JuliusJanusonis/MB/Patalpos/Spectrum_Montage1_940x347_adj.jpg

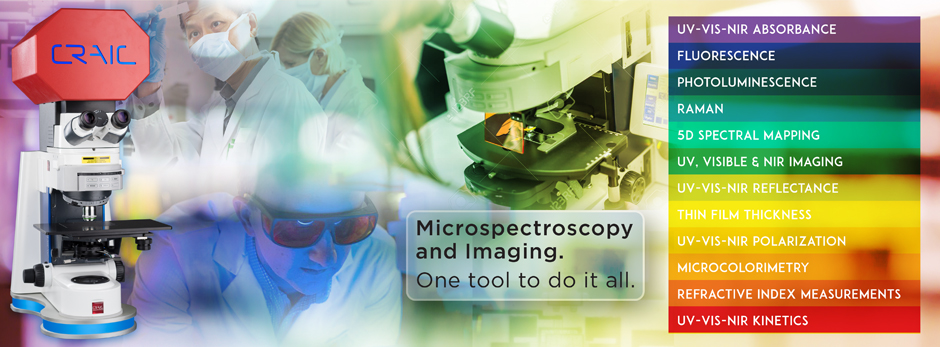
Patalpos/Spectrum_Montage1_940x347_adj.jpg
