JuliusJanusonis/MB/Inostartas/nuotraukos prezentacijai/20230321_184713.jpg

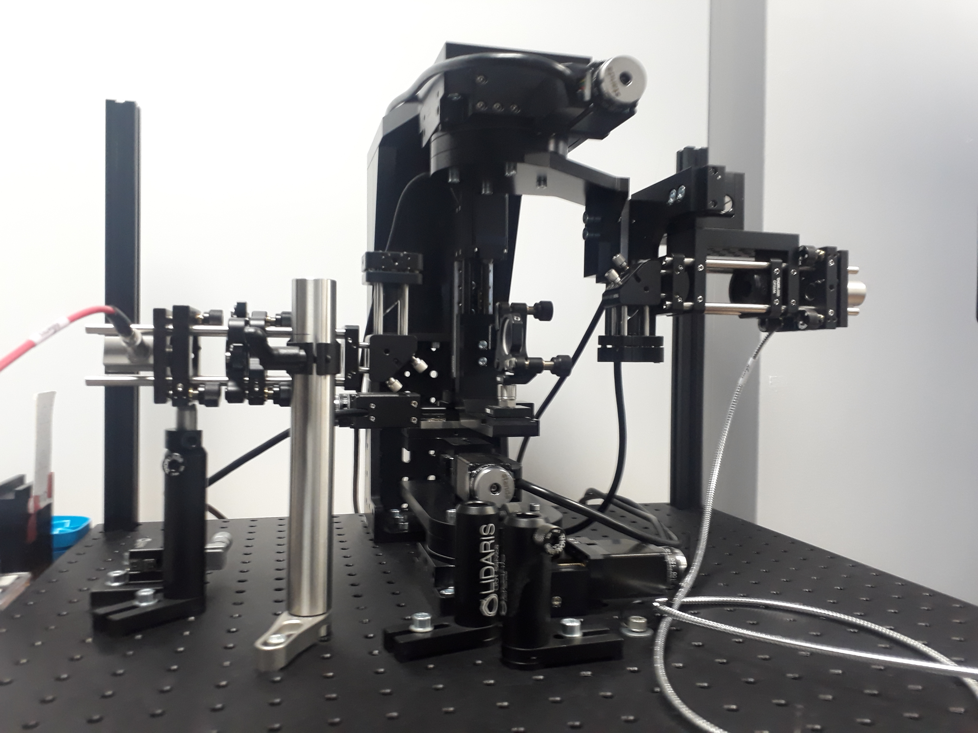
Inostartas/nuotraukos prezentacijai/20230321_184713.jpg
