JuliusJanusonis/MB/Inostartas/Biudzetas/Pagrindžiantys dokumentai/Standa Komercinis Pasiūlymas Nr. PST-20230330-02GM.pdf

UAB "Standa"
Kalvarijų g. 125-2, 08221 Vilnius, Lietuva Įm.kodas 120372824
PVM kodas LT203728219

KOMERCINIS PASIŪLYMAS

1406680
Nr. PST-20230330-02GM | 2023 03 30
Pagal Email inquiry 2023-03-29
Kontaktinis asmuo: GIEDRIUS MIKULIS kom14@standa.lt

psl. 1 / 1
UAB STANDA
Laiškams :
P.d. 2684
9-asis paštas
LT-03001 Vilnius

Kalvarijų g. 125-2
08221 Vilnius
Lithuania

Tel.: +370-5-2651474
Fax: +370-5-2651483

sales@standa.LT
http://www.standa.LT

Įmonės kodas: 120 372 82 4
PVM kodas: LT 203 728 219
Registras: Lietuvos Respublikos juridinių asmenų registras Bankas: AB SEB Bankas, Konstitucijos pr. 24, LT-08105 Vilnius Sąskaitos nr. ( IBAN ): LT46 7044 0600 0137 8028

Printed from DAGOS ERP

GAVĖJAS

EVEROPTICS MB
Vokiečių g. 85
Kaunas, LT-45261
Lietuva
PVM kodas:

PRISTATYMO ADRESAS

EVEROPTICS MB
Vokiečių g. 85
Kaunas, LT-45261
Lietuva
P. Julius Janušonis j.j.janusonis@gmail.com +37063817746
PREKIŲ / PASLAUGŲ PAVADINIMAS , KATALOGINIS KODAS | Kiekis | Vieneto kaina
| | be PVM, EUR

Nuol.
%
| | | Suma, EUR
1 . Motorizuotas transliatorius 8MT30-50 | 3vnt. | 699,00 | 2097,00
2 . Motorizuotas transliatorius 8MT173-30 | 2vnt. | 549,00 | 1098,00
3 . Motorizuotas posūkio staliukas 8MR190-2-28 | 2vnt. | 1.647,00 | 3294,00
4 . KAMPAS 2AB173-20-50 | 1vnt. | 54,00 | 54,00

5 . Aštuonių ašių kontrolerio blokas 8SMC5-M-ETH/RS232-B19x3-8
8 motorizuotų ašių valdymui | 1vnt. | 6.764,00 | 6764,00
6 . Pristatymo kaina DAP (30) Transp. DAP (30) UPS Economy | 1vnt. | 40,00 | 40,00

SUMA BE PVM
PVM, 21,00%
SUMA SU PVM
| | | 13.347,00 EUR
| | | 2.802,87 EUR
| | | 16.149,87 EUR
Mokėjimo sąlygos: | 100% in advance by Bank Transfer. Bank charges outside Lithuania at customer`s account.
Paruošimo laikas: | 5-7 sav.
Pasiūlymo galiojimas: | 30 days
Kilmės šalis: | LIETUVA
Pasiūlymą parengė: Vadybininkas GIEDRIUS MIKULIS , kom14@standa.lt
