JuliusJanusonis/MB/Inostartas/Biudzetas/Biudzetas_everoptics.xlsx

Kategorija | Nuoroda | Abibūdinimas | Kiekis | Vieneto kaina | Kaina | Kaina be PVM | Kaina su PVM |  |  | Mokslas | EP
Standa |  |  |  |  |  |  |  |  | Turinys | 0.8 | 0.2
Motorizuotas transliatorius 8MT30-50 |  |  | 3 | 699 | 2097 | 1733.057851 | 2097 |  | Intensyvumas | 0.8 | 0.6
Motorizuotas transliatorius 8MT173-30 |  |  | 2 | 549 | 1098 | 907.4380165 | 1098
Motorizuotas posūkio staliukas 8MR190-2-28 |  |  | 2 | 1647 | 3294 | 2722.31405 | 3294 |  | Efektinis intensyvumas | 0.76
KAMPAS 2AB173-20-50 |  |  | 1 | 54 | 54 | 44.62809917 | 54
Pristatymo kaina DAP (30) Transp. DAP (30) |  |  | 1 | 40 | 40 | 33.05785124 | 40
 |  |  |  |  | 0 | 0 | 0
DDS050/M | https://www.thorlabs.com/newgrouppage9.cfm?objectgroup_id=8535 | 50 mm Linear Translation Stage, DC Direct-Drive Servo Motor | 1 | 2082.63 | 2082.63 | 2082.63 | 2519.9823 | Viso be PVM | Viso
KBD101 | https://www.thorlabs.com/newgrouppage9.cfm?objectgroup_id=8535 | K-Cube™ Brushless DC Servo Driver | 1 | 804.71 | 804.71 | 804.71 | 973.6991 | 8327.835868 | 10076.6814
Aštuonių ašių kontrolerio blokas 8SMC5-M-ETH/RS232-B19x3-8 |  |  | 1 | 6764 | 6764 | 5590.082645 | 6764 | 5590.082645 | 6764
Avantes |  |  |  |  | 0 | 0 | 0
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
