JuliusJanusonis/MB/Inostartas/Biudzetas/Pirmas biudzetas_everoptics.xlsx

Sheet: Projekto dokumentai
Projekto dokumentai | Failas
2.4.1
2.4.2
2.4.3
2.4.4. PFSA 4 priedą, kuriame pateikiama informacija, reikalinga projekto atitikčiai projektų atrankos kriterijams įvertinti | 2.4.4. PFSA 4 priedas
2.4.5. MTEP verslo planą, parengtą pagal Kvietime teikti PĮP pateiktus rekomenduojamus formos ir turinio reikalavimus.
2.4.6
2.4.7. Dokumentus, pagrindžiančius projekto biudžeto pagrįstumą (komerciniai pasiūlymai, nuorodos į rinkos esančias kainas ir kita (jei projekte numatytos patentavimo ir/ar projekto metu sukurto produkto parengimo rinkai veiklos, išlaidų pagrindimui turi būti pateikiama po tris lygiaverčius komercinius pasiūlymus)).
2.4.8
2.4.9
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
