JuliusJanusonis/MB/Buhalterija/Saskaitos fakturos/mb_everoptics.pvm_saskaita_faktura.pardp000001.docx

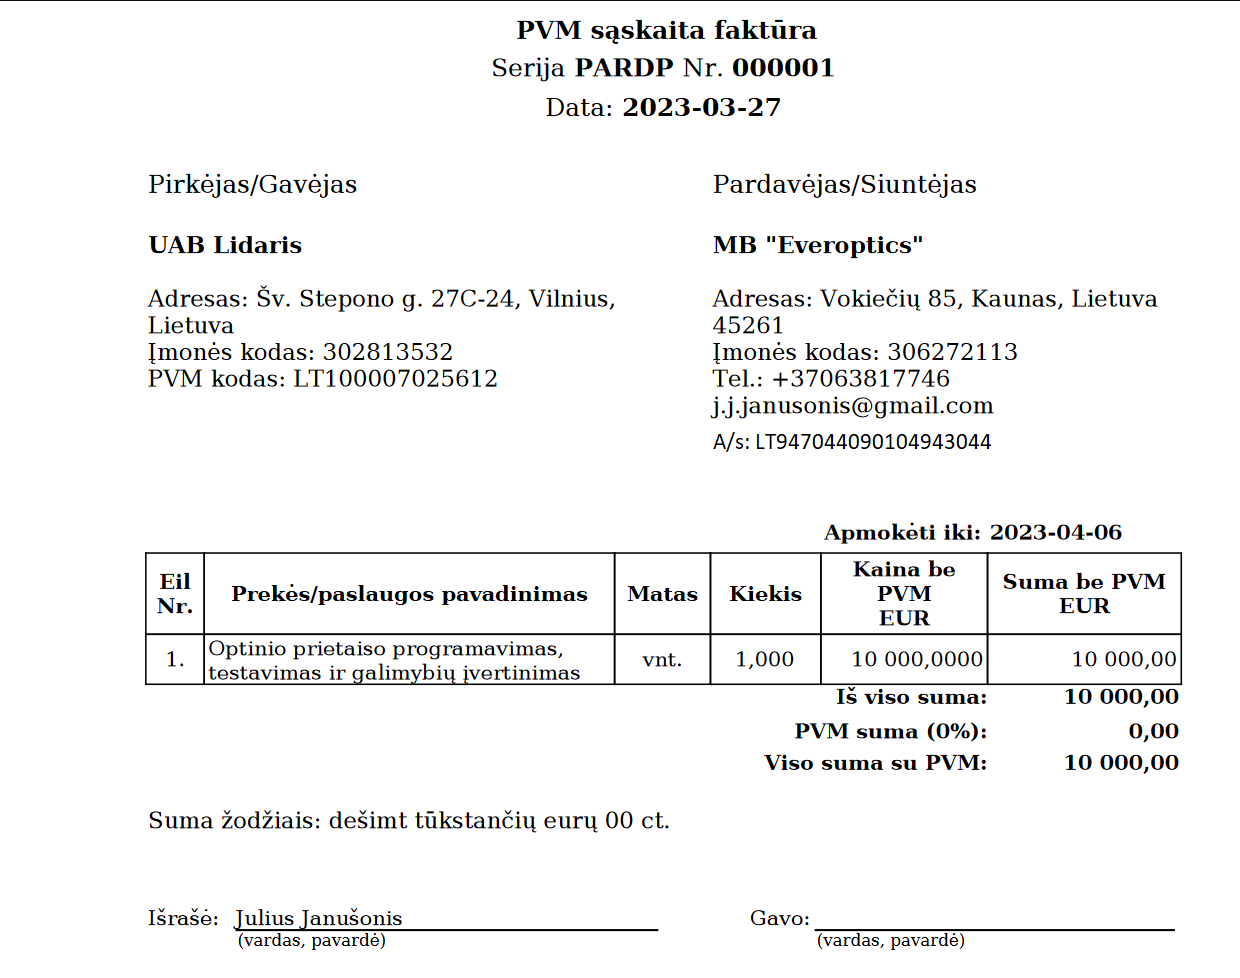
[picture p3: figure]
