JuliusJanusonis/MB/Inostartas/Dokumentai projekto padavimui/Atnaujinti seni failai/projekto igyvendinimo planas_everoptics.docx

Projektų administravimo ir finansavimo taisyklių

1 priedas

(Projekto įgyvendinimo plano forma)

arba

arba

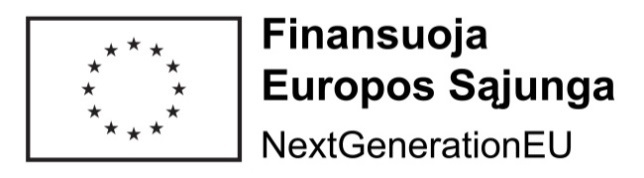
[picture p4: figure]
LT_00_Fichier de reproduction Next Generation EU_BLACK Outline

(Monochrominė Europos Sąjungos emblema ir šalia jos pasirinktas teiginys: „Finansuoja Europos Sąjunga“ (kai pavienis ar jungtinis projektas (toliau – projektas) 100 procentų finansuojamas 2021–2027 metų Europos Sąjungos fondų lėšomis) arba „Bendrai finansuoja Europos Sąjunga“ (kai projektas ne 100 procentų finansuojamas 2021–2027 metų Europos Sąjungos fondų lėšomis), arba „Finansuoja Europos Sąjunga NextGenerationEU“ (kai projektas finansuojamas 2021–2027 metų Europos Sąjungos fondų ir Ekonomikos gaivinimo ir atsparumo didinimo priemonės lėšomis arba Ekonomikos gaivinimo ir atsparumo didinimo priemonės lėšomis)

__________________________________MB “Everoptics”___________________________________

(pareiškėjo pavadinimas)

PROJEKTO ĮGYVENDINIMO PLANAS

Pildymo data | 2023-03-28
Patikslinimo data | Nurodoma patikslinimo data (DMS užpildoma automatiškai)

Forma pildoma ir teikiama kvietime teikti projektų įgyvendinimo planus (toliau – PĮP) nustatyta PĮP rengimo ir teikimo tvarka.

Kai DMS formos pildymo instrukcijoje nurodytas galimas simbolių skaičius arba nurodyta, kad galima įvesti tik skaičių, įvedus daugiau simbolių, nei numatyta, arba įvedus raides, rodomas klaidos pranešimas ir neleidžiama išsaugoti reikšmės.

Elektroninėje PĮP formoje, kurią pildo pareiškėjas, pildomų laukų išdėstymo tvarka nebūtinai atitinka šioje PĮP formoje nurodytą laukų išdėstymo tvarką.

I SKYRIUS

BENDRIEJI DUOMENYS

1.1. | Kvietimo teikti projektų įgyvendinimo planus (toliau – PĮP) numeris | 02-014-K
1.2. | Pavienio ar jungtinio projekto (toliau – projektas) pavadinimas | Nauji metodai matuoti optines dangas vystant prietaisą „Spectral Mapper“
1.3. | Projekto kodas | Sugeneruojamas ir nurodomas automatiškai, pateikus PĮP per DMS. Nepildoma, jei PĮP teikiamas ne per DMS.
1.4. | Pareiškėjas
1.4.1. | Pavadinimas | MB „Everoptics“
1.4.2. | Juridinio asmens kodas | 306272113 Pareiškėjas yra užsienyje registruotas juridinis asmuo Pažymima, jeigu pareiškėjas yra užsienyje registruotas juridinis asmuo. Nurodžius šį požymį, privaloma pateikti pareiškėjo ir partnerio deklaracijas.
1.4.3. | Adresas | Studentų g. 65-507, Kaunas
1.4.4. | Telefono numeris | +37063817746
1.4.5. | El. paštas | j.j.janusonis@gmail.com
1.5. | Kontaktinis asmuo | Julius Janušonis
1.5.1. | Asmens pareigų pavadinimas, vardas, pavardė | MB „Everoptics“ direktorius, Julius Janušonis
1.5.2. | Telefono numeris | +37063817746
1.5.3. | El. paštas | j.j.janusonis@gmail.com
1.6. | Partneris (-iai) | Juridinis (-iai) asmuo (-enys), kuri (-ie) kartu su pareiškėju inicijuoja ir įgyvendins projektą, siekdamas (-i) bendrų rezultatų.
| Pavadinimas | Juridinio asmens kodas | | Adresas | Telefono numeris | El. paštas
1.6.1. | UAB „Baltec CNC Technologies“ | 110856022 | | Raudondvario pl. 148, Kaunas | +37037314630 | info@baltec-cnc.com

II SKYRIUS

PROJEKTO INICIJAVIMAS

(pildoma rengiant visų tipų projektų įgyvendinimo aprašus)

2.1. | Projektu sprendžiamos problemos

Projektas prisidės prie naujo aukštos pridėtinės vertės produkto kūrimo, bus sudaromos sąlygos tyrėjams dalyvauti įmonės mokslinių tyrimų ir eksperimentinės plėtros veiklose, skatinama intelektinė nuosavybė ir ankstyvoji sukurto naujo produkto bandomoji gamyba. Projektu sprendžiamos mokslinės ir technologinės problemos optikos pramonėje ir taikomuosiuose tyrimuose.

Projekto tikslas – vykdant MTEP veiklas sukurti inovatyvų prietaiso prototipą optinių dangų charakterizavimui ir remiantis jo funkcionalumu išvystyti naujus matavimo metodus, palengvinančius defektų ir netolygumų optinėse dangose aptikimą bei padidinančius matavimų vienodumą ir taip padidinančius įgalinančius klietus pagerinti savo optinių komponentų charakterizavimą. Šiuo metu prietaisas yra 5 TPL lygio maketas; laukiama, kad suplanuotų eksperimentinės plėtros ir taikomųjų mokslinių veiklų metu bus paruoštas ir pademonstruotas prietaiso prototipas, t.y., pasiektas 7 TPL lygis

Taip bus sukurta intelektinė nuosavybė, kuri, numanoma, leis esmingai pagerinti optinių dangų charakterizavimą visoje optinių prietaisų vertės grandinėje. Tas turėtų vesti prie pagerėjusios prietaisų kokybės, didesnio ilgaamžiškumo ir tokiu būdu mažesnio poveikio aplinkai. Pagerėjęs technologinis lygis prisidės prie industrijos mokymosi ir padidins jos konkurencingumą.
2.2. | Projekto tikslas

Projekto tikslas – vykdant MTEP veiklas sukurti inovatyvų prietaiso prototipą optinių dangų charakterizavimui ir remiantis jo funkcionalumu išvystyti naujus matavimo metodus, palengvinančius defektų ir netolygumų optinėse dangose aptikimą bei matavimų vienodumą ir taip padidinančius sukurto prietaiso konkurencinį pranašumą.
2.3. | Projekto tikslinė grupė

Pirma projekto tikslinė grupė – optinių prietaisų vertės grandinėje dalyvaujančios įmonės, kurioms reikalinga optinių paviršių ir optinių dangų kontrolė. Galimybė geriau charakterizuoti optines dangas teigiamai veikia visą pramonės šaką per galimybę optimizuoti dangų procesus ir lokalizuoti problemas tiekimo grandinėje.

Detalizuojant ir naudojant Lietuvos lazerių įmones kaip pavyzdžius, tai yra optinius paviršius šlifuojančios ir poliruojančios įmonės, kaip UAB „Eksma Optics“, optines dangas dengiančios įmonės (pvz., UAB „Optomenas“), optinių komponentų pardavėjai (pvz., „Altechna“), ir integruotų sistemų bei lazerių gamintojai.

Ne lazerinės optikos gamintojai, pardavėjai ir integratoriai, puslaidininkinių prietaisų gamybos metrologijos įmonės taip pat turės naudos sekti savo dangų senėjimą agresyviose aplinkose, esant būdingai aukštai apšvitai ultravioletine spinduliuote.

Kita tikslinė grupė – mokslinės laboratorijos, atliekančios optinių dangų ir liuminescencinių defektų tyrimus.
2.4. | Galimi teisiniai apribojimai

Teisiniai ribojimai netaikomi
2.5. | Rezultatai (produkto stebėsenos rodiklis (-iai) ir (arba) rezultato stebėsenos rodiklis (-iai))

Nurodomi kokybinėmis ir kiekybinėmis reikšmėmis išreikšti minimalūs projektu siekiami rezultatai.

Stebėsenos rodiklio pavadinimas | Stebėsenos rodiklio kodas | Matavimo vienetas | Siektina reikšmė | Siektinos reikšmės pagrindimas

2.5.1. Produkto stebėsenos rodikliai
Paramą gavusios įmonės (iš kurių: labai mažos, mažosios, vidutinės ir didelės) | P-05-001-01-05- 07-08 (P.B.2.0001) | Įmonės | 2 | Rodiklio reikšmė pasiekiama pasirašius projekto sutartį
Paramą gavusios įmonės (iš kurių: labai mažos) | P-05-001-01-05- 07-09 (P.B.2.0001.1) | Įmonės | 1 | Rodiklio reikšmė pasiekiama pasirašius projekto sutartį
Paramą dotacijomis gavusios įmonės | P-05-001-01-05- 07-13 (P.B.2.0002) | Įmonės | 2 | Rodiklio reikšmė pasiekiama pasirašius projekto sutartį
| 2.5.2. Rezultato stebėsenos rodikliai
Privačiosios investicijos, papildančios viešąją paramą (iš kurių: dotacijos, finansinės priemonės | R-05-001-01-05- 07-03 (R.B.2.2002) | Eurai | 23833,10 | Privačias investicijas sudaro pareiškėjo ir partnerio nuosavas indėlis į projektą. Pagrindžiantys dokumentai bus teikiami su mokėjimo prašymais
Privačiosios investicijos, papildančios viešąją paramą (iš kurių: dotacijos) | R-05-001-01-05- 07-21 (R.B.2.2002.1) | Eurai | 23833,10 | Privačias investicijas sudaro pareiškėjo ir partnerio nuosavas indėlis į projektą. Pagrindžiantys dokumentai bus teikiami su mokėjimo prašymais.
Paramą gavusiuose subjektuose sukurtos mokslo tiriamojo darbo vietos | R-05-001-01-05- 07-05 (R.B.2.2102) | Vienų metų etato ekvivalentai | 1.5 | Projekto įgyvendinimo metu bus sukurta 1.5 darbo vietos.
Investicijas gavusios įmonės pajamų, gautų iš tiesiogiai projekto metu sukurtų ir rinkai pateiktų produktų, santykis su skirtomis investicijomis | R-05-001-01-05- 07-25 (R.N.2 5640) | Procentai | 6 | X=P/I*100 proc P – 500 000,00 Eur = projekto įgyvendinimo metu ir 3 metus po projekto veiklų įgyvendinimo pabaigos įmonės gautos pajamos iš tiesiogiai projekto metu sukurtų ir rinkai pateiktų produktų (apskaičiavimas pateiktas Verslo plano priede „Finansinis planas“), I – 83859,68 Eur = tinkamos finansuoti projekto išlaidos, X – 6 proc. = santykis tarp pajamų, gautų iš projekto įgyvendinimo metu ir 3 metus po projekto veiklų įgyvendinimo pabaigos tiesiogiai projekto metu sukurtų ir rinkai pateiktų produktų ir išlaidų, skirtų projektui finansuoti.

III SKYRIUS

PROJEKTO ĮGYVENDINIMO DETALIZACIJA

(pildoma rengiant visų tipų projektų įgyvendinimo planus)

3.1. Projekto veiklos (trukmė ir etapai)
Projekto įgyvendinimo laikotarpis | | | | | | | | | | | 12
Nr. | Projekto veikla | | | | | | | Pažangos priemonės veiklos (poveiklės) numeris | | | Tinkamų finansuoti išlaidų suma, eurais | | | | | | | | | | | Pradėta iki projekto sutarties pasirašymo | Projekto sutarties mėnuo, kai pradedama vykdyti veikla | Projekto sutarties mėnuo, kai baigiama vykdyti veikla | Regionas / Teisingos pertvarkos fondas (toliau – TPF)
| | | | | | | | | | | Bendra suma, eurais | | | | | | Iš jos PVM, eurais
1. | Investuoti į naujų APV produktų kūrimo veiklas ir sudaryti sąlygas tyrėjams dalyvauti įmonių MTEP veiklose, skatinti intelektinę nuosavybę, ankstyvąją sukurtų naujų produktų bandomąją gamybą, parengimą rinkai. | | | | | | | 05-001-01-05-07-06-02 | | | 83859,68. | | | | | | - | | | | | Ne | 1 | 12 | Vidurio ir vakarų Lietuva
| Nr. | Poveiklės pavadinimas | | | | | | Mata-vimo viene- tas | Siektina reikšmė | | | Tinkamų finansuoti išlaidų suma, eurais | | | | | | | | | | Finansuojamoji dalis, proc. | Poveiklės aprašymas | Poreikio pagrindimas
| | | | | | | | | | | | Bendra suma, eurais | PVM finan-savimo požymis | | PVM suma, eurais | | | | Lietuvos Respubli-kos PVM įstatymo straipsnis
| 1.1 | Mokslinių tyrimų poveiklės ataskaita: Integruotų kampinių ir skirtingų matavimo režimo duomenų panaudojimo tyrimas (projekto vykdytojas) | | | | | | vnt. | 1 | | | 27263,24 | ☑ Neprašoma finansuoti PVM | | - | | | | - | | | 80 | Atlikti moksliniai tyrimai, numatyti verslo plane, siekiant sukurti inovatyvų produktą. | Detalus išlaidų aprašymas ir apskaičiavimas pateiktas Verslo plano priede 1A. Išlaidas pagrindžiantys dokumentai pateikiami kartu PĮP.
| | Nr. | | | | Veiksmo / išlaidų tipo pavadinimas | | Ma-tavimo viene-tas | Siektina reikšmė | | | Vieneto kaina, eurais | | | | Tinkamų finansuoti išlaidų suma, eurais | | | | | | | Poreikio ir išlaidų pagrindimas | Požymiai
| | | | | | | | | | | | | | | | Planuojama išlaidų suma, eurais | | | | | Iš jos PVM, eurais
| Nr. | Poveiklės pavadinimas | | | | | | Mata-vimo vienetas | | Siektina reikšmė | | Tinkamų finansuoti išlaidų suma, eurais | | | | | | | | | Finansuoja-moji dalis, proc. | | Poveiklės aprašymas | Poreikio pagrindimas
| | | | | | | | | | | | Bendra suma, eurais | | PVM finan-savimo požymis | | PVM suma, eurais | | | | PVM įstaty-mo straips-nis
| 1.2 | Eksperimentinės plėtros poveiklės ataskaita (projekto partneris) | | | | | | vnt. | | 0,80 | | 20703,60 | | ☑ Neprašoma finansuoti PVM | | - | | | | - | 50 | | Atliktos eksperimentinės plėtros veiklos, numatytos verslo plane, ir sukurtas inovatyvaus produkto prototipas | Detalus išlaidų aprašymas ir apskaičiavimas pateiktas Verslo plano priede 1A. Išlaidas pagrindžiantys dokumentai pateikiami kartu PĮP.
| | Nr. | | Veiksmo / išlaidų tipo pavadinimas | | | | Matavi-mo vienetas | | Siektina reikšmė | | Vieneto kaina, eurais | | | | Tinkamų finansuoti išlaidų suma, eurais | | | | | | | Poreikio ir išlaidų pagrindimas | Požymiai
| | | | | | | | | | | | | | | | Planuojama išlaidų suma, eurais | | | | | Iš jos PVM, eurais
| Nr. | Poveiklės pavadinimas | | | | | | Mata-vimo vienetas | | Siektina reikšmė | | Tinkamų finansuoti išlaidų suma, eurais | | | | | | | | | Finansuoja-moji dalis, proc. | | Poveiklės aprašymas | Poreikio pagrindimas
| | | | | | | | | | | | Bendra suma, eurais | | PVM finan-savimo požymis | | PVM suma, eurais | | PVM įstaty-mo straips-nis
| 1.3 | Mokslinių tyrimų poveiklės ataskaita: Naujų padidintos skyros ir siauro spektro matavimo metodikų tyrimas (projekto vykdytojas) | | | | | | vnt. | | 1 | | 31642,44 | | ☑ Neprašoma finansuoti PVM | | - | | - | | | 80 | | Atlikti moksliniai tyrimai, numatyti verslo plane, siekiant sukurti inovatyvų produktą. | Detalus išlaidų aprašymas ir apskaičiavimas pateiktas Verslo plano priede 1A. Išlaidas pagrindžiantys dokumentai pateikiami kartu PĮP.
| | Nr. | | Veiksmo / išlaidų tipo pavadinimas | | | | Matavi-mo vienetas | | Siektina reikšmė | | Vieneto kaina, eurais | | | | Tinkamų finansuoti išlaidų suma, eurais | | | | | | | Poreikio ir išlaidų pagrindimas | Poreikio pagrindimas
| | | | | | | | | | | | | | | | Planuojama išlaidų suma, eurais | | | | | Iš jos PVM, eurais
| Nr. | Poveiklės pavadinimas | | | | | | Mata-vimo vienetas | | Siektina reikšmė | | Tinkamų finansuoti išlaidų suma, eurais | | | | | | | | | Finansuoja-moji dalis, proc. | | Poveiklės aprašymas | Poreikio pagrindimas
| | | | | | | | | | | | Bendra suma, eurais | | PVM finan-savimo požymis | | PVM suma, eurais | | PVM įstaty-mo straips-nis
| 1.4 | Eksperimentinės plėtros poveiklės ataskaita (projekto vykdytojas) | | | | | | vnt. | | 0,20 | | 4250,40 | | ☑ Neprašoma finansuoti PVM | | - | | - | | | 60 | | Atliktos eksperimentinės plėtros veiklos, numatytos verslo plane, ir sukurtas inovatyvaus produkto prototipas. | Detalus išlaidų aprašymas ir apskaičiavimas pateiktas Verslo plano priede 1A. Išlaidas pagrindžiantys dokumentai pateikiami kartu PĮP.
| | Nr. | | | Veiksmo / išlaidų tipo pavadinimas | | | Matavi-mo vienetas | | Siektina reikšmė | | Vieneto kaina, eurais | | | | Tinkamų finansuoti išlaidų suma, eurais | | | | | | | Poreikio ir išlaidų pagrindimas | Poreikio pagrindimas
| | | | | | | | | | | | | | | | Planuojama išlaidų suma, eurais | | | | | Iš jos PVM, eurais
Projekto matomumo ir informavimo apie projektą priemonės | | | | | | | | | | | | Tinkamų finansuoti išlaidų suma, eurais | | | | Iš jos PVM, eurais | | | | | Aprašymas | | | Regionas / TPF
Pažangos priemonės veiklos (poveiklės) numeris | | | | | | | - | | | | | - | | | | - | | | | | - | | | -
Fiksuotoji norma, skirta netiesioginėms ir kitoms išlaidoms padengti | | | | | | | Taikoma fiksuotoji norma, proc. | | | | | Tinkamų finansuoti išlaidų suma, eurais
| | | | | | | | | | | | Bendra suma, eurais | | | | Iš jos PVM, eurais
Pažangos priemonės veiklos (poveiklės) numeris | | | - | | | | - | | | | | - | | | | -.
Bendra projekto tinkamų finansuoti išlaidų suma, eurais: | | | | | | | | | | | | 83859,68 | | | | -

3.1.1. Projekto požymiai, priskyrimas regionams (užpildoma automatiškai, kai PĮP teikiamas per DMS)
Požymis | Pažangos priemonės veiklos (poveiklės) numeris | Tinkamų finansuoti išlaidų suma, eurais
Regionai / TPF | Pažangos priemonės veiklos (poveiklės) numeris | Tinkamų finansuoti išlaidų suma, eurais
Vidurio ir vakarų Lietuva | 05-001-01-05-07-06-02 | 83859,68
☐ Investicijos priskiriamos regionui taikant „pro rata“ principą Pažymima, kai projektas finansuojamas ERPF arba ESF+ lėšomis, investicijų sukuriama nauda atitenka daugiau nei vienam 2021–2027 metų Europos Sąjungos fondų investicijų programos (toliau – Investicijų programa) regionui ir projekto įgyvendinimo metu nebus galima nustatyti, kiek kuriam Investicijų programos regionui faktiškai teks naudos iš investicijų. Remiantis „pro rata“ dydžiu skaičiuojamos projekto veikloms vykdyti skiriamos lėšos ir siektini rodikliai. | Nurodomos projekto veiklos, kurioms taikomas „pro rata“ dydis, ir joms tenkanti procentinė dalis.

3.2. | Finansavimo šaltiniai

1. Pažangos priemonės veiklos (poveiklės) numeris | 2. Prašomos skirti lėšos | | 3. Nuosavas įnašas | | | | | | 4. Iš viso lėšų
| | | 3.1. Nacionalinės viešosios lėšos | | | 3.2. Privačios lėšos | | Proc.
| Prašomas finansavimas | Proc. | 3.1.1. Valstybės biudžeto lėšos | 3.1.2. Savivaldybės biudžeto lėšos | 3.1.3 Kiti viešųjų lėšų šaltiniai | 3.2.1. Pareiškėjo, partnerio (-ių) ir (ar) jungtinio projekto projekto pareiškėjo (-ų) lėšos | 3.2.2. Kiti lėšų šaltiniai
Iš viso | 60026,58 | 71,58 | 0 | 0 | 0 | 23833,1 | 0 | 28,42 | 83859,68
05-001-01-05-07-06-02 | 60026,58 | 71,58 | 0 | 0 | 0 | 23833,1 | 0 | 28,42 | 83859,68
3.3. | Teritorija, kuriai tenka didžioji dalis projekto lėšų (didžiausia projekto lėšų dalis skaičiuojama pagal skiriamų lėšų dydį).

Regionas | Apskritis | Savivaldybė
- Vidurio ir vakarų Lietuva | Kauno apskritis | Kauno miesto savivaldybė
3.4. | Kita (-os) apskritis (-ys) ir savivaldybė (-ės), kuriai (-ioms) tenka dalis projekto lėšų (šis papunktis nežymimas, jei projektas įgyvendinamas vienoje savivaldybėje)

Apskritis (-ys) | -
Savivaldybė (-ės): | -
3.5. | Projekto komanda

Pareigos įgyvendinant projektą | Vardas, pavardė | Struktūrinio padalinio pavadinimas, pareigų pavadinimas | Funkcijos ir atsakomybės

Projekto komanda:
Projekto administravimo vadovas pareiškėjo įmonėje | Dr. Julius Janušonis | MB „Everoptics“ | Pareiškėjo įmonėje: - Projekto veiklų įgyvendinimo koordinavimas; - Pirkimų dokumentacijos rengimą ir pirkimų organizavimas; - Mokėjimo prašymų rengimas; - Projekto sutarties keitimo dokumentų rengimas; - Projekto viešinimas; - Svarbios informacijos pateikimas ir suderinimas su projekto pareiškėjo finansininku.
Projekto finansininkas | Numatomas nusamdyti iki projekto pradžios įmonės MB „Everoptics“ | | - Buhalterinės projekto apskaitos vykdymas; - Projekto vykdymo eigoje iškylančių finansinių problemų sprendimas; - Mokėjimo prašymų ir ataskaitų rengimui reikalingos finansinės informacijos teikimas; - Mokėjimų vykdymas.
MTEP projekto vadovė | Gintarė Batavičiūtė | MB „Everoptics“ | - Projekto MTEP veiklų įgyvendinimo planavimas ir priežiūra (pareiškėjo įmonėje); - Mokslinių tyrimų/eksperimentų planavimas; - Susitikimai ir užduočių paskirstymas komandoje; - Techninės konsultacijos ir sudėtingų techninių užduočių sprendimai; - Ataskaitų pateikimas partneriams.
Vyr. tyrėjas | Dr. Julius Janušonis | MB „Everoptics“ | - Matavimų modeliavimas; - Optinių schemų surinkimas ir vystymas; - Matavimo sistemos priežiūra, palaikymas ir iškilusių kliūčių šalinimas; - Eksperimentiniai plonasluoksnių dangų matavimai; - Rekomendacijų teikimas kuriant geriausias praktikas, naudojant projekto metu išvystyta spektrinio vaizdinio prietaisą („Spectral Mapper“).
Projekto administravimo vadovas partnerio įmonėje | Diana Vertelkienė | UAB UAB "Baltec CNC Technologies" | Partnerio įmonėje: - Projekto veiklų įgyvendinimo koordinavimas; - Pirkimų dokumentacijos rengimą ir pirkimų organizavimas; - Mokėjimo prašymų rengimas; - Projekto sutarties keitimo dokumentų rengimas; - Projekto viešinimas; - Svarbios informacijos pateikimas ir suderinimas su projekto pareiškėjo finansininku.
Technologas | Edvinas Dubinskas | UAB UAB "Baltec CNC Technologies" | - Specifinių detalių, skirtų kuriamo prototipo vystymui, gamyba CNC staklėmis, pirmos iteracijos metu; - Gamybos proceso priežiūra ir gamybos proceso atsikartojamumo užtikrinimas - Techninių brėžinių patikra prieš gamybos procesą; - Gamybos proceso metu stebimų neatitikimų (dėl fizinių ir techninių priežasčių) registravimas ir aptarimas.
Inžinierius-tyrėjas | Gytis Litvinskas | UAB UAB "Baltec CNC Technologies" | - Sudėtingų ir specifinių detalių skirtų kuriamo prototipo vystymui, gamyba CNC staklėmis antro ir trečio iteracijos metu; - Gamybinių parametrų testavimas ir optimaliausio prietaiso veikimo režimo parinkimas visų trijų gamybinių iteracijų metu. - Gamybos sistemos priežiūra, palaikymas ir iškilusių kliūčių šalinimas; - Konsultacijų teikimas ruošiant techninių brėžinius; - Rekomendacijų teikimas, parenkant gamybinius procesus, medžiagas ir apdirbimą.
Technologijų skyriaus vadovas | Andrius Berškys | UAB UAB "Baltec CNC Technologies" | - Siūlo techninius sprendimus, vystant itin stabilų mechaninį apšvietimo sistemos dizainą ir laikančiąją sistemą; - Konsultuoja ruošiant techninius brėžinius; - Konsultuoja ir apmoko technologus apie sudėtingų ir specifinių detalių gamybos sprendinių pritaikymą; - Konsultuoja inžinierių-tyrėją nustatant optimaliausią prietaiso veikimo režimą; - Konsultuoja MTI (mokslo, technologijų ir inovacijų) vadovą dėl galimybės išbandyti/pritaikyti inovatyvius technologinius sprendimus, pasitelkiant esamą įrangą.
Mokslo, technologijų ir inovacijų skyriaus vadovė | Diana Vertelkienė | UAB UAB "Baltec CNC Technologies" | - Projekto MTEP veiklų įgyvendinimo planavimas ir priežiūra (partnerio įmonėje) - Projekto metu reikalingų inovatyvių apdirbimo procesų paieška, analizė, vertinimas ir atranka; - Susitikimai ir užduočių paskirstymas komandoje; - Ataskaitų pateikimas partneriams.
3.6. | Partneris (-iai)

Projekte kaip partneriai dalyvauja UAB „Baltec CNC Technologies“, kodas 110856022.
MB “Everoptics” (įmonė pareiškėjas) pagrindinė veiklos sritis yra susijusi su moksliniais taikomaisiais tyrimais ir optinių prietaisų gamyba. Projekto partnerio „Baltec CNC technologies“ pagrindinė veikla yra susijusi su tikslių mechaninių detalių ir jų rinkinių projektavimu, metalo detalių precizinių apdirbimu, paviršiaus paruošimu.
Pareiškėjui bendradarbiavimas su įmone partnere leis iteraciniu būdu išvystyti mechaninę produkto sistemą, pasinaudojant savo žiniomis ir tyrimais ją pritaikyti produkto prototipui sukurti ir parnerio įgytomis žiniomis apie naujus gamybos procesus ir praktikas, geriausiai pritaikomas prototipui gaminti.
Partneriui bendradarbiavimas su pareiškėju leidžia pasinaudoti pareiškėjo žiniomis apie optines sistemas ir atlikus eksperimentinės plėtros veiklas, įgyti naujų žinių apie optomechanines gamybos technologijas ir metodus.

Tarp partneriu yra pasirašyta projekto dokumentų rinkinyje esanti Jungtinės veiklos sutartis, kuri reglamentuoja partnerių tarpusavio santykius, pareigas projekte, naudą ir informacijos išlaikymą. Pagal partnerystės sutartį, projekto rezultatai, sukurti vienos iš šalių tampa tos šalies intelektine nuosavybe. UAB „Baltec CNC technologies“ atveju tai apima teisę į visas mechaninių komponentų gamybos ir paviršiaus apdirbimo technologijos žinias, įgytas eksperimentinės plėtros veiklos metu. MB „Everoptics“ atveju – tai intelektinės teisės į sukurtą prototipą ir į sukurtas naujas matavimo technikas. Trumpalaikis turtas tampa perkančiosios įmonės nuosavybe.

Abu partneriai įsipareigoja tinkamai dokumentuoti ir išsaugoti projekto metu įgytus rezultatus. MB „Everoptics“, siekdama atkartojamumo, planuoja mokslinius rezultatus, apie sukurtas naujas matavimo metodikas padėti į viešą prieigą .
3.7. | Matomumas ir informavimas

(Pareiškėjas privalo pasirinkti įgyvendinti projekto matomumo ir informavimo apie projektą priemones, kaip nustatyta finansų ministro tvirtinamų Projektų administravimo ir finansavimo taisyklių VIII skyriaus pirmajame skirsnyje ir kvietime teikti PĮP).

Projekto matomumo ir informavimo apie projektą priemonė (-ės) | Taikoma | Aprašymas
3.7.1. Projekto aprašymas pagrindinėje interneto svetainėje (jei tokia yra). Terminas ‒ 20 darbo dienų nuo projekto sutarties pasirašymo dienos. | ☑ | Projekto paraiškos teikimo metu, projekto vykdytojas neturi interneto svetainės. Taiču projekto partneris – UAB „"Baltec CNC Technologies" – interneto svetainę turi. Todėl partnerio interneto svetainėje (http://www.baltec-cnc.com/lt) bus skelbiamas projekto aprašymas, apibūdinant projektu sprendžiamą problemą ir projekto tikslą, aprašant suplanuotas projekto veiklas (poveikles), pristatant suplanuotus rezultatus ir informuojant apie Europos Sąjungos finansavimą
3.7.2. Projekto viešinimas socialiniuose tinkluose. Terminas ‒ 20 darbo dienų nuo projekto sutarties pasirašymo dienos | ☑ | Projekto vykdytojo ir projekto partnerio socialiniuose tinkluose (Linkedin) bus paskelbta informacija apie projekto finansavimą Europos Sąjungos lėšomis, nurodant „Bendrai finansuoja Europos Sąjunga“
3.7.3. Projekto plakato (ne mažesnio kaip A3 formato) iškabinimas matomoje vietoje. Terminas ‒ 20 darbo dienų nuo projekto sutarties pasirašymo dienos (arba taikoma PĮP 3.7.4 papunktyje nurodyta projekto matomumo ir informavimo apie projektą priemonė). | ☑ | Prie įėjimo į projekto vykdytojo ir partnerio patalpas (Studentų g. 65-507, Kaunas ir Raudondvario pl. 148, LT-47175 Kaunas,) bus iškabinti neskaitmeniniai plakatai, kuriame bus pateikiamas trumpas projekto aprašymas ir tikslas.
3.7.4. Projekto pristatymas skaitmeniniame ekrane (ne mažesniame kaip A3 formato) matomoje vietoje. Terminas ‒ 20 darbo dienų nuo projekto sutarties pasirašymo dienos (arba taikoma PĮP 3.7.3 papunktyje nurodyta projekto matomumo ir informavimo apie projektą priemonė). | ☐
3.7.5. Nuolatinės informacinės lentelės pakabinimas matomoje vietoje. Terminas ‒ kai tik fizinių (materialių) investicijų projekto veikla pradedama vykdyti ar sumontuojama ir pakabinama nupirkta įranga (ir (arba) taikoma PĮP 3.7.6 papunktyje nurodyta projekto matomumo ir informavimo apie projektą priemonė). | ☐
3.7.6. Nuolatinio informacinio stendo pastatymas matomoje vietoje. Terminas ‒ kai tik fizinių (materialių) investicijų projekto veikla pradedama vykdyti ar sumontuojama nupirkta įranga (ir (arba) taikoma PĮP 3.7.5 papunktyje nurodyta projekto matomumo ir informavimo apie projektą priemonė). | ☐
3.7.7. Strateginės svarbos projekto komunikacinio renginio organizavimas ar kitos komunikacinės veiklos vykdymas (arba taikoma PĮP 3.7.8 papunktyje nurodyta projekto matomumo ir informavimo apie projektą priemonė). | ☐
3.7.8. Projekto, kurio bendra vertė viršija 10 000 000 eurų, komunikacinio renginio organizavimas ar kitos komunikacijos veiklos vykdymas (arba taikoma PĮP 3.7.7 papunktyje nurodyta projekto matomumo ir informavimo apie projektą priemonė). | ☐
3.7.9. Tinkamas, naudojant Europos Sąjungos emblemą ir nurodant atitinkamą teiginį, komunikavimas apie tai, kad finansuojama Europos Sąjungos lėšomis, visose komunikacijos priemonėse ir tikslinei auditorijai skirtuose dokumentuose. | ☐
3.7.10. Kitų komunikacinių, informacinių, Europos Sąjungos finansavimo matomumą ir skaidrumą didinančių veiklų vykdymas (papildoma priemonė). | ☐
3.8. | Horizontalieji principai (toliau – HP) ir Europos Sąjungos pagrindinių teisių chartijos (toliau – Chartija) nuostatos

3.8.1. ☑ Projekto įgyvendinimo metu nepažeidžiami HP

HP – darnaus vystymosi, įskaitant reikšmingos žalos nedarymo principą, lygių galimybių ir nediskriminavimo (dėl lyties, rasės, tautybės, pilietybės, kalbos, kilmės, socialinės padėties, tikėjimo, įsitikinimų ar pažiūrų, amžiaus, lytinės orientacijos, etninės priklausomybės, religijos, negalios ar kt.), įskaitant prieinamumo visiems reikalavimo užtikrinimą, principai.

Galimas simbolių skaičius – 1. Nurodyti privaloma.

3.8.2. ☑ Projekto įgyvendinimo metu nepažeidžiami PFSA arba, kai įgyvendinami RPPl projektai, – Gairėse ir RPPl nustatyti reikalavimai dėl atitinkamų Chartijos nuostatų laikymosi

Galimas simbolių skaičius – 1. Nurodyti privaloma.

3.8.3. Projektu tiesiogiai (projekto tikslas, tikslinė grupė, projekto veiklos, projekto vykdytojai, rodikliai, siekiami rezultatai) prisidedama prie HP įgyvendinimo:

☑ Darnus vystymasis, įskaitant reikšmingos žalos nedarymo principą

Veikla, vadovaujantis Europos Komisijos 2021 m. vasario 12 d. patvirtintomis Reikšmingos žalos nedarymo principo taikymo pagal Ekonomikos atsparumo ir didinimo priemonės reglamentą techninėmis gairėmis, atitinka reikšmingos žalos nedarymo principą, nes neturi neigiamo numatomo poveikio 6 aplinkos tikslams, nurodytiems 2020 m. birželio 18 d. Europos Parlamento ir Tarybos reglamento (ES) Nr. 2020/852 dėl sistemos tvariam investavimui palengvinti sukūrimo, kuriuo iš dalies keičiamas Reglamentas (ES) 2019/2088, 17 straipsnyje, arba numatomas jų poveikis yra nereikšmingas, t. y. nedaro tiesioginio ir pirminio netiesioginio poveikio per visą gyvavimo ciklą.
Lygios galimybės ir nediskriminavimas | Nurodoma, kaip įgyvendinant projektą bus tiesiogiai vykdomi PFSA, o kai įgyvendinami RPPl projektai, – Gairėse ir RPPl nurodyti reikalavimai dėl lygių galimybių ir nediskriminavimo (dėl lyties, rasės, tautybės, pilietybės, kalbos, kilmės, socialinės padėties, tikėjimo, įsitikinimų ar pažiūrų, amžiaus, lytinės orientacijos, etninės priklausomybės, religijos, negalios ar kt.), įskaitant prieinamumo visiems reikalavimo užtikrinimą, ir pagrindžiama, kaip tai bus įgyvendinama. Galimas simbolių skaičius – 3 000.
Inovatyvumas (kūrybingumas) | Jei pasirenkama, nurodoma, kaip įgyvendinant projektą bus vykdomi PFSA, o kai įgyvendinami RPPl projektai, – Gairėse ir RPPl nurodyti reikalavimai dėl įsipareigojimų inovatyvumui (kūrybingumui) skatinti. Galimas simbolių skaičius – 3 000.

IV SKYRIUS

PROJEKTO REZULTATŲ TĘSTINUMO PLANAS

(taikoma tik investicijų projektams, kai įgyvendinus projektą gaunamas ilgalaikis rezultatas)

Projekto rezultatų palaikymo finansinis pagrindimas

Kai rengiamas projekto investicijų projektas, šioje dalyje pareiškėjas turi nurodyti, kokiomis lėšomis ir kokia suma bus užtikrintas projekto rezultatų palaikymas.

Kai nėra rengiamas projekto investicijų projektas, šioje dalyje detalizuojama, kokio palaikymo biudžeto reikės po projekto įgyvendinimo – kokioms sąnaudoms ir kiek lėšų reikės kasmet (visą projekto investicijų tęstinumo laikotarpį).

Pateikiamas projekto tęstinumo aprašymas, atsižvelgiant į du požymius – fizinį ir veiklos rezultatų tęstinumą.

Fizinis tęstinumas: glaustai aprašoma, kaip bus užtikrintas projekto produktų tęstinumas (pvz., kas ir kaip apmokės pastatyto naujo pastato eksploatavimo išlaidas, kas bus atsakingas už sukurtos infrastruktūros tinkamą naudojimą), kaip bus užtikrinamas projekto rezultatų panaudojimas ir (arba) sklaida.

Veiklos rezultatų tęstinumas: glaustai aprašoma, koks projekto valdymo personalas užtikrins (nurodomos konkrečios priemonės) projekto veiklų tęstinumą po projekto finansavimo pabaigos pagal priemonės apraše nustatytus reikalavimus, jei tokie nustatyti (pvz., kokioms paslaugoms (pvz., onkologinėms, traumatologinėms) teikti bus naudojama įgyvendinant projektą įgyta medicininė įranga ir kt.).

Galimas simbolių skaičius – 4 000.

Nurodyti privaloma.

Laikotarpis, kurio projekto rezultatų palaikymas skaičiuojamas, metai | Vidutinė metinė lėšų suma, kurios reikia projekto rezultatams palaikyti, eurais | Bendra lėšų suma, kurios reikia projekto rezultatams palaikyti, eurais
| | Valstybės biudžeto lėšos | Kiti finansavimo šaltiniai | Pareiškėjo lėšos | Iš viso
Nurodomas laikotarpis, kurio projekto rezultatų palaikymas skaičiuojamas. | Nurodoma vidutinė metinė lėšų suma, kurios reikia projekto rezultatams palaikyti. | Nurodoma valstybės biudžeto lėšų suma. | Nurodomi finansavimo šaltinis ir suma. | Nurodoma pareiškėjo lėšų suma.

V SKYRIUS

PROJEKTO ĮGYVENDINIMO PLANO PRIEDAI

(taikoma visiems projektams)

(Pareiškėjas prideda kvietime teikti PĮP nurodytus ir papildomus (pagal poreikį) PĮP priedus. Lentelės pabaigoje įrašomi kiti priedai, jei kvietime teikti PĮP nurodyta juos pateikti. Visos PĮP ir jo priedų formos skelbiamos Europos Sąjungos investicijų interneto svetainėje esinvesticijos.lt (toliau – svetainė esinvesticijos.lt). DMS elektroninėje formoje rodomi tie PĮP priedai, kurie pažymėti kaip teikiami kvietimo teikti PĮP formoje. PĮP priedus turi pateikti tiek pareiškėjas, tiek projekto partneris (-iai), jeigu jie numatyti projekte. Prie PĮP pridedami tie priedai, ties kuriais lentelėje pažymėta „X“.)

Projekto įgyvendinimo plano priedo pavadinimas | | Žymima, jeigu teikiama
1. | Partnerio deklaracija pagal PĮP 1 priede pateiktą formą (teikiama, jei projektas įgyvendinamas su partneriu (-iais)). | X
2. | Informacija apie projekto biudžeto paskirstymą pagal pareiškėjus ir partnerius pagal PĮP 2 priede pateiktą formą (teikiama, jeigu projektas įgyvendinamas su partneriu (-iais). | X

3.

Projekto investicijų projektas su investicijų skaičiuokle (teikiamas, jeigu įgyvendinant projektą planuojama investicijų į ilgalaikio materialiojo ir nematerialiojo turto, reikalingo viešosioms paslaugoms, kaip jos apibrėžtos Lietuvos Respublikos viešojo administravimo įstatyme, teikti ir (arba) viešojo administravimo funkcijoms vykdyti, sukūrimą, įsigijimą arba jo vertės padidinimą suma, išskyrus (atėmus) jai tenkantį pirkimo ir (arba) importo pridėtinės vertės mokestį, viršija vieną milijoną eurų). Projekto investicijų projektas rengiamas vadovaujantis Investicijų projektų rengimo metodika, patvirtinta viešosios įstaigos Centrinės projektų valdymo agentūros direktoriaus (dokumentas skelbiamas svetainėse cpva.lt ir esinvesticijos.lt).

4.

Informacija apie projektui taikomus aplinkosaugos reikalavimus pagal PĮP 3 priede pateiktą formą (teikiama, jei įgyvendinant projektą planuojama ūkinė veikla, kaip ji apibrėžta Lietuvos Respublikos planuojamos ūkinės veiklos poveikio aplinkai vertinimo įstatymo 2 straipsnio 4 dalyje, gali turėti poveikį aplinkai ir ji patenka į Planuojamos ūkinės veiklos poveikio aplinkai vertinimo įstatymo taikymo sritį, ir (arba) įgyvendinant projektą planuojama ūkinė veikla susijusi su „Natura 2000“ teritorijomis, ir (arba) tai nustatyta ministerijos ar pažangos priemonės koordinatoriaus (jeigu koordinatorius yra paskirtas) (toliau – kartu ministerija), kurie pagal kompetenciją atsakingi už bendrai finansuojamus iš Europos Sąjungos fondų lėšų ūkio sektorius, patvirtintame projektų finansavimo sąlygų apraše).
5. | Informacija apie pareiškėjui (partneriui) suteiktą valstybės pagalbą (išskyrus de minimis) pagal PĮP 4 priede pateiktą formą (teikiama, jeigu kvietime teikti PĮP nurodoma, kad kartu su PĮP privaloma pateikti šį priedą). | X
6. | Ministerijos, o kai įgyvendinami regionų plėtros planų projektai (toliau – RPPl projektai), – regiono plėtros tarybos (toliau – RPT) parengtas dokumentas su suderinimo žyma (teikiamas, kai kvietime teikti PĮP nurodomas reikalavimas dėl projekto išvystymo ir PĮP suderinimo su ministerija, o kai įgyvendinami RPPl projektai, – RPT). | -
7. | Informacijos, reikalingos projekto atitikčiai projektų atrankos kriterijams įvertinti, pateikimo lentelė, PFSA 4 priedas | X
8. | MTEP verslo planas | X
9. | MTEP verslo plano priedai: Finansinis planas, 1A išteklių lentelė | X
10. | Dokumentai, pagrindžiantys projekto biudžeto pagrįstumą (komerciniai pasiūlymai, darbo užmokesčio pažymos) | X
11. | Projekto MTEP veiklų darbuotojų gyvenimo aprašymai (CV) | X
12. | Pareiškėjo Smulkiojo ar vidutinio verslo subjekto statuso deklaracija | X
13. | Projekto partnerio Smulkiojo ar vidutinio verslo subjekto statuso deklaracija | X
14. | Pareiškėjo finansinės atskaitomybės dokumentai | X

VI SKYRIUS

PAREIŠKĖJO DEKLARACIJA

☑Patvirtinu, kad:

1. Šiame PĮP ir prie jo pridedamuose dokumentuose pateikta informacija, mano žiniomis ir įsitikinimu, yra teisinga.

2. Esu susipažinęs (-usi) su projekto finansavimo sąlygomis, tvarka ir reikalavimais, nustatytais kvietime teikti PĮP.

3. Mano atstovaujamam pareiškėjui yra žinoma, kad projektas įgyvendinamas pagal projekto sutartyje, kvietime teikti PĮP ir jame nurodytuose Europos Sąjungos ir Lietuvos Respublikos teisės aktuose nustatytas sąlygas ir tvarką.

4. Mano atstovaujamam pareiškėjui yra žinoma, kad projekto įgyvendinimo metu turės būti laikomasi HP (darnaus vystymosi, įskaitant reikšmingos žalos nedarymo principą; lygių galimybių ir nediskriminavimo, įskaitant prieinamumo visiems reikalavimo užtikrinimą; inovatyvumo (kai taikoma)) ir PFSA, o kai įgyvendinami RPPl projektai, – Gairėse ir RPPl nustatytų reikalavimų dėl atitinkamų Chartijos nuostatų laikymosi.

5. Mano atstovaujamam pareiškėjui yra žinoma, kad projekto įgyvendinimo metu jis turės prisidėti nuosavu įnašu, apmokėdamas projekto tinkamas finansuoti išlaidas, kurios nepadengiamos projekto finansavimo lėšomis, ir visas kitas projektui įgyvendinti reikalingas išlaidas (įskaitant netinkamas finansuoti išlaidas).

6. Mano atstovaujamas pareiškėjas PĮP pateikimo dieną galutiniu teismo sprendimu ar galutiniu administraciniu sprendimu nėra pripažintas nevykdančiu pareigų, susijusių su mokesčių ar socialinio draudimo įmokų mokėjimu pagal Lietuvos Respublikos teisės aktus arba pagal kitos valstybės teisės aktus, jei pareiškėjas yra užsienyje registruotas juridinis asmuo (netaikoma įstaigoms, kurių veikla finansuojama iš valstybės ir (arba) savivaldybių biudžetų, ir (arba) valstybės pinigų fondų lėšų, ir pareiškėjams, kuriems Lietuvos Respublikos teisės aktų nustatyta tvarka yra atidėti mokesčių arba socialinio draudimo įmokų mokėjimo terminai).

7. Mano atstovaujamo pareiškėjo vadovas, pagrindinis akcininkas (turintis daugiau nei 50 procentų akcijų) ar savininkas, ūkinės bendrijos tikrasis (-ieji) narys (-iai) ar mažosios bendrijos atstovas (-ai), turintis (-ys) teisę juridinio asmens vardu sudaryti sandorį, ar apskaitą tvarkantis asmuo (asmenys), ar kitas (kiti) asmuo (asmenys), turintis (-ys) teisę surašyti ir pasirašyti pareiškėjo apskaitos dokumentus, PĮP vertinimo metu neturi neišnykusio arba nepanaikinto teistumo arba dėl pareiškėjo per pastaruosius 5 metus nebuvo priimtas ir įsiteisėjęs apkaltinamasis teismo nuosprendis dėl neteisėtos veiklos, kenkiančios Lietuvos Respublikos ir (arba) Europos Sąjungos finansiniams interesams, t. y. už dalyvavimą bendrininkų grupėje, organizuotoje grupėje, nusikalstamame susivienijime, jų organizavimą ar vadovavimą jiems, teroristinius ir su teroristine veikla susijusius nusikaltimus ar teroristų finansavimą, vaikų darbą ar kitas su prekyba žmonėmis susijusias nusikalstamas veikas, kyšininkavimą, prekybą poveikiu, papirkimą, piktnaudžiavimą, tarnybos pareigų neatlikimą, sukčiavimą, turto pasisavinimą, turto iššvaistymą, turtinės žalos padarymą apgaule, turto sunaikinimą ar sugadinimą, neteisėtą praturtėjimą, kontrabandą, muitinės apgaulę, neteisėtą disponavimą akcizais apmokestinamomis prekėmis, neteisėtą prekių ar produkcijos neišvežimą iš Lietuvos Respublikos, neteisėtą vertimąsi ūkine, komercine, finansine ar profesine veikla, neteisėtą juridinio asmens veiklą, svetimo prekių ar paslaugų ženklo naudojimą, apgaulingą pareiškimą apie juridinio asmens veiklą, mokesčių nesumokėjimą, kredito, paskolos ar tikslinės paramos panaudojimą ne pagal paskirtį ar nustatytą tvarką, kreditinį sukčiavimą, skolininko nesąžiningumą, nusikalstamą bankrotą, netikros elektroninės mokėjimo priemonės gaminimą, tikros elektroninės mokėjimo priemonės klastojimą ar neteisėtą disponavimą elektronine mokėjimo priemone arba jos duomenimis, neteisėtą elektroninės mokėjimo priemonės ar jos duomenų panaudojimą, neteisingų duomenų apie pajamas, pelną ar turtą pateikimą, deklaracijos, ataskaitos ar kito dokumento nepateikimą, apgaulingą ar aplaidų apskaitos tvarkymą, nusikalstamu būdu gauto turto įgijimą ar realizavimą, nusikalstamu būdu įgytų pinigų ar turto legalizavimą, netikrų pinigų ar vertybinių popierių pagaminimą, laikymą ar realizavimą, dokumento suklastojimą ar disponavimą suklastotu dokumentu, antspaudo, spaudo ar blanko suklastojimą, dalyvavimą kokioje nors kitoje neteisėtoje veikloje, kenkiančioje Lietuvos Respublikos ir (arba) Europos Sąjungos finansiniams interesams arba apie juos nėra pateiktų duomenų Finansinių nusikaltimų tyrimo tarnybos prie Lietuvos Respublikos vidaus reikalų ministerijos interneto svetainėje fntt.lt skelbiamoje informacijoje apie fizinių ir (ar) juridinių asmenų sąsajas su subjektais, kuriems taikomos tarptautinės sankcijos (netaikoma, jei pareiškėjo veikla yra finansuojama iš valstybės ir (arba) savivaldybių biudžetų ir (arba) valstybės pinigų fondų lėšų, taip pat iš Europos investicijų fondo ir Europos investicijų banko lėšų). Esu informuotas (-a), kad šiame punkte nurodytų asmenų teistumo duomenys tvarkomi vykdant 2018 m. liepos 18 d. Europos Parlamento ir Tarybos reglamento (ES, Euratomas) 2018/1046 dėl Sąjungos bendrajam biudžetui taikomų finansinių taisyklių, kuriuo iš dalies keičiami reglamentai (ES) Nr. 1296/2013, (ES) 1301/2013, (ES) Nr. 1303/2013, (ES) Nr. 1304/2013, (ES) Nr. 1309/2013, (ES) Nr. 1316/2013, (ES) Nr. 223/2014, (ES) Nr. 283/2014 ir sprendimas Nr. 541/2014/ES, bei panaikinamas Reglamentas (ES, Euratomas) Nr. 966/2013 (toliau – Finansinis reglamentas), 136 straipsnio 1 dalyje nustatytą pareigą.

8. Mano atstovaujamam pareiškėjui PĮP vertinimo metu, jei jis perkėlė gamybinę veiklą Europos Sąjungos valstybėje narėje arba į kitą valstybę narę, nėra taikoma arba nebuvo taikoma išieškojimo procedūra.

9. Mano atstovaujamam pareiškėjui PĮP vertinimo metu nėra taikomas apribojimas (iki 5 metų) neskirti Europos Sąjungos finansinės paramos dėl trečiųjų šalių piliečių nelegalaus įdarbinimo (netaikoma viešiesiems juridiniams asmenims).

10. Mano atstovaujamam pareiškėjui, kuris yra juridinis asmuo, nėra iškelta byla dėl bankroto arba jis nėra likviduojamas, nėra priimtas kreditorių susirinkimo nutarimas bankroto procedūras vykdyti ne teismo tvarka (netaikoma biudžetinėms įstaigoms). Mano atstovaujamam pareiškėjui, kuris yra juridinis asmuo, t. y. vadovui, pagrindiniam akcininkui (turinčiam daugiau nei 50 procentų akcijų) ar savininkui, ūkinės bendrijos tikrajam nariui (-iams) ar mažosios bendrijos atstovui (-ams), turinčiam (-tiems) teisę juridinio asmens vardu sudaryti sandorį, ar apskaitą tvarkančiam asmeniui (asmenims), ar kitam (kitiems) asmeniui (asmenims), turinčiam (-tiems) teisę surašyti ir pasirašyti pareiškėjo apskaitos dokumentus, nėra pradėtas ikiteisminis tyrimas dėl ūkinės ir (arba) ekonominės veiklos.

11. Mano atstovaujamas pareiškėjas PĮP vertinimo metu Juridinių asmenų registrui yra pateikęs metinių finansinių ataskaitų rinkinius, taip pat metinių konsoliduotųjų finansinių ataskaitų rinkinius, kaip nustatyta Juridinių asmenų registro nuostatuose, patvirtintuose Lietuvos Respublikos Vyriausybės 2003 m. lapkričio 12 d. nutarimu Nr. 1407 „Dėl Juridinių asmenų registro įsteigimo ir Juridinių asmenų registro nuostatų patvirtinimo“ (taikoma tik tais atvejais, kai finansines ataskaitas būtina rengti pagal įstatymus, taikomus juridiniam asmeniui, užsienio juridiniam asmeniui ar kitai organizacijai arba jų filialui).

12. Jeigu projektas įgyvendinamas kartu su partneriu (-ais) ir jeigu įgyvendinant projektą bus patiriamos PVM išlaidos, kurios yra tinkamos finansuoti iš Europos Sąjungos fondų ir (arba) valstybės biudžeto lėšų, jungtinės veiklos sutartimis ar kitais būdais užtikrinsiu, kad įgyvendinant projektą numatomos įsigyti prekės, paslaugos ar darbai bus skirti partnerio ne ekonominei veiklai ir (arba) Lietuvos Respublikos pridėtinės vertės mokesčio įstatyme nustatytoms PVM neapmokestinamoms veiklos rūšims (netaikoma užsienyje registruotiems juridiniams asmenims).

13. Mano atstovaujamam pareiškėjui yra žinoma, kad užsienyje sumokėto Lietuvos Respublikos apmokestinamojo asmens PVM negalima susigrąžinti pasinaudojus Valstybinės mokesčių inspekcijos prie Lietuvos Respublikos finansų ministerijos Elektroninių prašymų priėmimo sistema (EPRIS), o susigrąžinus, reikia nedelsiant apie tai informuoti administruojančiąją instituciją.

14. Mano atstovaujamam pareiškėjui yra žinoma, kad, jeigu projekto lėšomis apmokėta PVM suma bus įtraukta į PVM ataskaitą arba projekto įgyvendinimo metu, kai projektas finansuojamas iš Ekonomikos gaivinimo ir atsparumo didinimo priemonės arba 2021–2027 metų Europos Sąjungos fondų lėšų ir projekto bendra vertė kartu su PVM viršija 5 mln. eurų, ir pagal Lietuvos Respublikos teisės aktus bus įgyta teisė į PVM atskaitą, apie tai nedelsdamas turės informuoti administruojančiąją instituciją ir tą sumą privalės sugrąžinti.

15. Mano, kaip pareiškėjo vadovo ar įgalioto asmens, privatūs interesai yra suderinti su visuomenės viešaisiais interesais.

16. Mano atstovaujamas pareiškėjas įsipareigoja per administruojančiosios institucijos nustatytą terminą pateikti jai reikalingą informaciją ir (arba) atlikti Lietuvos Respublikos ir Europos Sąjungos atsakingų institucijų nurodytus veiksmus, vykdomus dėl kvietime teikti PĮP nurodytų ir kitų Lietuvos Respublikos ir Europos Sąjungos teisės aktų nuostatų taikymo.

17. Mano atstovaujamas pareiškėjas yra informuotas, kad, nepateikus kvietime teikti PĮP privalomų pateikti priedų ir PĮP vertinimo metu nepateikus prašomų dokumentų ir (ar) informacijos per administruojančiosios institucijos nustatytą terminą, PĮP bus atmestas.

18. Mano atstovaujamas pareiškėjas yra informuotas, kad vadovaujantis 2021 m. birželio 24 d. Europos Parlamento ir Tarybos reglamento (ES) 2021/1060, kuriuo nustatomos bendros Europos regioninės plėtros fondo, „Europos socialinio fondo +“, Sanglaudos fondo, Teisingos pertvarkos fondo ir Europos jūrų reikalų, žvejybos ir akvakultūros fondo nuostatos ir šių fondų bei Prieglobsčio, migracijos ir integracijos fondo, Vidaus saugumo fondo ir Sienų valdymo ir vizų politikos finansinės paramos priemonės taisyklės (toliau – BNR reglamentas), 49 straipsnio 3 ir 5 dalimis ir prisidedant prie investicijų skaidrumo didinimo, sudarius projekto sutartį ar po paraiškos finansuoti JP projektą patvirtinimo dienos, svetainėje esinvesticijos.lt ir kitose su Europos Sąjungos investicijomis susijusiose interneto svetainėse bei komunikacijos, matomumo priemonėse visuomenės informavimo tikslais bus paskelbti šie duomenys: projekto vykdytojo pavadinimas, partnerio pavadinimas, JP projekto vykdytojo pavadinimas (fizinio asmens vardo ir pavardės viešinimo trukmė yra 2 metai), rangovo ir subrangovo, prekių tiekėjo ir subtiekėjo, paslaugų teikėjo ar subteikėjo pavadinimas (kai vykdomi viešieji pirkimai ar ne perkančiosios organizacijos pirkimai, projekto pavadinimas, projekto tikslas ir rezultatai, projekto pradžios ir pabaigos laikas, bendra projekto vertė, Europos Sąjungos lėšų šaltinio (fondo) pavadinimas ir jo finansavimo dydis, su projektu susijusi intervencinės priemonės sritis pagal BNR reglamento 73 straipsnio 2 dalies g punktą, projekto įgyvendinimo vietos šalies nuoroda arba geografinė padėtis, kita informacija, kurios viešinimas neprieštarauja teisės aktų nuostatoms dėl su Europos Sąjungos investicijomis susijusių duomenų viešinimo. Taip pat mano atstovaujamas pareiškėjas yra informuotas, kad pagrindinėje interneto svetainėje (jeigu tokia yra) ir socialiniuose tinkluose per 20 darbo dienų nuo projekto sutarties pasirašymo dienos turės būti paskelbiamas trumpas projekto aprašymas, kuriame pristatomos visos įgyvendinant projektą suplanuotos veiklos, poveiklės, nurodomi projekto tikslai bei rezultatai ir informuojama apie gautą Europos Sąjungos finansavimą. Taip pat esu informuotas (-a), kad vadovaujantis BNR reglamento 49 straipsnio 6 dalimi Europos Sąjungos institucijų, organų, tarnybų ar agentūrų prašymu joms būtų suteikta galimybė susipažinti su projekto komunikacijos ir matomumo medžiaga, įskaitant informaciją Europos Sąjungos lėšų gavėjų lygmeniu, ir kad Europos Sąjungai būtų suteikta nemokama, neišimtinė ir neatšaukiama licencija naudoti tokią medžiagą ir visas su ja susijusias ankstesnes teises pagal BNR reglamento IX priedą ir Ekonomikos gaivinimo ir atsparumo didinimo priemonės (toliau – EGADP) finansinio susitarimo tarp Europos Komisijos ir Lietuvos Respublikos 10 straipsnio 6 punktą.

19. Mano atstovaujamam pareiškėjui yra žinoma, kad vadovaujantis BNR reglamento 70 straipsnio 3 dalimi, 71 straipsnio 3 dalimi, 74 straipsniu, Finansinio reglamento 129 straipsniu, 2021 m. vasario 12 d. Europos Parlamento ir Tarybos reglamento (ES) 2021/241, kuriuo nustatoma ekonomikos gaivinimo ir atsparumo didinimo priemonė (toliau – EGADP reglamentas), 22 straipsnio 2 dalies e punktu, Vadovaujančiosios, administruojančiosios ir audito institucijos funkcijų, įgyvendinant Ekonomikos gaivinimo ir atsparumo didinimo planą „Naujos kartos Lietuva“ paskirstymo taisyklių, patvirtintų Lietuvos Respublikos Vyriausybės 2020 m. lapkričio 25 d. nutarimu Nr. 1332 „Dėl pasirengimo administruoti Europos Sąjungos lėšas ir jų administravimo“ (toliau – EGADP atsakomybės taisyklės), 4.9, 5.6, 6.6, 6.9, 6.17, 7.2, 9.2 papunkčiais, 2021–2027 metų Europos Sąjungos fondų investicijų programos administruojančiosios institucijos ir tarpinės institucijos funkcijų sąrašo, patvirtinto Lietuvos Respublikos finansų ministro 2021 m. liepos 2 d. įsakymu Nr. 1K-237 „Dėl funkcijų paskirstymo įgyvendinant 2021–2027 metų Europos Sąjungos fondų investicijų programą“ (toliau – Atsakomybės taisyklės), 4.3, 4.4, 5.3, 5.4papunkčiais, 2021–2027 metų Europos Sąjungos fondų investicijų programos vadovaujančiosios institucijos funkcijų paskirstymo Lietuvos Respublikos finansų ministerijos administraciniams padaliniams aprašo, patvirtinto Lietuvos Respublikos finansų ministro 2021 m. liepos 2 d. įsakymu Nr. 1K-237 „Dėl funkcijų paskirstymo įgyvendinant 2021–2027 metų Europos Sąjungos fondų investicijų programą“ (toliau – Aprašas), 6.5 papunkčiu Europos Audito Rūmų, Europos Komisijos, Europos kovos su sukčiavimu tarnybos, Europos prokuratūros, vadovaujančiosios institucijos, ministerijų, tarpinės institucijos, administruojančiųjų institucijų, audito institucijos, kuriai pavesta atlikti 2021–2027 metų Europos Sąjungos fondų investicijų programos ir Ekonomikos gaivinimo ir atsparumo didinimo priemonės audito institucijos funkcijas, Viešųjų pirkimų tarnybos, Finansinių nusikaltimų tyrimo tarnybos prie Lietuvos Respublikos vidaus reikalų ministerijos, Lietuvos Respublikos specialiųjų tyrimų tarnybos ir Lietuvos Respublikos konkurencijos tarybos atstovai ir (ar) jų įgalioti asmenys turi teisę audituoti ir kontroliuoti mano atstovaujamo pareiškėjo ūkinę ir finansinę veiklą, kiek ji susijusi su projekto įgyvendinimu. Esu informuotas (-a), kad turiu visapusiškai bendradarbiauti su šiomis institucijomis Europos Sąjungos finansinių interesų apsaugos klausimu, užtikrinti su projekto įgyvendinimu susijusių dokumentų (įskaitant elektroninius dokumentus, pateiktus informacinių technologijų priemonėmis ir elektroninėse laikmenose) saugumą ir prieinamumą šių institucijų atstovams ir (ar) jų įgaliotiems asmenims projekto įgyvendinimo metu ir po projekto finansavimo pabaigos teisės aktuose nurodytu dokumentų saugojimo laikotarpiu.

20. Mano atstovaujamam pareiškėjui yra žinoma, kad vadovaudamasi BNR reglamento 69 straipsnio 2 dalimi, 71 straipsnio 3 dalimi, 72 straipsnio 1 dalies a ir e punktais, EGADP reglamento 22 straipsnio 2 dalies d punktu ir 3 dalimi, EGADP atsakomybės taisyklių 6.2, 6.15 ir 6.16 papunkčiais, Atsakomybės taisyklių 4.20, 5.14 papunkčiais administruojančioji institucija užtikrina duomenų, reikalingų stebėsenai, vertinimui, finansų valdymui, patikrinimams ir auditams, Europos Sąjungos fondų investicijų panaudojimo vertinimui atlikti, taip pat audito sekai užtikrinti, ir būtinų duomenų apie projektų įgyvendinimą rinkimą (įskaitant iš valstybės registrų ir duomenų bazių), įrašymą ir saugojimą skaitmeniniu formatu, šių duomenų saugumą, vientisumą, konfidencialumą ir naudotojų autentiškumo patvirtinimą.

21. Esu informuotas (-a), kad vadovaujantis BNR reglamento 69 straipsnio 6, 8 dalimis, 72 straipsnio 1 dalies e punktu, 82 straipsniu, EGADP atsakomybės taisyklių 4.8, 6.2 ir 6.16 papunkčiais, Aprašo 3.16, 3.20 ir 4.6 papunkčiais, Atsakomybės taisyklių 4.19, 4.20, 5.14 papunkčiais mano atstovaujamo pareiškėjo PĮP, projekto sutartyje, mokėjimo prašyme, išlaidų pagrindimo dokumentuose ir kituose dokumentuose esantys duomenys bus apdorojami ir saugomi 2021–2027 metų Europos Sąjungos fondų investicijų programos finansuojamų projektų administravimo informacinėje sistemoje šios sistemos nuostatuose nustatytais terminais ir Valstybės biudžeto, apskaitos ir mokėjimų sistemoje šios sistemos nuostatuose nustatytais terminais.

22. Esu informuotas (-a), kad mano asmens duomenis, nurodytus mano atstovaujamo pareiškėjo PĮP ir kituose administruojančiajai institucijai pateiktuose dokumentuose, Europos Komisija, vadovaujančioji, administruojančioji, audito institucijos tvarkys stebėsenos, ataskaitų teikimo, komunikacijos, skelbimo, vertinimo, finansų valdymo, patikrinimų ir audito, taip pat, kai taikytina, dalyvių atitikties nustatymo vykdymo tikslais (teisinis pagrindas – BNR reglamento 4 straipsnis, 71 straipsnio 1 ir 3 dalys, 72 straipsnio 1 dalies e punktas, Atsakomybės taisyklių 4.20, 5.14 papunkčiai ir 6 punktas) ir (arba) lėšų naudojimo, susijusio su Ekonomikos gaivinimo ir atsparumo didinimo plane „Naujos kartos Lietuva“ numatytomis reformų ir investicinių projektų įgyvendinimo priemonėmis, įvykdymo, audito ir kontrolės tikslais (teisinis pagrindas – EGADP reglamento 22 straipsnio 2 dalies d punktas ir 3 dalis, EGADP atsakomybės taisyklių 6.2 papunktis). Asmens duomenys bus tvarkomi vadovaujantis 2016 m. balandžio 27 d. Europos Parlamento ir Tarybos reglamentu (ES) 2016/679 dėl fizinių asmenų apsaugos tvarkant asmens duomenis ir dėl laisvo tokių duomenų judėjimo ir kuriuo panaikinama Direktyva 95/46/EB (Bendrasis duomenų apsaugos reglamentas) arba 2018 m. spalio 23 d. Europos Parlamento ir Tarybos reglamentu (ES) 2018/1725 dėl fizinių asmenų apsaugos Sąjungos institucijoms, organams, tarnyboms ir agentūroms tvarkant asmens duomenis ir dėl laisvo tokių duomenų judėjimo, kuriuo panaikinamas Reglamentas (EB) Nr. 45/2001 ir Sprendimas Nr. 1247/2002/EB, atsižvelgiant į tai, kuris iš jų taikytinas, bei kitais teisės aktais, reglamentuojančiais asmens duomenų tvarkymą.

23. Esu informuotas (-a), kad vadovaujantis BNR reglamento 44 straipsniu informacija apie projekto veiklas, su projekto išlaidų apmokėjimu susijusi informacija, mano kontaktiniai duomenys gali būti perduoti vertinimo ekspertams ir naudojami atliekant priemonės ir (ar) šio projekto įgyvendinimo vertinimą (renkant vertinimui būtinus duomenis apklausos, interviu ir kt. metodais).

24. Esu informuotas (-a), kad administruojančiųjų institucijų tvarkomi mano asmens duomenys, nurodyti mano atstovaujamo juridinio asmens PĮP ir kituose administruojančiosioms institucijoms pateiktuose dokumentuose, ir detalesnė informacija apie asmens duomenų tvarkymą ir teisių įgyvendinimą skelbiami administruojančiųjų institucijų interneto svetainėse.

25. Esu informuotas (-a), kad turiu šias Reglamente (ES) 2016/679 nustatytas teises: 1) žinoti (būti informuotas (-a)) apie savo asmens duomenų tvarkymą; 2) susipažinti su tvarkomais savo asmens duomenimis; 3) reikalauti ištaisyti asmens duomenis; 4) reikalauti ištrinti asmens duomenis, jei yra bent vienas pagrindas, nurodytas Reglamente (ES) 2016/679; 5) apriboti asmens duomenų tvarkymą; 6) pateikti skundą priežiūros institucijai.

26. Esu informuotas (-a), kad rinkdamas (-a), tvarkydamas (-a) projekto partnerio (-ių), projekto dalyvių, jungtinio projekto projekto pareiškėjo (-ų) asmens duomenis turiu užtikrinti Reglamente (ES) 2016/679 nustatytų reikalavimų vykdymą.

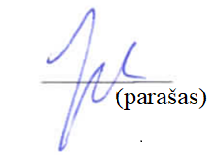
[picture p5: figure]

______Direktorius________ Julius Janušonis_____________

(pareiškėjo vadovo ar jo įgalioto (vardas ir pavardė)

asmens pareigų pavadinimas)

__________________________
