JuliusJanusonis/MB/Inostartas/Dokumentai projekto padavimui/Projekto dokumentai (Everoptics)/2.4.1. partnerio_deklaracija (dabartinė versija).docx

Projekto įgyvendinimo plano

1 priedas

(Partnerio deklaracijos forma)

arba

arba

LT_00_Fichier de reproduction Next Generation EU_BLACK Outline

(Monochrominė Europos Sąjungos emblema ir šalia jos pasirinktas teiginys: „Finansuoja Europos Sąjunga“ (kai pavienis projektas (toliau – projektas) 100 procentų finansuojamas 2021–2027 metų Europos Sąjungos fondų lėšomis) arba „Bendrai finansuoja Europos Sąjunga“ (kai projektas ne 100 procentų finansuojamas 2021–2027 metų Europos Sąjungos fondų lėšomis), arba „Finansuoja Europos Sąjunga NextGenerationEU“ (kai projektas finansuojamas 2021–2027 metų Europos Sąjungos fondų ir Ekonomikos gaivinimo ir atsparumo didinimo priemonės lėšomis arba Ekonomikos gaivinimo ir atsparumo didinimo priemonės lėšomis)

___MB „Everoptics“, Studentų g. 65-507, Kaunas_____

(partnerio pavadinimas, adresas)

PARTNERIO DEKLARACIJA

____2023 m. kovo 31 d.______

(data)

________Kaunas_________

(sudarymo vieta)

(Atskiras partnerio deklaracijas pasirašo visų projekto įgyvendinimo plane nurodytų partnerių vadovai ar jų įgalioti asmenys.)

Aš, ___________________, patvirtinu, kad:

(vardas ir pavardė)

1. Esu susipažinęs (-usi) su teikiamu projektu, savo teisėmis ir pareigomis įgyvendinant projektą.

2. Šiame projekto įgyvendinimo plane (toliau – PĮP) ir prie jo pridedamuose dokumentuose pateikta informacija, mano žiniomis ir įsitikinimu, yra teisinga.

3. Mano atstovaujamam partneriui yra žinoma, kad projektas įgyvendinamas pagal projekto sutartyje, kvietime teikti projektų įgyvendinimo planus (toliau – kvietimas teikti PĮP) ir jame nurodytuose Europos Sąjungos ir Lietuvos Respublikos teisės aktuose nustatytas sąlygas ir tvarką.

4. Mano atstovaujamas partneris projekto įgyvendinimo metu įsipareigoja laikytis horizontaliųjų principų (darnaus vystymosi, įskaitant reikšmingos žalos nedarymo principą; lygių galimybių ir nediskriminavimo, įskaitant prieinamumo visiems reikalavimo užtikrinimą; inovatyvumo (kai taikoma)) (toliau – HP), atsižvelgti į Jungtinių Tautų neįgaliųjų teisių konvencijos nuostatas ir laikytis projektų finansavimo sąlygų apraše, o kai planuojama įgyvendinti regionų plėtros planų (toliau – RPPl) įgyvendinimo projektą, – regioninės pažangos priemonės finansavimo gairėse ir RPPl nustatytų reikalavimų dėl HP ir atitinkamų Europos Sąjungos pagrindinių teisių chartijos nuostatų laikymosi.

5. Mano atstovaujamas partneris įsipareigoja projekto įgyvendinimo metu prisidėti nuosavu įnašu, apmokėdamas projekto tinkamas finansuoti išlaidas, kurios nepadengiamos projekto finansavimo lėšomis, ir visas kitas projektui įgyvendinti reikalingas išlaidas (įskaitant netinkamas finansuoti išlaidas).

6. Mano atstovaujamas partneris PĮP pateikimo dieną galutiniu teismo sprendimu ar galutiniu administraciniu sprendimu nėra pripažintas nevykdančiu pareigų, susijusių su mokesčių ar socialinio draudimo įmokų mokėjimu pagal Lietuvos Respublikos teisės aktus arba pagal kitos valstybės teisės aktus, jei partneris yra užsienyje registruotas juridinis asmuo (netaikoma įstaigoms, kurių veikla finansuojama iš Lietuvos Respublikos valstybės ir (arba) savivaldybių biudžetų, ir (arba) valstybės pinigų fondų lėšų, ir pareiškėjams, kuriems Lietuvos Respublikos teisės aktų nustatyta tvarka yra atidėti mokesčių arba socialinio draudimo įmokų mokėjimo terminai).

7. Mano atstovaujamo partnerio vadovas, naudos gavėjas, kaip jis apibrėžtas Lietuvos Respublikos pinigų plovimo ir teroristų finansavimo prevencijos įstatymo 2 straipsnio 14 dalyje (toliau – naudos gavėjas), ar savininkas, ūkinės bendrijos tikrasis (-ieji) narys (-iai) ar mažosios bendrijos atstovas (-ai), turintis (-ys) teisę juridinio asmens vardu sudaryti sandorį, ar finansinę apskaitą (toliau – apskaita) tvarkantis asmuo (asmenys), ar kitas (kiti) asmuo (asmenys), turintis (-ys) teisę surašyti ir pasirašyti pareiškėjo apskaitos dokumentus, PĮP vertinimo metu neturi neišnykusio arba nepanaikinto teistumo arba dėl partnerio (-ių) per pastaruosius 5 metus nebuvo priimtas ir įsiteisėjęs apkaltinamasis teismo nuosprendis dėl neteisėtos veiklos, kenkiančios Lietuvos Respublikos ir (arba) Europos Sąjungos finansiniams interesams, t. y. už dalyvavimą bendrininkų grupėje, organizuotoje grupėje, nusikalstamame susivienijime, jų organizavimą ar vadovavimą jiems, teroristinius ir su teroristine veikla susijusius nusikaltimus ar teroristų finansavimą, vaikų darbą ar kitas su prekyba žmonėmis susijusias nusikalstamas veikas, kyšininkavimą, prekybą poveikiu, papirkimą, piktnaudžiavimą, tarnybos pareigų neatlikimą, sukčiavimą, turto pasisavinimą, turto iššvaistymą, turtinės žalos padarymą apgaule, turto sunaikinimą ar sugadinimą, neteisėtą praturtėjimą, kontrabandą, muitinės apgaulę, neteisėtą disponavimą akcizais apmokestinamomis prekėmis, neteisėtą prekių ar produkcijos neišvežimą iš Lietuvos Respublikos, neteisėtą vertimąsi ūkine, komercine, finansine ar profesine veikla, neteisėtą juridinio asmens veiklą, svetimo prekių ar paslaugų ženklo naudojimą, apgaulingą pareiškimą apie juridinio asmens veiklą, mokesčių nesumokėjimą, kredito, paskolos ar tikslinės paramos panaudojimą ne pagal paskirtį ar nustatytą tvarką, kreditinį sukčiavimą, skolininko nesąžiningumą, nusikalstamą bankrotą, netikros elektroninės mokėjimo priemonės gaminimą, tikros elektroninės mokėjimo priemonės klastojimą ar neteisėtą disponavimą elektronine mokėjimo priemone arba jos duomenimis, neteisėtą elektroninės mokėjimo priemonės ar jos duomenų panaudojimą, neteisingų duomenų apie pajamas, pelną ar turtą pateikimą, deklaracijos, ataskaitos ar kito dokumento nepateikimą, apgaulingą ar aplaidų apskaitos tvarkymą, nusikalstamu būdu gauto turto įgijimą ar realizavimą, nusikalstamu būdu įgytų pinigų ar turto legalizavimą, netikrų pinigų ar vertybinių popierių pagaminimą, laikymą ar realizavimą, dokumento suklastojimą ar disponavimą suklastotu dokumentu, antspaudo, spaudo ar blanko suklastojimą, dalyvavimą kokioje nors kitoje neteisėtoje veikloje, kenkiančioje Lietuvos Respublikos ir (arba) Europos Sąjungos finansiniams interesams, arba nėra subjektas, kuriam taikomos sankcijos, kaip jis apibrėžtas Lietuvos Respublikos tarptautinių sankcijų įstatymo 2 straipsnio 1 dalyje (netaikoma, jei partnerio veikla finansuojama iš valstybės ir (arba) savivaldybių biudžetų ir (arba) valstybės pinigų fondų lėšų, taip pat iš Europos investicijų fondo ir Europos investicijų banko lėšų). Esu informuotas (-a), kad šiame punkte nurodytų asmenų teistumo duomenys tvarkomi vykdant 2018 m. liepos 18 d. Europos Parlamento ir Tarybos reglamento (ES, Euratomas) 2018/1046 dėl Sąjungos bendrajam biudžetui taikomų finansinių taisyklių, kuriuo iš dalies keičiami reglamentai (ES) Nr. 1296/2013, (ES) 1301/2013, (ES) Nr. 1303/2013, (ES) Nr. 1304/2013, (ES) Nr. 1309/2013, (ES) Nr. 1316/2013, (ES) Nr. 223/2014, (ES) Nr. 283/2014 ir sprendimas Nr. 541/2014/ES, bei panaikinamas Reglamentas (ES, Euratomas) Nr. 966/2013 (toliau – Finansinis reglamentas), 136 straipsnio 1 dalyje nustatytą pareigą.

8. Mano atstovaujamam partneriui PĮP vertinimo metu, jei jis nutraukė gamybinę veiklą arba perkėlė gamybinę veiklą, kuriai buvo skirtas finansavimas iš 2014–2020 metų arba 2021–2027 metų Europos Sąjungos fondų lėšų, už Lietuvos ribų arba, kai projektai finansuojami 2021–2027 metų Europos Sąjungos fondų lėšomis, ir už konkretaus 2021–2027 metų Europos Sąjungos fondų investicijų programos regiono ribų, netaikyta arba yra pasibaigusi lėšų grąžinimo procedūra dėl pažeidimo neįvykdžius investicijų tęstinumo reikalavimo.

8¹. Mano atstovaujamas partneris nėra perkėlęs PĮP nurodytai veiklai tapačios veiklos arba jos dalies ar panašios veiklos iš kitoje Europos ekonominės erdvės valstybėje esančios įmonės į Lietuvos Respublikoje esančią įmonę, kuriai prašoma suteikti finansavimą, ir įsipareigoja to nedaryti projekto įgyvendinimo metu bei 2 metus po projekto įgyvendinimo pabaigos (reikalavimas taikomas, kai projektui teikiama valstybės pagalba (įskaitant „de minimis“ pagalbą) arba kai Ekonomikos gaivinimo ir atsparumo didinimo plano „Naujos kartos Lietuva“ lėšomis finansuojamam projektui pagal valstybės pagalbos taisykles taikoma prievolė neperkelti su projektu susijusiai veiklai tapačios veiklos, jos dalies ar panašios veiklos).

9. Dėl mano atstovaujamo partnerio PĮP vertinimo metu nėra taikomas apribojimas (iki 5 metų) neskirti Europos Sąjungos finansinės paramos dėl trečiųjų šalių piliečių nelegalaus įdarbinimo (netaikoma viešiesiems juridiniams asmenims).

10. Mano atstovaujamam partneriui, kuris yra juridinis asmuo, nėra iškelta byla dėl bankroto arba jis nėra likviduojamas, nėra priimtas kreditorių susirinkimo nutarimas bankroto procedūras vykdyti ne teismo tvarka (netaikoma biudžetinėms įstaigoms). Mano atstovaujamam partneriui, kuris yra juridinis asmuo, t. y. vadovui, naudos gavėjui ar savininkui, ūkinės bendrijos tikrajam nariui (-iams) ar mažosios bendrijos atstovui (-ams), turinčiam (-tiems) teisę juridinio asmens vardu sudaryti sandorį, ar apskaitą tvarkančiam asmeniui (asmenims), ar kitam (kitiems) asmeniui (asmenims), turinčiam (-tiems) teisę surašyti ir pasirašyti pareiškėjo apskaitos dokumentus, nėra pradėtas ikiteisminis tyrimas dėl ūkinės ir (arba) ekonominės veiklos.

11. Mano atstovaujamas partneris PĮP vertinimo metu Juridinių asmenų registrui yra pateikęs metinių finansinių ataskaitų rinkinius, taip pat metinių konsoliduotųjų finansinių ataskaitų rinkinius, kaip nustatyta Juridinių asmenų registro nuostatuose, patvirtintuose Lietuvos Respublikos Vyriausybės 2003 m. lapkričio 12 d. nutarimu Nr. 1407 „Dėl Juridinių asmenų registro įsteigimo ir Juridinių asmenų registro nuostatų patvirtinimo“ (taikoma tik tais atvejais, kai finansines ataskaitas būtina rengti pagal įstatymus, taikomus juridiniam asmeniui, užsienio juridiniam asmeniui ar kitai organizacijai arba jų filialui).

12. Esu susipažinęs (-usi) su PĮP pateiktais duomenimis apie mano atstovaujamą partnerį ir patvirtinu, kad šie duomenys teisingi (netaikoma užsienyje registruotiems juridiniams asmenims).

13. Mano atstovaujamam partneriui asmeniui yra žinoma, kad užsienyje sumokėto Lietuvos Respublikos apmokestinamojo asmens pridėtinės vertės mokesčio (toliau – PVM) negalima susigrąžinti pasinaudojus Valstybinės mokesčių inspekcijos prie Lietuvos Respublikos finansų ministerijos Elektroninių prašymų priėmimo sistema (EPRIS) arba susigrąžinus nedelsiant apie tai informuoti administruojančiąją instituciją.

14. Mano atstovaujamam partneriui yra žinoma, kad, jeigu projekto lėšomis apmokėta PVM suma bus įtraukta į PVM atskaitą arba projekto įgyvendinimo metu, kai projektas finansuojamas iš Ekonomikos gaivinimo ir atsparumo didinimo priemonės arba 2021–2027 metų Europos Sąjungos fondų lėšų ir projekto bendra vertė kartu su PVM viršija 5 mln. eurų, ir pagal Lietuvos Respublikos teisės aktus bus įgyta teisė į PVM atskaitą, apie tai nedelsdamas turės informuoti administruojančiąją instituciją ir tą sumą privalės sugrąžinti.

15. Mano, kaip partnerio vadovo ar įgalioto asmens, privatūs interesai yra suderinti su visuomenės viešaisiais interesais.

16. Mano atstovaujamas partneris įsipareigoja per administruojančiosios institucijos nustatytą terminą pateikti jai reikalingą informaciją ir (arba) atlikti Lietuvos Respublikos ir Europos Sąjungos atsakingų institucijų nurodytus veiksmus, vykdomus dėl kvietime teikti PĮP nurodytų ir kitų Lietuvos Respublikos ir Europos Sąjungos teisės aktų nuostatų taikymo.

17. Mano atstovaujamam partneriui žinoma, kad nepateikus kvietime teikti PĮP privalomų pateikti priedų ir PĮP vertinimo metu nepateikus prašomų dokumentų ir (ar) informacijos per administruojančiosios institucijos nustatytą terminą PĮP bus atmestas.

18. Mano atstovaujamam partneriui žinoma, kad vadovaujantis 2021 m. birželio 24 d. Europos Parlamento ir Tarybos reglamento (ES) 2021/1060, kuriuo nustatomos bendros Europos regioninės plėtros fondo, „Europos socialinio fondo +“, Sanglaudos fondo, Teisingos pertvarkos fondo ir Europos jūrų reikalų, žvejybos ir akvakultūros fondo nuostatos ir šių fondų bei Prieglobsčio, migracijos ir integracijos fondo, Vidaus saugumo fondo ir Sienų valdymo ir vizų politikos finansinės paramos priemonės taisyklės (toliau – BNR reglamentas), 49 straipsnio 3 ir 5 dalimis ir prisidedant prie investicijų skaidrumo didinimo, sudarius projekto sutartį, interneto svetainėje esinvesticijos.lt visuomenės informavimo tikslais bus paskelbti šie duomenys: partnerio pavadinimas (fizinio asmens vardo ir pavardės viešinimo trukmė yra 2 metai), vykdant viešuosius pirkimus – rangovo ir subrangovo, prekių tiekėjo ir subtiekėjo, paslaugų teikėjo ar subtiekėjo pavadinimas (kai vykdomi viešieji pirkimai ar ne perkančiosios organizacijos pirkimai, kita informacija, kurios viešinimas neprieštarauja teisės aktams dėl su Europos Sąjungos investicijomis susijusių duomenų viešinimo. Taip pat esu informuotas (-a), kad partnerio pagrindinėje interneto svetainėje (jeigu tokia yra) ir socialiniuose tinkluose per 20 darbo dienų nuo projekto sutarties pasirašymo dienos paskelbiamas trumpas projekto aprašymas, kuriame pristatomos visos įgyvendinant projektą suplanuotos veiklos, poveiklės, nurodomi projekto tikslai bei rezultatai ir informuojama apie gautą Europos Sąjungos finansavimą. Jeigu partneris į projekto įgyvendinimą įtraukiamas atliekant projekto sutarties keitimą, minėta informacija partnerio pagrindinėje interneto svetainėje (jeigu tokia yra) ir socialiniuose tinkluose paskelbiama per 20 darbo dienų nuo projekto sutarties pakeitimo, kuriuo partneris buvo įtrauktas į projektą, dienos. Projekto aprašymas interneto svetainėje turi būti lengvai randamas ir aiškiai matomas bent iki projekto pabaigos (ilgalaikiam matomumui užtikrinti naujienų rubrika nenaudojama). Taip pat esu informuotas (-a), kad vadovaujantis BNR reglamento 49 straipsnio 6 dalimi Europos Sąjungos institucijų, organų, tarnybų ar agentūrų prašymu joms būtų suteikta galimybė susipažinti su projekto komunikacijos ir matomumo medžiaga, įskaitant informaciją paramos gavėjų lygmeniu, ir kad Europos Sąjungai būtų suteikta nemokama, neišimtinė ir neatšaukiama licencija naudoti tokią medžiagą ir visas su ja susijusias ankstesnes teises pagal BNR reglamento IX priedą ir pagal Ekonomikos gaivinimo ir atsparumo didinimo priemonės finansinio susitarimo tarp Europos Komisijos ir Lietuvos Respublikos 10 straipsnio 6 punktą.

19. Mano atstovaujamam partneriui žinoma, kad vadovaujantis BNR reglamento 70 straipsnio 3 dalimi, 71 straipsnio 3 dalimi, 74 straipsniu, Finansinio reglamento 129 straipsniu, 2021 m. vasario 12 d. Europos Parlamento ir Tarybos reglamento (ES) 2021/241, kuriuo nustatoma ekonomikos gaivinimo ir atsparumo didinimo priemonė (toliau – EGADP reglamentas), 22 straipsnio 2 dalies e punktu, Vadovaujančiosios, administruojančiosios ir audito institucijos funkcijų, įgyvendinant Ekonomikos gaivinimo ir atsparumo didinimo planą „Naujos kartos Lietuva“ paskirstymo taisyklių, patvirtintų Lietuvos Respublikos Vyriausybės 2020 m. lapkričio 25 d. nutarimu Nr. 1332 „Dėl pasirengimo administruoti Europos Sąjungos lėšas ir jų administravimo“ (toliau – EGADP atsakomybės taisyklės), 4.9, 5.6, 6.6, 6.9, 6.17, 7.2, 9.2 papunkčiais, 2021–2027 metų Europos Sąjungos fondų investicijų programos administruojančiosios institucijos ir tarpinės institucijos funkcijų sąrašo, patvirtinto Lietuvos Respublikos finansų ministro 2021 m. liepos 2 d. įsakymu Nr. 1K-237 „Dėl funkcijų paskirstymo įgyvendinant 2021–2027 metų Europos Sąjungos fondų investicijų programą“ (toliau – Atsakomybės taisyklės), 4.3, 4.4, 5.3, 5.4 papunkčiais, 2021–2027 metų Europos Sąjungos fondų investicijų programos vadovaujančiosios institucijos funkcijų paskirstymo Lietuvos Respublikos finansų ministerijos administraciniams padaliniams aprašo, patvirtinto Lietuvos Respublikos finansų ministro 2021 m. liepos 2 d. įsakymu Nr. 1K-237 „Dėl funkcijų paskirstymo įgyvendinant 2021–2027 metų Europos Sąjungos fondų investicijų programą“ (toliau – Aprašas), 6.5 papunkčiu Europos Audito Rūmų, Europos Komisijos, Europos kovos su sukčiavimu tarnybos, Europos prokuratūros, vadovaujančiosios institucijos, ministerijų ir tarpinės institucijos, administruojančiųjų institucijų, audito institucijos, kuriai pavesta atlikti 2021–2027 metų Europos Sąjungos fondų investicijų programos ir Ekonomikos gaivinimo ir atsparumo didinimo priemonės audito institucijos funkcijas, Viešųjų pirkimų tarnybos, Finansinių nusikaltimų tyrimo tarnybos prie Lietuvos Respublikos vidaus reikalų ministerijos, Lietuvos Respublikos specialiųjų tyrimų tarnybos ir Lietuvos Respublikos konkurencijos tarybos atstovai ir (ar) jų įgalioti asmenys turi teisę audituoti ir kontroliuoti mano atstovaujamo juridinio asmens ūkinę ir finansinę veiklą, kiek ji yra susijusi su projekto įgyvendinimu. Esu informuotas (-a), kad turiu visapusiškai bendradarbiauti su šiomis institucijomis Europos Sąjungos finansinių interesų apsaugos klausimu, užtikrinti su projekto įgyvendinimu susijusių dokumentų (įskaitant elektroninius dokumentus, pateiktus informacinių technologijų priemonėmis ir elektroninėse laikmenose) saugumą ir prieinamumą šių institucijų atstovams ir (ar) jų įgaliotiems asmenims projekto įgyvendinimo metu ir po projekto finansavimo pabaigos teisės aktuose nurodytu dokumentų saugojimo laikotarpiu.

20. Mano atstovaujamam partneriui žinoma, kad vadovaudamasi BNR reglamento 69 straipsnio 2 dalimi, 71 straipsnio 3 dalimi, 72 straipsnio 1 dalies a ir e punktais, EGADP reglamento 22 straipsnio 2 dalies d punktu ir 3 dalimi, EGADP atsakomybės taisyklių 6.2, 6.15 ir 6.16 papunkčiais, Atsakomybės taisyklių 4.20, 5.14 papunkčiais administruojančioji institucija užtikrina duomenų, kurių reikia stebėsenai, vertinimui, finansų valdymui, patikrinimams ir auditams, Europos Sąjungos fondų investicijų panaudojimo vertinimui atlikti, taip pat audito sekai užtikrinti, ir būtinų duomenų apie projektų įgyvendinimą rinkimą (įskaitant duomenis iš valstybės registrų ir duomenų bazių), įrašymą ir saugojimą skaitmeniniu formatu, šių duomenų saugumą, vientisumą, konfidencialumą ir naudotojų autentiškumo patvirtinimą.

21. Esu informuotas (-a), kad vadovaujantis BNR reglamento 69 straipsnio 6, 8 dalimis, 72 straipsnio 1 dalies e punktu, 82 straipsniu, EGADP atsakomybės taisyklių 4.8, 6.2 ir 6.16 papunkčiais, Aprašo 3.16, 3.20 ir 4.6 papunkčiais, Atsakomybės taisyklių 4.19, 4.20, 5.14 papunkčiais pareiškėjo PĮP, projekto sutartyje, mokėjimo prašyme, išlaidų pagrindimo dokumentuose, išlaidų apmokėjimo įrodymo dokumentuose ir kituose dokumentuose esantys duomenys bus apdorojami ir saugomi Europos Sąjungos investicijų administravimo informacinėje sistemoje šios sistemos nuostatuose nustatytais terminais ir Valstybės biudžeto, apskaitos ir mokėjimų sistemoje šios sistemos nuostatuose nustatytais terminais.

22. Esu informuotas (-a), kad mano asmens duomenis, nurodytus pareiškėjo PĮP ir projekto sutartyje, mokėjimo prašyme, išlaidų pagrindimo dokumentuose ir kituose administruojančiajai institucijai pateiktuose dokumentuose, Europos Komisija, vadovaujančioji, administruojančioji, audito institucijos tvarkys stebėsenos, ataskaitų teikimo, komunikacijos, skelbimo, vertinimo, finansų valdymo, patikrinimų ir audito, taip pat, kai taikytina, dalyvių atitikties nustatymo vykdymo tikslais (teisinis pagrindas – BNR reglamento 4 straipsnis, 71 straipsnio 1 ir 3 dalys, 72 straipsnio 1 dalies e punktas, Atsakomybės taisyklių 4.20, 5.14 papunkčiai ir 6 punktas) ir (arba) lėšų naudojimo, susijusio su Ekonomikos gaivinimo ir atsparumo didinimo plane „Naujos kartos Lietuva“ numatytomis reformų ir investicijų projektų įgyvendinimo priemonėmis, įvykdymo, audito ir kontrolės tikslais (teisinis pagrindas – EGADP reglamento 22 straipsnio 2 dalies d punktas ir 3 dalis, EGADP atsakomybės taisyklių 6.2 papunktis). Asmens duomenys bus tvarkomi vadovaujantis 2016 m. balandžio 27 d. Europos Parlamento ir Tarybos reglamentu (ES) 2016/679 dėl fizinių asmenų apsaugos tvarkant asmens duomenis ir dėl laisvo tokių duomenų judėjimo ir kuriuo panaikinama Direktyva 95/46/EB (Bendrasis duomenų apsaugos reglamentas) arba 2018 m. spalio 23 d. Europos Parlamento ir Tarybos reglamentu (ES) 2018/1725 dėl fizinių asmenų apsaugos Sąjungos institucijoms, organams, tarnyboms ir agentūroms tvarkant asmens duomenis ir dėl laisvo tokių duomenų judėjimo, kuriuo panaikinamas Reglamentas (EB) Nr. 45/2001 ir Sprendimas Nr. 1247/2002/EB, atsižvelgiant į tai, kuris iš jų taikytinas, bei kitais teisės aktais, reglamentuojančiais asmens duomenų tvarkymą.

23. Esu informuotas (-a), kad vadovaujantis BNR reglamento 44 straipsniu informacija apie projekto veiklas, su projekto išlaidų apmokėjimu susijusi informacija, mano kontaktiniai duomenys gali būti perduoti vertinimo ekspertams ir naudojami atliekant priemonės ir (ar) šio projekto įgyvendinimo vertinimą (renkant vertinimui būtinus duomenis apklausos, interviu ir kt. metodais).

24. Esu informuotas (-a), kad administruojančiųjų institucijų tvarkomi mano asmens duomenys, nurodyti pareiškėjo PĮP ir kituose administruojančiosioms institucijoms pateiktuose dokumentuose, ir detalesnė informacija apie asmens duomenų tvarkymą ir teisių įgyvendinimą skelbiami administruojančiųjų institucijų interneto svetainėse.

25. Esu informuotas (-a), kad turiu šias Reglamente (ES) 2016/679 nustatytas teises: 1) žinoti (būti informuotas (-a)) apie savo asmens duomenų tvarkymą; 2) susipažinti su tvarkomais savo asmens duomenimis; 3) reikalauti ištaisyti asmens duomenis; 4) reikalauti ištrinti asmens duomenis, jei yra bent vienas pagrindas, nustatytas Reglamente (ES) 2016/679; 5) apriboti asmens duomenų tvarkymą; 6) pateikti skundą priežiūros institucijai.

26. Mano atstovaujamo partnerio planuojamų įgyvendinti projekto veiklų išlaidos nefinansuojamos pagal kitus partnerio įgyvendintus ir (arba) įgyvendinamus projektus.

_____Direktorius___________ _________ ___Julius Janušonis___

(partnerio vadovo ar jo įgalioto (parašas) (vardas ir pavardė)

asmens pareigų pavadinimas)

Pastaba. Ši forma pildoma, jeigu projektas įgyvendinamas su partneriu (-iais).

_________________________________
