JuliusJanusonis/MB/Inostartas/Dokumentai projekto padavimui/Projekto dokumentai (Everoptics)/2.4.10. vienos įmonės deklaracija_baigta.docx

2022–2030 metų plėtros programos valdytojos Lietuvos

Respublikos ekonomikos ir inovacijų ministerijos

ekonomikos transformacijos ir konkurencingumo

plėtros programos pažangos priemonės Nr. 05-001-01-05-07 „Sukurti nuoseklią inovacinės veiklos skatinimo

sistemą“ veiklos „Skatinti inovacijų pasiūlą“ poveiklės

„Investuoti į naujų APV produktų kūrimo veiklas ir

sudaryti sąlygas tyrėjams dalyvauti įmonių MTEP

veiklose, skatinti intelektinę nuosavybę, ankstyvąją

sukurtų naujų produktų bandomąją gamybą, parengimą

rinkai“ (Vidurio ir vakarų Lietuvos regionas)“ projektų

finansavimo sąlygų aprašo

5 priedas

(„Vienos įmonės“ deklaracijos forma)

„VIENOS ĮMONĖS“ DEKLARACIJA

________2023-03-31__________

pildymo data

1. | Deklaruojančios įmonės pavadinimas

MB „Everoptics“
2. | Deklaruojančios įmonės kodas

306272113

3.

„Vienos įmonės“ apibrėžtis

Vadovaujantis 2013 m. gruodžio 18 d. Europos Komisijos reglamento (ES) Nr. 1407/2013 dėl Sutarties dėl Europos Sąjungos veikimo 107 ir 108 straipsnių taikymo de minimis pagalbai su paskutiniais pakeitimais, padarytais 2021 m. liepos 23 d. Komisijos reglamentu (ES) Nr. 2021/1237, 2 straipsnio 2 punktu, „viena įmonė“ apima visas įmones, kurių tarpusavio santykiai yra bent vienos rūšies iš toliau išvardytų:
a) viena įmonė turi kitos įmonės akcininkų arba narių balsų daugumą;
b) viena įmonė turi teisę paskirti arba atleisti daugumą kitos įmonės administracijos, valdymo arba priežiūros organo narių;
c) pagal sutartį arba vadovaujantis steigimo sutarties ar įstatų nuostata vienai įmonei suteikiama teisė daryti kitai įmonei lemiamą įtaką;
d) viena įmonė, būdama kitos įmonės akcininkė arba narė, vadovaudamasi su tos įmonės kitais akcininkais ar nariais sudaryta sutartimi, viena kontroliuoja tos kitos įmonės akcininkų arba narių balsavimo teisių daugumą.

Įmonės, kurios pirmos pastraipos a–d punktuose nurodytais santykiais yra susijusios per vieną ar daugiau kitų įmonių, taip pat laikomos „viena įmone“.

Įmonė yra bet kuris ekonominę veiklą vykdantis subjektas, kad ir koks būtų jo teisinis statusas. Visų pirma įmone laikomi savisamdžiai asmenys ir šeimos įmonės, vykdančios amatų ar kitokią veiklą, ir reguliarią ekonominę veiklą vykdančios ūkinės bendrijos arba asociacijos.
4. | Deklaruoju, kad pareiškėją – „vieną įmonę“ – ryšiai sieja su šiomis įmonėmis:
| Eil. Nr. | Įmonės kodas | Įmonės pavadinimas
| 1.
| 2.
| 3.
| 4.
| 5.
| 6.
| 7.
| 8.
| 9.
| 10.
| 11.
5. | Aš, toliau pasirašęs, patvirtinu, kad deklaracijoje pateikti duomenys yra teisingi ir į deklaraciją yra įtrauktos visos įmonės, kurias sieja su paraiškėju Reglamento (ES) Nr. 1407/2013 2 straipsnio 2 punkte nustatyti ryšiai.

_____Direktorius____ ________________ ______ Julius Janušonis ______

(pareigos) (parašas) (vardas ir pavardė)

_______________________________
