JuliusJanusonis/MB/Inostartas/Dokumentai projekto padavimui/Projekto dokumentai (Everoptics)/projekto igyvendinimo planas.docx

Projektų administravimo ir finansavimo taisyklių

1 priedas

(Projekto įgyvendinimo plano forma)

arba

arba

LT_00_Fichier de reproduction Next Generation EU_BLACK Outline

(Monochrominė Europos Sąjungos emblema ir šalia jos pasirinktas teiginys: „Finansuoja Europos Sąjunga“ (kai pavienis ar jungtinis projektas (toliau – projektas) 100 procentų finansuojamas 2021–2027 metų Europos Sąjungos fondų lėšomis) arba „Bendrai finansuoja Europos Sąjunga“ (kai projektas ne 100 procentų finansuojamas 2021–2027 metų Europos Sąjungos fondų lėšomis), arba „Finansuoja Europos Sąjunga NextGenerationEU“ (kai projektas finansuojamas 2021–2027 metų Europos Sąjungos fondų ir Ekonomikos gaivinimo ir atsparumo didinimo priemonės lėšomis arba Ekonomikos gaivinimo ir atsparumo didinimo priemonės lėšomis)

__________________________________MB “Everoptics”___________________________________

(pareiškėjo pavadinimas)

PROJEKTO ĮGYVENDINIMO PLANAS

Pildymo data | 2023-03-28
Patikslinimo data | Nurodoma patikslinimo data (DMS užpildoma automatiškai)

Forma pildoma ir teikiama kvietime teikti projektų įgyvendinimo planus (toliau – PĮP) nustatyta PĮP rengimo ir teikimo tvarka.

Kai DMS formos pildymo instrukcijoje nurodytas galimas simbolių skaičius arba nurodyta, kad galima įvesti tik skaičių, įvedus daugiau simbolių, nei numatyta, arba įvedus raides, rodomas klaidos pranešimas ir neleidžiama išsaugoti reikšmės.

Elektroninėje PĮP formoje, kurią pildo pareiškėjas, pildomų laukų išdėstymo tvarka nebūtinai atitinka šioje PĮP formoje nurodytą laukų išdėstymo tvarką.

I SKYRIUS

BENDRIEJI DUOMENYS

1.1. | Kvietimo teikti projektų įgyvendinimo planus (toliau – PĮP) numeris
1.2. | Pavienio ar jungtinio projekto (toliau – projektas) pavadinimas | Nauji metodai matuoti optines dangas vystant prietaisą „Spectral Mapper“
1.3. | Projekto kodas | Sugeneruojamas ir nurodomas automatiškai, pateikus PĮP per DMS. Nepildoma, jei PĮP teikiamas ne per DMS.
1.4. | Pareiškėjas
1.4.1. | Pavadinimas | MB „Everoptics“
1.4.2. | Juridinio asmens kodas | 306272113 Pareiškėjas yra užsienyje registruotas juridinis asmuo Pažymima, jeigu pareiškėjas yra užsienyje registruotas juridinis asmuo. Nurodžius šį požymį, privaloma pateikti pareiškėjo ir partnerio deklaracijas.
1.4.3. | Adresas | Studentų g. 65-507, Kaunas
1.4.4. | Telefono numeris | +37063817746
1.4.5. | El. paštas | j.j.janusonis@gmail.com
1.5. | Kontaktinis asmuo | Julius Janušonis
1.5.1. | Asmens pareigų pavadinimas, vardas, pavardė | MB „Everoptics“ direktorius, Julius Janušonis
1.5.2. | Telefono numeris | +37063817746
1.5.3. | El. paštas | j.j.janusonis@gmail.com
1.6. | Partneris (-iai) | Juridinis (-iai) asmuo (-enys), kuri (-ie) kartu su pareiškėju inicijuoja ir įgyvendins projektą, siekdamas (-i) bendrų rezultatų.
| Pavadinimas | Juridinio asmens kodas | | Adresas | Telefono numeris | El. paštas
1.6.1. | UAB „Baltec CNC Technologies“ | 110856022 | | Raudondvario pl. 148, Kaunas | +37037314630 | info@baltec-cnc.com

II SKYRIUS

PROJEKTO INICIJAVIMAS

(pildoma rengiant visų tipų projektų įgyvendinimo aprašus)

2.1. | Projektu sprendžiamos problemos

Aprašomos projektu planuojamos spręsti problemos, jų priežastys.

Įvardijama projektu sprendžiama (-os) problema (-os), nustatyta (-os) plėtros programoje ar, kai planuojama įgyvendinti regionų plėtros planų (toliau – RPPl) įgyvendinimo projektą (toliau – RPPl projektą), – RPPl, kurią (-ias) siekiama spręsti įgyvendinant projektą, ir statistiniais duomenimis pagrindžiamas problemos aktualumas, pvz., trūksta gebėjimų kokybiškai suteikti paslaugą, ilgas paslaugos suteikimo laikas, nepakankamas paslaugos prieinamumas, neteikiama vartotojų poreikius atitinkanti paslauga, nėra konkrečių duomenų, kaip būtų galima pagerinti paslaugos teikimą, paslauga teikiama neefektyviai, per didelė paslaugos teikimo savikaina.

Aprašomas projekto poreikis – galimos pasekmės, jei problema nebus išspręsta, kodėl verta investuoti lėšas į šį projektą (pvz., nauja įranga sumažins užterštumo lygį), kokius rinkos netolygumus projektu siekiama spręsti (pvz., projektas skirtas specialistams, kurių trūksta darbo rinkoje, parengti), problemos sprendimo būdas, projekto siekiami rezultatai ir kt.

Aprašant projektu planuojamas spręsti problemas, projekto poreikį, įvertinama jo įtaka ir atitiktis horizontaliesiems principams: darnaus vystymosi, įskaitant reikšmingos žalos nedarymo principą; lygių galimybių (ypač moterų ekonominio įgalinimo), nediskriminavimo (dėl lyties, rasės, tautybės, pilietybės, kalbos, kilmės, socialinės padėties, tikėjimo, įsitikinimų ar pažiūrų, amžiaus, lytinės orientacijos, etninės priklausomybės, religijos, negalios (judėjimo, regos, klausos ir kt.) ar kt.), įskaitant prieinamumo visiems (paslaugų, infrastruktūros, fizinės ar e. aplinkos sprendimai, informacijos prieinamumo ir pan.) užtikrinimą; inovatyvumo (kūrybingumo) (vykdomi inovatyvūs viešieji pirkimai, taikomos naujos technologijos, kuriami ar diegiami inovatyvūs sprendimai ir pan.), bei projektų finansavimo sąlygų apraše (toliau – PFSA), o kai įgyvendinami RPPl projektai, – regioninės pažangos priemonės finansavimo gairėse (toliau – Gairės) ir RPPl nustatytų reikalavimų dėl atitinkamų Europos Sąjungos pagrindinių teisių chartijos nuostatų laikymosi. Jei sprendžiama problema turės tiesioginę įtaką horizontaliųjų principų įgyvendinimui, tai turi būti nurodyta ar įtraukta į projekto tikslą, tikslinę grupę, projekto veiklas ar siekiamus rezultatus.

Nurodoma, kurios iš visų įvardytų problemų bus sprendžiamos šalinant ar sumažinant jų atsiradimo priežastis.

Galimas simbolių skaičius – 10 000.

Nurodyti privaloma.

Projektu sprendžiamos mokslinės ir technologinės problemos optikos pramonėje. Konkretizuojant, pagaminant skanuojančios spektrometro prototipą ir ištiriant naujas optinių dangų matavimo galimybes, sukuriama intelektinė nuosavybė, kuri, numanoma, leis esmingai pagerinti optinių dangų charakterizavimą visoje optinių prietaisų vertės grandinėje. Tas turėtų vesti prie pagerėjusios prietaisų kokybės, didesnio ilgaamžiškumo ir tokiu būdu mažesnio poveikio aplinkai. Pagerėjęs technologinis lygis prisidės prie industrijos mokymosi ir padidins jos konkurencingumą. Tiesiogiai projekto metu bus sukurtas prototipas Vidurio Lietuvos regione (Kaune), kurio tolesnė gamyba prisidės prie gerai apmokamų ir kvalifikuotų darbo vietų kūrimo Lietuvos regionuose ir padidins jų ekonominį potencialą.
2.2. | Projekto tikslas

Nurodomas projekto tikslas.

Glaustai suformuluojamas projekto tikslas, aiškiai apibrėžiant pagrindinę projekto idėją, t. y. ko siekiama įgyvendinant projektą. Projekto tikslas – užtikrinti aktualios problemos sprendimą. Projektas gali turėti tik vieną tikslą.

Galimas simbolių skaičius – 1 000.

Projekto tikslas – sukurti naujas žinias, leisiančias praplėsti optinių dangų charakterizacimo galimybes sukuriant prietaiso prototipą ir naujus matavimo metodus, leisiančius pagerinti erdvinė dangų charakterizavimą, suvienodinti matavimo rezultatus matuojant skirtingais režimais ir palengvinti defektų aptikimą.
2.3. | Projekto tikslinė grupė

## Nustatoma (-os) projekto tikslinė (-ės) grupė (-s), kurią (-ias) tiesiogiai paveiks įgyvendinamas projektas. Detalizuojami tikslinės (-ių) grupės (-ių) poreikiai.

Galimas simbolių skaičius – 1 000.

Nurodyti privaloma.

Pirma projekto tikslinė grupė – optinių prietaisų vertės grandinėje dalyvaujančios įmonės. Detalizuojant, tai yra optinių dangų dengėjai, tokie, kaip UAB „Eksma Optics“, ar UAB „Optomenas“, optinių komponentų pardavėjai, tokie, kaip toliau naudojant lietuviškų įmonių pavyzdžius, „Altechna“, ir sistemų integratoriai. Galimybė geriau charakterizuoti optines dangas teigiamai veikia visą pramonės šaką per galimybę optimizuotis dangų procesus ir lokalizuoti problemas tiekimo grandinėje. Ne lazerinės optikos gamintojai, pardavėjai ir integratoriai, puslaidininkų metrologijos įmones taip pat išlošia iš galimybių sekti savo dangų senėjimą agresyviose aplinkose, pvz., esant aukštai apšvitai ultravioletine spinduliuote.
2.4. | Galimi teisiniai apribojimai

Nurodomas planuojamos vykdyti veiklos teisinis reglamentavimas, reikalavimai ir galimi apribojimai.

Šioje dalyje nurodomi tik tie specifiniai teisiniai apribojimai, kurie aktualūs konkrečiam projekto vykdytojui bei planuojamai vykdyti veiklai, pvz., reikalingi gauti leidimai, poveikio aplinkai vertinimai, atlikti įregistravimai ir pan.

Galimas simbolių skaičius – 2 000. Nurodyti privaloma.

Nėra
2.5. | Rezultatai (produkto stebėsenos rodiklis (-iai) ir (arba) rezultato stebėsenos rodiklis (-iai))

Nurodomi kokybinėmis ir kiekybinėmis reikšmėmis išreikšti minimalūs projektu siekiami rezultatai.

Stebėsenos rodiklio pavadinimas | Stebėsenos rodiklio kodas | Matavimo vienetas | Siektina reikšmė | Siektinos reikšmės pagrindimas

2.5.1. Produkto stebėsenos rodikliai

Nurodomas (DMS – pasirenkamas iš sąrašo, suformuojamo iš kvietimo teikti PĮP informacijos pagal veiklą (poveiklę)) bent vieno produkto stebėsenos rodiklio pavadinimas, atsižvelgiant į pažangos priemonės apraše nurodytus reikalavimus.

Galimas simbolių skaičius – 500.

Nurodomas (DMS – pasirenkamas iš sąrašo, suformuojamo iš kvietimo teikti PĮP informacijos pagal veiklą (poveiklę)) bent vieno produkto stebėsenos rodiklio numeris, atsižvelgiant į pažangos priemonės apraše nurodytus reikalavimus.

Galimas simbolių skaičius – 500.

Pasirinkus stebėsenos rodiklį, nurodomas jo matavimo vienetas, pvz., kilometrai (km), valandos (h) ir pan. Jei pildoma DMS, automatiškai nurodomas matavimo vienetas pagal stebėsenos rodikliui priskirtus duomenis.

Galimas simbolių skaičius – 20. Nurodyti privaloma, jeigu nurodytas produkto stebėsenos rodiklis.

Nurodoma siektina produkto stebėsenos rodiklio reikšmė, kurią planuojama pasiekti iki Lietuvos Respublikos finansų ministro tvirtinamame Stebėsenos rodiklių skaičiavimo apraše nurodyto pasiekimo momento (projekto veiklų vykdymo metu, projekto veiklų vykdymo pabaigoje, praėjus konkrečiam laikui po projekto įgyvendinimo pabaigos arba kitas momentas).

Galima įvesti tik skaičių.

Galimas simbolių skaičius – 12 simbolių iki kablelio ir 2 simboliai po kablelio. Nurodyti privaloma, jeigu pasirinktas produkto stebėsenos rodiklis.

Pateikiami siektinos reikšmės apskaičiavimo principai, kuriais remiantis būtų galima įsitikinti, kad siektina reikšmė reali ir bus pasiekta iki finansų ministro tvirtinamame Stebėsenos rodiklių skaičiavimo apraše nurodyto pasiekimo momento.

Nurodant šiuos principus, nepakanka pateikti nuorodos į kitame teisės akte ar strateginiame dokumente nustatytus įpareigojimus pasiekti vieną ar kitą stebėsenos rodiklio siektiną reikšmę; būtina nurodyti sąsajas su projekto loginiu pagrindimu (veiklomis, poveiklėmis, įkainiais), projekto tęstinumo laikotarpiu ar kita PĮP nurodyta informacija, kuri patvirtintų siektinos reikšmės pagrįstumą įgyvendinant projektą ar projekto tęstinumo laikotarpiu (kaip projekto įgyvendinimo pasekmė).

Jei nurodyta priemonės apraše, gali būti pateikiami stebėsenos rodiklio pasiekimo pagrindimo dokumentai.

Galimas simbolių skaičius – 2 000. Nurodyti privaloma, jeigu pasirinktas produkto stebėsenos rodiklis.
| 2.5.2. Rezultato stebėsenos rodikliai

Nurodomas (DMS – pasirenkamas iš sąrašo, suformuojamo iš kvietimo teikti PĮP informacijos pagal veiklą (poveiklę)) bent vieno rezultato stebėsenos rodiklio pavadinimas, atsižvelgiant į pažangos priemonės apraše nurodytus reikalavimus.

Galimas simbolių skaičius – 500

Nurodomas (DMS – pasirenkamas iš sąrašo, suformuojamo iš kvietimo teikti PĮP informacijos pagal veiklą (poveiklę)) bent vieno rezultato stebėsenos rodiklio numeris, atsižvelgiant į pažangos priemonės apraše nurodytus reikalavimus.

Pasirinkus procentais matuojamą stebėsenos rodiklį, taip pat automatiškai nurodomi bazinis ir pokyčio stebėsenos rodikliai.

Pasirinkus stebėsenos rodiklį, nurodomas jo matavimo vienetas, pvz., kilometrai (km), valandos (h) ir pan. Jei pildoma DMS, automatiškai nurodomas matavimo vienetas pagal stebėsenos rodikliui priskirtus duomenis. Galimas simbolių skaičius – 20. Nurodyti privaloma, jeigu pasirinktas rezultato stebėsenos rodiklis.

Nurodoma siektina rezultato stebėsenos rodiklio reikšmė, kurią planuojama pasiekti iki finansų ministro tvirtinamame Stebėsenos rodiklių skaičiavimo apraše nurodyto pasiekimo momento (projekto veiklų vykdymo metu, projekto veiklų vykdymo pabaigoje, praėjus konkrečiam laikui po projekto įgyvendinimo pabaigos arba kitas momentas).

Galima įvesti tik skaičių.

Galimas simbolių skaičius – 12 simbolių iki kablelio ir 2 simboliai po kablelio. Nurodyti privaloma, jeigu pasirinktas rezultato stebėsenos rodiklis.

Pateikiami siektinos reikšmės apskaičiavimo principai, kuriais remiantis galima būtų įsitikinti, kad siektina reikšmė reali ir bus pasiekta iki finansų ministro tvirtinamame Stebėsenos rodiklių skaičiavimo apraše nurodyto pasiekimo momento.

Nurodant šiuos principus, nepakanka pateikti nuorodos į kitame teisės akte ar strateginiame dokumente nustatytus įpareigojimus pasiekti vieną ar kitą stebėsenos rodiklio siektiną reikšmę; būtina nurodyti sąsajas su projekto loginiu pagrindimu (veiklomis, fiziniais rodikliais, biudžetu, įkainiais), projekto tęstinumo laikotarpiu ar kita PĮP nurodyta informacija, kuri patvirtintų siektinos reikšmės pagrįstumą įgyvendinant projektą ar projekto tęstinumo laikotarpiu (kaip projekto įgyvendinimo pasekmė).

Jei nurodyta priemonės apraše, gali būti pateikiami stebėsenos rodiklio pasiekimo pagrindimo dokumentai.

Galimas simbolių skaičius – 2 000. Nurodyti privaloma, jeigu pasirinktas rezultato stebėsenos rodiklis.

III SKYRIUS

PROJEKTO ĮGYVENDINIMO DETALIZACIJA

(pildoma rengiant visų tipų projektų įgyvendinimo planus)

3.1. Projekto veiklos (trukmė ir etapai)
Projekto įgyvendinimo laikotarpis | | | | | | | | | | Įrašomas planuojamas projekto įgyvendinimo laikotarpis mėnesių tikslumu nuo projekto sutarties pasirašymo dienos iki projekto veiklų vykdymo pabaigos, t. y. per kiek mėnesių pasirašius projekto sutartį bus pabaigtos vykdyti visos projekto veiklos. Galima įvesti tik skaičių. Galimas didžiausias skaičius – 120. Galimas simbolių skaičius – 3.
Nr. | Projekto veikla | | | | | | Pažangos priemonės veiklos (poveiklės) numeris | | | Tinkamų finansuoti išlaidų suma, eurais | | | | | | | | | | Pradėta iki projekto sutarties pasirašymo | Projekto sutarties mėnuo, kai pradedama vykdyti veikla | Projekto sutarties mėnuo, kai baigiama vykdyti veikla | | Regionas / Teisingos pertvarkos fondas (toliau – TPF)
| | | | | | | | | | Bendra suma, eurais | | | | | | Iš jos PVM, eurais

Nume-ris

nuro-domas iš eilės pvz., 1, 2, 3 ir kt.

Gali-mas sim-bolių skai-čius – 10.

Nuro-dyti priva-loma.

Nurodoma (DMS – pasirenkama) veikla iš kvietime teikti PĮP nurodytų finansuojamų projekto veiklų (pažangos priemonės veikla (poveiklė)). Kiekviena veikla nurodoma atskiroje eilutėje.

Projekto veiklos, finansuojamos iš skirtingų pažangos priemonių ir (ar) tos pačios pažangos priemonės skirtingų veiklų (poveiklių) lėšų, nurodomos atskirose eilutėse.

Galimas simbolių skaičius – 500. Nurodyti privaloma.

Nurodomas pažangos priemonės veiklos (poveiklės), pagal kurią numatoma vykdyti projekto veiklą, numeris.

DMS užpildoma automatiškai, pasirinkus projekto veiklą iš kvietime teikti PĮP nurodytų finansuojamų projekto veiklų, pagal jų sąsajas su priemonės veikla (poveikle). Galimas simbolių skaičius – 100. Nurodyti privaloma.

Nurodoma bendra projekto veiklos tinkamų finansuoti išlaidų suma, apskaičiuojama sudedant numatytas poveiklių tinkamų finansuoti išlaidų sumas.

Galimas simbolių skaičius – 9 simboliai iki kablelio ir 2 simboliai po kablelio.

Nurodyti privaloma.

Nurodoma bendra PVM suma, jei bent prie vienos poveiklės pažymėtas požymis „Prašoma finansuoti PVM“ arba „Mišrusis PVM“, susumuojant prie poveiklių nurodytas PVM sumas. Galimas simbolių skaičius – 9 simboliai iki kablelio ir 2 simboliai po kablelio.

Nurodoma, ar konkreti veikla (įskaitant reikiamus pirkimus) vykdoma arba planuojama pradėti vykdyti iki projekto sutarties pasirašymo. (Kai taikoma valstybės pagalba, turi būti atsižvelgiama į projektų finansavimo sąlygų apraše ar, kai planuojamas įgyvendinti RPPl projektas, Gairėse nustatytus reikalavimus dėl projekto veiklų vykdymo iki projekto sutarties pasirašymo.) Pasirenkama reikšmė iš pasirinkimo sąrašo – „Taip“ arba „Ne“.

Nurodyti privaloma.

Nurodomas projekto veiklos (įskaitant reikiamus pirkimus) vykdymo pradžios mėnesio eilės numeris, skaičiuojant nuo planuojamo projekto sutarties pasirašymo dienos. Nurodomas ne kalendorinis mėnuo, o projekto veiklos mėnuo, pvz., trečias veiklos mėnuo; penktas veiklos mėnuo (konkretus kalendorinis mėnuo bus nurodytas projekto sutartyje). Nurodomas skaičius nuo 1 iki 110.

Nurodyti privaloma.

Nurodomas projekto veiklos (įskaitant reikiamus pirkimus) vykdymo pabaigos mėnesio eilės numeris, skaičiuojant nuo planuojamo projekto sutarties pasirašymo dienos. Nurodomas ne kalendorinis mėnuo, o projekto veiklos mėnuo, pvz., trečias veiklos mėnuo; penktas veiklos mėnuo (konkretus kalendorinis mėnuo bus nurodytas projekto sutartyje). Nurodomas skaičius nuo 1 iki 110.

Nurodyti privaloma.

Nurodoma, kai projektas finansuoja-mas iš Europos regioninės plėtros fondo (toliau – ERPF), „Europos socialinio fondo +“ (toliau – ESF+) arba

TPF lėšų. Nurodo-mas konkretus regionas, (Sostinė ar Vidurio ir vakarų Lietuva). Jei projektas finansuo-jamas iš TPF lėšų, nurodoma apskritis.

Pildant DMS: jei kvietime projektams nustatytas konkretus regionas ir projektas nėra finansuoja-mas iš TPF lėšų, regionas nustatomas pagal kvietimo informaciją, laukas neaktyvus.

Jei kvietime nustatytas daugiau nei vienas galimas regionas, leidžiamas pasirinki-mas iš sąrašo (Sostinė, Vidurio ir vakarų Lietuva).

Jei kvietime teikti PĮP nustatoma, kad projektas finansuo-jamas iš TPF lėšų, pasirenka-ma viena iš apskričių.

Galimas simbolių skaičius – 100.

Nurodyti privaloma.
| Nr. | Poveiklės pavadinimas | | | | | Mata-vimo viene- tas | Siektina reikšmė | | | Tinkamų finansuoti išlaidų suma, eurais | | | | | | | | | Finansuojamoji dalis, proc. | Poveiklės aprašymas | Poreikio pagrindimas
| | | | | | | | | | | Bendra suma, eurais | PVM finan-savimo požymis | | PVM suma, eurais | | | Lietuvos Respubli-kos PVM įstatymo straipsnis

Nu-meris

nuro-domas iš eilės,

prade-dant veiklos Nr., pvz., 1.1, 1.2 ir kt.

Gali-mas sim-bolių skai-čius – 10.

Nu-ro-dyti pri-va-loma.

Nurodomas poveiklės pavadinimas. Poveiklė – kiekybiškai išmatuojamas tiesioginis įvykdytos projekto veiklos rezultatas. Poveikle nurodoma, kas bus pasiekta įvykdžius konkrečią projekto veiklą. Konkrečių projekto veiklų poveiklės gali nesutapti su projekto stebėsenos rodikliais. Vienai veiklai gali būti nurodoma keletas poveiklių, sukuriant naujas eilutes.

Galimas simbolių skaičius – 300.

Nurodyti privaloma.

Nurodo-mas po-veiklės mata-vimo- vienetas (nau-dojant visuo-tinai priimtus matavi-mo viene-tus, galima trum-pinti, pvz., vnt., kompl., asm., km. kv. m).

Galimas sim-bolių skaičius – 20.

Nuro-dyti priva-loma.

Nurodoma siekiama poveiklės rezultato reikšmė skaičiais.

Galimas simbolių skaičius – 9 simboliai iki kablelio ir 2 simboliai po kablelio.

Nurodyti privaloma.

Nurodoma bendra poveiklės tinkamų finansuoti išlaidų suma, apskai-čiuojama susumuo-jant numatytas veiksmų ar išlaidų tipų tinkamų finansuoti išlaidų sumas (jei projekto poveiklė skaidoma į veiksmų ar išlaidų tipus).

Galimas simbolių skaičius – 9 simboliai iki kablelio ir 2 simboliai po kablelio.

Nurodyti privaloma.

Pažy-mima, ar prašoma finansuoti PVM iš projekto lėšų.

☐ Prašoma finansuoti PVM

☐ Neprašoma finansuoti PVM

☐Miš-rusis PVM

Priva-lomas pažymėti laukas.

Jei pažymėtas požymis „Prašoma finansuoti PVM“ arba „Mišrusis PVM“, privaloma nurodyti bendrą poveiklės PVM sumą, apskai-čiuojamą susu-muojant numatytas veiksmų ar išlaidų tipų PVM sumas (jei projekto poveiklė skaidoma į veiksmų ar išlaidų tipus).

Galimas simbolių skaičius – 9 simbo-liai iki kablelio ir 2 simbo-liai po kablelio.

Jei pažymėtas požymis „Prašoma finansuoti PVM“ arba „Mišrusis PVM“, iš sąrašo pasirenka-mas vienas ar keli PVM įstatymo straipsniai, pagal kuriuos įgyvendi-nant projektą numatyti įsigyti darbai, prekės ar paslaugos priskiriami pareiškėjo arba partnerio PVM neapmo-

kestinamai veiklai.

Nurodomas procentinis santykis tarp prašomų skirti lėšų ir nuosavų lėšų.

Galimas simbolių skaičius – 3 simboliai iki kablelio ir 2 simboliai po kablelio.

Nurodyti privaloma.

Pateikiamas poveiklės aprašymas.

Galimas simbolių skaičius – 2 000.

Nurodyti privaloma.

Poveiklė detalizuojama, nurodomas jos būtinumo pagrindimas, prisidėjimas prie numatytų problemų sprendimo, planuojamų išlaidų poreikio apskaičiavimas ir pagrindimas.

Nurodyti privaloma, jeigu pagrindimas ir detalizavimas nurodomi prie veiksmų ar išlaidų tipų, šios dalies galima nepildyti.

Jei kartu su PĮP teikiamas projekto investicijų projektas, nurodoma investicijų projekto dalis, kurioje nurodyta informacija apie poveiklės poreikio pagrindimą.

Nurodoma, kokiai pareiškėjo arba partnerio vykdomai arba planuojamai vykdyti veiklai ar veiksmui bus skirti įgyvendinant projektą numatomi įsigyti darbai, prekės ar paslaugos. Būtina nurodyti veiklas, už kurias bus gaunamos pajamos (pvz., patalpų nuoma, teikiamos apmokamos paslaugos, rinkliavos ir pan.).

Galimas simbolių skaičius – 10 000.
| | Nr. | | | Veiksmo / išlaidų tipo pavadinimas | | Ma-tavimo viene-tas | Siektina reikšmė | | | Vieneto kaina, eurais | | | | Tinkamų finansuoti išlaidų suma, eurais | | | | | | Poreikio ir išlaidų pagrindimas | Požymiai
| | | | | | | | | | | | | | | Planuojama išlaidų suma, eurais | | | | Iš jos PVM, eurais

Nume-ris

nuro-domas iš ei-lės, prade-dant po-veik-lės Nr., pvz., 1.1.1, 1.1.2 ir kt.

Gali-mas sim-bolių skai-čius – 10.

Nuro-dyti priva-loma.

Nurodomas veiksmo ar išlaidų tipo pavadinimas. Nurodant veiksmus ar išlaidų tipus detalizuojama, kokių veiksmų bus imtasi arba kokiomis patiriamomis išlaidomis bus prisidedama siekiant projekto poveiklės siektinų reikšmių.

Vienai poveiklei gali būti nurodomi keli veiksmai ar išlaidų tipai, pridedant naujas eilutes.

Galimas simbolių skaičius – 300.

Nurodyti neprivaloma, jei kartu su PĮP teikiamas projekto investicijų projektas.

Nurodo-mas veiksmo ar išlaidų tipo mata-vimo- vienetas (nau-dojant visuo-tinai priimtus mata-vimo vie-netus, galima trum-pinti, pvz., vnt., kompl., asm., km, kv. m).

Galimas sim-bolių skaičius – 20.

Nuro-dyti priva-loma.

Nurodoma siekiama veiksmo ar išlaidų tipo rezultato reikšmė skaičiais.

Galimas simbolių skaičius – 9 simboliai iki kablelio ir 2 simboliai po kablelio.

Nurodyti privaloma.

Nurodoma vieneto kaina, kurią padauginus iš siektinos reikšmės būtų apskaičiuojama planuojama išlaidų suma.

Pildoma, kai planuojamai išlaidų sumai apskaičiuoti naudojama vieneto kaina.

Jei taikomi fiksuotieji projekto išlaidų vieneto įkainiai, fiksuotosios projekto išlaidų normos (toliau – fiksuotoji norma) arba fiksuotosios projekto išlaidų sumos (toliau – fiksuotoji suma), nurodomas konkretus veiksmui ar išlaidų tipui taikomas fiksuotasis dydis.

Galimas simbolių skaičius – 9 simboliai iki kablelio ir 2 simboliai po kablelio.

Nurodyti neprivaloma.

Nurodoma planuojama išlaidų suma, siektiną reikšmę padauginus iš vieneto kainos arba įrašant konkrečią planuojamų išlaidų sumą.

Galimas simbolių skaičius – 9 simboliai iki kablelio ir 2 simboliai po kablelio.

Nurodyti privaloma.

Nurodoma planuojama PVM suma, jeigu ją prašoma finansuoti iš projekto lėšų. Galimas simbolių skaičius – 9 simboliai iki kablelio ir 2 simboliai po kablelio.

Nurodyti neprivaloma.

Pateikiamas veiksmo ar išlaidų tipo detalizavi-mas, būtinumo pagrindimas, prisidėjimas prie numatytų problemų sprendimo, planuojamų išlaidų poreikio apskaičiavimas ir pagrindimas.

Galimas simbolių skaičius – 5 000.

Nurodyti privaloma.

Pažymima, jei numatomos išlaidos, atitinkančios bent vieną iš požymių:

žemės pirkimo išlaidos;

nepiniginis įnašas;

kryžminis finansavimas;

projektą vykdančio personalo išlaidos

(pažymima, tik jei nustatoma 15 ar 40 procentų fiksuotoji projekto išlaidų norma);

projektą vykdančio personalo išlaidos (apmokamos iš nuosavo įnašo);

dalyvių darbo užmokesčio (toliau – DU) išlaidos (finansuojamos);

dalyvių DU išlaidos (apmokamos iš nuosavo įnašo);

nusidėvėjimo sąnaudos (apmokamos iš nuosavo įnašo);

valstybės pagalba;

„de minimis“ pagalba.

Nuosavas įnašas negali būti mažesnis nei pažymėtų nusidėvėjimo sąnaudų (apmokamų iš nuosavo įnašo), dalyvių DU išlaidų (apmokamų iš nuosavo įnašo), projektą vykdančio personalo išlaidų (apmokamų iš nuosavo įnašo)

ir nepiniginio įnašo suma.

Galimas simbolių skaičius – 100.

Nurodyti neprivaloma.
Nr. | Projekto veikla | | | | | | Pažangos priemonės veiklos (poveiklės) numeris | | | | Tinkamų finansuoti išlaidų suma, eurais | | | | | | | | Pradėta iki projekto sutarties pasirašymo | | Projekto sutarties mėnuo, kai pradedama vykdyti veikla | Projekto sutarties mėnuo, kai baigiama vykdyti veikla | Regionas / TPF
| | | | | | | | | | | Bendra suma, eurais | | | | Iš jos PVM, eurais
| ... | | | | | | … | | | | ... | | | | ... | | | | … | | ... | ... | ...
| Nr. | Poveiklės pavadinimas | | | | | Mata-vimo vienetas | | Siektina reikšmė | | Tinkamų finansuoti išlaidų suma, eurais | | | | | | | | Finansuoja-moji dalis, proc. | | Poveiklės aprašymas | Poreikio pagrindimas
| | | | | | | | | | | Bendra suma, eurais | | PVM finan-savimo požymis | | PVM suma, eurais | | | PVM įstaty-mo straips-nis
| | ... | | | | | ... | | ... | | ... | | ... | | ... | | | ... | … | | … | …
| | Nr. | | Veiksmo / išlaidų tipo pavadinimas | | | Matavi-mo vienetas | | Siektina reikšmė | | Vieneto kaina, eurais | | | | Tinkamų finansuoti išlaidų suma, eurais | | | | | | Poreikio ir išlaidų pagrindimas | Požymiai
| | | | | | | | | | | | | | | Planuojama išlaidų suma, eurais | | | | Iš jos PVM, eurais
| | … | | ... | | | ... | | ... | | ... | | | | … | | | | ... | | … | ...
Projekto matomumo ir informavimo apie projektą priemonės | | | | | | | | | | | Tinkamų finansuoti išlaidų suma, eurais | | | | Iš jos PVM, eurais | | | | Aprašymas | | | Regionas / TPF

Nurodoma bendra tinkamų finansuoti išlaidų suma, skirta projekto matomumo ir informavimo apie projektą priemonėms finansuoti.

Galimas simbolių skaičius – 9 simboliai iki kablelio ir 2 simboliai po kablelio.

Nurodyti privaloma.

Nurodoma PVM suma, skirta projekto matomumo ir informavimo apie projektą priemonėms finansuoti, jeigu ją prašoma finansuoti iš projekto lėšų.

Galimas simbolių skaičius – 9 simboliai iki kablelio ir 2 simboliai po kablelio.

Nurodyti neprivalo-ma.

Pateikiamas matomumo ir informavimo priemonių aprašymas ir jų detalizavimas bei joms planuojamų tinkamų finansuoti išlaidų būtinumo pagrindimas. Pagrindinių matomumo ir informavimo priemonių (aprašymas interneto svetainėje (jei tokia yra); informacijos pateikimas socialiniuose tinkluose; informacijos skelbimas ne mažesniame kaip A3 formato plakate ir, kai projektas viršija 500 000 eurų, – nuolatinės informacinės lentelės ar stendo įrengimas) išlaidos pagrindžiamos nurodant pasirinktą fiksuotosios sumos dydį. Kitų matomumo ir informavimo priemonių bei strateginės svarbos projekto arba projekto, kurio visos išlaidos viršija 10 mln. eurų, viešinimo (komunikacinio renginio ar kitos komunikacijos veiklos) išlaidos pagrindžiamos remiantis planuojamomis patirti realiomis išlaidomis.

Galimas simbolių skaičius – 1 000.

Nurodyti privaloma.

Jei kvietime nurodytas daugiau nei vienas galimas regionas, leidžiamas pasirinkimas iš sąrašo (Sostinė, Vidurio ir vakarų Lietuva).

Jei kvietime teikti PĮP nustatoma, kad projektas finansuojamas iš TPF lėšų, pasirenkama viena iš apskričių.

Galimas simbolių skaičius – 100.

Nurodyti privaloma

Pažangos priemonės veiklos (poveiklės) numeris

Jei projektas įgyvendinamas pagal vieną pažangos priemonės veiklą (poveiklę), eilutė nepildoma (DMS paslėpta).

Nurodomas ar pasirenkamas iš pažangos priemonės veiklų (poveiklių), pagal kurias įgyvendinamas projektas, sąrašo, pažangos priemonės veiklos (poveiklės), pagal kurią įgyvendinama projekto matomumo ir informavimo apie projektą priemonė, numeris.

Galimas simbolių skaičius – 100. Nurodyti privaloma.

Nurodoma tinkamų finansuoti išlaidų suma, skirta projekto matomumo ir informavimo apie projektą priemonėms finansuoti, pagal skirtingas pažangos priemonės veiklas (poveikles). Kai skirtingos pažangos priemonės veiklos (poveiklės) finansuojamos iš 2021–2027 metų Europos Sąjungos fondų ir Ekonomikos gaivinimo ir atsparumo didinimo priemonės lėšų, išlaidų suma išskaidoma „pro rata“ principu.

Kai skirtingos pažangos priemonės veiklos (poveiklės) finansuojamos iš 2021–2027 metų Europos Sąjungos fondų arba Ekonomikos gaivinimo ir atsparumo didinimo priemonės lėšų ir Lietuvos Respublikos valstybės biudžeto lėšų, išlaidų suma priskiriama veiklai (poveiklei), finansuojamai iš 2021–2027 metų Europos Sąjungos fondų arba Ekonomikos gaivinimo ir atsparumo didinimo priemonės lėšų.

Galimas simbolių skaičius – 9 simboliai iki kablelio ir 2 simboliai po kablelio.

Nurodyti privaloma.

Nurodoma PVM suma, skirta projekto matomumo ir informavimo apie projektą priemonėms finansuoti, jeigu ją prašoma finansuoti iš projekto lėšų, pagal skirtingas pažangos priemonės veiklas (poveikles). Galimas simbolių skaičius – 9 simboliai iki kablelio ir 2 simboliai po kablelio.

Nurodyti neprivalo-ma.

Pateikiamas kiekvienos pažangos priemonės veiklos (poveiklės) matomumo ir informavimo priemonių aprašymas ir jų detalizavimas bei joms planuojamų tinkamų finansuoti išlaidų būtinumo pagrindimas. Privalomų matomumo ir informavimo priemonių išlaidos (išskyrus strateginės svarbos projektų ir projektų, kurių visos išlaidos viršija 10 mln. eurų, komunikacinio renginio ar kitos komunikacijos veiklos išlaidas) pagrindžiamos nurodant pasirinktą fiksuotosios sumos dydį ir nurodant pritaikytą „pro rata“ dydį. Kitų matomumo ir informavimo priemonių bei strateginės svarbos projektų ir projektų, kurių visos išlaidos viršija 10 mln. eurų, komunikacinio renginio ar kitos komunikacijos veiklos išlaidos pagrindžiamos remiantis planuojamomis patirti realiomis išlaidomis ir pritaikytu „pro rata“ dydžiu.

Galimas simbolių skaičius – 1 000.

Nurodyti privaloma.

Jei kvietime nurodytas daugiau nei vienas galimas regionas, leidžiamas pasirinkimas iš sąrašo (Sostinė, Vidurio ir vakarų Lietuva). Jei kvietime teikti PĮP nustatoma, kad projektas finansuojamas iš TPF lėšų, pasirenkama viena iš apskričių.

Galimas simbolių skaičius – 100.

Nurodyti privaloma.
Fiksuotoji norma, skirta netiesioginėms ir kitoms išlaidoms padengti | | | | | | Taikoma fiksuotoji norma, proc. | | | | | Tinkamų finansuoti išlaidų suma, eurais
| | | | | | | | | | | Bendra suma, eurais | | | | Iš jos PVM, eurais
Nurodomas (DMS pasirenkamas iš sąrašo) fiksuotosios normos, skirtos netiesioginėms ir kitoms išlaidoms padengti, pavadinimas ir kodas. Galimas simbolių skaičius – 300. | | | | | | Nurodomas pasirinktos fiksuotosios normos, skirtos netiesioginėms ir kitoms išlaidoms padengti, procentinis dydis. Galimas simbolių skaičius – 5. | | | | | Nurodoma pagal taikomą fiksuotąją normą, skirtą netiesioginėms ir kitoms išlaidoms padengti, apskaičiuota suma. Kai projekto veiklos (poveiklės) finansuojamos iš skirtingų pažangos priemonių ir (ar) tos pačios pažangos priemonės skirtingų veiklų (poveiklių) lėšų, apskaičiuojama bendra tiesioginių arba projektą vykdančio personalo išlaidų suma, kuri padauginama iš fiksuotosios normos, skirtos netiesioginėms ir kitoms išlaidoms padengti, dydžio. Galimas simbolių skaičius – 9 simboliai iki kablelio ir 2 simboliai po kablelio. | | | | Nurodoma PVM dalies suma, jeigu ją prašoma finansuoti iš projekto lėšų. Galimas simbolių skaičius – 9 simboliai iki kablelio ir 2 simboliai po kablelio.
Pažangos priemonės veiklos (poveiklės) numeris Jei fiksuotoji norma, skirta netiesioginėms ir kitoms išlaidoms padengti, finansuojama pagal kelias pažangos priemones ar pažangos priemonės veiklas (poveikles), nurodomas kiekvienos pažangos priemonės ar pažangos priemonės veiklos (poveiklės) numeris. Laukai nėra aktyvūs ir nėra spausdinami, o naudojami tik lėšoms pagal skirtingas pažangos priemones ar pažangos priemonės veiklas (poveikles) apskaičiuoti Europos Sąjungos investicijų administravimo informacinėje sistemoje (toliau – INVESTIS). Galimas simbolių skaičius – 100. | | | Nurodomas (DMS pasirenkamas iš sąrašo) fiksuotosios normos, skirtos netiesioginėms ir kitoms išlaidoms padengti, pavadinimas ir kodas. Galimas simbolių skaičius – 300. | | | Nurodomas pasirinktos fiksuotosios normos, skirtos netiesioginėms ir kitoms išlaidoms padengti, procentinis dydis. Galimas simbolių skaičius – 5. | | | | | Kai projekto veiklos finansuojamos iš skirtingų pažangos priemonių ir (ar) tos pačios pažangos priemonės skirtingų veiklų (poveiklių) lėšų, apskaičiuojama konkrečios pažangos priemonės ir (ar) tos pačios pažangos priemonės skirtingos veiklos (poveiklės) tiesioginių arba projektą vykdančio personalo išlaidų suma, kuri padauginama iš fiksuotosios normos, skirtos netiesioginėms ir kitoms išlaidoms padengti, dydžio. Galimas simbolių skaičius – 9 simboliai iki kablelio ir 2 simboliai po kablelio. | | | | Nurodoma PVM dalies suma, jeigu ją prašoma finansuoti iš projekto lėšų. Galimas simbolių skaičius – 9 simboliai iki kablelio ir 2 simboliai po kablelio.
Bendra projekto tinkamų finansuoti išlaidų suma, eurais: | | | | | | | | | | | Apskaičiuojama bendra projekto tinkamų finansuoti išlaidų suma (projekto veiklų tinkamų finansuoti išlaidų suma, projekto matomumo ir informavimo apie projektą priemonių tinkamų finansuoti išlaidų suma ir fiksuotosios normos, skirtos netiesioginėms ir kitoms išlaidoms padengti, tinkamų finansuoti išlaidų suma). Galimas simbolių skaičius – 9 simboliai iki kablelio ir 2 simboliai po kablelio. Nurodyti privaloma. | | | | Apskaičiuojama bendra projekto PVM suma, kurią prašoma finansuoti iš projekto lėšų. Galimas simbolių skaičius – 9 simboliai iki kablelio ir 2 simboliai po kablelio. Nurodyti neprivalo-ma.

3.1.1. Projekto požymiai, priskyrimas regionams (užpildoma automatiškai, kai PĮP teikiamas per DMS)
Požymis | Pažangos priemonės veiklos (poveiklės) numeris | Tinkamų finansuoti išlaidų suma, eurais

Nurodomi prie veiksmų ar išlaidų tipų pažymėti požymiai:

žemės pirkimo išlaidos;

nepiniginis įnašas;

kryžminis finansavimas;

projektą vykdančio personalo išlaidos;

projektą vykdančio personalo išlaidos (apmokamos iš nuosavo įnašo);

dalyvių DU išlaidos (finansuojamos);

dalyvių DU išlaidos (apmokamos iš nuosavo įnašo);

nusidėvėjimo sąnaudos (apmokamos iš nuosavo įnašo)

valstybės pagalba;

„de minimis“ pagalba.

Skaičiuojama ir tikrinama, ar nurodytų nusidėvėjimo sąnaudų (apmokamų iš nuosavo įnašo), dalyvių DU išlaidų (apmokamų iš nuosavo įnašo) ir nepiniginio įnašo požymių bendra suma neviršija nuosavo projekto vykdytojo ir partnerių įnašo sumos. Jei viršija, nusidėvėjimo sąnaudų (apmokamų iš nuosavo įnašo), dalyvių DU išlaidų (apmokamų iš nuosavo įnašo) ir nepiniginio įnašo požymių eilutės pažymimos raudonai ir rodomas klaidos pranešimas.

Jei pažymėtų požymių nėra, šios eilutės nepildomos.

Nurodyti privaloma, jei yra nustatyti požymiai.

Nurodomas pažangos priemonės veiklos (poveiklės), kuriai taikomas požymis, numeris.

Galimas simbolių skaičius – 100.

Nurodyti privaloma, jei prie veiksmų ar išlaidų tipų pažymėtas požymis.

Pagal veiksmų ar išlaidų tipų požymius apskaičiuojama požymio pagal vieną pažangos priemonės veiklą (poveiklę) tinkamų finansuoti išlaidų suma.

Galimas simbolių skaičius – 9 simboliai iki kablelio ir 2 simboliai po kablelio.

Nurodyti privaloma, jei prie veiksmų ar išlaidų tipų pažymėtas požymis.
Regionai / TPF | Pažangos priemonės veiklos (poveiklės) numeris | Tinkamų finansuoti išlaidų suma, eurais
Nurodomi prie projekto veiklų nurodyti regionai ar apskritys (Sostinė, Vidurio ir vakarų Lietuva, apskritis). Nurodyti privaloma. | Nurodomas pažangos priemonės veiklos (poveiklės), pagal kurią nustatytas regionas ir apskritys, numeris. Galimas simbolių skaičius – 100. | Pagal projekto veiklų regionus ir apskritis apskaičiuojama regiono ar TPF lėšomis pagal apskritis pagal vieną pažangos priemonės veiklą (poveiklę) tinkamų finansuoti išlaidų suma. Galimas simbolių skaičius – 9 simboliai iki kablelio ir 2 simboliai po kablelio. Nurodyti privaloma.
☐ Investicijos priskiriamos regionui taikant „pro rata“ principą Pažymima, kai projektas finansuojamas ERPF arba ESF+ lėšomis, investicijų sukuriama nauda atitenka daugiau nei vienam 2021–2027 metų Europos Sąjungos fondų investicijų programos (toliau – Investicijų programa) regionui ir projekto įgyvendinimo metu nebus galima nustatyti, kiek kuriam Investicijų programos regionui faktiškai teks naudos iš investicijų. Remiantis „pro rata“ dydžiu skaičiuojamos projekto veikloms vykdyti skiriamos lėšos ir siektini rodikliai. | Nurodomos projekto veiklos, kurioms taikomas „pro rata“ dydis, ir joms tenkanti procentinė dalis.

3.2. | Finansavimo šaltiniai

1. Pažangos priemonės veiklos (poveiklės) numeris | 2. Prašomos skirti lėšos | | 3. Nuosavas įnašas | | | | | | 4. Iš viso lėšų
| | | 3.1. Nacionalinės viešosios lėšos | | | 3.2. Privačios lėšos | | Proc.
| Prašomas finansavimas | Proc. | 3.1.1. Valstybės biudžeto lėšos | 3.1.2. Savivaldybės biudžeto lėšos | 3.1.3 Kiti viešųjų lėšų šaltiniai | 3.2.1. Pareiškėjo, partnerio (-ių) ir (ar) jungtinio projekto projekto pareiškėjo (-ų) lėšos | 3.2.2. Kiti lėšų šaltiniai
Iš viso | Apskaičiuojama stulpelio suma. | Apskaičiuo-jama procentinė dalis nuo bendros sumos (2 stulpelyje nurodytos sumos santykis su 4 stulpelyje nurodyta bendra suma). | Apskaičiuojama stulpelio suma. | Apskaičiuo-jama stulpelio suma. | Apskaičiuojama stulpelio suma. | Apskaičiuojama stulpelio suma. | Apskaičiuojama stulpelio suma. | Apskaičiuo-jama procentinė dalis nuo bendros sumos (3.1, 3.2 stulpeliuose nurodytų lėšų sumos santykis su 4 stulpelyje nurodyta suma). | Apskaičiuo-jama stulpelio suma.
Nurodomas pažangos priemonės veiklos (poveiklės) numeris. Jei projekto veiklos finansuoja-mos iš skirtingų pažangos priemonių ir (ar) tos pačios pažangos priemonės skirtingų veiklų (poveiklių) lėšų, jos nurodomos atskirose eilutėse. Galimas simbolių skaičius – 100. Nurodyti privaloma. | Nurodoma prašoma skirti projekto finansavimo lėšų suma. Galima įvesti tik skaičių. Įvedus raides, rodomas klaidos pranešimas. Nurodyti privaloma. Galimas simbolių skaičius – 9 simboliai iki kablelio ir 2 simboliai po kablelio. | Apskaičiuo-jama procentinė dalis nuo bendros sumos (2 stulpelyje nurodytos sumos santykis su 4 stulpelyje nurodyta bendra suma). | Nurodoma lėšų suma, kurią užtikrins pareiškėjas, partneris (-iai) ir (ar) jungtinio projekto projekto pareiškėjas ir kurios šaltinis yra valstybės biudžeto lėšos. Galima įvesti tik skaičių. Galimas simbolių skaičius – 9 simboliai iki kablelio ir 2 simboliai po kablelio. | Nurodoma lėšų suma, kurią užtikrins pareiškėjas, partneris (-iai) ir (ar) jungtinio projekto projekto pareiškėjas ir kurios šaltinis yra savivaldybių biudžetų lėšos. Galima įvesti tik skaičių. Galimas simbolių skaičius – 9 simboliai iki kablelio ir 2 simboliai po kablelio. | Nurodoma lėšų suma, kurią užtikrins pareiškėjas, partneris (-iai) ir (ar) jungtinio projekto projekto pareiškėjas ir kurios šaltinis yra kiti viešųjų lėšų šaltiniai. Galima įvesti tik skaičių. Galimas simbolių skaičius – 9 simboliai iki kablelio ir 2 simboliai po kablelio. | Nurodoma pareiškėjo, partnerio (-ių) ir (ar) jungtinio projekto projekto pareiškėjo lėšų, kurios nėra viešosios lėšos, suma, kurią užtikrins pareiškėjas. Galima įvesti tik skaičių. Galimas simbolių skaičius – 9 simboliai iki kablelio ir 2 simboliai po kablelio. | Nurodoma lėšų suma, kurią užtikrins pareiškė-jas, partneris (-iai) ir (ar) jungtinio projekto projekto pareiš-kėjas ir kurios šaltinis yra kiti lėšų šaltiniai, pvz., banko paskola. Galima įvesti tik skaičių. Galimas simbolių skaičius – 9 simboliai iki kablelio ir 2 simboliai po kablelio. | Apskaičiuo-jama procentinė dalis nuo bendros sumos (3.1, 3.2 stulpeliuose nurodytų lėšų sumos santykis su 4 stulpelyje nurodyta bendra suma). | Nurodoma bendra projekto tinkamų finansuoti išlaidų suma (apskaičiuo-jama 2, 3.1, 3.2 stulpeliuose nurodytų lėšų suma). Ši suma turi sutapti su bendra projekto tinkamų finansuoti išlaidų suma, nurodyta PĮP 3.1 papunktyje „Projekto veiklos (trukmė ir etapai)“. Jei sumos nesutampa, finansavimo šaltinių eilutė „Iš viso“ pažymima raudonai ir rodomas klaidos pranešimas.
3.3. | Teritorija, kuriai tenka didžioji dalis projekto lėšų (didžiausia projekto lėšų dalis skaičiuojama pagal skiriamų lėšų dydį).

Regionas | Apskritis | Savivaldybė
- Vidurio ir vakarų Lietuva. | Kauno apskritis | Kauno miesto savivaldybė
3.4. | Kita (-os) apskritis (-ys) ir savivaldybė (-ės), kuriai (-ioms) tenka dalis projekto lėšų (šis papunktis nežymimas, jei projektas įgyvendinamas vienoje savivaldybėje)

Apskritis (-ys) | Nurodoma kita (-os) apskritis (-ys), kuriai (-ioms) tenka dalis projekto lėšų. Jei pildoma DMS, paspaudus ant apskrities įvedimo lauko, dešiniajame šone atsiras rodyklė. Paspaudus ją, išsiskleis pasirinkimo sąrašas. Iš sąrašo pasirenkamas apskrities pavadinimas. Jei reikia pridėti daugiau nei vieną apskritį, spaudžiama „pridėti dar vieną apskritį“.

Savivaldybė (-ės):

Nurodoma kita (-os) savivaldybė (-ės), kuriai (-ioms) tenka dalis projekto lėšų.

Jei pildoma DMS, pasirenkama iš variantų:

- Visos savivaldybės apskrityje. Šis pasirinkimas žymimas, jei dalis projekto lėšų tenka visoms apskrityje esančioms savivaldybėms. Pažymėjus „Visos savivaldybės apskrityje“, skiltyje „Nurodytos savivaldybės“ nurodomos pasirinktos apskrities visos savivaldybės.

- Konkreti savivaldybė. Šiame lauke pažymimos pasirinktos savivaldybės (pasirenkama iš sąrašo) pagal pasirinktas apskritis. Galima pasirinkti daugiau nei vieną savivaldybę:

Akmenės rajono Alytaus miesto Alytaus rajono Anykščių rajono Birštono Biržų rajono Druskininkų Elektrėnų Ignalinos rajono Jonavos rajono Joniškio rajono Jurbarko rajono Kaišiadorių rajono Kalvarijos Kauno miesto | Kauno rajono Kazlų Rūdos Kėdainių rajono Kelmės rajono Klaipėdos miesto Klaipėdos rajono Kretingos rajono Kupiškio rajono Lazdijų rajono Marijampolės Mažeikių rajono Molėtų rajono Neringos Pagėgių Pakruojo rajono | Palangos miesto Panevėžio miesto Panevėžio rajono Pasvalio rajono Plungės rajono Prienų rajono Radviliškio rajono Raseinių rajono Rietavo Rokiškio rajono Skuodo rajono Šakių rajono Šalčininkų rajono Šiaulių miesto Šiaulių rajono | Šilalės rajono Šilutės rajono Širvintų rajono Švenčionių rajono Tauragės rajono Telšių rajono Trakų rajono Ukmergės rajono Utenos rajono Varėnos rajono Vilkaviškio rajono Vilniaus miesto Vilniaus rajono Visagino miesto Zarasų rajono
3.5. | Projekto komanda

Pareigos įgyvendinant projektą | Vardas, pavardė | Struktūrinio padalinio pavadinimas, pareigų pavadinimas | Funkcijos ir atsakomybės

Projekto komanda:
Projekto vadovas
Komandos narys
Komandos narys
3.6. | Partneris (-iai)

Šioje dalyje nurodomi partneriai, jei tokie yra: turi būti pagrįstas partnerių pasirinkimas, partnerystės priežastis ir forma, aprašyta, kaip bus dalijamasi atsakomybe įgyvendinant projektą, kokia bus kiekvieno partnerio veikla, kam teks projekto rezultatai ir kas bus atsakingas už tinkamą projekto rezultatų naudojimą ir išsaugojimą.
3.7. | Matomumas ir informavimas

(Pareiškėjas privalo pasirinkti įgyvendinti projekto matomumo ir informavimo apie projektą priemones, kaip nustatyta finansų ministro tvirtinamų Projektų administravimo ir finansavimo taisyklių VIII skyriaus pirmajame skirsnyje ir kvietime teikti PĮP).

Projekto matomumo ir informavimo apie projektą priemonė (-ės) | Taikoma | Aprašymas

3.7.1. Projekto aprašymas pagrindinėje interneto svetainėje (jei tokia yra). Terminas ‒ 20 darbo dienų nuo projekto sutarties pasirašymo dienos.

☐

Žymima „Taikoma“, jei projekto vykdytojas, partneris, jungtinio projekto (toliau – JP) projekto vykdytojas turi interneto svetainę. Nurodomas interneto svetainės ar konkretaus tinklalapio adresas (nuoroda) ir trumpas šios projekto matomumo ir informavimo apie projektą priemonės aprašymas. Per 20 darbo dienų nuo projekto sutarties pasirašymo ar nuo informacijos dėl paraiškos finansuoti JP projektą patvirtinimo gavimo dienos pagrindinėje projekto vykdytojo, partnerio, JP projekto vykdytojo interneto svetainėje (jeigu yra) skelbiamas projekto aprašymas, apibūdinant projektu sprendžiamą problemą ir projekto tikslą, aprašant suplanuotas projekto veiklas (poveikles), pristatant suplanuotus rezultatus ir informuojant apie Europos Sąjungos finansavimą.

Šalia projekto aprašymo pateikiama spalvota (jei tokios techninės galimybės yra) Europos Sąjungos emblema su šalia emblemos rašomu teiginiu „Finansuoja Europos Sąjunga“ (kai projektas100 procentų finansuojamas 2021–2027 metų Europos Sąjungos fondų lėšomis) arba „Bendrai finansuoja Europos Sąjunga“ (kai projektas ne 100 procentų finansuojamas 2021–2027 metų Europos Sąjungos fondų lėšomis), arba „Finansuoja Europos Sąjunga NextGenerationEU“ (kai projektas finansuojamas 2021–2027 metų Europos Sąjungos fondų lėšomis ir Ekonomikos gaivinimo ir atsparumo didinimo priemonės lėšomis arba Ekonomikos gaivinimo ir atsparumo didinimo priemonės lėšomis).

Projekto aprašymas interneto svetainėje ar tinklalapyje turi būti aiškiai matomas bent iki projekto pabaigos dienos (ilgalaikiam matomumui užtikrinti naujienų rubrika projekto aprašymui skelbti nėra tinkama). Projekto aprašymas turi būti pateiktas svetainės ar tinklalapio lange (pvz., PDF formato dokumento nuoroda nėra tinkama, nebent dėl techninių tinklalapio apribojimų toks aprašymo skelbimas būtų vienintelė išeitis).

Galimas simbolių skaičius – 300. Nurodyti privaloma, jei pažymėta „Taikoma“.

3.7.2. Projekto viešinimas socialiniuose tinkluose. Terminas ‒ 20 darbo dienų nuo projekto sutarties pasirašymo dienos

☐

Pasirinkus „Taikoma“ nurodomas socialinio tinklo (ar tinklų) pavadinimas, konkrečios paskyros pavadinimas (jei jau žinomas), pateikiama konkreti nuoroda (jei jau žinoma) ir trumpas šios matomumo ir informavimo priemonės aprašymas.

Priemonė turi būti įgyvendinta per 20 darbo dienų nuo projekto sutarties pasirašymo ar nuo informacijos dėl paraiškos finansuoti JP projektą patvirtinimo gavimo dienos.

Tikslinė auditorija turi būti informuota apie Europos Sąjungos finansavimą nurodant visą pavadinimą „Europos Sąjunga“, kai naudojamas finansavimo šaltinį nurodantis atitinkamas teiginys „Finansuoja Europos Sąjunga“ (kai projektas 100 procentų finansuojamas 2021–2027 metų Europos Sąjungos fondų lėšomis) arba „Bendrai finansuoja Europos Sąjunga“ (kai projektas ne 100 procentų finansuojamas 2021–2027 metų Europos Sąjungos fondų lėšomis), arba „Finansuoja Europos Sąjunga NextGenerationEU“ (kai projektas finansuojamas 2021–2027 metų Europos Sąjungos fondų lėšomis ir Ekonomikos gaivinimo ir atsparumo didinimo priemonės lėšomis arba Ekonomikos gaivinimo ir atsparumo didinimo priemonės lėšomis). Jei techninės galimybės leidžia, šalia atitinkamo teiginio turi būti panaudota spalvota ES emblema.

Galimas simbolių skaičius – 300. Nurodyti privaloma, jei pažymėta „Taikoma“.

3.7.3. Projekto plakato (ne mažesnio kaip A3 formato) iškabinimas matomoje vietoje. Terminas ‒ 20 darbo dienų nuo projekto sutarties pasirašymo dienos (arba taikoma PĮP 3.7.4 papunktyje nurodyta projekto matomumo ir informavimo apie projektą priemonė).

☐

Pasirinkus „Taikoma“, nurodomas vietos, kurioje bus iškabintas neskaitmeninis plakatas, adresas ir pateikiamas trumpas šios projekto matomumo ir informavimo apie projektą priemonės aprašymas. Per 20 darbo dienų nuo projekto sutarties pasirašymovisuomenei gerai matomoje vietoje (pvz., prie įėjimo į pastatą ar organizacijos vestibiulyje) reikia pakabinti bent vieną spausdintą ne mažesnį nei A3 formato pranešimą (plakatą), kuriame pateikiama informacija apie projektą (įtraukiant projekto pavadinimo santrumpą, projekto tikslą ir planuojamas veiklas (poveikles) bei rezultatus) ir paskelbiama apie Europos Sąjungos finansavimą.

Šis reikalavimas netaikomas ESF+ lėšomis finansuojamiems projektams, kai projektu siekiama konkretaus ESF+ tikslo – mažinti materialinį nepriteklių, pačiomis nepalankiausiomis sąlygomis gyvenantiems asmenims teikiant pagalbą maistu ir (arba) pagrindinę materialinę pagalbą, įskaitant papildomas priemones.

Plakato turinyje turi būti pateikiama spalvota (jei tokia techninė galimybė yra) Europos Sąjungos emblema su teiginiu „Finansuoja Europos Sąjunga“ (kai projektas 100 procentų finansuojamas 2021–2027 metų Europos Sąjungos fondų lėšomis) arba „Bendrai finansuoja Europos Sąjunga“ (kai projektas ne 100 procentų finansuojamas 2021–2027 metų Europos Sąjungos fondų lėšomis), arba „Finansuoja Europos Sąjunga NextGenerationEU“ (kai projektas finansuojamas 2021‒2027 metų Europos Sąjungos fondų lėšomis ir Ekonomikos gaivinimo ir atsparumo didinimo priemonės lėšomis arba Ekonomikos gaivinimo ir atsparumo didinimo priemonės lėšomis).

Projekto plakatas turi būti aiškiai matomas bent iki projekto užbaigimo dienos.

Galimas simbolių skaičius – 300. Nurodyti privaloma, jei pažymėta „Taikoma“.

3.7.4. Projekto pristatymas skaitmeniniame ekrane (ne mažesniame kaip A3 formato) matomoje vietoje. Terminas ‒ 20 darbo dienų nuo projekto sutarties pasirašymo dienos (arba taikoma PĮP 3.7.3 papunktyje nurodyta projekto matomumo ir informavimo apie projektą priemonė).

☐

Pasirinkus „Taikoma“, nurodomas vietos, kurioje bus pakabintas skaitmeninis ekranas, adresas ir pateikiamas trumpas šios projekto matomumo ir informavimo apie projektą priemonės aprašymas. Per 20 darbo dienų nuo projekto sutarties pasirašymovisuomenei gerai matomoje vietoje (pvz., prie įėjimo į pastatą ar organizacijos vestibiulyje) reikia pakabinti ar skelbti bent vieną rodomą elektroninį ne mažesnį nei A3 formato pranešimą, kuriame pateikiama informacija apie projektą (įtraukiant projekto pavadinimo santrumpą, projekto tikslą ir planuojamas veiklas (poveikles) bei rezultatus) ir paskelbiama apie Europos Sąjungos finansavimą.

Šis reikalavimas netaikomas ESF+ lėšomis finansuojamiems projektams, kai projektu siekiama konkretaus ESF+ tikslo – mažinti materialinį nepriteklių, pačiomis nepalankiausiomis sąlygomis gyvenantiems asmenims teikiant pagalbą maistu ir (arba) pagrindinę materialinę pagalbą, įskaitant papildomas priemones.

Pranešimo turinyje turi būti pateikiama spalvota (jei tokia techninė galimybė yra) Europos Sąjungos emblema su teiginiu „Finansuoja Europos Sąjunga“ (kai projektas 100 procentų finansuojamas 2021–2027 metų Europos Sąjungos fondų lėšomis) arba „Bendrai finansuoja Europos Sąjunga“ (kai projektas ne 100 procentų finansuojamas 2021–2027 metų Europos Sąjungos fondų lėšomis), arba „Finansuoja Europos Sąjunga NextGenerationEU“ (kai projektas finansuojamas 2021‒2027 metų Europos Sąjungos fondų lėšomis ir Ekonomikos gaivinimo ir atsparumo didinimo priemonės lėšomis arba Ekonomikos gaivinimo ir atsparumo didinimo priemonės lėšomis).

Pranešimas apie projektą skaitmeniniame ekrane turi būti aiškiai matomas ir rodomas bent iki projekto užbaigimo dienos.

Galimas simbolių skaičius – 300. Nurodyti privaloma, jei pažymėta „Taikoma“.

3.7.5. Nuolatinės informacinės lentelės pakabinimas matomoje vietoje. Terminas ‒ kai tik fizinių (materialių) investicijų projekto veikla pradedama vykdyti ar sumontuojama ir pakabinama nupirkta įranga (ir (arba) taikoma PĮP 3.7.6 papunktyje nurodyta projekto matomumo ir informavimo apie projektą priemonė).

☐

Privaloma pažymėti „Taikoma“, jei projektas finansuojamas:

a) ERPF, Sanglaudos fondo ar Ekonomikos gaivinimo ir atsparumo didinimo priemonės lėšomis ir jo visos išlaidos viršija 500 000 eurų (netaikomi PĮP 3.7.3 ir 3.7.4 papunkčiuose nurodyti reikalavimai);

b) ESF+ lėšomis ir jo visos išlaidos viršija 100 000 eurų (netaikomi PĮP 3.7.3 ir 3.7.4 papunkčiuose nurodyti reikalavimai).

Kai tik projektas, susijęs su fizinėmis (materialiomis) investicijomis, pradedamas įgyvendinti arba sumontuojama nupirkta įranga, visuomenei gerai matomoje vietoje pakabinama patvari, nuolatinė informacinė lentelė, kurioje pateikiama informacija apie projektą, įtraukiant projekto pavadinimo santrumpą, projekto tikslą ir pateikiant spalvotą (jei techninės galimybės leidžia) Europos Sąjungos emblemą su teiginiu „Finansuoja Europos Sąjunga“ (kai projektas100 procentų finansuojamas 2021–2027 metų Europos Sąjungos fondų lėšomis) arba „Bendrai finansuoja Europos Sąjunga“ (kai projektas ne 100 procentų finansuojamas 2021–2027 metų Europos Sąjungos fondų lėšomis), arba „Finansuoja Europos Sąjunga NextGenerationEU“ (kai projektas finansuojamas 2021–2027 metų Europos Sąjungos fondų lėšomis ir Ekonomikos gaivinimo ir atsparumo didinimo priemonės lėšomis arba Ekonomikos gaivinimo ir atsparumo didinimo priemonės lėšomis).

Pateikiamas trumpas šios projekto matomumo ir informavimo apie projektą priemonės aprašymas.

Galimas simbolių skaičius – 300. Nurodyti privaloma, jei pažymėta „Taikoma“.

3.7.6. Nuolatinio informacinio stendo pastatymas matomoje vietoje. Terminas ‒ kai tik fizinių (materialių) investicijų projekto veikla pradedama vykdyti ar sumontuojama nupirkta įranga (ir (arba) taikoma PĮP 3.7.5 papunktyje nurodyta projekto matomumo ir informavimo apie projektą priemonė).

☐

Privaloma pažymėti „Taikoma“ jeigu projektas finansuojamas:

a) ERPF, Sanglaudos fondo ar Ekonomikos gaivinimo ir atsparumo didinimo priemonės lėšomis ir jo visos išlaidos viršija 500 000 eurų (netaikomi PĮP 3.7.3 ir 3.7.4 papunkčiuose nurodyti reikalavimai);

b) ESF+ lėšomis ir jo visos išlaidos viršija 100 000 eurų (netaikomi PĮP 3.7.3 ir 3.7.4 papunkčiuose nurodyti reikalavimai).

Kai tik projektas, susijęs su fizinėmis (materialiomis) investicijomis, pradedamas įgyvendinti arba sumontuojama nupirkta įranga, visuomenei gerai matomoje vietoje pastatomas patvarus nuolatinis informacinis stendas, kuriame pateikiama informacija apie projektą, įtraukiant projekto pavadinimo santrumpą, projekto tikslą ir pateikiant spalvotą (jei techninės galimybės leidžia) Europos Sąjungos emblemą su teiginiu „Finansuoja Europos Sąjunga“ (kai projektas 100 procentų finansuojamas 2021–2027 metų Europos Sąjungos fondų lėšomis) arba „Bendrai finansuoja Europos Sąjunga“ (kai projektas ne 100 procentų finansuojamas 2021–2027 metų Europos Sąjungos fondų lėšomis), arba „Finansuoja Europos Sąjunga NextGenerationEU“ (kai projektas finansuojamas 2021‒2027 metų Europos Sąjungos fondų lėšomis ir Ekonomikos gaivinimo ir atsparumo didinimo priemonės lėšomis arba Ekonomikos gaivinimo ir atsparumo didinimo priemonės lėšomis).

Pateikiamas trumpas šios projekto matomumo ir informavimo apie projektą priemonės aprašymas.

Galimas simbolių skaičius – 300. Nurodyti privaloma, jei pažymėta „Taikoma“.
3.7.7. Strateginės svarbos projekto komunikacinio renginio organizavimas ar kitos komunikacinės veiklos vykdymas (arba taikoma PĮP 3.7.8 papunktyje nurodyta projekto matomumo ir informavimo apie projektą priemonė). | ☐ | Žymima „Taikoma“, kai projektas yra strateginės svarbos. Įgyvendinant strateginės svarbos projektą, nepriklausomai nuo jo vertės, privaloma surengti komunikacinį renginį ar įvykdyti kitą komunikacijos veiklą, laiku (rekomenduojama prieš 2–3 mėnesius) įtraukiant Europos Komisijos ir vadovaujančiosios institucijos atstovus. Pateikiamas trumpas šios projekto matomumo ir informavimo apie projektą priemonės aprašymas. Galimas simbolių skaičius – 300. Nurodyti privaloma, jei pažymėta „Taikoma“.
3.7.8. Projekto, kurio bendra vertė viršija 10 000 000 eurų, komunikacinio renginio organizavimas ar kitos komunikacijos veiklos vykdymas (arba taikoma PĮP 3.7.7 papunktyje nurodyta projekto matomumo ir informavimo apie projektą priemonė). | ☐ | Žymima „Taikoma“ įgyvendinant projektą, kurio bendra vertė viršija 10 000 000 eurų. Įgyvendinant projektą, kurio visos išlaidos viršija 10 000 000 eurų, privaloma surengti komunikacinį renginį ar įvykdyti kitą komunikacijos veiklą, laiku (rekomenduojama prieš 2–3 mėnesius) įtraukiant Europos Komisijos ir vadovaujančiosios institucijos atstovus. Pateikiamas trumpas šios projekto matomumo ir informavimo apie projektą priemonės aprašymas. Galimas simbolių skaičius – 300. Nurodyti privaloma, jei pažymėta „Taikoma“.

3.7.9. Tinkamas, naudojant Europos Sąjungos emblemą ir nurodant atitinkamą teiginį, komunikavimas apie tai, kad finansuojama Europos Sąjungos lėšomis, visose komunikacijos priemonėse ir tikslinei auditorijai skirtuose dokumentuose.

☐

Žymima „Taikoma“, kai vykdomos kitos projekto matomumo ir informavimo apie projektą (veiklą ar poveiklę) komunikacijos veiklos (pvz., straipsnyje internete apie projekto problemą ir jos sprendimo būdus paminimas projektas ir minimas to projekto finansavimo šaltinis panaudojant Europos Sąjungos emblemą su atitinkamu teiginiu arba organizuojamas seminaras ir seminaro dalyviams skirtoje renginio programoje panaudojama Europos Sąjungos emblema ir šalia jos nurodomas atitinkamas teiginys).

Visose komunikavimo priemonėse, susijusiose su projektu, ir tikslinei auditorijai (visuomenė; projekto dalyviai ir kt.) skirtuose dokumentuose (seminaro programoje arba dalyvių registracijos sąraše; seminaro dalyvio pažymėjime; galutinėje vertinimo ataskaitoje ir kt.) turi būti komunikuojamas Europos Sąjungos finansavimas (t. y. naudojama Europos Sąjungos emblema ir nurodomas atitinkamas teiginys).

Dokumentuose ar kitoje medžiagoje, naudojamoje išorinės komunikacijos veiklose, renginiuose, susijusiuose su projekto įgyvendinimu, įtraukiant visuomenę, kitą tikslinę auditoriją ar konkrečius dalyvius, kuriems projekto veiklos turės poveikį, ir nepažeidžiant lygių galimybių visiems ir nediskriminavimo principo, aiškiai pateikiama informacija apie Europos Sąjungos finansavimą, naudojant Europos Sąjungos emblemą ir šalia jos nurodant teiginį „Finansuoja Europos Sąjunga“ (kai projektas 100 procentų finansuojamas 2021–2027 metų Europos Sąjungos fondų lėšomis) arba „Bendrai finansuoja Europos Sąjunga“ (kai projektas ne 100 procentų finansuojamas 2021–2027 metų Europos Sąjungos fondų lėšomis), arba „Finansuoja Europos Sąjunga NextGenerationEU“ (kai projektas finansuojamas 2021‒2027 metų Europos Sąjungos fondų lėšomis ir Ekonomikos gaivinimo ir atsparumo didinimo priemonės lėšomis arba Ekonomikos gaivinimo ir atsparumo didinimo priemonės lėšomis).

Pateikiamas trumpas šios projekto matomumo ir informavimo apie projektą priemonės aprašymas.

Galimas simbolių skaičius – 300. Nurodyti privaloma, jei pažymėta „Taikoma“.
3.7.10. Kitų komunikacinių, informacinių, Europos Sąjungos finansavimo matomumą ir skaidrumą didinančių veiklų vykdymas (papildoma priemonė). | ☐ | Prireikus nurodomos kitos projekto vykdytojo pasirinktos vykdyti papildomos projekto matomumo ir informavimo apie projektą veiklos, nurodytos priemonės apraše. Gali būti sukurtos papildomos eilutės, jeigu numatoma daugiau nei viena projekto matomumo ir informavimo apie projektą veikla. Galimas simbolių skaičius – 300. Pateikiamas trumpas šios papildomos projekto matomumo ir informavimo apie projektą priemonės aprašymas. Galimas simbolių skaičius – 300.
3.8. | Horizontalieji principai (toliau – HP) ir Europos Sąjungos pagrindinių teisių chartijos (toliau – Chartija) nuostatos

3.8.1. Projekto įgyvendinimo metu nepažeidžiami HP

HP – darnaus vystymosi, įskaitant reikšmingos žalos nedarymo principą, lygių galimybių ir nediskriminavimo (dėl lyties, rasės, tautybės, pilietybės, kalbos, kilmės, socialinės padėties, tikėjimo, įsitikinimų ar pažiūrų, amžiaus, lytinės orientacijos, etninės priklausomybės, religijos, negalios ar kt.), įskaitant prieinamumo visiems reikalavimo užtikrinimą, principai.

Galimas simbolių skaičius – 1. Nurodyti privaloma.

3.8.2. Projekto įgyvendinimo metu nepažeidžiami PFSA arba, kai įgyvendinami RPPl projektai, – Gairėse ir RPPl nustatyti reikalavimai dėl atitinkamų Chartijos nuostatų laikymosi

Galimas simbolių skaičius – 1. Nurodyti privaloma.

3.8.3. Projektu tiesiogiai (projekto tikslas, tikslinė grupė, projekto veiklos, projekto vykdytojai, rodikliai, siekiami rezultatai) prisidedama prie HP įgyvendinimo:

Darnus vystymasis, įskaitant reikšmingos žalos nedarymo principą

Nurodoma, kaip įgyvendinant projektą bus tiesiogiai vykdomi PFSA, o kai įgyvendinami RPPl projektai, – Gairėse ir RPPl nurodyti reikalavimai dėl darnaus vystymosi. Remiamos aplinkos atžvilgiu tvarios veiklos, kurias vykdant laikomasi klimato ir aplinkos apsaugos standartų, atsižvelgiant į Sutarties dėl Europos Sąjungos veikimo 11 straipsnį, Jungtinių Tautų darnaus vystymosi tikslus, Jungtinių Tautų bendrosios klimato kaitos konvencijos Paryžiaus susitarimą, įskaitant reikšmingos žalos nedarymo principą, kaip tai suprantama 2020 m. birželio 18 d. Europos Parlamento ir Tarybos reglamente (ES) Nr. 2020/852 dėl sistemos tvariam investavimui palengvinti sukūrimo, kuriuo iš dalies keičiamas Reglamentas (ES) 2019/2088, šiose srityse:

- aplinkosaugos srityje;

- socialinėje srityje (užimtumas, skurdas ir socialinė atskirtis, visuomenės sveikata, švietimas ir mokslas, kultūros savitumo išsaugojimas, tausojantis vartojimas);

- ekonomikos srityje (darnus pagrindinių ūkio šakų ir regionų vystymas);

- teritorijų vystymo srityje (aplinkosaugos, socialinių ir ekonominių skirtumų mažinimas).

Turi būti pagrįsta, kaip prisidedama prie šio principo įgyvendinimo.

Galimas simbolių skaičius – 3 000.
Lygios galimybės ir nediskriminavimas | Nurodoma, kaip įgyvendinant projektą bus tiesiogiai vykdomi PFSA, o kai įgyvendinami RPPl projektai, – Gairėse ir RPPl nurodyti reikalavimai dėl lygių galimybių ir nediskriminavimo (dėl lyties, rasės, tautybės, pilietybės, kalbos, kilmės, socialinės padėties, tikėjimo, įsitikinimų ar pažiūrų, amžiaus, lytinės orientacijos, etninės priklausomybės, religijos, negalios ar kt.), įskaitant prieinamumo visiems reikalavimo užtikrinimą, ir pagrindžiama, kaip tai bus įgyvendinama. Galimas simbolių skaičius – 3 000.
Inovatyvumas (kūrybingumas) | Jei pasirenkama, nurodoma, kaip įgyvendinant projektą bus vykdomi PFSA, o kai įgyvendinami RPPl projektai, – Gairėse ir RPPl nurodyti reikalavimai dėl įsipareigojimų inovatyvumui (kūrybingumui) skatinti. Galimas simbolių skaičius – 3 000.

IV SKYRIUS

PROJEKTO REZULTATŲ TĘSTINUMO PLANAS

(taikoma tik investicijų projektams, kai įgyvendinus projektą gaunamas ilgalaikis rezultatas)

Projekto rezultatų palaikymo finansinis pagrindimas

Kai rengiamas projekto investicijų projektas, šioje dalyje pareiškėjas turi nurodyti, kokiomis lėšomis ir kokia suma bus užtikrintas projekto rezultatų palaikymas.

Kai nėra rengiamas projekto investicijų projektas, šioje dalyje detalizuojama, kokio palaikymo biudžeto reikės po projekto įgyvendinimo – kokioms sąnaudoms ir kiek lėšų reikės kasmet (visą projekto investicijų tęstinumo laikotarpį).

Pateikiamas projekto tęstinumo aprašymas, atsižvelgiant į du požymius – fizinį ir veiklos rezultatų tęstinumą.

Fizinis tęstinumas: glaustai aprašoma, kaip bus užtikrintas projekto produktų tęstinumas (pvz., kas ir kaip apmokės pastatyto naujo pastato eksploatavimo išlaidas, kas bus atsakingas už sukurtos infrastruktūros tinkamą naudojimą), kaip bus užtikrinamas projekto rezultatų panaudojimas ir (arba) sklaida.

Veiklos rezultatų tęstinumas: glaustai aprašoma, koks projekto valdymo personalas užtikrins (nurodomos konkrečios priemonės) projekto veiklų tęstinumą po projekto finansavimo pabaigos pagal priemonės apraše nustatytus reikalavimus, jei tokie nustatyti (pvz., kokioms paslaugoms (pvz., onkologinėms, traumatologinėms) teikti bus naudojama įgyvendinant projektą įgyta medicininė įranga ir kt.).

Galimas simbolių skaičius – 4 000.

Nurodyti privaloma.

Laikotarpis, kurio projekto rezultatų palaikymas skaičiuojamas, metai | Vidutinė metinė lėšų suma, kurios reikia projekto rezultatams palaikyti, eurais | Bendra lėšų suma, kurios reikia projekto rezultatams palaikyti, eurais
| | Valstybės biudžeto lėšos | Kiti finansavimo šaltiniai | Pareiškėjo lėšos | Iš viso
Nurodomas laikotarpis, kurio projekto rezultatų palaikymas skaičiuojamas. | Nurodoma vidutinė metinė lėšų suma, kurios reikia projekto rezultatams palaikyti. | Nurodoma valstybės biudžeto lėšų suma. | Nurodomi finansavimo šaltinis ir suma. | Nurodoma pareiškėjo lėšų suma.

V SKYRIUS

PROJEKTO ĮGYVENDINIMO PLANO PRIEDAI

(taikoma visiems projektams)

(Pareiškėjas prideda kvietime teikti PĮP nurodytus ir papildomus (pagal poreikį) PĮP priedus. Lentelės pabaigoje įrašomi kiti priedai, jei kvietime teikti PĮP nurodyta juos pateikti. Visos PĮP ir jo priedų formos skelbiamos Europos Sąjungos investicijų interneto svetainėje esinvesticijos.lt (toliau – svetainė esinvesticijos.lt). DMS elektroninėje formoje rodomi tie PĮP priedai, kurie pažymėti kaip teikiami kvietimo teikti PĮP formoje. PĮP priedus turi pateikti tiek pareiškėjas, tiek projekto partneris (-iai), jeigu jie numatyti projekte. Prie PĮP pridedami tie priedai, ties kuriais lentelėje pažymėta „X“.)

Projekto įgyvendinimo plano priedo pavadinimas | | Žymima, jeigu teikiama
1. | Partnerio deklaracija pagal PĮP 1 priede pateiktą formą (teikiama, jei projektas įgyvendinamas su partneriu (-iais)).
2. | Informacija apie projekto biudžeto paskirstymą pagal pareiškėjus ir partnerius pagal PĮP 2 priede pateiktą formą (teikiama, jeigu projektas įgyvendinamas su partneriu (-iais).

3.

Projekto investicijų projektas su investicijų skaičiuokle (teikiamas, jeigu įgyvendinant projektą planuojama investicijų į ilgalaikio materialiojo ir nematerialiojo turto, reikalingo viešosioms paslaugoms, kaip jos apibrėžtos Lietuvos Respublikos viešojo administravimo įstatyme, teikti ir (arba) viešojo administravimo funkcijoms vykdyti, sukūrimą, įsigijimą arba jo vertės padidinimą suma, išskyrus (atėmus) jai tenkantį pirkimo ir (arba) importo pridėtinės vertės mokestį, viršija vieną milijoną eurų). Projekto investicijų projektas rengiamas vadovaujantis Investicijų projektų rengimo metodika, patvirtinta viešosios įstaigos Centrinės projektų valdymo agentūros direktoriaus (dokumentas skelbiamas svetainėse cpva.lt ir esinvesticijos.lt).

4.

Informacija apie projektui taikomus aplinkosaugos reikalavimus pagal PĮP 3 priede pateiktą formą (teikiama, jei įgyvendinant projektą planuojama ūkinė veikla, kaip ji apibrėžta Lietuvos Respublikos planuojamos ūkinės veiklos poveikio aplinkai vertinimo įstatymo 2 straipsnio 4 dalyje, gali turėti poveikį aplinkai ir ji patenka į Planuojamos ūkinės veiklos poveikio aplinkai vertinimo įstatymo taikymo sritį, ir (arba) įgyvendinant projektą planuojama ūkinė veikla susijusi su „Natura 2000“ teritorijomis, ir (arba) tai nustatyta ministerijos ar pažangos priemonės koordinatoriaus (jeigu koordinatorius yra paskirtas) (toliau – kartu ministerija), kurie pagal kompetenciją atsakingi už bendrai finansuojamus iš Europos Sąjungos fondų lėšų ūkio sektorius, patvirtintame projektų finansavimo sąlygų apraše).
5. | Informacija apie pareiškėjui (partneriui) suteiktą valstybės pagalbą (išskyrus de minimis) pagal PĮP 4 priede pateiktą formą (teikiama, jeigu kvietime teikti PĮP nurodoma, kad kartu su PĮP privaloma pateikti šį priedą).
6. | Ministerijos, o kai įgyvendinami regionų plėtros planų projektai (toliau – RPPl projektai), – regiono plėtros tarybos (toliau – RPT) parengtas dokumentas su suderinimo žyma (teikiamas, kai kvietime teikti PĮP nurodomas reikalavimas dėl projekto išvystymo ir PĮP suderinimo su ministerija, o kai įgyvendinami RPPl projektai, – RPT).
7. | (Įrašomi visi kiti priedai, kurie teikiami kartu su PĮP. Leidžiama sukurti daugiau eilučių. Galimas simbolių skaičius – 300.)

VI SKYRIUS

PAREIŠKĖJO DEKLARACIJA

☐Patvirtinu, kad:

1. Šiame PĮP ir prie jo pridedamuose dokumentuose pateikta informacija, mano žiniomis ir įsitikinimu, yra teisinga.

2. Esu susipažinęs (-usi) su projekto finansavimo sąlygomis, tvarka ir reikalavimais, nustatytais kvietime teikti PĮP.

3. Mano atstovaujamam pareiškėjui yra žinoma, kad projektas įgyvendinamas pagal projekto sutartyje, kvietime teikti PĮP ir jame nurodytuose Europos Sąjungos ir Lietuvos Respublikos teisės aktuose nustatytas sąlygas ir tvarką.

4. Mano atstovaujamam pareiškėjui yra žinoma, kad projekto įgyvendinimo metu turės būti laikomasi HP (darnaus vystymosi, įskaitant reikšmingos žalos nedarymo principą; lygių galimybių ir nediskriminavimo, įskaitant prieinamumo visiems reikalavimo užtikrinimą; inovatyvumo (kai taikoma)) ir PFSA, o kai įgyvendinami RPPl projektai, – Gairėse ir RPPl nustatytų reikalavimų dėl atitinkamų Chartijos nuostatų laikymosi.

5. Mano atstovaujamam pareiškėjui yra žinoma, kad projekto įgyvendinimo metu jis turės prisidėti nuosavu įnašu, apmokėdamas projekto tinkamas finansuoti išlaidas, kurios nepadengiamos projekto finansavimo lėšomis, ir visas kitas projektui įgyvendinti reikalingas išlaidas (įskaitant netinkamas finansuoti išlaidas).

6. Mano atstovaujamas pareiškėjas PĮP pateikimo dieną galutiniu teismo sprendimu ar galutiniu administraciniu sprendimu nėra pripažintas nevykdančiu pareigų, susijusių su mokesčių ar socialinio draudimo įmokų mokėjimu pagal Lietuvos Respublikos teisės aktus arba pagal kitos valstybės teisės aktus, jei pareiškėjas yra užsienyje registruotas juridinis asmuo (netaikoma įstaigoms, kurių veikla finansuojama iš valstybės ir (arba) savivaldybių biudžetų, ir (arba) valstybės pinigų fondų lėšų, ir pareiškėjams, kuriems Lietuvos Respublikos teisės aktų nustatyta tvarka yra atidėti mokesčių arba socialinio draudimo įmokų mokėjimo terminai).

7. Mano atstovaujamo pareiškėjo vadovas, pagrindinis akcininkas (turintis daugiau nei 50 procentų akcijų) ar savininkas, ūkinės bendrijos tikrasis (-ieji) narys (-iai) ar mažosios bendrijos atstovas (-ai), turintis (-ys) teisę juridinio asmens vardu sudaryti sandorį, ar apskaitą tvarkantis asmuo (asmenys), ar kitas (kiti) asmuo (asmenys), turintis (-ys) teisę surašyti ir pasirašyti pareiškėjo apskaitos dokumentus, PĮP vertinimo metu neturi neišnykusio arba nepanaikinto teistumo arba dėl pareiškėjo per pastaruosius 5 metus nebuvo priimtas ir įsiteisėjęs apkaltinamasis teismo nuosprendis dėl neteisėtos veiklos, kenkiančios Lietuvos Respublikos ir (arba) Europos Sąjungos finansiniams interesams, t. y. už dalyvavimą bendrininkų grupėje, organizuotoje grupėje, nusikalstamame susivienijime, jų organizavimą ar vadovavimą jiems, teroristinius ir su teroristine veikla susijusius nusikaltimus ar teroristų finansavimą, vaikų darbą ar kitas su prekyba žmonėmis susijusias nusikalstamas veikas, kyšininkavimą, prekybą poveikiu, papirkimą, piktnaudžiavimą, tarnybos pareigų neatlikimą, sukčiavimą, turto pasisavinimą, turto iššvaistymą, turtinės žalos padarymą apgaule, turto sunaikinimą ar sugadinimą, neteisėtą praturtėjimą, kontrabandą, muitinės apgaulę, neteisėtą disponavimą akcizais apmokestinamomis prekėmis, neteisėtą prekių ar produkcijos neišvežimą iš Lietuvos Respublikos, neteisėtą vertimąsi ūkine, komercine, finansine ar profesine veikla, neteisėtą juridinio asmens veiklą, svetimo prekių ar paslaugų ženklo naudojimą, apgaulingą pareiškimą apie juridinio asmens veiklą, mokesčių nesumokėjimą, kredito, paskolos ar tikslinės paramos panaudojimą ne pagal paskirtį ar nustatytą tvarką, kreditinį sukčiavimą, skolininko nesąžiningumą, nusikalstamą bankrotą, netikros elektroninės mokėjimo priemonės gaminimą, tikros elektroninės mokėjimo priemonės klastojimą ar neteisėtą disponavimą elektronine mokėjimo priemone arba jos duomenimis, neteisėtą elektroninės mokėjimo priemonės ar jos duomenų panaudojimą, neteisingų duomenų apie pajamas, pelną ar turtą pateikimą, deklaracijos, ataskaitos ar kito dokumento nepateikimą, apgaulingą ar aplaidų apskaitos tvarkymą, nusikalstamu būdu gauto turto įgijimą ar realizavimą, nusikalstamu būdu įgytų pinigų ar turto legalizavimą, netikrų pinigų ar vertybinių popierių pagaminimą, laikymą ar realizavimą, dokumento suklastojimą ar disponavimą suklastotu dokumentu, antspaudo, spaudo ar blanko suklastojimą, dalyvavimą kokioje nors kitoje neteisėtoje veikloje, kenkiančioje Lietuvos Respublikos ir (arba) Europos Sąjungos finansiniams interesams arba apie juos nėra pateiktų duomenų Finansinių nusikaltimų tyrimo tarnybos prie Lietuvos Respublikos vidaus reikalų ministerijos interneto svetainėje fntt.lt skelbiamoje informacijoje apie fizinių ir (ar) juridinių asmenų sąsajas su subjektais, kuriems taikomos tarptautinės sankcijos (netaikoma, jei pareiškėjo veikla yra finansuojama iš valstybės ir (arba) savivaldybių biudžetų ir (arba) valstybės pinigų fondų lėšų, taip pat iš Europos investicijų fondo ir Europos investicijų banko lėšų). Esu informuotas (-a), kad šiame punkte nurodytų asmenų teistumo duomenys tvarkomi vykdant 2018 m. liepos 18 d. Europos Parlamento ir Tarybos reglamento (ES, Euratomas) 2018/1046 dėl Sąjungos bendrajam biudžetui taikomų finansinių taisyklių, kuriuo iš dalies keičiami reglamentai (ES) Nr. 1296/2013, (ES) 1301/2013, (ES) Nr. 1303/2013, (ES) Nr. 1304/2013, (ES) Nr. 1309/2013, (ES) Nr. 1316/2013, (ES) Nr. 223/2014, (ES) Nr. 283/2014 ir sprendimas Nr. 541/2014/ES, bei panaikinamas Reglamentas (ES, Euratomas) Nr. 966/2013 (toliau – Finansinis reglamentas), 136 straipsnio 1 dalyje nustatytą pareigą.

8. Mano atstovaujamam pareiškėjui PĮP vertinimo metu, jei jis perkėlė gamybinę veiklą Europos Sąjungos valstybėje narėje arba į kitą valstybę narę, nėra taikoma arba nebuvo taikoma išieškojimo procedūra.

9. Mano atstovaujamam pareiškėjui PĮP vertinimo metu nėra taikomas apribojimas (iki 5 metų) neskirti Europos Sąjungos finansinės paramos dėl trečiųjų šalių piliečių nelegalaus įdarbinimo (netaikoma viešiesiems juridiniams asmenims).

10. Mano atstovaujamam pareiškėjui, kuris yra juridinis asmuo, nėra iškelta byla dėl bankroto arba jis nėra likviduojamas, nėra priimtas kreditorių susirinkimo nutarimas bankroto procedūras vykdyti ne teismo tvarka (netaikoma biudžetinėms įstaigoms). Mano atstovaujamam pareiškėjui, kuris yra juridinis asmuo, t. y. vadovui, pagrindiniam akcininkui (turinčiam daugiau nei 50 procentų akcijų) ar savininkui, ūkinės bendrijos tikrajam nariui (-iams) ar mažosios bendrijos atstovui (-ams), turinčiam (-tiems) teisę juridinio asmens vardu sudaryti sandorį, ar apskaitą tvarkančiam asmeniui (asmenims), ar kitam (kitiems) asmeniui (asmenims), turinčiam (-tiems) teisę surašyti ir pasirašyti pareiškėjo apskaitos dokumentus, nėra pradėtas ikiteisminis tyrimas dėl ūkinės ir (arba) ekonominės veiklos.

11. Mano atstovaujamas pareiškėjas PĮP vertinimo metu Juridinių asmenų registrui yra pateikęs metinių finansinių ataskaitų rinkinius, taip pat metinių konsoliduotųjų finansinių ataskaitų rinkinius, kaip nustatyta Juridinių asmenų registro nuostatuose, patvirtintuose Lietuvos Respublikos Vyriausybės 2003 m. lapkričio 12 d. nutarimu Nr. 1407 „Dėl Juridinių asmenų registro įsteigimo ir Juridinių asmenų registro nuostatų patvirtinimo“ (taikoma tik tais atvejais, kai finansines ataskaitas būtina rengti pagal įstatymus, taikomus juridiniam asmeniui, užsienio juridiniam asmeniui ar kitai organizacijai arba jų filialui).

12. Jeigu projektas įgyvendinamas kartu su partneriu (-ais) ir jeigu įgyvendinant projektą bus patiriamos PVM išlaidos, kurios yra tinkamos finansuoti iš Europos Sąjungos fondų ir (arba) valstybės biudžeto lėšų, jungtinės veiklos sutartimis ar kitais būdais užtikrinsiu, kad įgyvendinant projektą numatomos įsigyti prekės, paslaugos ar darbai bus skirti partnerio ne ekonominei veiklai ir (arba) Lietuvos Respublikos pridėtinės vertės mokesčio įstatyme nustatytoms PVM neapmokestinamoms veiklos rūšims (netaikoma užsienyje registruotiems juridiniams asmenims).

13. Mano atstovaujamam pareiškėjui yra žinoma, kad užsienyje sumokėto Lietuvos Respublikos apmokestinamojo asmens PVM negalima susigrąžinti pasinaudojus Valstybinės mokesčių inspekcijos prie Lietuvos Respublikos finansų ministerijos Elektroninių prašymų priėmimo sistema (EPRIS), o susigrąžinus, reikia nedelsiant apie tai informuoti administruojančiąją instituciją.

14. Mano atstovaujamam pareiškėjui yra žinoma, kad, jeigu projekto lėšomis apmokėta PVM suma bus įtraukta į PVM ataskaitą arba projekto įgyvendinimo metu, kai projektas finansuojamas iš Ekonomikos gaivinimo ir atsparumo didinimo priemonės arba 2021–2027 metų Europos Sąjungos fondų lėšų ir projekto bendra vertė kartu su PVM viršija 5 mln. eurų, ir pagal Lietuvos Respublikos teisės aktus bus įgyta teisė į PVM atskaitą, apie tai nedelsdamas turės informuoti administruojančiąją instituciją ir tą sumą privalės sugrąžinti.

15. Mano, kaip pareiškėjo vadovo ar įgalioto asmens, privatūs interesai yra suderinti su visuomenės viešaisiais interesais.

16. Mano atstovaujamas pareiškėjas įsipareigoja per administruojančiosios institucijos nustatytą terminą pateikti jai reikalingą informaciją ir (arba) atlikti Lietuvos Respublikos ir Europos Sąjungos atsakingų institucijų nurodytus veiksmus, vykdomus dėl kvietime teikti PĮP nurodytų ir kitų Lietuvos Respublikos ir Europos Sąjungos teisės aktų nuostatų taikymo.

17. Mano atstovaujamas pareiškėjas yra informuotas, kad, nepateikus kvietime teikti PĮP privalomų pateikti priedų ir PĮP vertinimo metu nepateikus prašomų dokumentų ir (ar) informacijos per administruojančiosios institucijos nustatytą terminą, PĮP bus atmestas.

18. Mano atstovaujamas pareiškėjas yra informuotas, kad vadovaujantis 2021 m. birželio 24 d. Europos Parlamento ir Tarybos reglamento (ES) 2021/1060, kuriuo nustatomos bendros Europos regioninės plėtros fondo, „Europos socialinio fondo +“, Sanglaudos fondo, Teisingos pertvarkos fondo ir Europos jūrų reikalų, žvejybos ir akvakultūros fondo nuostatos ir šių fondų bei Prieglobsčio, migracijos ir integracijos fondo, Vidaus saugumo fondo ir Sienų valdymo ir vizų politikos finansinės paramos priemonės taisyklės (toliau – BNR reglamentas), 49 straipsnio 3 ir 5 dalimis ir prisidedant prie investicijų skaidrumo didinimo, sudarius projekto sutartį ar po paraiškos finansuoti JP projektą patvirtinimo dienos, svetainėje esinvesticijos.lt ir kitose su Europos Sąjungos investicijomis susijusiose interneto svetainėse bei komunikacijos, matomumo priemonėse visuomenės informavimo tikslais bus paskelbti šie duomenys: projekto vykdytojo pavadinimas, partnerio pavadinimas, JP projekto vykdytojo pavadinimas (fizinio asmens vardo ir pavardės viešinimo trukmė yra 2 metai), rangovo ir subrangovo, prekių tiekėjo ir subtiekėjo, paslaugų teikėjo ar subteikėjo pavadinimas (kai vykdomi viešieji pirkimai ar ne perkančiosios organizacijos pirkimai, projekto pavadinimas, projekto tikslas ir rezultatai, projekto pradžios ir pabaigos laikas, bendra projekto vertė, Europos Sąjungos lėšų šaltinio (fondo) pavadinimas ir jo finansavimo dydis, su projektu susijusi intervencinės priemonės sritis pagal BNR reglamento 73 straipsnio 2 dalies g punktą, projekto įgyvendinimo vietos šalies nuoroda arba geografinė padėtis, kita informacija, kurios viešinimas neprieštarauja teisės aktų nuostatoms dėl su Europos Sąjungos investicijomis susijusių duomenų viešinimo. Taip pat mano atstovaujamas pareiškėjas yra informuotas, kad pagrindinėje interneto svetainėje (jeigu tokia yra) ir socialiniuose tinkluose per 20 darbo dienų nuo projekto sutarties pasirašymo dienos turės būti paskelbiamas trumpas projekto aprašymas, kuriame pristatomos visos įgyvendinant projektą suplanuotos veiklos, poveiklės, nurodomi projekto tikslai bei rezultatai ir informuojama apie gautą Europos Sąjungos finansavimą. Taip pat esu informuotas (-a), kad vadovaujantis BNR reglamento 49 straipsnio 6 dalimi Europos Sąjungos institucijų, organų, tarnybų ar agentūrų prašymu joms būtų suteikta galimybė susipažinti su projekto komunikacijos ir matomumo medžiaga, įskaitant informaciją Europos Sąjungos lėšų gavėjų lygmeniu, ir kad Europos Sąjungai būtų suteikta nemokama, neišimtinė ir neatšaukiama licencija naudoti tokią medžiagą ir visas su ja susijusias ankstesnes teises pagal BNR reglamento IX priedą ir Ekonomikos gaivinimo ir atsparumo didinimo priemonės (toliau – EGADP) finansinio susitarimo tarp Europos Komisijos ir Lietuvos Respublikos 10 straipsnio 6 punktą.

19. Mano atstovaujamam pareiškėjui yra žinoma, kad vadovaujantis BNR reglamento 70 straipsnio 3 dalimi, 71 straipsnio 3 dalimi, 74 straipsniu, Finansinio reglamento 129 straipsniu, 2021 m. vasario 12 d. Europos Parlamento ir Tarybos reglamento (ES) 2021/241, kuriuo nustatoma ekonomikos gaivinimo ir atsparumo didinimo priemonė (toliau – EGADP reglamentas), 22 straipsnio 2 dalies e punktu, Vadovaujančiosios, administruojančiosios ir audito institucijos funkcijų, įgyvendinant Ekonomikos gaivinimo ir atsparumo didinimo planą „Naujos kartos Lietuva“ paskirstymo taisyklių, patvirtintų Lietuvos Respublikos Vyriausybės 2020 m. lapkričio 25 d. nutarimu Nr. 1332 „Dėl pasirengimo administruoti Europos Sąjungos lėšas ir jų administravimo“ (toliau – EGADP atsakomybės taisyklės), 4.9, 5.6, 6.6, 6.9, 6.17, 7.2, 9.2 papunkčiais, 2021–2027 metų Europos Sąjungos fondų investicijų programos administruojančiosios institucijos ir tarpinės institucijos funkcijų sąrašo, patvirtinto Lietuvos Respublikos finansų ministro 2021 m. liepos 2 d. įsakymu Nr. 1K-237 „Dėl funkcijų paskirstymo įgyvendinant 2021–2027 metų Europos Sąjungos fondų investicijų programą“ (toliau – Atsakomybės taisyklės), 4.3, 4.4, 5.3, 5.4papunkčiais, 2021–2027 metų Europos Sąjungos fondų investicijų programos vadovaujančiosios institucijos funkcijų paskirstymo Lietuvos Respublikos finansų ministerijos administraciniams padaliniams aprašo, patvirtinto Lietuvos Respublikos finansų ministro 2021 m. liepos 2 d. įsakymu Nr. 1K-237 „Dėl funkcijų paskirstymo įgyvendinant 2021–2027 metų Europos Sąjungos fondų investicijų programą“ (toliau – Aprašas), 6.5 papunkčiu Europos Audito Rūmų, Europos Komisijos, Europos kovos su sukčiavimu tarnybos, Europos prokuratūros, vadovaujančiosios institucijos, ministerijų, tarpinės institucijos, administruojančiųjų institucijų, audito institucijos, kuriai pavesta atlikti 2021–2027 metų Europos Sąjungos fondų investicijų programos ir Ekonomikos gaivinimo ir atsparumo didinimo priemonės audito institucijos funkcijas, Viešųjų pirkimų tarnybos, Finansinių nusikaltimų tyrimo tarnybos prie Lietuvos Respublikos vidaus reikalų ministerijos, Lietuvos Respublikos specialiųjų tyrimų tarnybos ir Lietuvos Respublikos konkurencijos tarybos atstovai ir (ar) jų įgalioti asmenys turi teisę audituoti ir kontroliuoti mano atstovaujamo pareiškėjo ūkinę ir finansinę veiklą, kiek ji susijusi su projekto įgyvendinimu. Esu informuotas (-a), kad turiu visapusiškai bendradarbiauti su šiomis institucijomis Europos Sąjungos finansinių interesų apsaugos klausimu, užtikrinti su projekto įgyvendinimu susijusių dokumentų (įskaitant elektroninius dokumentus, pateiktus informacinių technologijų priemonėmis ir elektroninėse laikmenose) saugumą ir prieinamumą šių institucijų atstovams ir (ar) jų įgaliotiems asmenims projekto įgyvendinimo metu ir po projekto finansavimo pabaigos teisės aktuose nurodytu dokumentų saugojimo laikotarpiu.

20. Mano atstovaujamam pareiškėjui yra žinoma, kad vadovaudamasi BNR reglamento 69 straipsnio 2 dalimi, 71 straipsnio 3 dalimi, 72 straipsnio 1 dalies a ir e punktais, EGADP reglamento 22 straipsnio 2 dalies d punktu ir 3 dalimi, EGADP atsakomybės taisyklių 6.2, 6.15 ir 6.16 papunkčiais, Atsakomybės taisyklių 4.20, 5.14 papunkčiais administruojančioji institucija užtikrina duomenų, reikalingų stebėsenai, vertinimui, finansų valdymui, patikrinimams ir auditams, Europos Sąjungos fondų investicijų panaudojimo vertinimui atlikti, taip pat audito sekai užtikrinti, ir būtinų duomenų apie projektų įgyvendinimą rinkimą (įskaitant iš valstybės registrų ir duomenų bazių), įrašymą ir saugojimą skaitmeniniu formatu, šių duomenų saugumą, vientisumą, konfidencialumą ir naudotojų autentiškumo patvirtinimą.

21. Esu informuotas (-a), kad vadovaujantis BNR reglamento 69 straipsnio 6, 8 dalimis, 72 straipsnio 1 dalies e punktu, 82 straipsniu, EGADP atsakomybės taisyklių 4.8, 6.2 ir 6.16 papunkčiais, Aprašo 3.16, 3.20 ir 4.6 papunkčiais, Atsakomybės taisyklių 4.19, 4.20, 5.14 papunkčiais mano atstovaujamo pareiškėjo PĮP, projekto sutartyje, mokėjimo prašyme, išlaidų pagrindimo dokumentuose ir kituose dokumentuose esantys duomenys bus apdorojami ir saugomi 2021–2027 metų Europos Sąjungos fondų investicijų programos finansuojamų projektų administravimo informacinėje sistemoje šios sistemos nuostatuose nustatytais terminais ir Valstybės biudžeto, apskaitos ir mokėjimų sistemoje šios sistemos nuostatuose nustatytais terminais.

22. Esu informuotas (-a), kad mano asmens duomenis, nurodytus mano atstovaujamo pareiškėjo PĮP ir kituose administruojančiajai institucijai pateiktuose dokumentuose, Europos Komisija, vadovaujančioji, administruojančioji, audito institucijos tvarkys stebėsenos, ataskaitų teikimo, komunikacijos, skelbimo, vertinimo, finansų valdymo, patikrinimų ir audito, taip pat, kai taikytina, dalyvių atitikties nustatymo vykdymo tikslais (teisinis pagrindas – BNR reglamento 4 straipsnis, 71 straipsnio 1 ir 3 dalys, 72 straipsnio 1 dalies e punktas, Atsakomybės taisyklių 4.20, 5.14 papunkčiai ir 6 punktas) ir (arba) lėšų naudojimo, susijusio su Ekonomikos gaivinimo ir atsparumo didinimo plane „Naujos kartos Lietuva“ numatytomis reformų ir investicinių projektų įgyvendinimo priemonėmis, įvykdymo, audito ir kontrolės tikslais (teisinis pagrindas – EGADP reglamento 22 straipsnio 2 dalies d punktas ir 3 dalis, EGADP atsakomybės taisyklių 6.2 papunktis). Asmens duomenys bus tvarkomi vadovaujantis 2016 m. balandžio 27 d. Europos Parlamento ir Tarybos reglamentu (ES) 2016/679 dėl fizinių asmenų apsaugos tvarkant asmens duomenis ir dėl laisvo tokių duomenų judėjimo ir kuriuo panaikinama Direktyva 95/46/EB (Bendrasis duomenų apsaugos reglamentas) arba 2018 m. spalio 23 d. Europos Parlamento ir Tarybos reglamentu (ES) 2018/1725 dėl fizinių asmenų apsaugos Sąjungos institucijoms, organams, tarnyboms ir agentūroms tvarkant asmens duomenis ir dėl laisvo tokių duomenų judėjimo, kuriuo panaikinamas Reglamentas (EB) Nr. 45/2001 ir Sprendimas Nr. 1247/2002/EB, atsižvelgiant į tai, kuris iš jų taikytinas, bei kitais teisės aktais, reglamentuojančiais asmens duomenų tvarkymą.

23. Esu informuotas (-a), kad vadovaujantis BNR reglamento 44 straipsniu informacija apie projekto veiklas, su projekto išlaidų apmokėjimu susijusi informacija, mano kontaktiniai duomenys gali būti perduoti vertinimo ekspertams ir naudojami atliekant priemonės ir (ar) šio projekto įgyvendinimo vertinimą (renkant vertinimui būtinus duomenis apklausos, interviu ir kt. metodais).

24. Esu informuotas (-a), kad administruojančiųjų institucijų tvarkomi mano asmens duomenys, nurodyti mano atstovaujamo juridinio asmens PĮP ir kituose administruojančiosioms institucijoms pateiktuose dokumentuose, ir detalesnė informacija apie asmens duomenų tvarkymą ir teisių įgyvendinimą skelbiami administruojančiųjų institucijų interneto svetainėse.

25. Esu informuotas (-a), kad turiu šias Reglamente (ES) 2016/679 nustatytas teises: 1) žinoti (būti informuotas (-a)) apie savo asmens duomenų tvarkymą; 2) susipažinti su tvarkomais savo asmens duomenimis; 3) reikalauti ištaisyti asmens duomenis; 4) reikalauti ištrinti asmens duomenis, jei yra bent vienas pagrindas, nurodytas Reglamente (ES) 2016/679; 5) apriboti asmens duomenų tvarkymą; 6) pateikti skundą priežiūros institucijai.

26. Esu informuotas (-a), kad rinkdamas (-a), tvarkydamas (-a) projekto partnerio (-ių), projekto dalyvių, jungtinio projekto projekto pareiškėjo (-ų) asmens duomenis turiu užtikrinti Reglamente (ES) 2016/679 nustatytų reikalavimų vykdymą.

________________________ __________________ _____________

(pareiškėjo vadovo ar jo įgalioto (parašas) (vardas ir pavardė)

asmens pareigų pavadinimas)

__________________________
