JuliusJanusonis/MB/Inostartas/kvietimo-inostartas-skelbimas.docx

FORMAI PRITARTA

Tarpinstitucinės darbo grupės, sudarytos Lietuvos Respublikos finansų ministro

2021 m. birželio 11 d. įsakymu Nr. 1K-219

„Dėl tarpinstitucinės darbo grupės sudarymo“, 2022 m. rugpjūčio 19 d. posėdžio protokolu Nr. 6

Kvietimų teikti projektų įgyvendinimo planus planavimo ir skelbimo proceso

3 priedas

KVIETIMAS TEIKTI PROJEKTŲ ĮGYVENDINIMO PLANUS

„INOSTARTAS“

Nr. 02-014-K

Kvietimas parengtas vadovaujantis 2022–2030 metų plėtros programos valdytojos Lietuvos Respublikos ekonomikos ir inovacijų ministerijos ekonomikos transformacijos ir konkurencingumo plėtros programos pažangos priemonės Nr. 05-001-01-05-07 „Sukurti nuoseklią inovacinės veiklos skatinimo sistemą“ veiklos „Skatinti inovacijų pasiūlą“ poveiklės „Investuoti į naujų APV produktų kūrimo veiklas ir sudaryti sąlygas tyrėjams dalyvauti įmonių MTEP veiklose, skatinti intelektinę nuosavybę, ankstyvąją sukurtų naujų produktų bandomąją gamybą, parengimą rinkai“ (Vidurio ir vakarų Lietuvos regionas) projektų finansavimo sąlygų aprašu, patvirtintu Lietuvos Respublikos ekonomikos ir inovacijų ministro 2022 m. gruodžio 21 d. įsakymu Nr. 4-1193 (toliau – PFSA) ir Lietuvos Respublikos ekonomikos ir inovacijų ministerijos pateiktu Kvietimų teikti projektų įgyvendinimo planus planu.

1. | Informacija apie pažangos priemonę
| Pažangos priemonės numeris | 05-001-01-05-07
| Pavadinimas | Sukurti nuoseklią inovacinės veiklos skatinimo sistemą
| Finansavimo suma | 728 029 082 Eur
| Veiklos sritis | ☒ valstybės valdymas, regioninė politika ir viešasis administravimas; ☐ aplinka, miškai ir klimato kaita; ☐ energetika; ☐ viešieji finansai ir oficialioji statistika; ☒ ekonomikos konkurencingumas ir valstybės informaciniai ištekliai; ☐ valstybės saugumas ir gynyba; ☐ viešasis saugumas; ☐ kultūra ir visuomenės informavimas; ☐ socialinė apsauga ir užimtumas; ☐ transportas ir ryšiai; ☐ sveikata; ☒ švietimas, mokslas ir sportas; ☐ teisingumas; ☐ užsienio politika; ☐ žemės ir maisto ūkis, kaimo plėtra, žuvininkystė, veterinarija ir žemės tvarkymas
| Projektų atrankos būdas | ☒ Planavimas ☒ Konkursas ☐ Tęstinė atranka ☐ Jungtinis projektas
| Regionas | ☐ Netaikoma ☒ Vidurio ir vakarų Lietuvos regionas ☒ Sostinės regionas
| Programa | ☒ ES fondų investicijų programa ☒ Planas „Naujos kartos Lietuva“
| Asignavimų valdytojas | Lietuvos Respublikos ekonomikos ir inovacijų ministerija
| Pažangos priemonės informacija | Pažangos priemonė skirta 2021–2027 m. Europos Sąjungos fondų investicijų programos (toliau – 2021–2027 m. IP) 1 politikos tikslui „Konkurencingesnė ir pažangesnė Europa“ įgyvendinti. Pažangos priemonė skirta Ekonomikos gaivinimo ir atsparumo didinimo priemonės (toliau – EGADP) 2 reformai „Efektyvus inovacijų politikos įgyvendinimas ir didesnė inovacijų paklausa, startuolių ekosistemos ir žaliųjų inovacijų plėtra“ įgyvendinti. Pažangos priemonės veiklos finansuojamos iš EGADP, 2021–2027 m. IP, valstybės biudžeto, bendrojo finansavimo ir privačių lėšų.

Stebėsenos rodikliai

Rodiklio pavadinimas | Siektina galutinė reikšmė 2030 m. | Matavimo vienetas
Produktų ar procesų inovacijas diegiančios, labai mažos, mažos ir vidutinės įmonės (MVĮ) | 64,5 | Proc.
Inovatyvios MVĮ, bendradarbiaujančios su kitomis įmonėmis | 37,7 | Proc.
Privačiosios investicijos, papildančios viešąją paramą (iš kurių: dotacijos, finansinės priemonės) | 284 157 754 (2029) | Eurai
Paramą gavusiuose subjektuose sukurtos darbo vietos | 1976 (2029) | Vienų metų etato ekvivalentai
Paramą gavusiuose subjektuose sukurtos mokslo tiriamojo darbo vietos | 255 (2029) | Vienų metų etato ekvivalentai
Produktų ar procesų inovacijas diegiančios mažosios ir vidutinės įmonės (MVĮ)** | 554 (2029) | Įmonės
Prekybos ar organizacines inovacijas diegiančios MVĮ | 272 (2029) | Įmonės
Vidines inovacijas vykdančios MVĮ | 389 (2029) | Įmonės
Ikiprekybinio pirkimo dalyvio pateiktas rinkai inovatyvusis produktas | 26 (2029) | Vienetas
MVĮ darbuotojai, baigę mokymą, skirtą pažangiajai specializacijai, pramonės pertvarkai ir verslumui reikalingiems įgūdžiams ugdyti (pagal įgūdžių rūšį: techniniai, valdymo, verslumo, ekologijos, kiti) | 61 011 (2029) | Dalyviai
MVĮ darbuotojai, baigę mokymą, skirtą pažangiajai specializacijai, pramonės pertvarkai ir verslumui reikalingiems įgūdžiams ugdyti (pagal įgūdžių rūšį: techniniai) | n/a | Dalyviai
MVĮ darbuotojai, baigę mokymą, skirtą pažangiajai specializacijai, pramonės pertvarkai ir verslumui reikalingiems įgūdžiams ugdyti (pagal įgūdžių rūšį: valdymo) | n/a | Dalyviai
MVĮ darbuotojai, baigę mokymą, skirtą pažangiajai specializacijai, pramonės pertvarkai ir verslumui reikalingiems įgūdžiams ugdyti (pagal įgūdžių rūšį: verslumo) | n/a | Dalyviai
MVĮ darbuotojai, baigę mokymą, skirtą pažangiajai specializacijai, pramonės pertvarkai ir verslumui reikalingiems įgūdžiams ugdyti (pagal įgūdžių rūšį: ekologijos) | n/a | Dalyviai
MVĮ darbuotojai, baigę mokymą, skirtą pažangiajai specializacijai, pramonės pertvarkai ir verslumui reikalingiems įgūdžiams ugdyti (pagal įgūdžių rūšį: kiti) | n/a | Dalyviai
Paramą gavusios įmonės*** | n/a | Vienetai
Paramą gavusios įmonės, iš jų: mažos ir labai mažos*** | n/a | Vienetai
Paramą gavusios įmonės, iš jų: vidutinės*** | n/a | Vienetai
Paramą gavusios įmonės, iš jų: didelės*** | n/a | Vienetai
Pateiktos paraiškos konkrečiai MTEPI iniciatyvai**** | 323 (2029) | Vienetai
Privačiosios investicijos, papildančios viešąją paramą (iš kurių: dotacijos) | n/a | Eurai
Privačiosios investicijos, papildančios viešąją paramą (iš kurių finansinės priemonės) | n/a | Eurai
Inicijuotų ikiprekybinių pirkimų skaičius | 15 (2029) | Vienetai
Pritraukta užsienio įmonių į MTEPI sritį pagal sumaniosios specializacijos kryptis | 10 (2029) | Vienetai
Įsigaliojęs Vyriausybės nutarimas dėl Inovacijų agentūros įsteigimo ir inovacinės veiklos skatinimo funkcijų Inovacijų agentūrai perdavimo | 1 (2022 I ketv.) | Vienetai
Įsigalioję pakeisti inovacinę veiklą reglamentuojantys teisės aktai | n/a (2021 IV ketv.) | Įsigalioję teisės aktai
Paskelbti kvietimai teikti pasiūlymus***** | 5 (2022 III ketv. 2023 I ketv.) | Vienetai
Investicijas gavusių startuolių skaičius | 112 (2026 I ketv.) | Vienetai
Įsteigtas LT Space Hub | 1 (2022 IV ketv.) | Vienetai
Įgyvendintų inovatyvių projektų skaičius ****** | 100 (2026 I ketv.) | Vienetai
Įsigaliojusi atnaujinta paskatų verslui investuoti į MTEP sistema | n/a (2022 IV ketv.) | Įsigalioję teisės aktai
Paramą gavusios įmonės (iš kurių: labai mažos, mažosios, vidutinės ir didelės) | 1926 (2029) | Įmonės
Paramą gavusios įmonės (iš kurių: labai mažos) | n/a | Įmonės
Paramą gavusios įmonės (iš kurių: mažosios) | n/a | Įmonės
Paramą gavusios įmonės (iš kurių: vidutinės) | n/a | Įmonės
Paramą gavusios įmonės (iš kurių: didelės) | n/a | Įmonės
Paramą dotacijomis gavusios įmonės | 1626 (2029) | Įmonės
Nefinansinę paramą gavusios įmonės | 443 (2029) | Įmonės
Paramą gavusios naujos įmonės | 839 (2029) | Įmonės
Paramą gavusios sparčiai augančios įmonės | 839 (2029) | Įmonės
Paramą finansinėmis priemonėmis gavusios įmonės | 153 (2029) | Įmonės
Suinteresuotosios institucijos, dalyvaujančios verslininkystės galimybių paieškos procese | 278 (2029) | Institucinių suinteresuotų-jų šalių dalyvavimas
MVĮ, investuojančios į pažangiajai specializacijai, pramonės pertvarkai ir verslumui reikalingų įgūdžių ugdymą | 4990 (2029) | Įmonės
Nefinansinę paramą gaunančių įmonių ir viešojo sektoriaus įstaigų skaičius | 200 (2029) | Vienetai
Užmegzti kontaktai MTEPI srityje pagal sumaniosios specializacijos kryptis | 207 (2029) | Vienetai

PASTABOS:

1. * – Rodiklio žymuo „n/a“ reiškia „neaktualu“ pagal Finansų ministerijos ir Europos Komisijos pastabas.

2. ** – Rodiklio R-05-001-01-05-07-06 – Produktų ar procesų inovacijas diegiančios mažosios ir vidutinės įmonės (MVĮ) – 2021–2027 metų Europos Sąjungos fondų investicijų programoje nurodyta siektina rezultato rodiklio reikšmė yra 551. Bus teikiamas siūlymas tikslinti 2022–2030 metų plėtros programos valdytojos Lietuvos Respublikos ekonomikos ir inovacijų ministerijos ekonomikos transformacijos ir konkurencingumo plėtros programą, siekiant suvienodinti rezultato rodiklio reikšmes.

3. *** – Rodikliai R-05-001-01-05-07-16, R-05-001-01-05-07-17, R-05-001-01-05-07-18 ir R-05-001-01-05-07-19 – Paramą gavusios įmonės, iš jų: mažos ir labai mažos, paramą gavusios įmonės, iš jų: vidutinės, ir paramą gavusios įmonės, iš jų: didelės, yra Ekonomikos gaivinimo ir atsparumo didinimo plano „Naujos kartos Lietuva“ bendrieji rodikliai, kurie neturi siektinų reikšmių. Duomenys bus renkami iš susijusių reformų ir investicijų rodiklių. Ataskaitinis laikotarpis iki 2027 m. I ketv.

4. **** – Rodiklio R-05-001-01-05-07-20 – Pateiktos paraiškos konkrečiai MTEPI iniciatyvai – 2021–2027 metų Europos Sąjungos fondų investicijų programoje įtrauktas kaip specialusis rezultato rodiklis. Bus teikiamas siūlymas tikslinti 2022–2030 metų plėtros programos valdytojos Lietuvos Respublikos ekonomikos ir inovacijų ministerijos ekonomikos transformacijos ir konkurencingumo plėtros programą, siekiant įtraukti šį rezultato rodiklį į minėtą plėtros programą.

5. ***** – Rodikliu P-05-001-01-05-07-03 – Paskelbti kvietimai teikti pasiūlymus – bus skelbiami kvietimai veiklų „Įgyvendinti specializuotas startuolių akceleravimo programas“, „Pritraukti tarptautinį akceleratorių“, „Įgyvendintų inovatyvių projektų skaičius“, „Įsteigti Europos kosmoso agentūros verslo inkubavimo centrą“, „Pagerinti verslo prieigą prie finansinių šaltinių (Inovacijų fondas)“ įgyvendinamiems projektams.

6. ****** – Rodiklį P-05-001-01-05-07-06 – Įgyvendintų inovatyvių projektų skaičius – sudaro 3 subrodikliai: 1. Inovatyvių viešųjų pirkimų skatinimas, 2. „Industry Lab 4.0“ ir 3. Atrinktų projektų, skatinančių aplinkai palankių produktų arba technologijų sukūrimą ir (ar) diegimą, siekiant didinti mažų ir vidutinių įmonių konkurencingumą žaliųjų inovacijų srityje, skaičius. Subrodikliai „Industry Lab 4.0“ ir „Atrinktų projektų, skatinančių aplinkai palankių produktų arba technologijų sukūrimą ir (ar) diegimą, siekiant didinti mažų ir vidutinių įmonių konkurencingumą žaliųjų inovacijų srityje, skaičius“ bus įgyvendinami pažangos priemone Nr. 05-001-01-04-02 „Skatinti įmones pereiti link neutralios klimatui ekonomikos“. Šia pažangos priemone siekiama subrodiklio „Inovatyviųjų viešųjų pirkimų skatinimas“, kuris atitinka tarpinį Ekonomikos gaivinimo ir atsparumo didinimo plano „Naujos kartos Lietuva“ rodiklį 130.2.

Finansuojamos veiklos

1. Efektyvinti inovacijų politikos įgyvendinimą įsteigiant vieną inovacijų skatinimo agentūrą ir optimizuojant šiuo metu veikiančių agentūrų tinklą

2. Padidinti inovacijų paklausą Lietuvoje išnaudojant viešųjų pirkimų potencialą

3. Skatinti startuolių ekosistemos plėtrą

3.1. Įgyvendinti specializuotas startuolių akceleravimo programas

3.2. Pritraukti tarptautinį akceleratorių

3.3. Įsteigti Europos kosmoso agentūros verslo inkubavimo centrą

3.4. Pagerinti verslo prieigą prie finansinių šaltinių (Inovacijų fondas)

3.5. Įsteigti LT Space Hub ir įgyvendinti veiklas

4. Atlikti esamos etalonų sistemos įvertinimo studiją, pateikiant rekomendacijas dėl jos tobulinimo ir plėtros

5. Skatinti startuolių vystymą, akceleravimą ir plėtrą

5.1. Skatinti produkto idėjos vystymą per hakatonus ir inkubavimo paslaugas (Vidurio ir vakarų Lietuvos regionas)

5.2. Skatinti produkto idėjos vystymą (akceleravimo veiklos), skatinti investicijas pagal startuolių brandos lygį (Vidurio ir vakarų Lietuvos regionas)

6. Skatinti inovacijų pasiūlą

6.1. Investuoti į naujų aukštos pridėtinės vertės (toliau – APV) produktų kūrimo veiklas, sudaryti sąlygas tyrėjams dalyvauti įmonių mokslinių tyrimų ir eksperimentinės plėtros (toliau – MTEP) veiklose ir skatinti ankstyvąją sukurtų naujų produktų bandomąją gamybą, parengimą rinkai (Sostinės regionas)

6.2. Investuoti į naujų APV produktų kūrimo veiklas ir sudaryti sąlygas tyrėjams dalyvauti įmonių MTEP veiklose, skatinti intelektinę nuosavybę, ankstyvąją sukurtų naujų produktų bandomąją gamybą, parengimą rinkai

(Vidurio ir vakarų Lietuvos regionas)

6.3. Vykdyti specializuotas konsultavimo veiklas (Vidurio ir vakarų Lietuvos regionas)

7. Skatinti netechnologinių inovacijų plėtrą (Vidurio ir vakarų Lietuvos regionas)

8. Skatinti inovacijas viešajame sektoriuje (ikiprekybinius pirkimus)

8.1. Sudaryti paskatas verslui kurti naujus produktus viešojo sektoriaus poreikiams tenkinti (Sostinės regionas)

8.2. Sudaryti paskatas verslui kurti naujus produktus viešojo sektoriaus poreikiams tenkinti (Vidurio ir vakarų Lietuvos regionas)

8.3. Stiprinti perkančiųjų organizacijų gebėjimus inicijuoti ir vykdyti ikiprekybinius pirkimus, sudaryti paskatas verslui dalyvauti ikiprekybiniuose pirkimuose (Sostinės regione)

8.4.Stiprinti perkančiųjų organizacijų gebėjimus inicijuoti ir vykdyti ikiprekybinius pirkimus, sudaryti paskatas verslui dalyvauti ikiprekybiniuose pirkimuose (Vidurio ir vakarų Lietuvos regionas)

9. Skatinti MVĮ dalyvavimą tarptautinėse mokslinių tyrimų, eksperimentinės plėtros ir inovacijų (toliau – MTEPI) iniciatyvose

9.1. Skatinti MVĮ tarptautinę tinklaveiką, įsitraukimą į MTEPI partnerystės tinklus (Sostinės regionas)

9.2. Skatinti MVĮ tarptautinę tinklaveiką, įsitraukimą į MTEPI partnerystės tinklus (Vidurio ir vakarų Lietuvos regionas)

9.3. Stiprinti APV paremtų brandžių klasterių augimą, bendrų strategijų ir produktų kūrimą, dalyvavimą tarptautinėse programose, įsitraukimą į Baltijos jūros regiono, kitų tarptautinių MTEPI projektų rengimą ir dalyvavimą juose (Sostinės regionas)

9.4. Stiprinti APV paremtų brandžių klasterių augimą, bendrų strategijų ir produktų kūrimą, dalyvavimą tarptautinėse programose, įsitraukimą į Baltijos jūros regiono, kitų tarptautinių MTEPI projektų rengimą ir dalyvavimą juose (Vidurio ir vakarų Lietuvos regionas)

10. Skatinti tarptautinių užsienio investicijų (toliau -TUI) pritraukimą į MTEP

10.1 Skatinti APV TUI paieškos ir pritraukimo veiklas Lietuvoje (Vidurio ir vakarų Lietuvos regionas)

10.2. Skatinti APV TUI: MTEP vykdymą ir bendradarbiavimą bei technologijų perdavimą tarp didelių įmonių ir MVĮ technologijų ir inovacijų srityse (Vidurio ir vakarų Lietuvos regionas)

11. Ugdyti MVĮ reikalingus darbuotojų įgūdžius

11.1. Ugdyti MVĮ reikalingus darbuotojų įgūdžius (Sostinės regionas)

11.2. Ugdyti MVĮ reikalingus darbuotojų įgūdžius (Vidurio ir vakarų Lietuvos regionas)

12. Ugdyti MVĮ ir kitų VGPP dalyvaujančių subjektų darbuotojų gebėjimus

12.1. Ugdyti MVĮ ir kitų VGPP dalyvaujančių subjektų darbuotojų gebėjimus (Sostinės regionas)

12.2. Ugdyti MVĮ ir kitų VGPP dalyvaujančių subjektų darbuotojų gebėjimus (Vidurio ir vakarų Lietuvos regionas)

13. Skatinti trumpų vertės kūrimo grandinių formavimąsi ir plėtrą tarp MVĮ (Vidurio ir vakarų Lietuvos regionas)
| Kita informacija | -
| Dokumentai | https://e-seimas.lrs.lt/portal/legalAct/lt/TAD/5dd76c7009f511edbfe9c72e552dd5bd/asr
| Informacija apie kvietimą

Atsakinga institucija

☐ Lietuvos Respublikos aplinkos ministerija

☒ Lietuvos Respublikos ekonomikos ir inovacijų ministerija

☐ Lietuvos Respublikos energetikos ministerija

☐ Lietuvos Respublikos finansų ministerija

☐ Lietuvos Respublikos krašto apsaugos ministerija

☐ Lietuvos Respublikos kultūros ministerija

☐ Lietuvos Respublikos socialinės apsaugos ir darbo ministerija

☐ Lietuvos Respublikos susisiekimo ministerija

☐ Lietuvos Respublikos sveikatos apsaugos ministerija

☐ Lietuvos Respublikos švietimo, mokslo ir sporto ministerija

☐ Lietuvos Respublikos vidaus reikalų ministerija

☐ Lietuvos Respublikos žemės ūkio ministerija

☐ Vilniaus regiono plėtros taryba

☐ Alytaus regiono plėtros taryba

☐ Kauno regiono plėtros taryba

☐ Klaipėdos regiono plėtros taryba

☐ Marijampolės regiono plėtros taryba

☐ Panevėžio regiono plėtros taryba

☐ Šiaulių regiono plėtros taryba

☐ Tauragės regiono plėtros taryba

☐ Telšių regiono plėtros taryba

☐ Utenos regiono plėtros taryba
| Administruojančioji institucija | Viešoji įstaiga Inovacijų agentūra
| Projektų įgyvendinimo planų pateikimo terminas | Nuo 2022-12-23 14 val. 00 min. | | Iki 2023-03-31 17 val. 00 min.
| Programa | ☒ ES fondų investicijų programa ☐ Planas „Naujos kartos Lietuva“
| Regionas | ☐ Netaikoma ☒ Vidurio ir vakarų Lietuvos regionas ☐ Sostinės regionas
| Veiklos sritis | ☐ valstybės valdymas, regioninė politika ir viešasis administravimas; ☐ aplinka, miškai ir klimato kaita; ☐ energetika; ☐ viešieji finansai ir oficialioji statistika; ☒ ekonomikos konkurencingumas ir valstybės informaciniai ištekliai; ☐ valstybės saugumas ir gynyba; ☐ viešasis saugumas; ☐ kultūra ir visuomenės informavimas; ☐ socialinė apsauga ir užimtumas; ☐ transportas ir ryšiai; ☐ sveikata; ☒ švietimas, mokslas ir sportas; ☐ teisingumas; ☐ užsienio politika; ☐ žemės ir maisto ūkis, kaimo plėtra, žuvininkystė, veterinarija ir žemės tvarkymas
| Projektų atrankos būdas | ☐ Planavimas ☒ Konkursas ☐ Tęstinė atranka ☐ Jungtinis projektas
| Finansavimo forma | ☒ 01 Dotacija ☐ 02 Naudojantis finansinėmis priemonėmis teikiama parama: nuosavas arba kvazinuosavas kapitalas ☐ 03 Naudojantis finansinėmis priemonėmis teikiama parama: paskola ☐ 04 Naudojantis finansinėmis priemonėmis teikiama parama: garantija ☐ 05 Naudojantis finansinėmis priemonėmis teikiama parama: dotacijos, suteiktos vykdant finansinės priemonės veiksmą ☐ 06 Apdovanojimas

Konkretus uždavinys arba priemonė (reforma ar investicija)

- Paslaugų kokybės ir prieinamumo gerinimas bei inovacijų skatinimas
- Ilgalaikės priežiūros paslaugų teikimo reforma
- Sveikatos sistemos atsparumo dirbti ekstremalioms situacijoms sisteminis stiprinimas
- Daugiau šalyje tvariai pagamintos elektros energijos
- Judame neteršdami aplinkos
- Spartesnė pastatų renovacija ir tvari urbanistinė aplinka
- Žiedinės ekonomikos link
- ŠESD absorbcinių pajėgumų didinimas
- Valstybės informacinių technologijų valdymo pertvarka
- Duomenų valdymo efektyvumo užtikrinimas ir atviri duomenys
- Į klientą orientuotos paslaugos
- „Žingsnis 5G link“
- Būtinosios sąlygos inovatyviems technologiniams sprendimams versle ir kasdieniame gyvenime
- Šiuolaikiškas bendrasis ugdymas – pagrindas įgyti bazines kompetencijas
- Prieinamos kompetencijų plėtojimo ir kvalifikacijų pripažinimo galimybės suaugusiems
- Profesinio orientavimo sistema darbo rinkos pasiūlai ir paklausai subalansuoti
- Kompetencijos žaliajai ir skaitmeninei transformacijai įgyjamos profesinio mokymo sistemoje
- Kokybiškas aukštasis mokslas ir stiprios mokslo ir studijų institucijos
- Efektyvus inovacijų politikos įgyvendinimas ir didesnė inovacijų paklausa, startuolių ekosistemos ir žaliųjų inovacijų plėtra
- Bendros mokslo ir inovacijų misijos Sumaniosios specializacijos srityse
- Veiksmingas viešasis sektorius
- Teisingesnė ir augti palanki mokesčių sistema
- Nacionalinio biudžeto ilgalaikis tvarumas ir skaidrumas
- Mokestinių prievolių vykdymo gerinimas
- Verslui prieinami įrankiai valdyti nemokumo riziką
- Išmanus mokesčių administravimas sparčiau mažinti PVM atotrūkį
- Elektroninių dokumentų ekosistemos vystymas
- Vienas langelis prievolėms valstybei sumokėti
- Į klientą orientuotas užimtumo rėmimas
- Garantuota minimalių pajamų apsauga

☒ Plėtoti ir stiprinti mokslinių tyrimų ir inovacinius pajėgumus ir diegti pažangiąsias technologijas

- Pasinaudoti skaitmeninimo teikiama nauda piliečiams, įmonėms, mokslinių tyrimų organizacijoms ir valdžios institucijoms
- Stiprinti tvarų MVĮ augimą bei konkurencingumą ir darbo vietų kūrimą MVĮ, be kita ko pasitelkiant gamybines investicijas
- Ugdyti pažangiajai specializacijai, pramonės pertvarkai ir verslumui reikalingus įgūdžius
- Skatinti energijos vartojimo efektyvumą ir mažinti išmetamų šiltnamio efektą sukeliančių dujų kiekį
- Skatinti atsinaujinančiąją energiją pagal Direktyvą (ES) 2018/2001, įskaitant joje nustatytus tvarumo kriterijus
- Plėtoti pažangiąsias elektros energijos sistemas, tinklus ir energijos kaupimo ne transeuropiniame energetikos tinkle (TEN-E) sprendimus
- Skatinti prisitaikymą prie klimato kaitos ir nelaimių rizikos prevenciją, atsparumą, atsižvelgiant į ekosisteminius metodus
- Skatinti prieigą prie vandens ir tvarią vandentvarką
- Skatinti perėjimą prie žiedinės ir efektyvaus išteklių naudojimo ekonomikos
- Stiprinti gamtos, biologinės įvairovės ir žaliosios infrastruktūros apsaugą ir išsaugojimą, be kita ko, miestų teritorijose ir mažinti visų rūšių taršą
- Plėtoti klimato kaitai atsparų, pažangų, saugų, tvarų ir įvairiarūšį TEN-T
- Plėtoti ir stiprinti tvarų, klimato kaitai atsparų, pažangų ir įvairiarūšį nacionalinį, regioninį ir vietos judumą, įskaitant geresnes galimybes naudotis TEN-T ir tarpvalstybinį judumą
- Suteikti daugiau galimybių įsidarbinti ir pasinaudoti aktyvumo priemonėmis visiems darbo ieškantiems asmenims, visų pirma jaunimui, ypač įgyvendinant Jaunimo garantijų iniciatyvą, ilgalaikiams bedarbiams ir darbo rinkoje palankių sąlygų neturinčioms grupėms bei ekonomiškai neaktyviems žmonėms, taip pat propaguoti savarankišką veiklą ir socialinę ekonomiką
- Gerinti švietimo ir mokymo sistemų kokybę, įtraukumą, veiksmingumą ir jų aktualumą darbo rinkos atžvilgiu, be kita ko pripažįstant neformaliojo ir savaiminio mokymosi rezultatus, siekiant padėti įgyti bendrąsias kompetencijas verslumo ir skaitmeninius įgūdžius, ir skatinti taikyti dualines švietimo ir profesinio mokymo sistemas
- Skatinti, kad visi, visų pirma palankių sąlygų neturinčios grupės, turėtų vienodas galimybes gauti kokybiškas ir įtraukias švietimo ir mokymo paslaugas ir užbaigti mokslą, pradedant ikimokykliniu ugdymu ir priežiūra, taip pat bendruoju lavinimu ir profesiniu rengimu bei mokymu, baigiant tretiniu išsilavinimu ir suaugusiųjų švietimu ir mokymusi, be kita ko, visiems sudaryti palankesnes sąlygas judumui mokymosi tikslais ir užtikrinant prieinamumą neįgaliesiems
- Skatinti mokymąsi visą gyvenimą, visų pirma siekti, kad visi turėtų lanksčių kvalifikacijos kėlimo ir persikvalifikavimo galimybių, atsižvelgiant į verslumo ir skaitmeninius įgūdžius, geriau numatyti pokyčius ir naujų įgūdžių reikalavimus, grindžiamus darbo rinkos poreikiais, sudaryti palankesnes sąlygas keisti profesinę veiklą ir skatinti profesinį judumą
- Gerinti vienodas galimybes naudotis įtraukiomis ir kokybiškomis švietimo, mokymo ir mokymosi visą gyvenimą paslaugomis plėtojant prieinamą infrastruktūrą, be kita ko, didint atsparumą naudojantis nuotoliniu ir internetiniu švietimu bei mokymu (ERPF)
- Stiprinti kultūros ir darnaus turizmo vaidmenį ekonominės plėtros, socialinės įtraukties ir socialinių inovacijų srityse (ERPF)
- Skatinti aktyvią įtrauktį, siekiant propaguoti lygias galimybes, nediskriminavimą ir aktyvų dalyvavimą, ir gerinti įsidarbinamumą, ypač palankių sąlygų neturinčių grupių
- Suteikti daugiau vienodų galimybių už prieinamą kainą laiku gauti kokybiškas ir tvarias paslaugas, įskaitant paslaugas, kuriomis skatinamos galimybės gauti būstą ir į asmenį orientuotą priežiūrą, įskaitant sveikatos priežiūrą; modernizuoti socialinės apsaugos sistemas, be kita ko, skatinti, kad būtų suteikta galimybė naudotis socialine apsauga, daugiau dėmesio skiriant vaikams ir palankių sąlygų neturinčioms grupėms; gerinti sveikatos priežiūros sistemų ir ilgalaikės priežiūros paslaugų prieinamumą, taip pat ir neįgaliesiems, rezultatyvumą ir tvarumą
- Skatinti marginalizuotų bendruomenių, mažas pajamas gaunančių namų ūkių ir nepalankioje padėtyje esančių grupių, įskaitant specialiųjų poreikių turinčius asmenis, socialinę ir ekonominę įtrauktį vykdant integruotus veiksmus, be kita ko, teikti aprūpinimą būstu ir socialines paslaugas (ERPF)
- Užtikrinti vienodas galimybes naudotis sveikatos priežiūros paslaugomis, didinti sveikatos priežiūros sistemų, įskaitant pirminę sveikatos priežiūrą, atsparumą, ir skatinti perėjimą nuo institucinės globos prie globos šeimoje ir bendruomeninės globos (ERPF)
- Skatinti integruotą ir įtraukią socialinę, ekonominę ir aplinkosaugos plėtrą, puoselėti kultūrą, gamtos paveldą, darnų turizmą ir saugumą miestų teritorijose
- Skatinti integruotą ir įtraukią socialinę, ekonominę ir aplinkosaugos plėtrą vietos lygmeniu, puoselėti kultūrą, gamtos paveldą, darnų turizmą ir saugumą kitose nei miestų teritorijose
- Suteikti daugiau vienodų galimybių už prieinamą kainą laiku gauti kokybiškas ir tvarias paslaugas, įskaitant paslaugas, kuriomis skatinamos galimybės gauti būstą ir į asmenį orientuotą priežiūrą, įskaitant sveikatos priežiūrą; modernizuoti socialinės apsaugos sistemas, be kita ko, skatinti, kad būtų suteikta galimybė naudotis socialine apsauga, daugiau dėmesio skiriant vaikams ir palankių sąlygų neturinčioms grupėms; gerinti sveikatos priežiūros sistemų ir ilgalaikės priežiūros paslaugų prieinamumą, taip pat ir neįgaliesiems, rezultatyvumą ir tvarumą
- Skaitmeninis ryšys
- Tvarus judumas mieste

| Bendra kvietimui skirta finansavimo lėšų suma | 1 800 000 Eur
| Didžiausia galima skirti finansavimo lėšų suma projektui įgyvendinti | 200 000 Eur
| Finansuojamos veiklos ir joms keliami reikalavimai
2.12.1 | Finansuojamos projektų veiklos
| 05-001-01-05-07-06-02 | Investuoti į naujų APV produktų kūrimo veiklas ir sudaryti sąlygas tyrėjams dalyvauti įmonių MTEP veiklose, skatinti intelektinę nuosavybę, ankstyvąją sukurtų naujų produktų bandomąją gamybą, parengimą rinkai (Vidurio ir vakarų Lietuvos regionas)
2.12.2 | Tikslinės grupės | Pradedantieji inovatoriai
2.12.3 | Galimi pareiškėjai | Labai mažos, mažos ir vidutinės įmonės (toliau – MVĮ), didelės įmonės, kai bendradarbiauja su MVĮ.
2.12.4 | Galimi partneriai | MVĮ, kai pareiškėjas didelė įmonė; mokslo ir studijų institucijos (toliau – MSI), MVĮ/didelė įmonė, jei pareiškėjas MVĮ.

### 2.12.5

Nuosavo įnašo dydis (jei taikoma)

Ne mažiau 50 proc.* nuo tinkamų finansuoti išlaidų sumos moksliniams tyrimams;

Ne mažiau 75 proc.* nuo tinkamų finansuoti išlaidų sumos eksperimentinei plėtrai;

Ne mažiau 15 proc. nuo tinkamų finansuoti išlaidų patentavimo ir veikloms, susijusioms su sukurto produkto parengimu rinkai.

*Pagalbos intensyvumas gali būti padidintas iki 80 proc. tinkamų finansuoti išlaidų:

10 procentinių punktų vidutinėms įmonėms ir 20 procentinių punktų labai mažoms ir mažoms įmonėms;

15 procentinių punktų padidinama už veiksmingą bendradarbiavimą, jei tenkinamos Reglamento (ES) Nr. 651/2014 25 straipsnio 6 dalies b punkto i papunktyje nurodytos sąlygos.
| Išlaidų tinkamumo reikalavimai

PFSA 9 punkte nurodyti išlaidų tinkamumo finansuoti reikalavimai:

„9.1. Projekto išlaidos turi atitikti PFSA 5.4* ir 5.18** papunkčiuose nustatytus tinkamumo ir Projektų administravimo ir finansavimo taisyklių VII skyriuje išdėstytus projekto išlaidoms taikomus reikalavimus.

9.2. Projekto tinkamų finansuoti išlaidų dalis, kurios nepadengia projektui skiriamo finansavimo lėšos, turi būti finansuojama iš projekto vykdytojo (partnerio) lėšų.

9.3. Pareiškėjas savo iniciatyva ir savo ir (arba) kitų šaltinių lėšomis gali prisidėti prie projekto įgyvendinimo didesne, nei reikalaujama, lėšų suma.

9.4. Kryžminis finansavimas netaikomas.“.

*5.4. Tinkamos finansuoti projekto lėšomis išlaidos, taikant Reglamento (ES) Nr. 651/2014 25 straipsnį, yra:

5.4.1. MTEP paslaugų įsigijimo iš išorės šaltinių įprastomis rinkos sąlygomis, išlaidos (t. y. kai perkama iš išorinių šaltinių už rinkos kainas, pagal šalių sudarytą sandorį, kai nėra jokių susijusių slapto susitarimo elementų).

5.4.2. Išlaidos, susijusios su konsultavimo ir lygiaverčių paslaugų, skirtų vien tik projekto MTEP veiklai, įsigijimu, taip pat išlaidos dėl MTEP veiklai reikalingų paslaugų, kurios nėra MTEP ir be jų nebus pasiekti projekto tikslai, įsigijimo; Šios išlaidos yra tinkamos finansuoti, kai paslaugos įsigyjamos iš išorės šaltinių įprastomis rinkos sąlygomis, t. y. kai perkama iš išorinių šaltinių už rinkos kainas, pagal šalių sudarytą sandorį, kai nėra jokių susijusių slapto susitarimo elementų.

5.4.3. Su kitomis veiklos sąnaudomis, įskaitant sąnaudas medžiagoms, mažaverčiam inventoriui, atsargoms ir panašiems produktams, priskirtiniems trumpalaikiam turtui, tiesiogiai susijusiomis su MTEP veikla, susijusios išlaidos.

5.4.4. Projekto MTEP veikloms naudojamo turto (įrangos, prietaisų, įrankių, įrenginių, mašinų ir įrengimų pastatų ir (ar) patalpų) nusidėvėjimo sąnaudos, jeigu šiam turtui įsigyti nebuvo naudojamos viešosios (įskaitant ir kitų valstybių) lėšos (ne daugiau nei 50 procentų tinkamų finansuoti išlaidų). MTEP veikloms naudojamo turto nusidėvėjimo sąnaudos turi būti apskaičiuotos projekto įgyvendinimo laikotarpiui.

5.4.5. Projektą vykdančio personalo darbo užmokestis ir su juo susijusios išlaidos, apskaičiuotos teisės aktų, reguliuojančių darbo užmokestį ir darbo santykius, nustatyta tvarka.

5.4.6. Projektą vykdančio personalo komandiruočių išlaidos, apskaičiuotos komandiruočių išlaidas reguliuojančių teisės aktų nustatyta tvarka.

5.4.7. Tiesiogiai su projekto įgyvendinimu susijusios ir veiklai proporcingai (pro rata principu) paskirstytos pridėtinės išlaidos – įrangos nuomos išlaidos.

5.4.8. Tiesiogiai su projekto įgyvendinimu susijusios ir veiklai proporcingai (pro rata principu) paskirstytos pridėtinės išlaidos – projektui įgyvendinti būtinų pastatų ar patalpų nuomos išlaidos (ne daugiau nei 10 procentų tinkamų finansuoti išlaidų).

5.4.9. PFSA 5.4.1–5.4.2 papunkčiuose nurodytos išlaidos kartu negali sudaryti daugiau nei 50 procentų tinkamų finansuoti PFSA 5.1 papunktyje nurodytai veiklai skirtų išlaidų.

**5.18. Tinkamos finansuoti projekto lėšomis išlaidos, taikant Reglamentą (ES) 1407/2013, yra:

5.18.1. Patentinių patikėtinių teikiamos su išradimų patentavimu susijusios paslaugos.

5.18.2. Mokesčiai už išradimų patentavimą.

5.18.3. Išlaidos, susijusios su projekto metu sukurto produkto parengimu rinkai.
| Projektų veiklų įgyvendinimui taikomi supaprastintai apmokamų išlaidų dydžiai

☐ Indeksuojama

X Neindeksuojama
Supaprastintai apmokamų išlaidų dydžio kodas | Supaprastintai apmokamų išlaidų dydžio versija | Supaprastintai apmokamų išlaidų dydžio pavadinimas | Papildoma informacija
IFS- | - | Patentinės paraiškos pateikimo išlaidos | Fiksuotąją sumą sudaro išlaidos patentiniam patikėtiniui (nustatoma pagal mažiausios kainos komercinį pasiūlymą ar pasirašytą sutartį su patentiniu patikėtiniu) ir su patentinės paraiškos pateikimu susiję mokesčiai (nustatomi pagal konkretaus mokesčio dydį pagrindžiančias nuorodas).
IFS- | - | Išlaidos, susijusios su patento gavimu | Fiksuotąją sumą sudaro išlaidos patentiniam patikėtiniui (nustatoma pagal mažiausios kainos komercinį pasiūlymą ar pasirašytą sutartį su patentiniu patikėtiniu) ir su patentinės paraiškos pateikimu susiję mokesčiai (nustatomi pagal konkretaus mokesčio dydį pagrindžiančias nuorodas).
IFS- | - | Išlaidos, susijusios su projekto metu sukurto produkto parengimu rinkai | Fiksuotoji suma nustatoma pagal mažiausios kainos komercinį pasiūlymą arba pasirašytą pirkimo –pardavimo sutartį.
| Siekiami stebėsenos rodikliai
Rodiklio pavadinimas | | Rodiklio kodas | Matavimo vienetai | | Siektina reikšmė
Paramą gavusios įmonės (iš kurių: labai mažos, mažosios, vidutinės ir didelės) | | P-05-001-01-05-07-08 (P.B.2.0001) | Įmonės | | 384 (2029)
Paramą gavusios įmonės (iš kurių: labai mažos) | | P-05-001-01-05-07-09 (P.B.2.0001.1) | Įmonės | | n/a
Paramą gavusios įmonės (iš kurių: mažosios) | | P-05-001-01-05-07-10 (P.B.2.0001.2) | Įmonės | | n/a
Paramą gavusios įmonės (iš kurių: vidutinės) | | P-05-001-01-05-07-11 (P.B.2.0001.3) | Įmonės | | n/a
Paramą gavusios įmonės (iš kurių: didelės) | | P-05-001-01-05-07-12 (P.B.2.0001.4) | Įmonės | | n/a
Paramą dotacijomis gavusios įmonės | | P-05-001-01-05-07-13 (P.B.2.0002) | Įmonės | | 417 (2029)
Privačiosios investicijos, papildančios viešąją paramą (iš kurių: dotacijos, finansinės priemonės | | R-05-001-01-05-07-03 (R.B.2.2002) | Eurai | | 117 103 871 (2029)
Privačiosios investicijos, papildančios viešąją paramą (iš kurių: dotacijos) | | R-05-001-01-05-07-21 (R.B.2.2002.1) | Eurai | | n/a
Paramą gavusiuose subjektuose sukurtos mokslo tiriamojo darbo vietos | | R-05-001-01-05-07-05 (R.B.2.2102) | Vienų metų etato ekvivalentai | | 145 (2029)
Investicijas gavusios įmonės pajamų, gautų iš tiesiogiai projekto metu sukurtų ir rinkai pateiktų produktų, santykis su skirtomis investicijomis | | R-05-001-01-05-07-25 (R.N.2 5640) | Procentai | | 398 (2029)
| Bendrieji reikalavimai
| Reikalavimai projektams

PFSA 2 punkte nurodyti reikalavimai projektams:

„2.1. Remiama veikla: investuoti į naujų APV produktų kūrimo veiklas ir sudaryti sąlygas tyrėjams dalyvauti įmonių MTEP veiklose, skatinti intelektinę nuosavybę, ankstyvąją sukurtų naujų produktų bandomąją gamybą, parengimą rinkai (Vidurio ir vakarų Lietuvos regionas).

2.2. Pareiškėjams keliami reikalavimai:

2.2.1. Galimi pareiškėjai – labai mažos, mažos ir vidutinės įmonės (toliau – MVĮ), didelės įmonės, kai bendradarbiauja su MVĮ. Pareiškėjas turi atitikti pradedančiojo inovatoriaus apibrėžimą.

2.2.2. Projekto partneriai – MVĮ, kai pareiškėjas didelė įmonė; mokslo ir studijų institucijos (toliau – MSI), MVĮ ar didelė įmonė, jei pareiškėjas MVĮ.

2.2.3. Vienas pareiškėjas gali pateikti tik vieną PĮP pagal Projektų administravimo ir finansavimo taisyklių 1 priedą.

2.2.4. Kai PĮP teikiama kartu su partneriu (-iais), prie PĮP turi būti pridedama galiojančios jungtinės veiklos (partnerystės) sutarties kopija. Jungtinės veiklos (partnerystės) sutartį pasirašo pareiškėjas ir visi projekto partneriai.

2.2.5. Pareiškėjas ir partneris (-iai) vienas kito atžvilgiu turi būti savarankiškos įmonės, jeigu pretenduojama į projekto finansuojamosios dalies padidinimą už veiksmingą bendradarbiavimą, kaip nustatyta PFSA 5.3.2 papunktyje.

2.2.6. Finansavimas gali būti skiriamas pareiškėjams ir partneriams visose srityse, išskyrus Reglamento (ES) Nr. 1407/2013 1 straipsnio 1 dalyje išvardytus sektorius ir veiklas, Reglamento Nr. 651/2014 1 straipsnio 2–5 dalyse ir 25 straipsnyje nustatytus apribojimus bei Reglamento (ES) Nr. 2021/1058 7 straipsnio 1–6 dalyse nustatytus atvejus.

2.2.7. Finansavimas nėra skiriamas pareiškėjui:

2.2.7.1 jeigu pareiškėjas ir (arba) partneris (-iai) nėra sugrąžinęs anksčiau gautos valstybės pagalbos, kuri Europos Komisijos sprendimu pripažinta neteisėta ir nesuderinama su vidaus rinka.

2.2.7.2. Sunkumus patiriančioms įmonėms, kaip apibrėžta Reglamento (ES) Nr. 651/2014 2 straipsnio 18 punkte.

2.2.7.3. Kuriam pritaikytos tarptautinės sankcijos ir (arba) jo ir (arba) su juo susijusių įmonių vykdomoje veikloje, veiksmuose, sandoriuose dalyvauja subjektai, kuriems pritaikytos tarptautinės sankcijos, kai šių įmonių veiklos, veiksmų ir (ar) sandorių vykdymas draudžiamas ar prieštarauja Lietuvos Respublikoje įgyvendinamoms tarptautinėms sankcijoms, vadovaujantis Ekonominių ir kitų tarptautinių sankcijų įgyvendinimo įstatymo 9 straipsniu (Juridinių asmenų ar kitų organizacijų, neturinčių juridinio asmens statuso, kurios nuosavybės teise priklauso arba yra kontroliuojamos subjekto, kuriam taikomos sankcijos sąrašas skelbiamas Finansinių nusikaltimų tyrimų tarnybos svetainėje https://fntt.lt/lt/tarptautines-finansines-sankcijos/4166), arba veikloje, veiksmuose, sandoriuose dalyvauja užsieniečiai, įtraukti į užsieniečių, kuriems draudžiama atvykti į Lietuvos Respubliką, viešąjį sąrašą, skelbiamą Migracijos departamento prie Lietuvos Respublikos vidaus reikalų ministerijos interneto svetainėje https://www.migracija.lt/app/nam.

2.3. Projektams keliami reikalavimai:

2.3.1. Visos projekto veiklos (ir pareiškėjo, ir partnerių) įgyvendinamos Vidurio ir vakarų Lietuvos regione.

2.3.2. Projektų veiklų įgyvendinimo trukmė turi būti ne ilgesnė kaip 18 mėnesių nuo iš Europos Sąjungos (toliau – ES) fondų investicijų programos lėšų bendrai finansuojamo projekto sutarties pasirašymo dienos. Dėl objektyvių priežasčių, kurių projekto vykdytojas negalėjo numatyti PĮP pateikimo ir vertinimo metu, projekto veiklų įgyvendinimo laikotarpis gali būti pratęstas Projektų administravimo ir finansavimo taisyklių IV skyriaus antrame skirsnyje nustatyta tvarka, bet ne ilgiau kaip iki PFSA 2.3.8 papunktyje nurodyto termino.

2.3.3. Projektui taikomi visi pirmiau išvardyti stebėsenos rodikliai, kurių metodiniai skaičiavimo aprašai skelbiami kartu su kvietimu. Projekto vykdytojui nepasiekus įgyvendinimo stebėsenos rodiklių reikšmių, nurodytų projekto sutartyje, taikomos Projektų administravimo ir finansavimo taisyklių IV skyriaus penktojo skirsnio 171–178 punktų nuostatos.

2.3.4. Pagal šį PFSA projektams įgyvendinti skiriama iki 1 800 000,00 (vieno milijono aštuonių šimtų tūkstančių) eurų ES fondų investicijų programos (Europos regioninės plėtros fondo) lėšų. Jeigu paskelbus kvietimą pagal teigiamai įvertintus ir vertinamus PĮP prašoma skirti finansavimo lėšų suma yra didesnė negu kvietimui skirta lėšų suma, administruojančioji institucija gali teikti pasiūlymą Lietuvos Respublikos ekonomikos ir inovacijų ministerijai (toliau – Ministerija) dėl kvietime numatytos finansavimo sumos padidinimo. Ministerijos pritarimu pagal kvietimą teikti PĮP numatyta skirti lėšų suma gali būti padidinta, neviršijant pažangos priemonėje šiai veiklai skirtos lėšų sumos.

2.3.5. Didžiausia galima projektui skirti finansavimo lėšų suma yra 200 000,00 (du šimtai tūkstančių) eurų.

2.3.6. Mažiausia galima projektui skirti finansavimo lėšų suma yra 40 000,00 (keturiasdešimt tūkstančių) eurų.

2.3.7. Projektų atranka atliekama konkurso būdu;

2.3.8. Projekto veiklos turi būti baigtos ne vėliau kaip iki 2029 m. rugsėjo 1 d.

2.3.9. Pareiškėjai ir projektai turi atitikti bendruosius projektų atrankos kriterijus, kurių sąrašas ir vertinimo metodika nustatyti Projektų administravimo ir finansavimo taisyklių 2 priede ir atitikti PFSA 6 punkte nustatytus specialiuosius kriterijus, patvirtintus 2021–2027 metų ES fondų investicijų veiksmų programos stebėsenos komiteto 2022 m. spalio 20 d. posėdžio protokoliniu sprendimu Nr. 46P-3(3). Už atitiktį prioritetiniams projektų atrankos kriterijams projektams skiriami balai, kaip nustatyta PFSA 6 punkte.

2.3.10. Pareiškėjas su PĮP pateiktame PFSA 4 priede nurodo, kuriai iš Koncepcijoje nustatytų mokslinių tyrimų ir eksperimentinės plėtros ir inovacijų (toliau – MTEPI) (sumaniosios specializacijos) prioritetų (toliau – MTEPI prioritetai) priskirtinas projektas, taip pat nurodo, kurią MTEPI prioriteto įgyvendinimo tematiką atitinka projektas. Galutinį atitikimą konkrečiam MTEPI prioritetui ir įgyvendinimo tematikai nustato administruojančioji institucija vertinimo metu.

2.3.11. Projekto veiklos negali būti finansuotos ar finansuojamos iš kitų Lietuvos Respublikos valstybės biudžeto ir (arba) savivaldybių biudžetų, kitų piniginių išteklių, kuriais disponuoja valstybė ir (ar) savivaldybės, ES investicijų fondų, kitų ES finansinės paramos priemonių ar kitos tarptautinės paramos lėšų ir už kurias sumokėti skyrus ES investicijų fondų lėšų jos būtų pripažintos tinkamomis finansuoti ir (arba) už jas turi būti sumokėta daugiau nei vieną kartą, įskaitant de minimis pagalbą.

2.3.12. Finansavimas nėra skiriamas pareiškėjui, jeigu jis yra gavęs finansavimą pagal 2022–2030 metų plėtros programos valdytojos Lietuvos Respublikos ekonomikos ir inovacijų ministerijos ekonomikos transformacijos ir konkurencingumo plėtros programos ir 2022–2030 metų plėtros programos valdytojos Lietuvos Respublikos švietimo, mokslo ir sporto ministerijos mokslo plėtros programos pažangos priemonės Nr. 05-001-01-05-06/12-001-01-03-01 „Įgyvendinti misijomis grįstas mokslo ir inovacijų programas“ veiklą „Bendros misijų programos“.

2.3.13. Projekto veikla turi būti pradėta įgyvendinti ne vėliau kaip per 1 mėnesį nuo projekto sutarties pasirašymo dienos.

2.4. Pareiškėjas turi parengti ir kartu su PĮP administruojančiajai institucijai pateikti šiuos dokumentus Projektų administravimo ir finansavimo taisyklių III skyriaus antrame skirsnyje ir kvietimo skelbime nustatyta tvarka:

2.4.1. Partnerio deklaraciją, jei projektas įgyvendinamas kartu su partneriu (-iais), pagal Projektų administravimo ir finansavimo taisyklių 1 priedo 1 priedą.

2.4.2. Informaciją apie projekto biudžeto paskirstymą, jei projektas įgyvendinamas kartu su partneriu (-iais), pagal Projektų administravimo ir finansavimo taisyklių 1 priedo 2 priedą.

2.4.3. Informaciją apie pareiškėjui suteiktą valstybės pagalbą (išskyrus de minimis), kuriame nurodoma tik su teikiamu projektu susijusi suteikta arba planuojama gauti pagalba, pagal Projektų administravimo ir finansavimo taisyklių 1 priedo 4 priedą.

2.4.4. Užpildytą šio PFSA 4 priedą, kuriame pateikiama informacija, reikalinga projekto atitikčiai projektų atrankos kriterijams įvertinti.

2.4.5. MTEP verslo planą, parengtą pagal Kvietime teikti PĮP pateiktus rekomenduojamus formos ir turinio reikalavimus.

2.4.6. Pareiškėjo (partnerio), jei projektas įgyvendinamas su partneriu (-iais), Smulkiojo ar vidutinio verslo subjekto statuso deklaraciją, kurios forma patvirtinta Lietuvos Respublikos ūkio ministro 2008 m. kovo 26 d. įsakymu Nr. 4-119 „Dėl Smulkiojo ar vidutinio verslo subjekto statuso deklaravimo tvarkos aprašo ir Smulkiojo ar vidutinio verslo subjekto statuso deklaracijos formos patvirtinimo“ (pareiškėjas ir partneris (-iai) gali pateikti laisvos formos deklaraciją, jei jie priskirtini didelėms įmonėms). Jei į Smulkiojo ar vidutinio verslo subjekto statuso deklaraciją įtraukiamos užsienio įmonės, pareiškėjas privalo pateikti jų patvirtintus finansinės atskaitomybės ir akcininkų struktūrą patvirtinančius dokumentus.

2.4.7. Dokumentus, pagrindžiančius projekto biudžeto pagrįstumą (komerciniai pasiūlymai, nuorodos į rinkos esančias kainas ir kita (jei projekte numatytos patentavimo ir/ar projekto metu sukurto produkto parengimo rinkai veiklos, išlaidų pagrindimui turi būti pateikiama po tris lygiaverčius komercinius pasiūlymus)).

2.4.8. Finansavimo šaltinius (pareiškėjo ir (ar) partnerio (-ių) įnašą ir netinkamų finansuoti išlaidų padengimą) pagrindžiančius dokumentus.

2.4.9. Jungtinės veiklos (partnerystės) sutarties kopiją, jeigu projektas įgyvendinamas kartu su partneriu (-iais). Jungtinės veiklos (partnerystės) sutartyje turi būti aiškiai išdėstyti šalių įsipareigojimai ir teisės projekto atžvilgiu (nurodytas kiekvienos šalies finansinis ir dalykinis indėlis į projektą, kokias veiklas vykdys kiekviena šalis, teisės į bendrai sukurtą ar įgytą turtą, laikantis finansinės apskaitos principų, projekto rezultatai ir kita) ir šalių atsakomybė, taip pat įsipareigojimai laikytis pagrindinių geros partnerystės praktikos taisyklių.

2.4.10. Jei projekto veikla (-os) finansuojamos pagal Reglamentą (ES) 1407/2013, užpildytą šio PFSA 5 priedą, kuriame pateikiama „Vienos įmonės“ deklaracija.

2.5. Projekto parengtumui taikomas reikalavimas, kurio neįvykdžius ir kartu su PĮP nepateikus pagrindžiančių dokumentų, PĮP atmetama neprašius papildomų dokumentų: turi būti parengtas MTEP verslo planas.

2.6. Nustatant, ar projekte numatyta veikla yra MTEP veikla, vadovaujamasi „Frascati vadovas 2015: Mokslinių tyrimų ir eksperimentinės plėtros duomenų rinkimo bei teikimo rekomendacijos. Mokslinės, technologinės ir inovacinės veiklos vertinimas“.

2.7. Jei pareiškėjas veiklą vykdo trumpiau nei 1 metus arba neturi patvirtintų finansinės atskaitomybės dokumentų, kartu su teikiamais dokumentais privalo pateikti tarpinius patvirtintus finansinės atskaitomybės dokumentus ar kitus pareiškėjo pajamas patvirtinančius dokumentus.

2.8. Projektas gali būti pradėtas įgyvendinti ne anksčiau nei po PĮP registravimo administruojančioje institucijoje dienos, tačiau projekto išlaidos nuo PĮP registravimo administruojančioje institucijoje dienos iki finansavimo projektui skyrimo yra patiriamos pareiškėjo rizika.

2.9. Jeigu projektas, kuriam prašoma finansavimo, pradedamas įgyvendinti iki PĮP registravimo administruojančioje institucijoje dienos, visas projektas tampa netinkamas ir jam finansavimas neskiriamas.

2.10. Papildomi matomumo reikalavimai, nenurodyti Projektų administravimo ir finansavimo taisyklėse, nėra taikomi.

2.11. Informavimas apie projektą atliekamas Projektų administravimo ir finansavimo taisyklių VIII skyriaus pirmajame skirsnyje nustatyta tvarka.

2.12. Visi su projekto įgyvendinimu susiję dokumentai turi būti saugomi Projektų administravimo ir finansavimo taisyklių VIII skyriaus šeštajame skirsnyje nustatyta tvarka ir terminais, taip pat laikantis Reglamento (ES) Nr. 651/2014 12 straipsnio 1 punkte ir Reglamento (ES) Nr. 1407/2013 6 straipsnio 4 punkte nustatytų terminų. Visi su projekto įgyvendinimu susiję dokumentai saugomi Ministerijoje 10 metų nuo paskutinės pagalbos pagal schemą suteikimo dienos.“.
| Horizontaliųjų principų ir atitinkamų Europos Sąjungos pagrindinių teisių chartijos nuostatų laikymosi reikalavimai

PFSA 3 punkte numatyti horizontaliųjų principų reikalavimai:

„3.1. Neutralus – projektas negali daryti neigiamo poveikio HP.

3.2. Projektų atitikties reikšmingos žalos nedarymo HP vertinimo reikalavimų aprašas pateikiamas PFSA 1 priede.

3.3. Poveiklė, vadovaujantis Europos Komisijos 2021 m. vasario 12 d. patvirtintomis Reikšmingos žalos nedarymo principo taikymo pagal Ekonomikos atsparumo ir didinimo priemonės reglamentą techninėmis gairėmis (https://eur-lex.europa.eu/legal-content/EN/TXT/PDF/?uri=CELEX:52021XC0218(01)&from=EN), atitinka reikšmingos žalos nedarymo principą, nes neturi neigiamo numatomo poveikio 6 aplinkos tikslams, nurodytiems 2020 m. birželio 18 d. Europos Parlamento ir Tarybos reglamento (ES) Nr. 2020/852 dėl sistemos tvariam investavimui palengvinti sukūrimo, kuriuo iš dalies keičiamas Reglamentas (ES) 2019/2088 (https://eur-lex.europa.eu/legal-content/LT/TXT/?uri=CELEX%3A32020R0852), 17 straipsnyje, arba numatomas jų poveikis yra nereikšmingas, t. y. nedaro tiesioginio ir pirminio netiesioginio poveikio per visą gyvavimo ciklą.

3.4. Projekto įgyvendinimo metu neturi būti pažeidžiami HP: darnaus vystymosi, įskaitant reikšmingos žalos nedarymo principą; lygių galimybių ir nediskriminavimo (dėl lyties, rasės, tautybės, pilietybės, kalbos, kilmės, socialinės padėties, tikėjimo, įsitikinimų ar pažiūrų, amžiaus, lytinės orientacijos, etninės priklausomybės, religijos, negalios ar kt.), įskaitant prieinamumo visiems reikalavimo užtikrinimą (paslaugų, infrastruktūros, fizinės ar e. aplinkos sprendimai, informacijos, transporto prieinamumo ir pan.); inovatyvumo (kūrybingumo) (įgyvendinamas projektas prisideda prie Koncepcijos ir atitinka bent vieno šios Koncepcijos prioriteto įgyvendinimo tematiką, remiamos įmonės, investuojančios į MTEP, numatytas bendradarbiavimas su tyrėjais arba tyrėjai bus įdarbinti projekte kaip darbuotojai, taikomos naujos technologijos, kuriami ar diegiami inovatyvūs sprendimai ir pan.). Projekte neturi būti numatyta veiksmų, kurie turėtų neigiamą poveikį įgyvendinant HP.“
| Reikalavimai įgyvendinus projektų veiklas

PFSA 7 punkte numatyti reikalavimai įgyvendinus projekto veiklas:

„7.1. Projekto įgyvendinimo metu sukurta intelektinė nuosavybė 3 metus (kai projekto vykdytojas turi labai mažos įmonės, mažos įmonės arba vidutinės įmonės statusą) ar 5 metus (kai projekto vykdytojas turi didelės įmonės statusą) po projekto finansavimo negali būti perduota neatlygintinai kitiems juridiniams ir (ar) fiziniams asmenims.

7.2. Projekto metu sukurtas prototipas (-ai) ar bandomosios partijos produktai 3 metus (kai projekto vykdytojas turi labai mažos įmonės, mažos įmonės arba vidutinės įmonės statusą) ar 5 metus (kai projekto vykdytojas turi didelės įmonės statusą) gali būti naudojami tik tolesnėms MTEP veikloms ar demonstravimui.“
| Projektų įgyvendinimo trukmė
| Projektų veiklų įgyvendinimo trukmė turi būti ne ilgesnė kaip 18 mėnesių nuo iš Europos Sąjungos fondų investicijų programos lėšų bendrai finansuojamo projekto sutarties pasirašymo dienos. Dėl objektyvių priežasčių, kurių projekto vykdytojas negalėjo numatyti PĮP pateikimo ir vertinimo metu, projekto veiklų įgyvendinimo laikotarpis gali būti pratęstas Projektų administravimo ir finansavimo taisyklių IV skyriaus antrame skirsnyje nustatyta tvarka, bet ne ilgiau kaip iki PFSA 2.3.8 papunktyje nurodyto termino.
| Reikalavimai valstybės pagalbai

PFSA 5 punkte numatyti reikalavimai valstybės pagalbai:

„5.1. Pagal PFSA teikiamas finansavimas naujų APV produktų kūrimo veikloms yra valstybės pagalba, kaip ji apibrėžta Sutarties dėl Europos Sąjungos veikimo 107 straipsnio 3 dalyje, kuri atitinka visas sąlygas, nustatytas Reglamento (ES) Nr. 651/2014 I skyriuje, ir atitinkamas specialiąsias sąlygas, nustatytas Reglamento (ES) Nr. 651/2014 25 straipsnyje. Šios veiklos vykdymo atveju teikiama valstybės pagalba laikoma turinti skatinamąjį poveikį, jeigu atitinka Reglamento (ES) Nr. 651/2014 6 straipsnio 2 dalies nuostatas. Projektų valstybės pagalbos atitikties Reglamento (ES) Nr. 651/2014 25 straipsnio nuostatoms vertinimą atlieka administruojančioji institucija pagal PFSA 2 priede nurodytus vertinimo kriterijus.

5.2. Didžiausia galima projekto finansuojamoji dalis apskaičiuojama pagal Reglamento (ES) Nr. 651/2014 25 straipsnio 5 dalies b ir c punktus ir to paties straipsnio 6 dalį:

5.2.1. Moksliniams tyrimams intensyvumas neviršija 50 proc. visų tinkamų finansuoti projekto išlaidų.

5.2.2. Eksperimentinei plėtrai intensyvumas neviršija 25 proc. visų tinkamų finansuoti projekto išlaidų.

5.3. Pagalbos intensyvumas gali būti padidintas iki 80 proc. tinkamų finansuoti išlaidų:

5.3.1. 10 procentinių punktų vidutinėms įmonėms ir 20 procentinių punktų labai mažoms ir mažoms įmonėms.

5.3.2. 15 procentinių punktų padidinama už veiksmingą bendradarbiavimą, jei tenkinamos Reglamento (ES) Nr. 651/2014 25 straipsnio 6 dalies b punkto i papunktyje nurodytos sąlygos.

5.4. Tinkamos finansuoti projekto lėšomis išlaidos, taikant Reglamento (ES) Nr. 651/2014 25 straipsnį, yra:

5.4.1. MTEP paslaugų įsigijimo iš išorės šaltinių įprastomis rinkos sąlygomis, išlaidos (t. y. kai perkama iš išorinių šaltinių už rinkos kainas, pagal šalių sudarytą sandorį, kai nėra jokių susijusių slapto susitarimo elementų).

5.4.2. Išlaidos, susijusios su konsultavimo ir lygiaverčių paslaugų, skirtų vien tik projekto MTEP veiklai, įsigijimu, taip pat išlaidos dėl MTEP veiklai reikalingų paslaugų, kurios nėra MTEP ir be jų nebus pasiekti projekto tikslai, įsigijimo; Šios išlaidos yra tinkamos finansuoti, kai paslaugos įsigyjamos iš išorės šaltinių įprastomis rinkos sąlygomis, t. y. kai perkama iš išorinių šaltinių už rinkos kainas, pagal šalių sudarytą sandorį, kai nėra jokių susijusių slapto susitarimo elementų.

5.4.3. Su kitomis veiklos sąnaudomis, įskaitant sąnaudas medžiagoms, mažaverčiam inventoriui, atsargoms ir panašiems produktams, priskirtiniems trumpalaikiam turtui, tiesiogiai susijusiomis su MTEP veikla, susijusios išlaidos.

5.4.4. Projekto MTEP veikloms naudojamo turto (įrangos, prietaisų, įrankių, įrenginių, mašinų ir įrengimų pastatų ir (ar) patalpų) nusidėvėjimo sąnaudos, jeigu šiam turtui įsigyti nebuvo naudojamos viešosios (įskaitant ir kitų valstybių) lėšos (ne daugiau nei 50 procentų tinkamų finansuoti išlaidų). MTEP veikloms naudojamo turto nusidėvėjimo sąnaudos turi būti apskaičiuotos projekto įgyvendinimo laikotarpiui.

5.4.5. Projektą vykdančio personalo darbo užmokestis ir su juo susijusios išlaidos, apskaičiuotos teisės aktų, reguliuojančių darbo užmokestį ir darbo santykius, nustatyta tvarka.

5.4.6. Projektą vykdančio personalo komandiruočių išlaidos, apskaičiuotos komandiruočių išlaidas reguliuojančių teisės aktų nustatyta tvarka.

5.4.7. Tiesiogiai su projekto įgyvendinimu susijusios ir veiklai proporcingai (pro rata principu) paskirstytos pridėtinės išlaidos – įrangos nuomos išlaidos.

5.4.8. Tiesiogiai su projekto įgyvendinimu susijusios ir veiklai proporcingai (pro rata principu) paskirstytos pridėtinės išlaidos – projektui įgyvendinti būtinų pastatų ar patalpų nuomos išlaidos (ne daugiau nei 10 procentų tinkamų finansuoti išlaidų).

5.4.9. PFSA 5.4.1–5.4.2 papunkčiuose nurodytos išlaidos kartu negali sudaryti daugiau nei 50 procentų tinkamų finansuoti PFSA 5.1 papunktyje nurodytai veiklai skirtų išlaidų.

5.5. Projekto finansuojamoji dalis kiekvienam valstybės pagalbos gavėjui (įskaitant partnerį) nustatoma atskirai.

5.6. Jei projektas įgyvendinamas su partneriais, pareiškėjas turi patirti ne mažiau kaip 50 procentų, bet ne daugiau 90 procentų tinkamų finansuoti išlaidų. Jei yra pretenduojama į projekto finansuojamosios dalies padidinimą, projektas turi atitikti Reglamento (ES) Nr. 651/2014 25 straipsnio 6 dalies b punkto i papunktyje nustatytas sąlygas. Ši PFSA nuostata netaikoma patentavimo veiklai ir projekto metu sukurto produkto parengimui rinkai.

5.7. Projektą įgyvendinant kartu su MSI, laikoma, kad netiesioginė valstybės pagalba per MSI kitiems projekte dalyvaujantiems juridiniams asmenims neperduodama, jeigu laikomasi vienos iš šių sąlygų:

5.7.1. Rezultatai, kuriems netaikomos intelektinės nuosavybės teisės, gali būti plačiai skleidžiami ir visos intelektinės nuosavybės teisės į MTEP ir naujovių diegimo rezultatus, susijusius su MSI veikla projekte, yra visiškai suteikiamos MSI, t. y. MSI gauna visą šių teisių teikiamą ekonominę naudą ir pasilieka teisę jomis visomis naudotis, ypač nuosavybės teise ir licencijos teise; šios sąlygos taip pat gali būti įvykdytos, jeigu MSI nusprendžia toliau sudaryti sutartis dėl šių teisių, įskaitant jų licencijavimą bendradarbiavimo partneriu.

5.7.2. Kai MSI gauna projekte dalyvaujančio juridinio asmens kompensaciją, lygią intelektinės nuosavybės teisių, kurios yra susijusios su MSI veikla įgyvendinant projektą ir kurios perduodamos projekte dalyvaujantiems juridiniams asmenims, rinkos kainai, t. y. kompensaciją už visą tų teisių teikiamą ekonominę naudą; vadovaujantis bendraisiais valstybės pagalbos principais ir atsižvelgiant į tai, kad intelektinės nuosavybės teisių rinkos kainą objektyviai nustatyti sunku, ši sąlyga laikoma įvykdyta, jeigu MSI, kaip pardavėja, derėsis, kad gautų didžiausią naudą intelektinės nuosavybės perdavimo sutarties sudarymo metu. Bet kuris projekte dalyvaujančio juridinio asmens įnašas dengiant MSI sąnaudas yra atimamas iš tokios kompensacijos.

5.8. Netiesioginės valstybės pagalbos taip pat gali nebūti, jeigu įvertinusi tarp partnerių pasirašytą jungtinės veiklos (partnerystės) sutartį administruojančioji institucija padaro išvadą, kad visos intelektinės nuosavybės teisės į MTEP ir naujovių diegimo rezultatus ir galimybės pasinaudoti teisėmis į tokius rezultatus yra priskiriamos skirtingiems partneriams ir tinkamai atspindimas jų atitinkamas suinteresuotumas projektu, darbo krūvis, finansinis ir kitoks įnašas į projekto įgyvendinimą.

5.9. Jeigu nėra laikomasi nė vienos iš PFSA 5.7 papunktyje nurodytų sąlygų ir atlikusi projekto įvertinimą pagal PFSA 5.8 papunktį administruojančioji institucija nustato, kad buvo suteikta valstybės pagalba, visa MSI įnašo į projekto (tinkamas išlaidas) įgyvendinimą vertė laikoma valstybės pagalba, ir administruojančioji institucija jos dydžiu mažina finansavimo dydį pareiškėjui ir (arba) partneriui priklausomai nuo to, kuris tą pagalbą gavo (pvz., įmonė įgyvendina mokslinių tyrimų projektą kartu su partneriu – universitetu. Įmonei taikoma 50 procentų finansuojamoji dalis. Įmonės tinkamos finansuoti išlaidos yra 600 000,00 (šeši šimtai tūkstančių) eurų. Projektui įgyvendinti yra skiriamas 300 000,00 (trijų šimtų tūkstančių) eurų finansavimas. Jei įgyvendinant projektą paaiškėja, kad nebuvo laikomasi bent vienos iš PFSA 5.7 papunktyje nurodytų sąlygų, pvz., įmonei universitetas perdavė intelektinės nuosavybės teises mažesne negu rinkos kaina, t. y. rinkos kaina – 35 000,00 (trisdešimt penki tūkstančiai) eurų, o universitetas intelektinės nuosavybės teises perdavė už 15 000,00 (penkiolikos tūkstančių) eurų kompensaciją, tokiu atveju įmonei pagal PFSA teiktas finansavimo dydis yra mažinamas 20 000,00 (dvidešimčia tūkstančių) eurų (skiriamas finansavimas negali viršyti 280 000,00 (dviejų šimtų aštuoniasdešimt tūkstančių) eurų.

5.10. Valstybės pagalba, kurios tinkamas finansuoti išlaidas galima nustatyti ir kuriai pagal Reglamentą (ES) Nr. 651/2014 taikoma išimtis, gali būti sumuojama su:

5.10.1. Bet kokia kita valstybės pagalba, jei tos veiklos yra susijusios su skirtingomis tinkamomis finansuoti išlaidomis, kurias galima nustatyti.

5.10.2. Bet kokia kita valstybės pagalba, susijusi su tomis pačiomis tinkamomis finansuoti išlaidomis, kurios iš dalies arba visiškai sutampa, tik jeigu taip susumavus, neviršijamas didžiausias pagalbos intensyvumas ar pagalbos suma pagal Reglamento 25 straipsnio 5 dalyje nustatytą pagalbos intensyvumą.

5.11. Valstybės pagalba, kuriai pagal Reglamentą taikoma išimtis, nesumuojama su jokia de minimis pagalba, susijusia su tomis pačiomis tinkamomis finansuoti išlaidomis, jei susumavus būtų viršytas pagalbos intensyvumas, kaip nustatyta Reglamento (ES) Nr. 651/2014 8 straipsnio 5 dalyje.

5.12. Ministerija, vadovaujantis Reglamento (ES) Nr. 651/2014 9 straipsnio 1 dalies c punkto ir valstybės pagalbos schemos nuostatomis, informaciją apie suteiktą valstybės pagalbą turi paskelbti Europos Komisijos valstybės pagalbos skaidrumo viešos paieškos svetainėje https://webgate.ec.europa.eu/competition/transparency/, ne vėliau kaip per 6 mėnesius nuo pagalbos suteikimo dienos, vadovaudamasi administruojančiosios institucijos pateikta informacija.

5.13. Valstybės pagalba 5.1 papunktyje nurodytai veiklai išmokamas dalimis ir yra diskontuojama iki jos vertės finansavimo skyrimo momentu kaip nustatyta Reglamento (ES) Nr. 651/2014 7 straipsnio 3 punkte.

5.14. Projekto veikloms, susijusioms su patentavimu, de minimis pagalba teikiama vadovaujantis Reglamentu (ES) Nr. 1407/2013. PFSA nustatomos de minimis pagalbos teikimo sąlygos, kurios atitinka Reglamento (ES) Nr. 1407/2013 nuostatas ir yra suderinamos su vidaus rinka.

5.15. Pareiškėjui teikiama de minimis pagalba, kaip nustatyta PFSA 5.14 papunktyje:

5.15.1. Pagalbos intensyvumas sudaro iki 85 proc. visų patentavimo tinkamų finansuoti projekto išlaidų.

5.15.2. Didžiausia galima skirti finansavimo lėšų suma patentavimui – iki 30 000,00 (trisdešimt tūkstančių) eurų.

5.15.3. Patentavimo veikla finansuojama tik tuo atveju, jei yra susijusi su projektu planuojama vykdyti MTEP veikla.

5.15.4. Patentavimo veiklą gali vykdyti tik pareiškėjas.

5.16. Projekto veikloms, susijusioms su projekto metu sukurto produkto parengimu rinkai, de minimis pagalba teikiama vadovaujantis Reglamentu (ES) Nr. 1407/2013. PFSA nustatomos pagalbos teikimo sąlygos, kurios atitinka Reglamento (ES) Nr. 1407/2013 nuostatas ir yra suderinamos su vidaus rinka.

5.17. Pareiškėjui teikiama de minimis pagalba, kaip nustatyta PFSA 5.16 papunktyje:

5.17.1. Pagalbos intensyvumas sudaro iki 85 proc. visų projekto metu sukurto produkto parengimo rinkai tinkamų finansuoti projekto išlaidų.

5.17.2. Didžiausia galima skirti finansavimo lėšų suma projekto metu sukurto produkto parengimui rinkai – iki 80 000,00 (aštuoniasdešimt tūkstančių) eurų.

5.17.3. Veikla, susijusi su projekto metu sukurto produkto parengimu rinkai, finansuojama tik tuo atveju, jei yra susijusi su projektu planuojama vykdyti MTEP veikla ir pasiekus ne mažesnį nei 6 technologinės parengties lygį.

5.17.4. Projekto metu sukurto produkto parengimo rinkai veiklas gali vykdyti tik pareiškėjas.

5.18. Tinkamos finansuoti projekto lėšomis išlaidos, taikant Reglamentą (ES) 1407/2013, yra:

5.18.1. Patentinių patikėtinių teikiamos su išradimų patentavimu susijusios paslaugos.

5.18.2. Mokesčiai už išradimų patentavimą.

5.18.3. Išlaidos, susijusios su projekto metu sukurto produkto parengimu rinkai.

5.19. Vadovaujantis Reglamento (ES) 1407/2013 3 straipsnio nuostatomis, bendra de minimis pagalbos, suteiktos vienai įmonei, suma neturi viršyti 200 000,00 (dviejų šimtų tūkstančių) eurų per bet kurį trejų finansinių metų laikotarpį. Bendra de minimis pagalbos, suteiktos vienai įmonei, vykdančiai krovinių vežimo keliais veiklą samdos pagrindais arba už atlygį per bet kurį trejų finansinių metų laikotarpį, suma neturi viršyti 100 000,00 (šimto tūkstančių) eurų. Šios ribos taikomos neatsižvelgiant į de minimis pagalbos formą arba siekiamus tikslus ir neatsižvelgiant į tai, ar valstybės narės suteikta pagalba yra visa arba iš dalies finansuojama ES kilmės ištekliais. Vienos įmonės sąvoka apima visas įmones, kaip nurodyta Reglamento (ES) 1407/2013 2 straipsnio 2 dalyje. Ar yra susijęs su kitais subjektais, pareiškėjas gali pasitikrinti pagal Lietuvos Respublikos konkurencijos tarybos parengtą klausimyną „Ar paramos gavėjas susijęs su kitais subjektais“, kuris paskelbtas Lietuvos Respublikos konkurencijos tarybos interneto svetainėje https://kt.gov.lt/uploads/documents/files/veiklos-sritys/valstybes-pagalba/klausimynai/kaip_KLAUSIMYNAS_vienas_ukio_subjektas.pdf.

5.20. De minimis pagalba nesumuojama su valstybės pagalba, skiriama toms pačioms tinkamoms finansuoti sąnaudoms, jeigu dėl tokio pagalbos sumavimo būtų viršytas Reglamento (ES) Nr. 651/2014 8 straipsnio 5 dalyje arba Europos Komisijos priimtame sprendime nustatytas didžiausias atitinkamas pagalbos intensyvumas arba kiekvienu atveju atskirai nustatyta pagalbos suma.

5.21. De minimis pagalba numatoma mokėti dalimis. De minimis pagalba diskontuojama iki jos vertės finansavimo skyrimo momentu kaip nustatyta Reglamento (ES) 1407/2013 3 straipsnio 6 punkte.

5.22. Pagal PFSA netinkamomis finansuoti išlaidomis laikomos išlaidos:

5.22.1. Nurodytos Projektų administravimo ir finansavimo taisyklių VII skyriaus trečiajame skirsnyje nustatyta tvarka.

5.22.2. Neįvardytos PFSA 5.4.1–5.4.8 ir 5.18.1–5.18.3 papunkčiuose tinkamomis finansuoti išlaidomis.

5.22.3. Patirtos ankstesniuose technologinės parengties lygiuose nei vertinant pagal PFSA 6 punkto 3 prioritetinį projektų atrankos kriterijų nustatytas projektu kuriamo produkto technologinės parengties lygis.

5.23. Administruojančioji institucija PĮP vertinimo metu patikrina pareiškėjo teisę gauti bendrą vienai įmonei suteikiamą de minimis pagalbą. Administruojančioji institucija turi patikrinti visas su pareiškėju susijusias įmones dėl de minimis pagalbos, nurodytas pateiktoje „Vienos įmonės“ deklaracijoje, taip pat Suteiktos valstybės pagalbos ir nereikšmingos (de minimis) pagalbos registre, kurio nuostatai patvirtinti Lietuvos Respublikos Vyriausybės 2005 m. sausio 19 d. nutarimu Nr. 35 „Dėl Suteiktos valstybės pagalbos ir nereikšmingos (de minimis) pagalbos registro nuostatų patvirtinimo“ (toliau – Registras), patikrinti, ar teikiama pagalba neviršys leidžiamo de minimis pagalbos dydžio, kaip nustatyta Reglamento (ES) 1407/2013 3 straipsnyje. Ministerijai priėmus sprendimą finansuoti projektą, administruojančioji institucija per 20 darbo dienų registruoja suteiktos de minimis pagalbos sumą Registre.“.
| Projektų atrankos kriterijai

Eil. Nr. | Kriterijaus tipas | Kriterijus | Kriterijaus vertinimo metodas | Didžiausias galimas kriterijaus balas | Kriterijaus svorio koeficientas
1. | Specialusis | Projekte suplanuotos veiklos atitinka Mokslinių tyrimų ir eksperimentinės plėtros ir inovacijų (sumaniosios specializacijos) prioritetų įgyvendinimo koncepcijos, patvirtintos Lietuvos Respublikos Vyriausybės 2022 m. rugpjūčio 17 d. nutarimu Nr. 835 „Dėl Mokslinių tyrimų ir eksperimentinės plėtros ir inovacijų (sumaniosios specializacijos) koncepcijos patvirtinimo“, nuostatas ir bent vieno šios Koncepcijos prioriteto įgyvendinimo tematiką. | Vertinama, ar projektas prisideda prie Koncepcijos ir atitinka bent vieno šios Koncepcijos prioriteto įgyvendinimo tematiką. | - | -

2.

Specialusis

Pareiškėjas atitinka pradedančiojo inovatoriaus apibrėžimą.

Pradedantysis inovatorius – pareiškėjas PĮP pateikimo dieną vykdantis veiklą ne ilgiau kaip 1 metus, kurio veiklos pajamos nuo veiklos registravimo dienos iki PĮP pateikimo yra ne mažesnės kaip 3 000,00 (trys tūkstančiai) eurų arba vykdantis veiklą ilgiau kaip 1 metus, bet neturintis patirties MTEP srityje (t. y. neįgyvendino MTEP projektų ir (ar) nevykdė MTEP veiklų) ir jo metinės veiklos pajamos per paskutinius finansinius metus iki PĮP pateikimo yra ne mažesnės kaip 3 000,00 (trys tūkstančiai) eurų.

Vertinami pareiškėjo pateikti dokumentai, parodantys jo pajamas nuo veiklos registravimo dienos iki PĮP pateikimo dienos, jeigu pareiškėjas veikia trumpiau kaip metus, arba vertinami paskutinių metų iki PĮP pateikimo finansinės atskaitomybės dokumentai, jeigu pareiškėjas veikia ilgiau kaip metus, bet neturi MTEP patirties. Pareiškėjų patirtis vertinama pagal Lietuvos statistikos departamentui deklaruojamas išlaidas MTEP.

Pareiškėjas yra veikianti įmonė, t. y. Juridinių asmenų registre įregistruota įmonė, turinti pajamų ir darbuotojų ir teisės aktų nustatyta tvarka teikianti ataskaitas Valstybinei mokesčių inspekcijai, Valstybinio socialinio draudimo fondo valdybos skyriams ir metinių finansinių ataskaitų rinkinius Juridinių asmenų registrui.

Šis projektų atrankos kriterijus taikomas tik projekto vertinimo metu.

3.

Prioritetinis

Projekto įgyvendinimo metu sukurtų produktų komercinimo potencialas.

Siekiama skatinti rinkai patrauklesnių produktų kūrimą, todėl aukštesnis įvertinimas suteikiamas tiems projektams, kurių projekto įgyvendinimo metu sukurtų produktų komercinimo potencialas yra didesnis.

Komercinimo potencialas vertinamas atsižvelgiant į naujo produkto technologinės parengties lygį – aukštesnis įvertinimas (daugiau balų) suteikiamas (-a) tiems projektams, kurių įgyvendinimo metu sukurtų produktų technologinės parengties lygis didesnis projekto pradžioje ir pabaigoje. Technologinės parengties lygis nustatomas vadovaujantis Rekomenduojamos mokslinių tyrimų ir eksperimentinės plėtros etapų klasifikacijos aprašu, patvirtintu Lietuvos Respublikos Vyriausybės 2012 m. birželio 6 d. nutarimu Nr. 650.

Kriterijus taikomas tik pradedantiesiems inovatoriams.

Jeigu gaunamas skaičius nėra sveikasis, apvalinama pagal aritmetines taisykles iki sveikojo skaičiaus ir vieno skaičiaus po kablelio.

Iki 5 balų gali būti skiriama priklausomai nuo naujo produkto technologinės parengties lygio, vertinant numatomo sukurti / kuriamo produkto technologinę parengtį dviem aspektais:

- „status quo“, t. y. technologinės parengties lygis prieš pradedant projekto veiklas (gali būti skiriama iki 2,5 balo). Vertinimo skalė: 4 etapas – skiriama 0,5 balo; 5 etapas – skiriamas 1 balas; 6 etapas – skiriama 1,5 balo; 7 etapas – skiriama 2,5 balo;

- įgyvendinus projektą numatomas pasiekti technologinės parengties lygis (gali būti skiriama iki 2,5 balo). Vertinimo skalė: 6 etapas – skiriama 1,5 balo; 7 etapas – skiriami 2 balai; 8 ir 9 etapai – skiriama 2,5 balo.

Jeigu įgyvendinant ar įgyvendinus projektą bus sukurta daugiau nei vienas produktas, vertinamas kiekvienas produktas ir tuomet apskaičiuojamas suteikiamo balo vidurkis.

5

7

4.

Prioritetinis

Projekto įgyvendinimo metu ir 3 metus po projekto veiklų įgyvendinimo pabaigos įmonės pajamų, gautų iš tiesiogiai projekto įgyvendinimo metu sukurtų ir rinkai pateiktų produktų, santykis su tinkamomis finansuoti projekto išlaidomis.

Siekiama skatinti komerciškai naudingų produktų kūrimą, todėl aukštesnis įvertinimas suteikiamas tiems projektams, kurių įgyvendinimo metu ir 3 metus po projekto veiklų įgyvendinimo pabaigos gautų įmonės pajamų iš tiesiogiai projekto įgyvendinimo metu sukurtų ir rinkai pateiktų produktų santykis su projekto tinkamomis finansuoti išlaidomis yra didesnis. Vertinamos pajamos yra pagrįstos pareiškėjo prognozėmis ir skaičiavimais.

Vertinama pagal formulę X=P/I, kurioje:

P – projekto įgyvendinimo metu ir 3 metus po projekto veiklų įgyvendinimo pabaigos įmonės gautos pajamos iš tiesiogiai projekto metu sukurtų ir rinkai pateiktų produktų;

I – tinkamos finansuoti projekto išlaidos;

X – santykis tarp pajamų, gautų iš projekto įgyvendinimo metu ir 3 metus po projekto veiklų įgyvendinimo pabaigos tiesiogiai projekto metu sukurtų ir rinkai pateiktų produktų ir išlaidų, skirtų projektui finansuoti.

Daugiau balų suteikiama tiems projektams, kurių X yra didesnis.

Šis kriterijus taikomas tik pradedantiesiems inovatoriams.

Jeigu gaunamas skaičius nėra sveikasis, apvalinama pagal aritmetines taisykles iki sveikojo skaičiaus ir vieno skaičiaus po kablelio.

5 balai suteikiami pirmiesiems didžiausią pajamų ir tinkamų finansuoti išlaidų santykio reikšmę turinčių 20 proc. projektų (jeigu gaunamas skaičius nėra sveikasis, apvalinama pagal aritmetines taisykles iki sveikojo skaičiaus; atitinkamai ši taisyklė taikoma ir toliau), 4 balai – kitiems 20 proc. projektų

ir t. t. 1 balas suteikiamas paskutiniams 20 proc. projektų. Jeigu pirmieji projektai, pagal kuriuos numatomas vienodas pajamų ir tinkamų finansuoti išlaidų santykis, sudaro daugiau nei 20 proc. projektų, tuomet visiems jiems suteikiami 5 balai. Tokiu atveju 4 balai suteikiami pirmiesiems 20 proc. likusių projektų, 3 balai – kitiems 20 proc. projektų

ir t. t. Atitinkamai ta pati loginė seka taikoma, jeigu susidaro daugiau negu 20 proc. 4 balais vertinamų projektų, surinkusių vienodą balų skaičių. Tokiu atveju jiems visiems skiriami

4 balai, o likusiems tuo pačiu principu suteikiami žemesni vertinimai.

5

5

5.

Prioritetinis

Projekto įgyvendinimo metu sukurto (-os) produkto (inovacijos) reikšmingumo lygis

Kriterijumi vertinamas projekto įgyvendinimo metu sukurto (-ų) produkto (-ų) reikšmingumo lygis. Reikšmingumas yra vertinamas atsižvelgiant į projekto įgyvendinimo metu sukurto (-ų) produkto (-ų) naujumo lygį. Naujumas klasifikuojamas į tris grupes (reikšmingumo didėjimo tvarka): produktas naujas įmonės lygmeniu, produktas naujas rinkos lygmeniu, produktas naujas pasaulio lygmeniu, kaip nurodyta Oslo vadove („Oslo manual. Guidelines for Collecting and Interpreting Innovation Data“, 4rd Edition, OECD, „Eurostat“, 2018).

Aukštesnis įvertinimas (daugiau balų) suteikiamas (-a) tiems projektams, kurių įgyvendinimo metu sukurtų produktų reikšmingumas yra didesnis.

Kriterijus taikomas tik pradedantiesiems inovatoriams.

Jeigu projekto įgyvendinimo metu arba per 3 metus po projekto įgyvendinimo bus sukurtas bent vienas produktas, kuris naujas pasaulio lygmeniu, projektui skiriami 5 balai.

Jeigu projekto įgyvendinimo metu arba per 3 metus po projekto įgyvendinimo bus sukurtas bent vienas produktas, kuris naujas rinkos lygmeniu, projektui skiriami 3 balai.

Jeigu projekto įgyvendinimo metu arba per 3 metus po projekto įgyvendinimo bus sukurtas bent vienas produktas, kuris naujas įmonės lygmeniu, projektui skiriamas 1 balas.

Vertinant produktų naujumo lygmenį, vienas produktas priskiriamas tik vienai naujumo grupei (t. y. jei produktas yra naujas pasaulio lygmeniu, neskiriama papildomų balų už naujumą rinkos ir (ar) įmonės lygmeniu, jeigu produktas naujas rinkos lygmeniu, neskiriama papildomų balų už naujumą įmonės lygmeniu).

5

4

6.

Prioritetinis

Įmonėje sukurtų pilnų etatų, skirtų tyrėjams dalyvauti įmonių MTEP veiklose, skaičius projekto įgyvendinimo metu ir per 3 metus po projekto įgyvendinimo

Įvertinama, kiek pilnų etatų įmonėje sudarys etatai, skirti tyrėjams, dalyvaujantiems MTEP veiklose projekto įgyvendinimo metu ir per 3 metus po projekto įgyvendinimo.

Aukštesnis įvertinimas suteikiamas tiems projektams, kuriuose įsipareigojama įdarbinti didesnį tyrėjų skaičių projekto įgyvendinimo metu ir per 3 metus po projekto įgyvendinimo (skaičiuojant pilno etato ekvivalentais).

Kriterijus taikomas tik pradedantiesiems inovatoriams.

Jeigu gaunamas skaičius nėra sveikasis, apvalinama pagal aritmetines taisykles iki sveikojo skaičiaus ir vieno skaičiaus po kablelio.

5 balai suteikiami pirmiesiems 20 proc. projektų, kuriuose įsipareigojama įdarbinti didesnį tyrėjų skaičių (jeigu gaunamas skaičius nėra sveikasis, apvalinama pagal aritmetines taisykles iki sveikojo skaičiaus; atitinkamai ši taisyklė taikoma ir toliau), 4 balai – kitiems 20 proc. projektų ir t. t. 1 balas suteikiamas paskutiniams 20 proc. projektų. Jeigu pirmieji projektai, pagal kuriuos numatomas įdarbinti didesnį tyrėjų skaičių, sudaro daugiau nei 20 proc. projektų, tuomet visiems jiems suteikiami 5 balai. Tokiu atveju 4 balai suteikiami pirmiesiems 20 proc. likusių projektų, 3 balai – kitiems 20 proc. projektų

ir t. t. Atitinkamai ta pati loginė seka taikoma, jeigu susidaro daugiau negu 20 proc. 4 balais vertinamų projektų, surinkusių vienodą balų skaičių. Tokiu atveju jiems visiems skiriami

4 balai, o likusiems tuo pačiu principu suteikiami žemesni vertinimai.

5

4
Minimali privaloma surinkti balų suma – 50
Maksimali galima balų suma (apvalinama iki sveiko skaičiaus) – 100
Balas apskaičiuojamas pagal formulę, kurioje P – projekto surinktas balų skaičius, Y – kriterijaus gautas vertinimo balas ir S – kriterijui suteiktas svorio koeficientas: P = Y1 * S1 + Y2 * S2 + Y3 * S3 + Y4 * S4

Jei projektas vertinimo metu nesurenka PFSA 6 punkte nurodytos minimalios balų sumos, PĮP atmetamas. Kai projektams, surinkusiems vienodą galutinį balų skaičių, nepakanka pagal kvietimą teikti PĮP skirtos finansavimo lėšų sumos, pirmenybė teikiama projektams, surinkusiems daugiau balų pagal pirmąjį PFSA nurodytą prioritetinį atrankos kriterijų. Jeigu projektai pagal šį prioritetinį atrankos kriterijų įvertinti vienodai, pirmenybė suteikiama projektams, surinkusiems daugiau balų pagal kitą iš eilės nurodytą prioritetinį atrankos kriterijų. Jeigu suteikti vienodi balai pagal visus prioritetinius atrankos kriterijus, šie projektai nurodomi PĮP vertinimo ataskaitos sąraše „Projektai, kuriems rekomenduojama skirti finansavimą“ pagal PĮP pateikimo laiką.
| Projektų įgyvendinimo planų rengimo ir teikimo tvarka
| Teikimo tvarka: | PĮP turi būti parengtas pagal Projektų administravimo ir finansavimo taisyklių 1 priedą (pridedama). Parengtas PĮP (su visais privalomais priedais) pasirašomas kvalifikuotu elektroniniu parašu, adoc formatu ir teikiamas el. paštu esinvesticijos@inovacijuagentura.lt (laiško dydis negali būti didesnis nei 25 MB).

Kartu su PĮP turi būti pateikta:

Kartu su PĮP turi būti pateikta:

- Projektų administravimo ir finansavimo taisyklių 1 priedo 1 priedas „Partnerio deklaracija“, jei projektas įgyvendinamas kartu su partneriu (-iais);
- Projektų administravimo ir finansavimo taisyklių 1 priedo 2 priedas „Informacija apie projekto biudžeto paskirstymą“, jei projektas įgyvendinamas kartu su partneriu (-iais);
- Projektų administravimo ir finansavimo taisyklių 1 priedo 4 priedas „Informacijos apie pareiškėjui (partneriui) suteiktą valstybės pagalbą (išskyrus de minimis)“;
- Užpildytas šio PFSA 4 priedas „Informacijos, reikalingos projekto atitikčiai projektų atrankos kriterijams įvertinti, pateikimo lentelė“, kuriame pateikiama informacija, reikalinga projekto atitikčiai projektų atrankos kriterijams įvertinti;
- MTEP verslo planas, parengtas pagal Kvietime teikti PĮP pateiktus rekomenduojamus formos ir turinio reikalavimus (forma pridedama);
- Pareiškėjo (partnerio), jei projektas įgyvendinamas su partneriu (-iais), Smulkiojo ar vidutinio verslo subjekto statuso deklaracija, kurios forma patvirtinta Lietuvos Respublikos ūkio ministro 2008 m. kovo 26 d. įsakymu Nr. 4-119 „Dėl Smulkiojo ar vidutinio verslo subjekto statuso deklaravimo tvarkos aprašo ir Smulkiojo ar vidutinio verslo subjekto statuso deklaracijos formos patvirtinimo“ (pareiškėjas ir partneris (-iai) gali pateikti laisvos formos deklaraciją, jei jie priskirtini didelėms įmonėms). Jei į Smulkiojo ar vidutinio verslo subjekto statuso deklaraciją įtraukiamos užsienio įmonės, pareiškėjas privalo pateikti jų patvirtintus finansinės atskaitomybės ir akcininkų struktūrą patvirtinančius dokumentus;
- Dokumentai, pagrindžiantys projekto biudžeto pagrįstumą (komerciniai pasiūlymai, nuorodos į rinkos esančias kainas ir kita (jei projekte numatytos patentavimo ir/ar projekto metu sukurto produkto parengimo rinkai veiklos, išlaidų pagrindimui turi būti pateikiama po tris lygiaverčius komercinius pasiūlymus));
- Finansavimo šaltinius (pareiškėjo ir (ar) partnerio (-ių) įnašą ir netinkamų finansuoti išlaidų padengimą) pagrindžiantys dokumentai;
- Jungtinės veiklos (partnerystės) sutarties kopija, jeigu projektas įgyvendinamas kartu su partneriu (-iais). Jungtinės veiklos (partnerystės) sutartyje turi būti aiškiai išdėstyti šalių įsipareigojimai ir teisės projekto atžvilgiu (nurodytas kiekvienos šalies finansinis ir dalykinis indėlis į projektą, kokias veiklas vykdys kiekviena šalis, teisės į bendrai sukurtą ar įgytą turtą, laikantis finansinės apskaitos principų, projekto rezultatai ir kita) ir šalių atsakomybė, taip pat įsipareigojimai laikytis pagrindinių geros partnerystės praktikos taisyklių;
- Jei projekto veikla (-os) finansuojamos pagal Reglamentą (ES) 1407/2013, užpildytas šio PFSA 5 priedas, kuriame pateikiama „Vienos įmonės“ deklaracija;
- Jei pareiškėjas veiklą vykdo trumpiau nei 1 metus arba neturi patvirtintų finansinės atskaitomybės dokumentų, kartu su teikiamais dokumentais privalo pateikti tarpinius patvirtintus finansinės atskaitomybės dokumentus ar kitus pareiškėjo pajamas patvirtinančius dokumentus.

Pastaba: užpildytus MTEP verslo plano priedus 1A, 1B ir finansinį planą rekomenduojama pateikti excel formatu (pridedama).
| Projektų įgyvendinimo planų suderinimas su atsakinga institucija | PĮP projektas nederinamas su Lietuvos Respublikos ekonomikos ir inovacijų ministerija.
| Kontaktiniai duomenys konsultacijoms | VšĮ Inovacijų agentūra: Kontaktų centras, tel. +370 700 77 055 Mokslo ir inovacijų projektų skyrius, tel. +370 618 09 348 El. paštas: inostartas@inovacijuagentura.lt
| Kita informacija | Kvietimo informacija skelbiama tinklapiuose: www.2021.esinvesticijos.lt www.inovacijuagentura.lt www.eimin.lt (naujienlaiškis dėl skelbiamo kvietimo)

Priedai

Dokumentų sąrašas

# 1. Kvietimo skelbimas

2. Projektų finansavimo ir administravimo taisyklės (toliau – PAFT) (https://www.e-tar.lt/portal/lt/legalAct/14e33320f1ed11ec8fa7d02a65c371ad/asr)

3. PAFT priedas Projekto įgyvendinimo plano (toliau – PĮP) formą (PAFT 1 priedas) (https://2021.esinvesticijos.lt/dokumentai/projekto-igyvendinimo-plano-forma);

4. PĮP pildymo instrukcija, dalinai užpildyta pavyzdinė PĮP forma (pridedama);

5. PAFT 1 priedo 1 priedas Partnerio deklaracija (https://2021.esinvesticijos.lt/dokumentai/partnerio-deklaracija);

6. PAFT 1 priedo 2 priedas Informacija apie projekto biudžeto paskirstymą (https://2021.esinvesticijos.lt/dokumentai/informacijos-apie-biudzeto-pasiskirstyma-forma);

7. PAFT 1 priedo 4 priedas Informacija apie pareiškėjui (partneriui) suteiktą valstybės pagalbą (išskyrus de minimis) (https://2021.esinvesticijos.lt/dokumentai/informacijos-apie-pareiskejui-partneriui-suteikta-valstybes-pagalba-isskyrus-de-minimis-forma-1)

8. Projektų finansavimo sąlygų aprašas (toliau – PFSA) (https://www.e-tar.lt/portal/lt/legalAct/1535c990814011ed8df094f359a60216)

9. PFSA 4 priedas informacijos, reikalingos projekto atitikčiai projektų atrankos kriterijams įvertinti, pateikimo lentelė (pridedama)

10. PFSA 5 priedas „Vienos įmonės“ deklaracija (pridedama)

11. Stebėsenos rodiklių aprašymo kortelės (pridedama):

- Paramą gavusios įmonės (iš kurių: labai mažos, mažosios, vidutinės ir didelės) - P-05-001-01-05-07-08;

- Paramą dotacijomis gavusios įmonės - P-05-001-01-05-07-13;

- Privačiosios investicijos, papildančios viešąją paramą (iš kurių: dotacijos, finansinės priemonės) - R-05-001-01-05-07-03;

- Paramą gavusiuose subjektuose sukurtos mokslo tiriamojo darbo vietos - R-05-001-01-05-07-05;

- Investicijas gavusios įmonės pajamų, gautų iš tiesiogiai projekto metu sukurtų ir rinkai pateiktų produktų, santykis su skirtomis investicijomis - R-05-001-01-05-07-25.

12. MTEP verslo planas (pridedama);

13. MTEP verslo plano 1A priedas (vykdant MTEP veiklas); 1B priedas (vykdant patentavimo ir sukurto produkto parengimo rinkai veiklą); Finansinis planas (pridedama).

14. Mokslinių tyrimų ir eksperimentinės plėtros ir inovacijų (sumaniosios specializacijos) prioritetų įgyvendinimo koncepcija (https://e-seimas.lrs.lt/portal/legalAct/lt/TAD/8b31ef00221011edb36fa1cf41a91fd9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);

15. Frascati vadovas (https://lic.lt/wp-content/uploads/2020/09/Frascati-vadovas-2015.pdf);

16. Oslo vadovas (https://www.oecd.org/publications/oslo-vadovas-2018-a6ccbad3-lt.htm);

17. Rekomenduojamos mokslinių tyrimų ir eksperimentinės plėtros etapų klasifikacijos aprašas (https://e-seimas.lrs.lt/portal/legalAct/lt/TAD/TAIS.426659);

18. Pareiškėjo (partnerio) / projekto vykdytojo įnašo šaltinių

užtikrinimo vertinimo metodika (pridedama);

19. Smulkiojo ir vidutinio verslo statuso deklaracija pildymui (pridedama)

20. Smulkiojo ir vidutinio verslo plėtros įstatymas (https://www.e-tar.lt/portal/lt/legalAct/TAR.640D50DB8877/lANfitaBnc)

21. Smulkiojo ir vidutinio verslo statuso deklaravimo tvarkos aprašas (https://www.e-tar.lt/portal/lt/legalAct/1edc7da0268211e78397ae072f58c508);

22. 2014 m. birželio 17 d. Komisijos reglamentas (ES) Nr. 651/2014, kuriuo tam tikrų kategorijų pagalba skelbiama suderinama su vidaus rinka taikant Sutarties 107 ir 108 straipsnius, su visais pakeitimais (https://eur-lex.europa.eu/legal-content/LT/TXT/?uri=CELEX%3A02014R0651-20210801#M4-1);

23. 2013 m. gruodžio 18 d. Komisijos reglamentas (ES) Nr. 1407/2013 dėl Sutarties dėl Europos Sąjungos veikimo 107 ir 108 straipsnių taikymo de minimis pagalbai su paskutiniais pakeitimais (https://eur-lex.europa.eu/legal-content/LT/TXT/?uri=CELEX%3A02013R1407-20200727)

24. Lietuvos Respublikos Vyriausybės 2016 m. sausio 6 d. nutarimas Nr. 5 „Dėl Sostinės regiono ir Vidurio ir vakarų Lietuvos regiono sudarymo“ (https://www.e-tar.lt/portal/lt/legalAct/5bb097a0b92011e5a6588fb85a3cc84b)

____________________
