JuliusJanusonis/MB/Inostartas/Biudzetas/Pagrindžiantys dokumentai/medziagu-pirkimo-pagrindimas-2023-03-30.docx

Viešajai įstaigai Inovacijų agentūra 2023-03-29, Nr. MTI-23-03/1

Mokslo ir inovacijų projektų skyriui Originalas siunčiamas nebus

Per DMS

DĖL PROJEKTO MEDŽIAGŲ MTEP VEIKLOMS PIRKIMO

Projektui „PROJEKTO PAVADINIMAS“, teikiamam pagal priemonę Nr. 02-014-K „Inostartas“.

Projekto MTEP veikloms numatoma pirkti šias medžiagas:

1. Medžiagos (aliuminis ar kitos medžiagos): projekto prototipo gamybai bus reikalingas aliuminis 36 kg, detalių anodavimas,

Numatoma, kad medžiagų rinkinio kaina sudarys

Medžiagos: | Viso, Eur
Aliuminis | 360
Anodavimas (už užsakymą) | 300
Transportavimas (už užsakymą) | 180
| | Viso: 840,00 EUR be PVM.

Reikalingas komponentų rinkinio kaina nustatyta pagal tokių tiekėjų katalogų kainas:

- https://www.alumeco.lt/aliuminis/laktai/laktai-be-padengimo/g/4
- https://www.aldorbv.nl/

Direktorius
