JuliusJanusonis/MB/Buhalterija/Saskaitos fakturos/mb_everoptics.pvm_saskaita_faktura.pardp000001.uab_lidaris.lt.pdf

### PVM sąskaita faktūra

### Data: 2023-03-27

Pirkėjas/Gavėjas | Pardavėjas/Siuntėjas MB "Everoptics" Adresas: Vokiečių 85, Kaunas, Lietuva
| 45261 Įmonės kodas: 306272113 Tel.: +37063817746 j.j.janusonis@gmail.com Registracijos adresas: Vokiečių 85, Kaunas, Lietuva 45261 Apmokėti iki: 2023-04-06

### Serija PARDP Nr. 000001

UAB Lidaris

Adresas: Šv. Stepono g. 27C-24, Vilnius, Lietuva
Įmonės kodas: 302813532
PVM kodas: LT100007025612
Nr. | Prekės/paslaugos pavadinimas Eil | Matas | Kiekis | Kaina be PVM EUR | Suma be PVM EUR
| Optinio prietaiso programavimas, testavimas ir galimybių įvertinimas 1. | vnt. | 1,000 | 10 000,0000 | 10 000,00
Iš viso suma: | 10 000,00
PVM suma (0%): | 0,00

Suma žodžiais: dešimt tūkstančių eurų 00 ct.

Viso suma su PVM: | 10 000,00
Išrašė: Julius Janušonis | Gavo:
(vardas, pavardė) | (vardas, pavardė)

Parsisiųskite
elektroninę versiją.

Išrašyta su
