JuliusJanusonis/MB/Inostartas/Dokumentai projekto padavimui/#2 Siunciamas projekto doku sarasas/Pasirasyti everoptics dokumentai/Biudzeto paskirstymas pagal partnerius.pdf

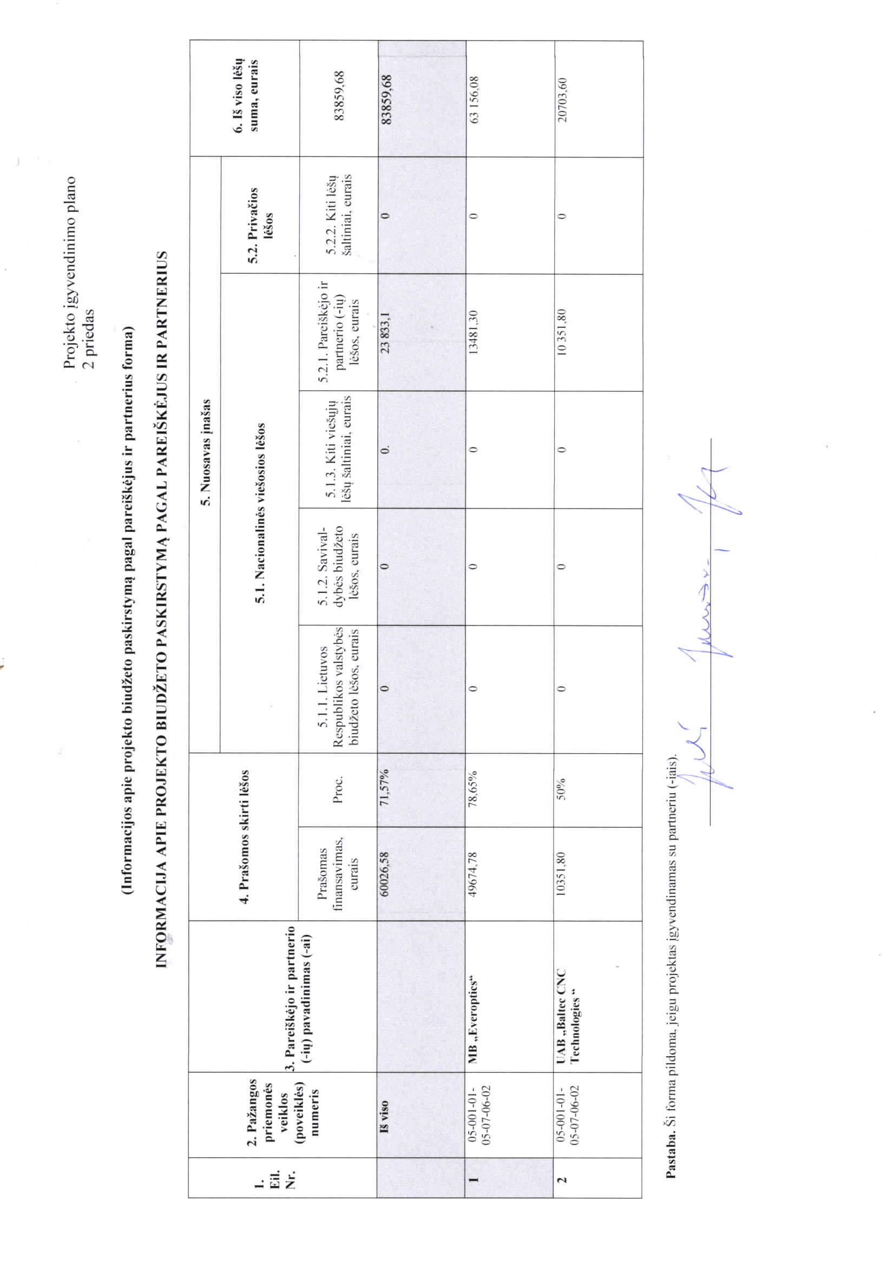
[picture p21: page 1]
