JuliusJanusonis/MB/Inostartas/Dokumentai projekto padavimui/#2 Siunciamas projekto doku sarasas/Pasirasyti everoptics dokumentai/svv deklaracija F1.pdf

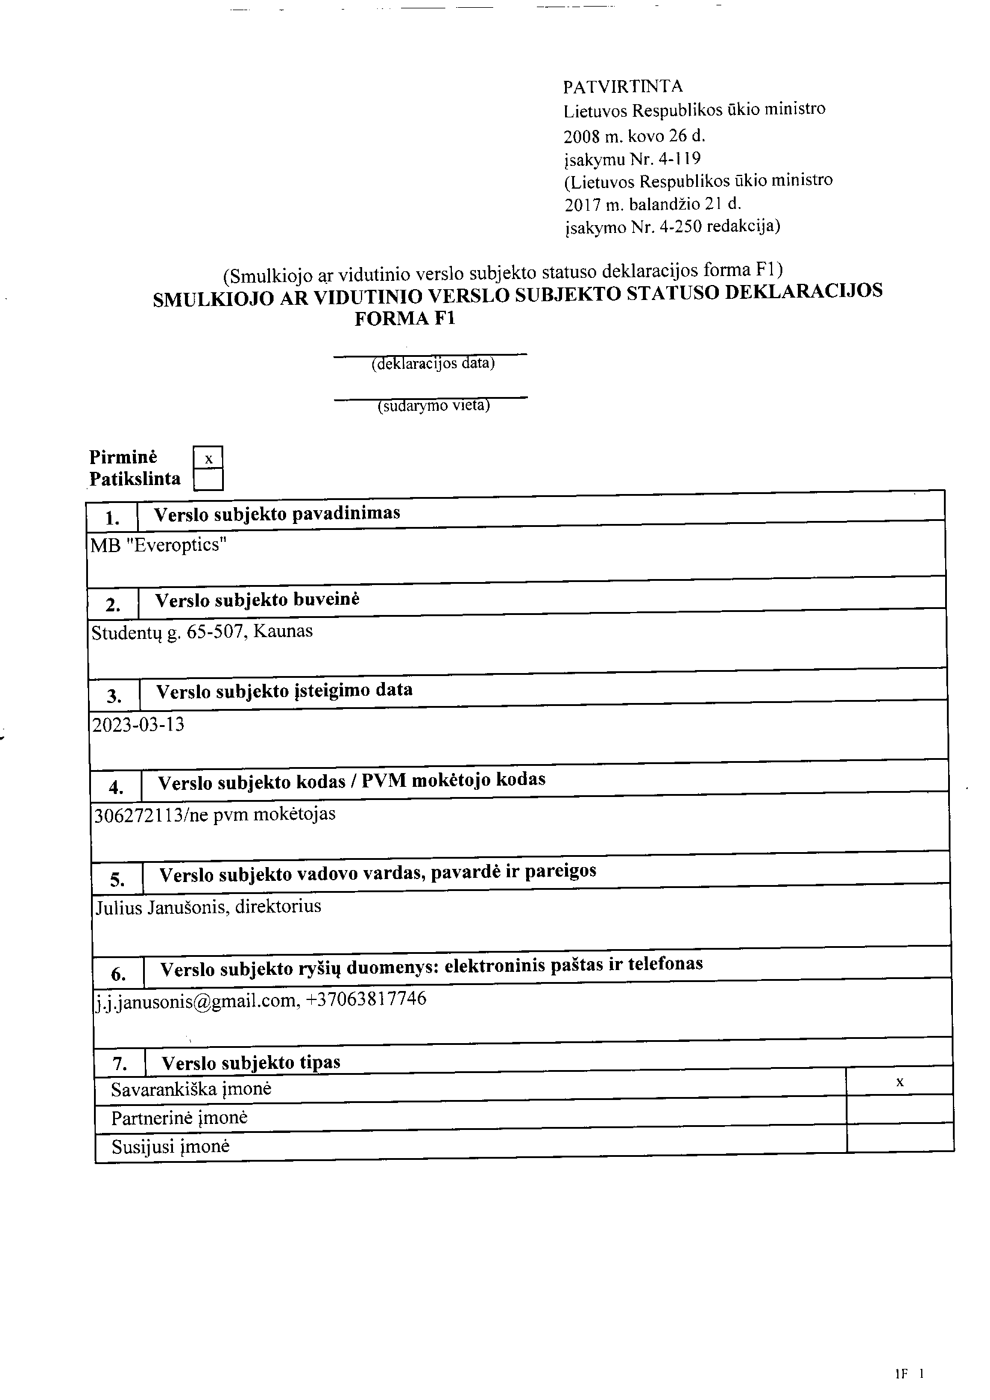
[picture p22: page 1]
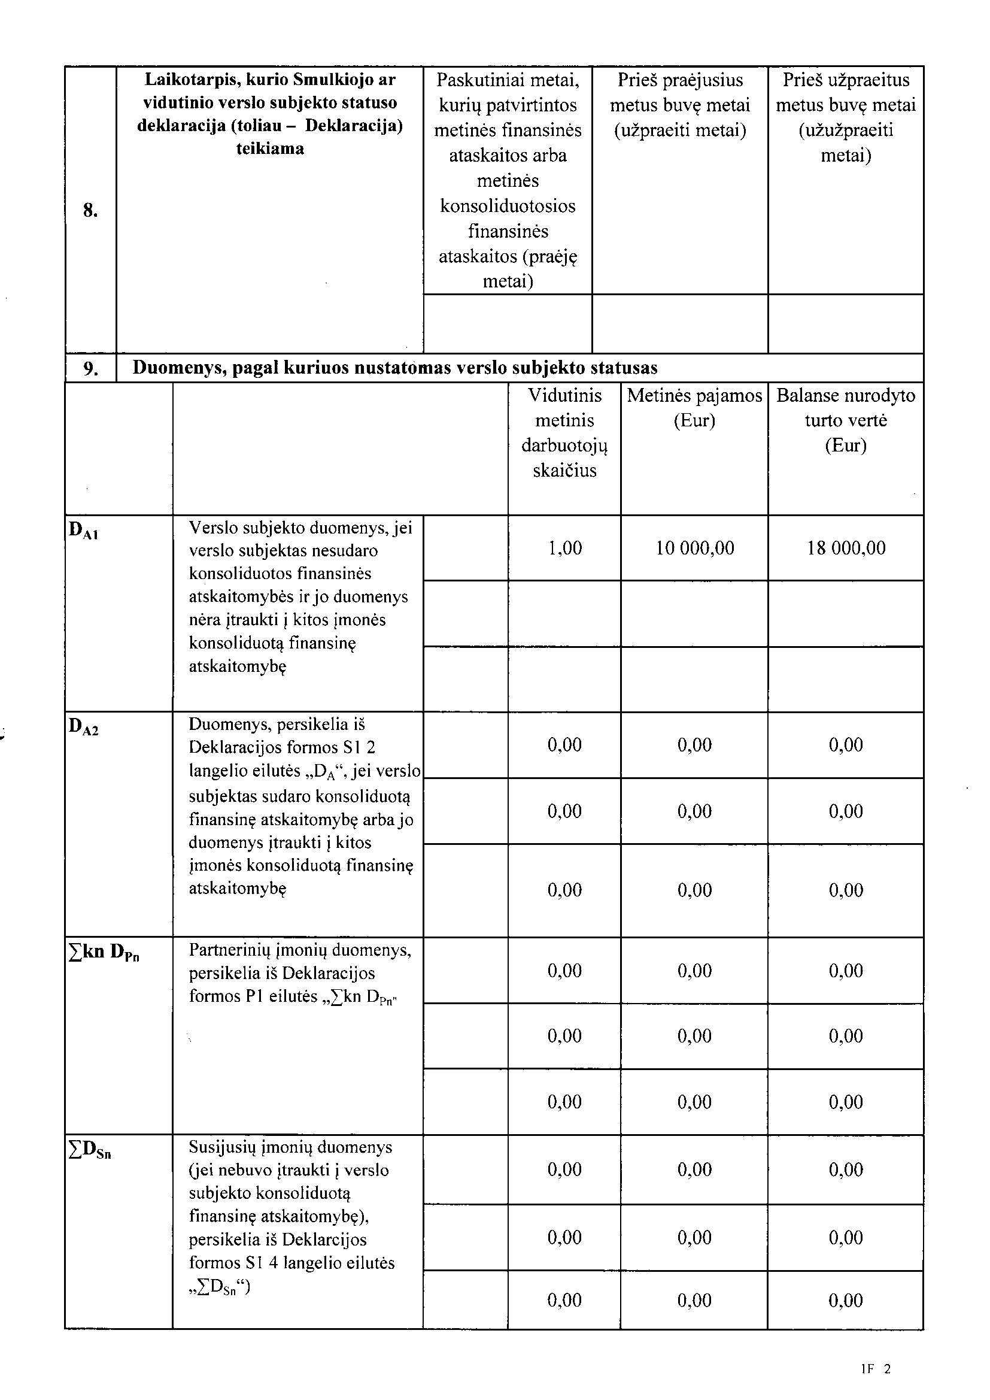
[picture p23: page 2]
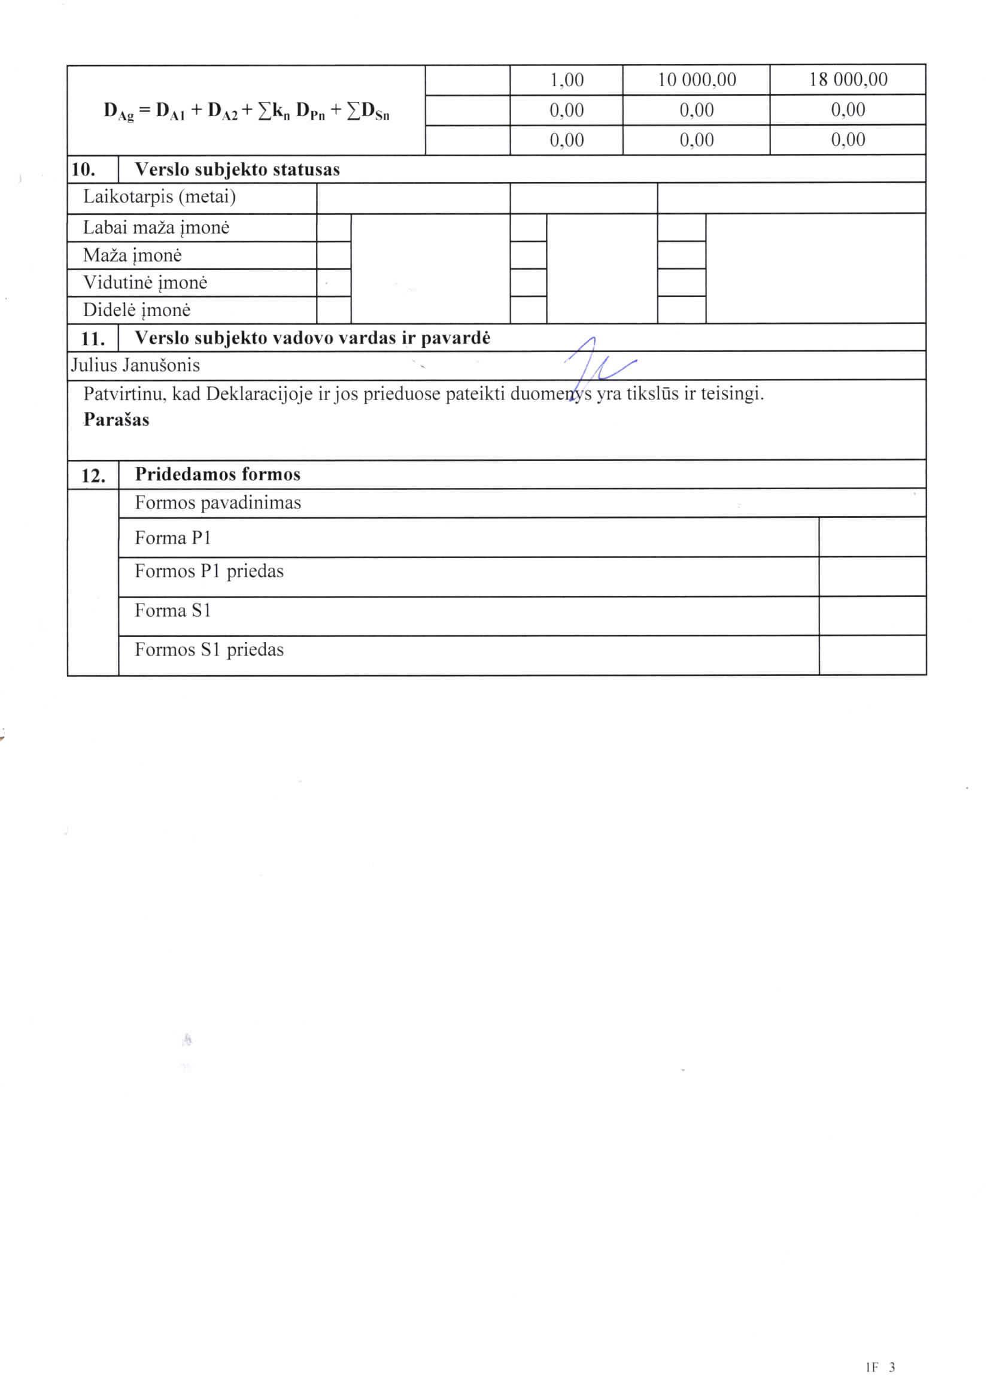
[picture p24: page 3]
