JuliusJanusonis/MB/Inostartas/Dokumentai projekto padavimui/#2 Siunciamas projekto doku sarasas/Pasirasyti everoptics dokumentai/vienos imones deklaracija.pdf

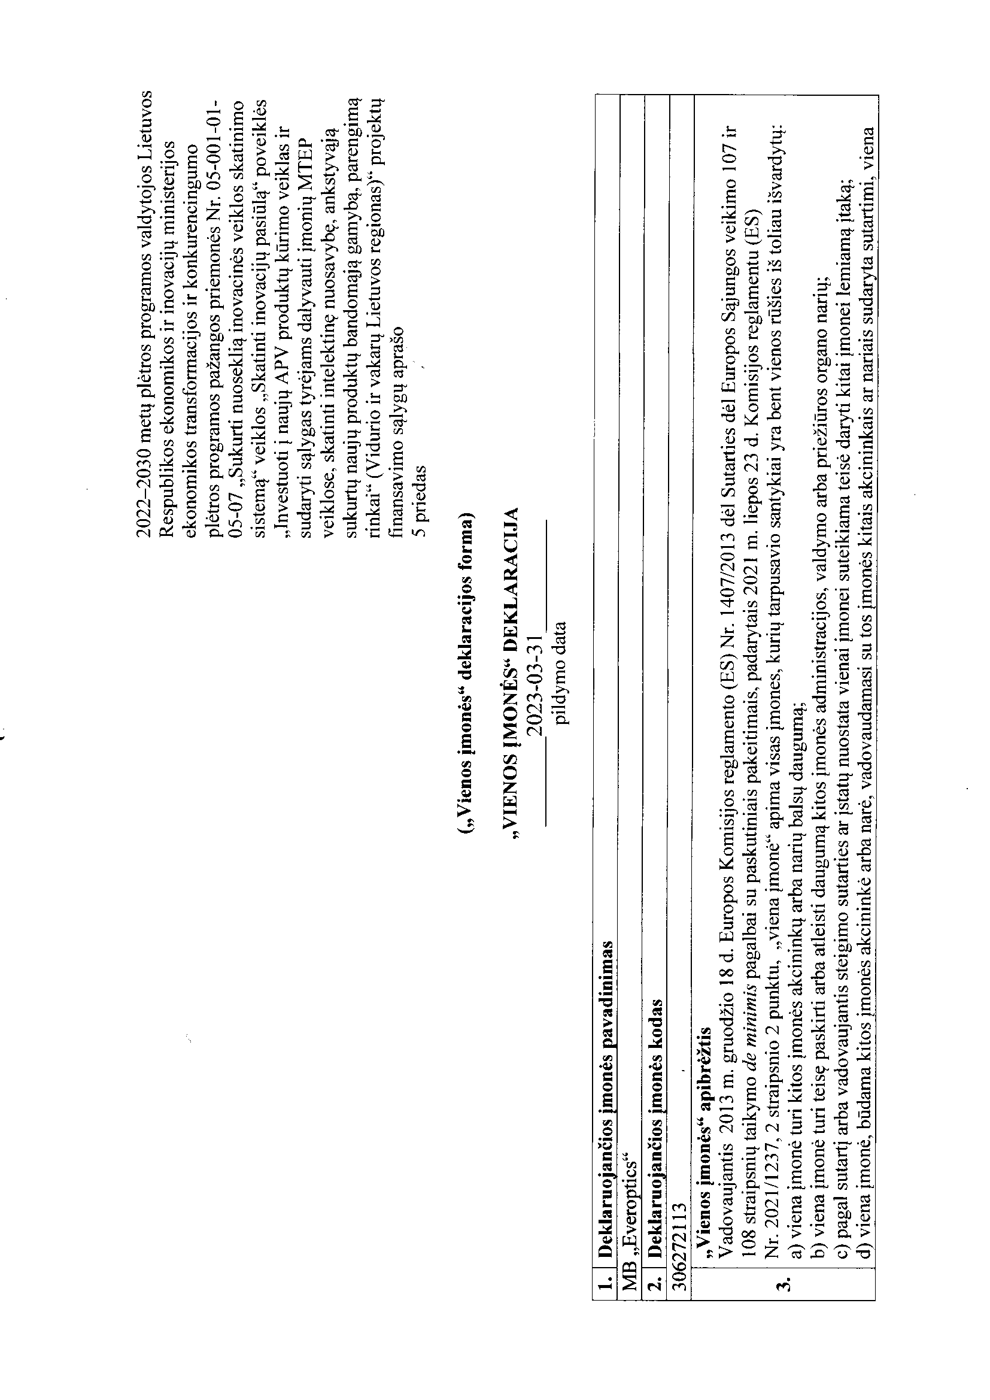
[picture p25: page 1]
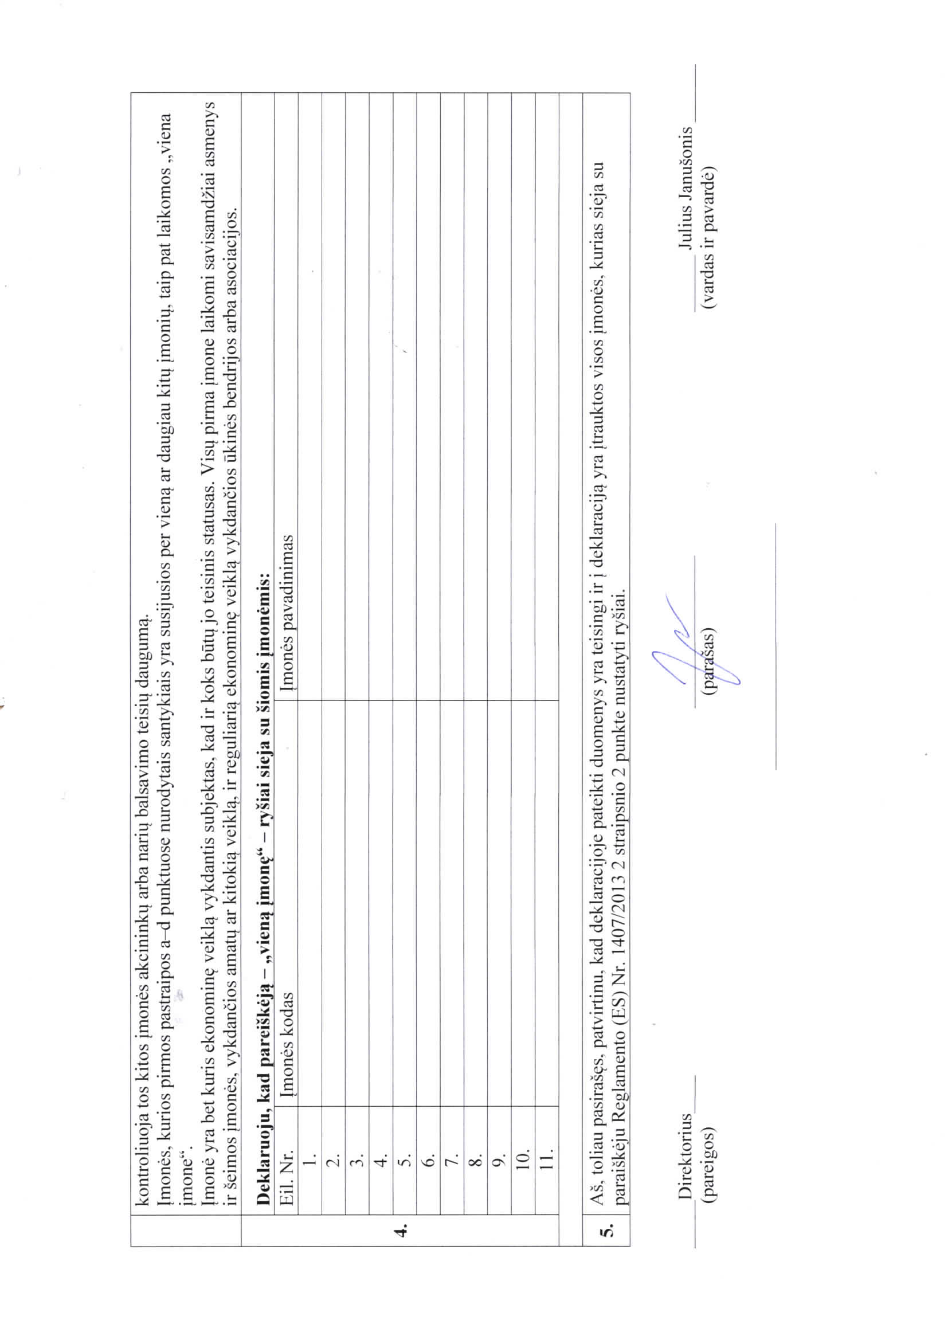
[picture p26: page 2]
