JuliusJanusonis/MB/Inostartas/Dokumentai projekto padavimui/Projekto dokumentai (Everoptics)/Papildomi teikiami dokumentai/cv-Diana_Vertelkiene.pdf

# Diana Vertelkienė

## Profile

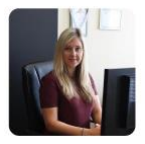
[picture p27: figure]

Practical experience in international project and cluster management.

15+ years’ experience of project administration and implementation of EU FrameWork6, Eurostars, BSR Innovation Express, ERASMUS+ projects.

## Employment History

Head of Science, Technology and Innovation department at UAB „Baltec CNC Technologies“ , Kaunas

August 2013 — now

EU project management / administration (Eurostars, HORIZON, EIT Manufacturing), coordination, preparation of reports and articles, generation of new ideas, implementation of innovations, robotics and IIoT technologies, marketing activities, teamwork.

Implementation of national projects as research specialist (“Intelektas. Bendri mokslo–verslo projektai“, “Eksperimentas”).

Director / Cluster manager at UAB „De Futuro“ , Kaunas

August 2013 — now

Management of health technology cluster iVita activities, publicity, communication with cluster members, search for new members, establishment and maintenance of contacts with international clusters, implementation of new projects, organization of Lithuanian and international exhibitions, organization of various events.

Temporary job in EU projects as researcher/project specialist:

12/2019-now Erasmus+ project "Fostering the innovation in the European habitat and e-health sectors through the Public Procurement of Innovative solutions to improve the European SMEs competitiveness"(HAePPI);

10/2017-03/2020 "Wellness cluster iVita Research, Development and Innovation open access infrastructure creation (iVitaLab)"

03/2017-02/2019 "Development of mobile health systems for managing a person's aerobic endurance load and receiving e-consultations (HRV workout)";

02/2017-01/2019 "iVita awareness and network development (InterGates)"

04/2017-09/2018 BSR Innovation Express projec “International network gates to Germany (IntergatesDE)”;

10/2013-12/2014 BSR Innovation Express project “Networking and knowledge exchange to increase cluster's visibility in international markets (NETWORK)”

Consultant at Lithuanian innovation centre in the project INOLINK, Vilnius

April 2020 — now

Specialist for clusters strategy and business models development,

Details

Kaunas, Lithuania
+37061275388
dianamargyte@gmail.com

Date of birth

30/09/1982

Nationality

Lithuanian

Driving license

B

Skills

Leadership Experienced

Team work Expert

Communication Expert

Innovation Expert

Cluster management Expert

Industry Trends & Sales Expert

Project writing Expert

Consulting Expert

Languages

English C1

Russian B2

Lithuanian Native speaker

Hobbies

Traveling, sport, music, healthy lifestyle implementation of various national and international cluster activities.

Project specialist/ Researcher at Qualifications and vocational education and training development centre, Vilnius

January 2019 — November 2020

Erasmus+ project "Industry 4.0 CHAlleNGE: Empowering Metalworkers For Smart Factories Of The Future (4CHANGE)". Specialist of national professional standard and creation of teaching program of metalworkers and CNC operators with project team.

Sales manager at UAB „Baltec CNC Technologies“, Kaunas

March 2009 — August 2011

Execution of sales plans, work with the company's foreign customers, market research and other tasks in sales activities

Marketing manager/ Project manager at UAB „Baltec CNC Technologies“, Kaunas

February 2006 — February 2009

Marketing project management; preparation of marketing plans, publicity of projects, organization of international exhibitions company image building; work with advertising agencies, organization of events; website maintenance; preparation of articles; market research and other tasks in marketing activities.

Temporary work as project administrator in EU projects:

02/2006-05/2008 "Comprehensive health equipment system" Gudris ".

10/2006-09/2009 FrameWork 6 project FP6-2005-IST-5 „Solving Major Problems in MicroSensorial Wireless networks „uSWN“.

## Education

Master, Kaunas University of Technology

September 2005 — June 2007

Economics, marketing specialization

April 2020 — April 2020

## Courses

BSR Cluster Manager Education

August 2020- May 2021 (40 weeks education)

https://www.clustereducation.com/

Internationalization ans Commercialization Methods for Business Networks, Poland

April 2015 — April 2015

International consultations for Lithuanian clusters managers. Modules: Cluster Foundation/ Preparation of strategy and action plan/ Cluster developement, Gerd Meier zu Köcker, VDI/VDE-IT

April 2014 — April 2014
