JuliusJanusonis/MB/Inostartas/Dokumentai projekto padavimui/Projekto dokumentai (Everoptics)/Papildomi teikiami dokumentai/Pažyma dėl patalpų naudojimo kainos teikiant verslo inkubavimo paslaugas.pdf

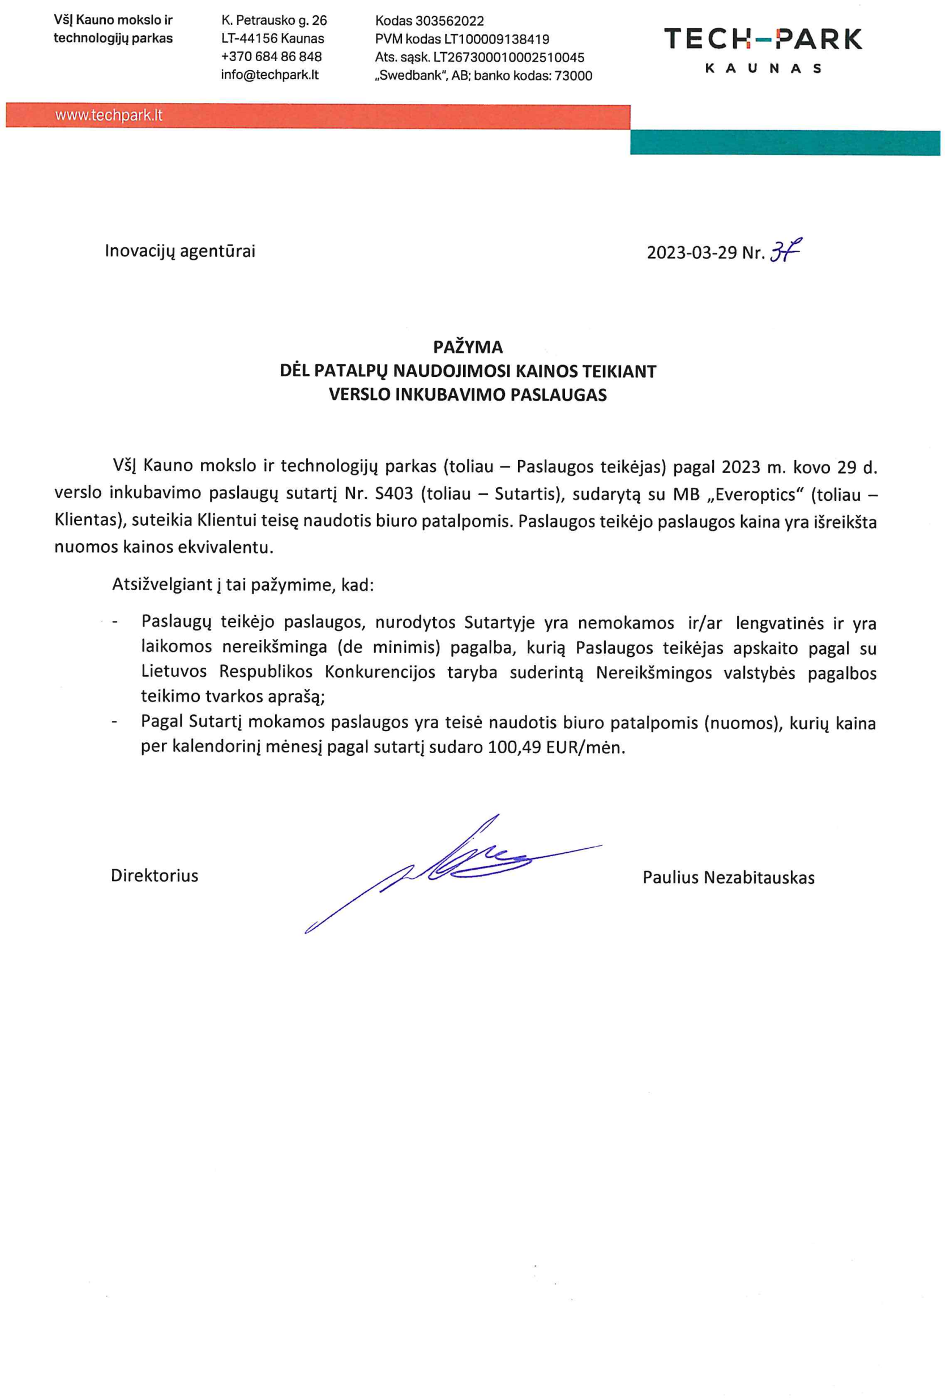
[picture p29: page 1]
