JuliusJanusonis/MB/Inostartas/EVRK2red_klasif_leidinys.pdf

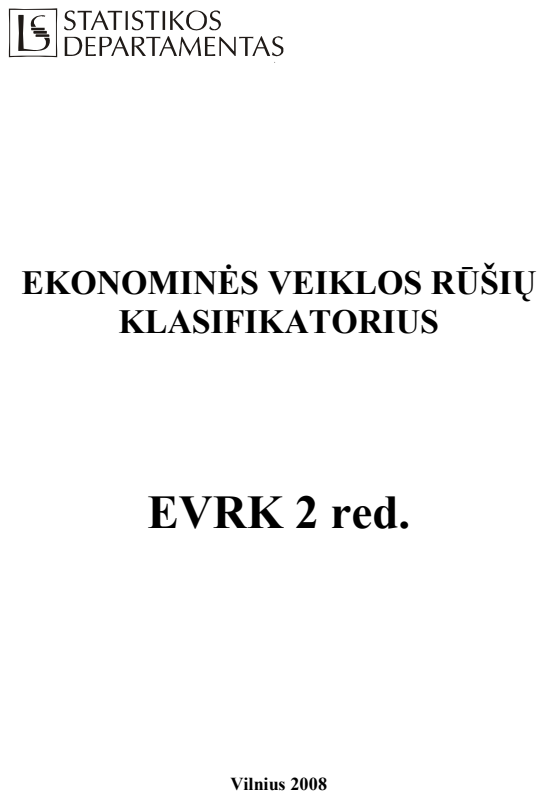
[picture p30: page 1]
EVRK 2 red.; Vilnius 2008

EKONOMINĖS VEIKLOS RŪŠIŲ
KLASIFIKATORIUS

### © Statistikos departamentas prie Lietuvos Respublikos Vyriausybės

Ekonominės veiklos rūšių klasifikatorius (EVRK 2 red.)

### TURINYS

### 2 PRIEDAS. Gamybos procesą užsakančių (outsourcing) vienetų klasifikavimo taisyklės ir

EKONOMINĖS VEIKLOS RŪŠIŲ KLASIFIKATORIAUS (EVRK 2 red.) STRUKTŪRA ........ 33

D SEKCIJA | ELEKTROS, DUJŲ, GARO TIEKIMAS
E SEKCIJA | VANDENS TIEKIMAS, NUOTEKŲ VALYMAS, ATLIEKŲ
G SEKCIJA | DIDMENINĖ IR MAŽMENINĖ PREKYBA; VARIKLINIŲ
O SEKCIJA | VIEŠASIS VALDYMAS IR GYNYBA; PRIVALOMASIS
R SEKCIJA | MENINĖ, PRAMOGINĖ IR POILSIO ORGANIZAVIMO VEIKLA........ 61
T SEKCIJA | NAMŲ ŪKIŲ, SAMDANČIŲ DARBININKUS, VEIKLA; NAMŲ ŪKIŲ VEIKLA, SUSIJUSI SU SAVOMS REIKMĖMS TENKINTI SKIRTŲ NEDIFERENCIJUOJAMŲ GAMINIŲ

### EKONOMINĖS VEIKLOS RŪŠIŲ KLASIFIKATORIAUS (EVRK 2 red.)

D SEKCIJA ELEKTROS, DUJŲ, GARO TIEKIMAS IR ORO KONDICIONAVIMAS ...... 156

### E SEKCIJA VANDENS TIEKIMAS NUOTEKŲ VALYMAS, ATLIEKŲ

### G SEKCIJA DIDMENINĖ IR MAŽMENINĖ PREKYBA; VARIKLINIŲ

N SEKCIJA ADMINISTRACINĖ IR APTARNAVIMO VEIKLA | 216 O SEKCIJA VIEŠASIS VALDYMAS IR GYNYBA; PRIVALOMASIS SOCIALINIS DRAUDIMAS | 226 P SEKCIJA ŠVIETIMAS | 230 Q SEKCIJA ŽMONIŲ SVEIKATOS PRIEŽIŪRA IR SOCIALINIS DARBAS | 234 R SEKCIJA MENINĖ, PRAMOGINĖ IR POILSIO ORGANIZAVIMO VEIKLA | 238 S SEKCIJA KITA APTARNAVIMO VEIKLA | 243

T SEKCIJA NAMŲ ŪKIŲ, SAMDANČIŲ DARBININKUS, VEIKLA;

### NAMŲ ŪKIŲ VEIKLA, SUSIJUSI SU SAVOMS REIKMĖMS TENKINTI SKIRTŲ NEDIFERENCIJUOJAMŲ GAMINIŲ GAMYBA IR PASLAUGŲ TEIKIMU | 248 U SEKCIJA EKSTRATERITORINIŲ ORGANIZACIJŲ IR ĮSTAIGŲ VEIKLA | 249

### PRATARMĖ

1. Ekonominės veiklos rūšių klasifikatorius (sutr. EVRK 2 red.) parengtas pagal Europos Sąjungos Statistikos Tarnybos (EUROSTAT) paruoštą klasifikatorių “Nomenclatures des Activities de Communite Europeene” - NACE rev. 2 (Statistinis Europos Bendrijos ekonominės veiklos rūšių klasifikatorius - NACE 2 red. ).
2. NACE 2-oji red. nustato atskirų kategorijų veiklos sritis, kodus, pavadinimus, t.y. sekcijas, skyrius, grupes, klases, visoms Europos Sąjungos šalims narėms. Kadangi NACE siejasi su Tarptautiniu standartiniu gamybiniu visų ekonominės veiklos rūšių klasifikatoriumi (ISIC 4 red.), jis yra svarbi statistinės informacijos pagal ekonominės veiklos rūšis palyginimo priemonė pasaulio lygmeniu. Siekiant patenkinti atskirų šalių nacionalinės statistikos poreikius, sudaryta galimybė papildyti klasifikatorių žemiausiais lygmenimis, nepažeidžiant NACE 2-osios red. struktūrinės schemos. EVRK 2 red. papildytas dviejų ženklų lygmeniu – poklasiais.
3. Ekonominės veiklos rūšių klasifikatorius yra susistemintas visuomeninių ir ekonominių veiklos rūšių, egzistuojančių šalies ūkyje, rinkinys, kurio klasifikavimo vienetas yra veiklos rūšis. EVRK vartojimas leidžia visus šalyje egzistuojančius ūkio subjektus suskirstyti į kategorijas bei rinkti gyventojų, produkcijos, užimtumo, žemės ūkio, pajamų ir kitus duomenis pagal veiklos rūšis. Šis klasifikatorius vartojamas lyginant šalies ir tarpvalstybinius statistikos duomenis.
4. Ekonominės veiklos rūšių klasifikatoriui kaip valstybiniam buvo pritarta 1995 m. gegužės 17 d. Vyriausybės nutarimu Nr. 696. Pirmoji EVRK redakcija buvo parengta pagal NACE 1 red., kuri Europos Sąjungos šalyse galutinai įsigaliojo nuo 1995 m. sausio 1 d. 2002 m. buvo patvirtintas NACE 1.1 red. pagal kurį buvo parengtas jį atitinkantis nacionalinis EVRK 1.1 klasifikatorius, įsigaliojęs nuo 2003 sausio 1 d. Šioje klasifikatoriaus versijoje struktūriniai pakeitimai buvo nežymūs. NACE 2 red. – tai ilgo penkerius metus trukusio konsultacijų proceso, kuriame dalyvavo ES nacionaliniai statistikos institutai, Europos prekybos ir verslo asociacijos, Europos centrinis bankas ir JT statistikos tarnyba, rezultatas, kuris buvo patvirtintas 2006 m. ir ES šalyse įsigaliojo nuo 2008 m. pradžios. EVRK 2 red. yra NACE 2 red. nacionalinė versija.

### EKONOMINĖS VEIKLOS RŪŠIŲ KLASIFIKATORIAUS ĮVADINĖS TAISYKLĖS

### Santrumpų sąrašas

CN | Kombinuotoji nomenklatūra – Europos prekių klasifikatorius
CPA | Europos produktų pagal veiklos rūšį klasifikatorius
CPC | Jungtinių Tautų svarbiausias produktų klasifikatorius
EEB | Europos Ekonominė Bendrija
ESA | Europos nacionalinių ir regioninių sąskaitų sistema
ES | Europos Sąjunga
HS | Pasaulio muitų organizacijos suderinta prekių aprašymo ir kodavimo sistema
ISIC | Jungtinių Tautų tarptautinis standartinis gamybinis visų veiklos rūšių klasifikatorius
KAU | Veiklos rūšies vienetas
NACE | Europos ekonominės veiklos rūšių klasifikatorius
PRODCOM | Europos kasybos ir apdirbamosios gamybos produkcijos statistikos sistema
RAMON | Eurostato tiesioginės prieigos metaduomenų serveris http://ec.europa.eu/eurostat/ramon/index.cfm?TargetUrl=DSP_PUB_WELC
SITC | Jungtinių Tautų standartinis tarptautinės prekybos klasifikatorius
NSS | Nacionalinių sąskaitų sistema
SPK | Statistikos programų komitetas
JT | Jungtinės Tautos
BEC | Makroekonomikos kategorijų klasifikatorius

### 1 SKYRIUS. Įvadas ir istorinis pagrindas

### 1.1. NACE ir integruota ekonominės veiklos rūšių ir produktų klasifikatorių sistema

1. NACE – tai santrumpa¹
, vartojama pažymėti įvairiems statistiniams ekonominės veiklos rūšių klasifikatoriams, kurie Europos Sąjungoje buvo sukurti nuo 1970 metų. NACE yra plataus diapazono statistikos duomenų rinkimo ir skelbimo pagrindas pagal ekonominės veiklos rūšį ekonomikos (pavyzdžiui, gamybos, užimtumo, nacionalinių sąskaitų) ir kitose statistikos srityse.
2. NACE pagrindu rengiama statistika yra palyginama Europos ir bendrais bruožais pasaulio lygmeniu. NACE naudojimas privalomas Europos statistikos sistemoje.

Tarptautinė ekonominių klasifikatorių sistema

3. NACE pagrindu rengiama statistika palyginama pasaulio lygmeniu, nes NACE yra integruotos statistinių klasifikatorių, daugumą kurių rengia Jungtinių Tautų statistikos tarnyba, sistemos dalis. Kalbant apie Europą, šią sistemą galima pavaizduoti taip:

Ekonominė
veikla | Produktai | Prekės

Pasaulio
lygmuo

ES lygmuo

Nacionalinis
lygmuo

yra rekomendacinis klasifikatorius. Klasifikatoriai giminingi savo struktūra

yra rekomendacinis klasifikatorius. Klasifikatorių ryšys nustatytas sąsajų lentelėse

klasifikatorių ryšys nustatytas sąsajų lentelėse

kur
- ISIC²
yra Jungtinų Tautų tarptautinis standartinis gamybinis visų ekonominės veiklos rūšių klasifikatorius.
- CPC³
yra Jungtinių Tautų svarbiausias produktų klasifikatorius.
- HS⁴
yra Suderinta prekių aprašymo ir kodavimo sistema, tvarkoma Pasaulio muitinių organizacijos.
- CPA⁵
yra Europos ekonominės bendrijos produktų pagal veiklos rūšį klasifikatorius.
- PRODCOM⁶
yra gaminių klasifikatorius, naudojamas ES pramonės gamybos statistikai rengti.
- CN⁷
yra Kombinuotoji nomenklatūra, Europos prekių klasifikatorius, naudojamas užsienio prekybos statistikai rengti.

1
NACE yra prancūzų kalba pavadinimo „Nomenclature statistique des Activités économiques dans la Communauté Européenne“ (Statistinis Europos bendrijos ekonominės veiklos rūšių klasifikatorius) santrumpa. 2 http://unstats.un.org/unsd/cr/registry/regcst.asp?Cl=27&Lg=1 3 http://unstats.un.org/unsd/cr/registry/regcst.asp?Cl=16&Lg=1 4
Suderinta prekių aprašymo ir kodavimo sistema, valdoma Pasaulio muitinių organizacijos (įsteigta 1952 m. kaip Muitinių bendradarbiavimo taryba – CCC). 5
http://forum.europa.eu.int/irc/dsis/nacecpacon/info/data/en/index.htm 6 http://ec.europa.eu/eurostat/ramon/nomenclatures/ 7
Kombinuotoji nomenklatūra – detaliau išskaidyta Suderinta sistema (http://ec.europa.eu/taxation_customs/customs/customs_duties/tariff_aspects/combined_nomenclature/index_en.htm.).
NACE | CPA | PRODCOM

### SITC

CN

CPA
nacionalinė
versija

PRODCOM
nacionalinė
versija
ISIC | CPC | HS

NACE
nacionalinė
versija

4. Tokia integruota sistema leidžia užtikrinti įvairiose statistikos srityse rengiamos statistinės informacijos palyginamumą. Todėl, pavyzdžiui, prekių gamybos statistiką (ES rengiama tyrimuose pagal PRODCOM) galima palyginti su prekybos statistika (ES rengiama pagal Kombinuotąją nomenklatūrą). Daugiau informacijos apie sistemą ir jos sudedamąsias dalis pateikiama 4 skyriuje.
5. NACE parengtas ISIC pagrindu ir yra detalesnis nei ISIC. ISIC ir NACE turi tuos pačius padalinimus aukščiausiu lygmeniu (sekcijos, skyriai), tačiau NACE yra labiau išskaidytas žemesniu lygmeniu (grupės ir klasės).
6. Norint užtikrinti tarptautinį palyginamumą, apibrėžimai ir naudojimo taisyklės, taikomi NACE klasifikatoriui Europos Sąjungoje, atitinka pateiktuosius ISIC įvade.

### 1.2. NACE: naudojimo sritis ir charakteristikos

Statistiniai klasifikatoriai

7. Visi stebėjimo vienetai, kuriuos reikia apibūdinti statistikos požiūriu, turi būti sistemingai klasifikuojami. Klasifikatoriai statistinių stebėjimo vienetų visumą skirsto į grupes, kurios yra kiek įmanoma labiau vienarūšės (homogeninės) atsižvelgiant į statistinio tyrimo objekto charakteristikas.
8. Statistiniai klasifikatoriai aprašomi atsižvelgiant į:
a) išsamų tiriamosios terpės nušvietimą spaudoje;
b) tarpusavyje nesuderinamas kategorijas: kiekvienas elementas turi būti klasifikuojamas tik vienoje klasifikatoriaus kategorijoje;
c) metodinius principus, leidžiančius atitinkamai paskirstyti elementus pagal įvairias klasifikatoriaus kategorijas.
9. Kalbant konkrečiau, hierarchiniai klasifikatoriai yra apibūdinami pagal vis detalesnį kategorijų suskirstymą, tai leidžia rinkti ir pateikti informaciją įvairiais grupavimo lygmenimis.

NACE kaip ES ekonominės veiklos rūšių klasifikatorius

10. NACE yra Europos standartinis ekonominių gamybinės veiklos rūšių klasifikatorius. NACE pateikiama visuma ekonominės veiklos rūšių, suskirstytų tokiu būdu, kad NACE kodas gali būti susietas su statistiniu vienetu, vykdančiu šią veiklą.
11. Ekonominė veikla turi prasmę, kai konkrečioms prekėms pagaminti arba paslaugoms suteikti suderinami tokie ištekliai kaip gamybos priemonės, darbo jėga, gamybos technologijos ar tarpiniai produktai. Taigi veikla apibūdinama išteklių panaudojimu, gamybos procesu ir gamybos (prekių arba paslaugų) apimtimi.
12. Veikla pagal čia pateiktą apibrėžimą gali aprėpti vieną nesudėtingą procesą (pavyzdžiui, audimą), bet gali aprėpti ir daug papildomų procesų, kiekvienas kurių minimas skirtingose klasifikatoriaus kategorijose (pavyzdžiui, automobilio gamybą sudaro tokios konkrečios veiklos rūšys kaip liejimas, kalimas, suvirinimas, surinkimas, dažymas ir kt.). Jeigu gamybos procesas tame pačiame statistiniame vienete organizuotas kaip integruota elementarių veiklos rūšių seka, visas veiklos rūšių derinys laikomas viena veikla.
13. NACE per se nesuteikia kategorijų konkretiems statistinių vienetų tipams: vienetai gali vykdyti kelių rūšių ekonominę veiklą ir gali būti apibūdinami skirtingais būdais pagal konkrečias charakteristikas (susijusias, pavyzdžiui, su vieta, žr. skirsnį „Statistiniai vienetai“).

NACE naudojimo sritis ir apribojimai

14. Klasifikuojant pagal NACE neturi reikšmės gamybos vieneto nuosavybės forma, teisinės organizacijos tipas arba veikimo būdas, nes tokie kriterijai nėra susiję su vykdomos veiklos charakteristikomis. Vienetai, vykdantys tą pačia ekonominę veiklą, yra priskiriami tai pačiai NACE kategorijai, nepriklausomai nuo to, ar jie (jų dalys) yra įregistruoti juridiniai asmenys, privatūs savininkai ar vyriausybė bei ar pagrindinė bendrovė yra užsienio subjektas ir ar pagrindinė bendrovė susideda iš daugiau nei vienos įmonės. Todėl čia nėra ryšio tarp NACE ir Institucinių vienetų klasifikatoriaus, naudojamo nacionalinių sąskaitų sistemoje (NSS) arba Europos sąskaitų sistemoje (ESS).
15. Apdirbamosios gamybos veiklai apibūdinti neturi reikšmės, ar darbas atliekamas mechanizuotai ar rankiniu būdu, ar prekės gaminamos gamykloje ar namų ūkyje. Šiuolaikiškumas ar tradiciškumas nėra NACE kriterijus.
16. NACE klasifikatoriuje nėra skirtumo tarp oficialios ir neoficialios arba teisėtos ir nelegalios gamybos. Klasifikatorius pagal teisinės nuosavybės, organizacijos rūšį arba veikimo būdą galima sukurti atskirai. Su NACE naudojami kryžminiai klasifikatoriai galėtų suteikti naudingos papildomos informacijos.
17. NACE klasifikatoriuje nėra skirtumo tarp rinkos ir ne rinkos veiklos rūšių, kaip apibrėžta SNA / ESA, net jeigu šis skirstymas yra svarbus jų požymis. Ekonominės veiklos rūšių skirstymas pagal šį principą naudingas tais atvejais, jeigu renkami duomenys apie veiklą, vykdomą tiek rinkos, tiek ne rinkos sąlygomis. Skirstant veiklos rūšis pagal šį kriterijų, reikėtų kartu jas klasifikuoti ir pagal NACE kategorijas. Ne rinkos paslaugas pagal NACE teikia tik vyriausybinės organizacijos arba ne pelno organizacijos, teikiančios paslaugas namų ūkiams, dažniausiai švietimo, sveikatos priežiūros, socialinio darbo ir kitose srityse.
18. NACE klasifikatoriuje yra kategorijų, skirtų namų ūkių veiklai, susijusiai su savoms reikmėms tenkinti skirtų nediferencijuojamų gaminių gamyba ir paslaugų teikimu. Tačiau šios kategorijos aprėpia tik dalį namų ūkių ekonominės veiklos, nes namų ūkiai, vykdantys aiškiai apibrėžtą veiklą (rinkos arba ne rinkos), klasifikuojami atitinkamose NACE kategorijose.

NACE struktūra ir kodavimas

19. NACE sudaro hierarchinės struktūros klasifikatorius (kaip numatyta NACE reglamente), įvadinės taisyklės ir aiškinamosios pastabos. NACE struktūra aprašyta NACE reglamente:
i. pirmasis lygmuo, kurį sudaro pagal abėcėlę suskirstytos kategorijos (sekcijos),
ii. antrasis lygmuo, kurį sudaro pagal dviejų ženklų skaitmeninius kodus suskirstytos kategorijos (skyriai),
iii. trečiasis lygmuo, kurį sudaro pagal trijų ženklų skaitmeninius kodus suskirstytos kategorijos (grupės),
iv. ketvirtasis lygmuo, kurį sudaro pagal keturių ženklų skaitmeninius kodus suskirstytos kategorijos (klasės). Sekcijų lygmens kodas nėra integruotas į NACE kodą, kurį sudaro skyriai, grupės ir klasės, aprašančios konkrečią veiklą. Pavyzdžiui, veikla „Klijų gamyba“ priskiriama 20.52 kodui, sudarytam iš skyriaus kodo – 20, grupės kodo – 20.5 ir klasės kodo – 20.52; C sekcija, kuriai priskiriama ši klasė, į kodo struktūrą nėra įtraukta.
20. Skyriai koduojami nuosekliai. Tačiau kai kur yra paliktos „spragos“, kad būtų galima įtraukti papildomus skyrius, nekeičiant bendros NACE struktūros. Šios spragos yra paliktos sekcijose, kuriose yra didžiausia tikimybė, kad atsiras poreikis įtraukti papildomų skyrių. Šiam tikslui NACE 2 red. nepanaudoti liko šie skyrių kodų numeriai: 04, 34, 40, 44, 48, 54, 57, 67, 76, 83 ir 89.
21. Jeigu tam tikras klasifikatoriaus lygmuo toliau nėra skaidomas į žemesnio lygmens kategorijas, žemesnio lygmens kode šiai pozicijai išreikšti naudojamas „0“. Pavyzdžiui, klasės „Veterinarinė veikla“ kodas yra 75.00, nes skyrius „Veterinarinė veikla“ (kodas 75) nesuskaidytas į grupes arba klases. Klasės „Alaus gamyba“ kodas yra 11.05, nes skyrius „Gėrimų gamyba“ (kodas 11) nesuskaidytas į kelias grupes, bet grupė „Gėrimų gamyba“ (kodas 11.0) suskirstyta į klases.
22. Kur įmanoma, likutinės grupės ar klasės, tokios kaip „kita“ ir / arba „niekur kitur nepriskirta“, yra apibūdintos skaitmeniu 9 (pavyzdžiui, 08.9 grupė „Niekur kitur nepriskirta kasyba ir karjerų eksploatavimas“ ir 08.99 klasė „Kita kasyba ir karjerų eksploatavimas“).

### 1.3. NACE: istorinis ir teisinis pagrindas

Nuo NICE iki NACE 2 red.

23. 1961–1963 m. buvo sukurtas Europos Bendrijos pramonės šakų klasifikatorius (pranc. Nomenclature des Industries établies dans les Communautés Européennes, NICE). Pirmasis (1961 m.) klasifikatorius buvo sudaryta iš didelių skyrių, kurie buvo išskaidyti iki triženklių kodų. Patikslinta (1963 m.) versija jau buvo išskaidyta į smulkesnius poskyrius. NICE aprėpė gavybą, energetiką ir apdirbamąją gamybą bei statybą.
24. 1965 m. buvo sukurtas Europos Bendrijų prekybos ir ūkinės veiklos klasifikatorius (pranc. Nomenclature du commerce dans la CEE, NCE) visoms komercinės veiklos rūšims aprėpti.
25. 1967 m. parengtas paslaugų klasifikatorius, o vėliau – žemės ūkio klasifikatorius. Abu jie buvo sudaryti iš makroekonomikos skyrių.
26. 1970 m. parengtas Europos Bendrijos ekonominės veiklos rūšių klasifikatorius (pranc. Nomenclature générale des activités économiques dans les Communautés européennes, NACE). Kaip matyti iš pavadinimo, tai buvo klasifikatorius, aprėpiantis visas ekonominės veiklos rūšis.
27. Pirmasis NACE klasifikatorius turėjo du esminius trūkumus:
- kadangi šis klasifikatorius nebuvo Bendrijos teisės aktų dalis, duomenys dažnai būdavo renkami pagal jau veikusius nacionalinius klasifikatorius ir vėliau perkeliami į NACE formatą, naudojant perėjimo raktus, kurie neužtikrindavo pakankamo duomenų palyginamumo;
- kadangi NACE 1970 m. buvo sukurtas neatsižvelgiant į pripažintą tarptautinę struktūrą, jis neužtikrino pakankamo duomenų palyginamumo su kitais tarptautiniais ekonominės veiklos rūšių klasifikatoriais.
28. Tada buvo nuspręsta peržiūrėti NACE ir jo struktūrą sulyginti su tarptautiniais standartais. Eurostatas ir valstybių narių atstovai, kurie buvo įtraukti į bendrą Jungtinių Tautų statistikos tarnybos ir Eurostato darbo grupę, tiesiogiai dalyvavo rengiant trečiąją Tarptautinio standartinio gamybinio visų ekonominės veiklos rūšių klasifikatoriaus (ISIC 3 red.) redakciją, kurią Jungtinių Tautų Statistikos komisija patvirtino 1989 m. vasario mėnesį.
29. Vėliau iš Eurostato ir valstybių narių atstovų sukurta darbo grupė parengė peržiūrėtą NACE redakciją, pavadintą NACE 1 red. Pradedant nuo ISIC 3 red., struktūra buvo detalizuojama, siekiant atspindėti Europos veiklos rūšis, kurios buvo nepakankamai aprašytos ISIC. NACE 1 red. buvo nustatytas 1990 m. spalio 9 d. Tarybos reglamentu (EEB) Nr. 3037/90.
30. 2002 m. buvo parengta šiek tiek pakeista NACE 1 red. versija, pavadinta NACE 1.1 red. Į NACE 1.1 red. buvo įtraukti keli papildomi elementai ir pakeisti kai kurie pavadinimai. Atnaujintos redakcijos parengimo tikslas buvo atspindėti:
naujas veiklos rūšis, kurių nebuvo, kai buvo rengiamas NACE 1 red. (pavyzdžiui, Užsakomųjų informacinių paslaugų centro veikla);

veiklos rūšis, kurių svarba dėl techninių arba organizacinių pokyčių labai išaugo, palyginti su tuo metu, kai buvo rengiamas NACE 1 red.;
NACE 1 red. klaidų pataisymus.
31. Veikla, susijusi su NACE peržiūra, prasidėjo 2002 m. Reglamentas, nustatantis NACE 2 red.,
buvo patvirtintas 2006 m. gruodžio mėn. Jo tekstas pateiktas II priede. Jis aprėpia nuostatas, reikalingas diegiant NACE 2 red., ir koordinuotą perėjimą nuo NACE 1.1 red. prie NACE 2 red. įvairiose statistikos srityse. Apskritai NACE 2 red. turi būti pradėtas naudoti įvairiose statistikos srityse, susijusiose su veiklos rūšimis, atliekamomis nuo 2008 m. sausio 1
d. (NACE reglamento 8 straipsnyje išdėstytos jo diegimo nuostatos).

NACE reglamentų pagrindiniai bruožai

32. Valstybės narės ir Komisija nustatė, kad NACE naudojimas turi būti privalomas Europos Sąjungoje. Todėl į NACE nustatančius reglamentus įtrauktos tam reikalingos nuostatos. Statistiniai duomenys, susiję su ekonominės veiklos rūšimis, kuriuos renka Europos Sąjungos valstybės narės, turi būti apdorojami remiantis NACE 2 red. arba jo pagrindu sukurtu nacionaliniu klasifikatoriumi.
33. NACE reglamentais valstybėms narėms leidžiama nacionalinėms reikmėms naudoti NACE pagrindu sukurtas nacionalines versijas. Tačiau tokios nacionalinės versijos turi tiksliai atitikti struktūrinę ir hierarchinę NACE sandarą. Dauguma valstybių narių sukūrė nacionalines versijas, nacionalinėms reikmėms dažniausiai pridėdamos 5 ženklų lygį.
34. Komisijai ir Statistikos programų komitetui yra pavesta stebėti reglamento įgyvendinimą, įtraukti mažus pakeitimus (pavyzdžiui, technologijų pokyčiams atspindėti) ir palaikyti ryšį su tarptautinėmis organizacijomis, susijusiomis su ekonominės veiklos rūšių klasifikatoriais.

### 1.4. NACE peržiūra

35. Dėl ekonominių struktūrų ir organizacijos pokyčių bei technologijų plėtros sukuriamos naujos veiklos rūšys ir gaminiai, kurie gali išstumti dabar turimas veiklos rūšis ir gaminius. Tokie pokyčiai nuolat sukelia sunkumų rengiant statistinius klasifikatorius. Laiko tarpai tarp peržiūrų turi būti ne per ilgi, nes klasifikatoriaus aktualumas laikui bėgant mažėja. Jie neturi būti ir per trumpi, kadangi priešingu atveju tai neigiamai paveiktų duomenų palyginamumą ilgų laikotarpių atžvilgiu. Bet kokia klasifikatoriaus peržiūra, ypač jeigu jos metu atliekami struktūriniai pakeitimai, lemia laiko eilučių lūžius.
36 Labai svarbi tarptautinių ir Europos Sąjungos ekonominės veiklos rūšių ir gaminių klasifikatorių peržiūra, vadinama „Operation 2007“, buvo atliekama 2000–2007 m. Ji aprėpė visus integruotos ekonominių klasifikatorių sistemos klasifikatorius, kaip aprašyta 1.1 skirsnyje. Pagrindiniai kriterijai, dėl kurių atlikta peržiūra:
- tinkamumas dabartinei pasaulio ekonomikai,
- geresnis palyginamumas su kitais nacionaliniais ir tarptautiniais klasifikatoriais,
- šios ir ankstesnių versijų tęstinumas.
Nuo 2002 m. keletą kartų buvo rengiamos konsultacijos su visomis suinteresuotosiomis šalimis, tarp jų Komisijos tarnybomis ir nacionalinėmis statistikos institucijomis, taip pat Europos verslo ir prekybos asociacijomis, kviečiant jas teikti siūlymus ir pastabas dėl NACE 1.1 red. atnaujinimo.
37.Bendrosios NACE 2 red. charakteristikos liko nepakitusios. Atnaujinant NACE 2 red. išlaikyta pagrindinių naudotojų reikalaujamo detalumo lygio ir statistikos institucijų darbo sąnaudų pusiausvyra.
38. Pagrindiniai NACE 1.1 ir NACE 2 red. skirtumai pateikti penktajame skyriuje.

### 2 SKYRIUS. Apibrėžimai ir principai

### 2.1. Kriterijai, panaudoti rengiant NACE

39. Kriterijai, kuriais remiantis nustatomos ir aprašomos klasifikatoriaus kategorijos bet kokiu lygmeniu, priklauso nuo daugelio veiksnių, pavyzdžiui, galimybės naudoti klasifikatorių ir duomenų naudingumo. Šie kriterijai skirtingiems klasifikatoriaus lygmenims taikomi skirtingai: žemiausių klasifikatoriaus lygmenų kriterijai yra susiję su gamybos proceso panašumais, nors tai daugeliu atvejų netaikoma aukštesniuose klasifikatoriaus lygmenyse.

Klasių kriterijai

40. Kriterijai, susiję su veiklos rūšių jungimo ir paskirstymo tarp gamybos vienetų būdu, yra itin svarbūs apibrėžiant NACE klases (žemiausio lygmens kategorijas). Jų tikslas – užtikrinti, kad daugeliu atvejų NACE klasės bus tinkamos naudoti tiksliam gamybos vienetų klasifikavimui ir kad į tą pačią klasę įtraukti vienetai bus kiek įmanoma panašesni vienas į kitą pagal jų vykdomą veiklą.
41. NACE 2 red., atitinkančiame ISIC 4 red., didesnė svarba apibrėžiant individualias klases teikiama gamybos procesui. Tai reiškia, kad veiklos rūšys grupuojamos kartu, jeigu gaminant prekes arba teikiant paslaugas naudojamas tas pats procesas ir taikomos panašios technologijos.

42. Be to, NACE klasės apibrėžtos taip, kad, jei įmanoma, būtų įgyvendintos šios dvi sąlygos: | a) | tam | tikros
kategorijos prekių ir paslaugų gamyba, kuri apibūdina tam tikrą klasę, sukuria didžiausią gamybos vienetų, klasifikuojamų pagal šią klasę, produkcijos dalį;
b) klasei priskiriami vienetai, kurie gamina didžiąją dalį šiai kategorijai priklausančių ir jai būdingų prekių ir paslaugų .
43. Kitas svarbus aspektas formuojant NACE klases yra santykinė įtrauktinų veiklos rūšių svarba. Paprastai atskiros klasės yra sukurtos veiklos rūšims, paplitusioms daugumoje ES valstybių narių arba ypač svarbioms pasaulio ekonomikai. Tam tikros klasės buvo įtrauktos į ISIC, atitinkamai ir į NACE, siekiant užtikrinti tarptautinį palyginamumą.

Grupių ir skyrių kriterijai

44. Priešingai nei klasių atveju, pats gamybos procesas ir technologijos, naudojami gamybinėje veikloje, kaip kriterijus tampa mažiau svarbūs grupuojant veiklos rūšis labiau agreguotais lygmenimis. Aukščiausiu (sekcijų) lygmeniu svarbiu veiksniu tampa ne tik bendrosios gaminamų prekių ir teikiamų paslaugų savybės, bet ir galimas statistinių duomenų panaudojimas, pavyzdžiui, NSS ir ESA struktūroje.
45. Pagrindiniai kriterijai, taikomi nubrėžiant NACE skyrių ir grupių ribas, yra susiję su toliau išvardytomis gamybos vienetų veiklos rūšių savybėmis:
- gaminamų prekių ir teikiamų paslaugų pobūdis,
- prekių ir paslaugų naudojimo paskirtis,
- gamybos sąnaudos, procesas ir technologija.
46. Kalbant apie gaminamų prekių ir teikiamų paslaugų pobūdį, atsižvelgiama į fizinę gaminių sudėtį ir gamybos etapą bei jų tenkinamus poreikius. NACE kategorijų suskirstymas atsižvelgiant į gaminamų prekių ir teikiamų paslaugų pobūdį sudaro pagrindą gamybos vienetus grupuoti pagal naudojamų žaliavų panašumus ir ryšius tarp jų bei pagal gaminių paklausos šaltinius ir rinkas.
47. Anksčiau aprašytam kriterijui priskiriamas svoris kinta skirtingose kategorijose. Kai kuriais atvejais (pavyzdžiui, maisto produktų gamyba, tekstilė, drabužių ir odos pramonė, mašinų ir įrangos gamyba bei paslaugų sektorius) šie trys konkretūs aspektai yra taip glaudžiai susiję, kad dėl svorio priskyrimo kriterijaus problema visai nekyla. Tarpinių produktų atveju didžiausias svoris dažniausiai priskiriamas produktų fizinei sudėčiai ir gamybos etapui. Kalbant apie sudėtingu būdu gaminamas prekes, pirmenybė dažnai teikiama produktų galutiniam vartojimui, technologijai ir gamybos organizavimui, o ne fizinei jų sudėčiai.

### 2.2. Pagrindinės, papildomos (šalutinės) ir pagalbinės veiklos rūšys

48. Gamybos vienetas gali vykdyti vieną arba daugiau ekonominės veiklos rūšių, aprašytų vienoje ar daugiau NACE kategorijų.
49. Pagrindinė statistinio vieneto veiklos rūšis yra tokia veiklos rūšis, kuri daugiausia prisideda prie šio vieneto sukuriamos bendrosios pridėtinės vertės. Pagrindinė veiklos rūšis nustatoma pagal metodą „iš viršaus į apačią“ (žr. 3.1 skirsnį) ir nebūtinai sudaro 50 proc. arba daugiau vieneto sukuriamos bendrosios pridėtinės vertės.
50. Papildoma (šalutinė) veikla yra bet kokia kita vieneto veikla, kurios rezultatas yra trečiosioms šalims skirtos prekės arba paslaugos. Papildomos veiklos sukuriama pridėtinė vertė turi būti mažesnė nei sukuriama pagrindinės veiklos.
51. Reikėtų, viena vertus, atskirti pagrindinę veiklą nuo papildomos veiklos, o kita vertus – pagrindinę veiklą nuo pagalbinės veiklos. Pagrindinė ir papildomos veiklos rūšys paprastai vykdomos pasitelkiant daugelį pagalbinių veiklos rūšių, tokių kaip apskaita, transportavimas, saugojimas, pirkimas, pardavimų skatinimas, remontas ir techninė priežiūra ir kt. Taigi pagalbinės veiklos rūšys yra tos, kurių paskirtis yra tik palaikyti pagrindinę ir papildomas gamybines vieneto veiklos rūšis, tiekiant prekes arba teikiant paslaugas, kuriomis naudojasi tik tas vienetas.
52. Veikla yra pagalbinė, jeigu ji atitinka šias sąlygas:
a) ji tarnauja tik tam tikram gamybos vienetui arba vienetams;
b) sąnaudos įskaitomos į vieneto išlaidas;
c) produkcija (dažniausiai paslaugos, rečiau gaminiai) nėra galutinio produkto dalis ir nedalyvauja formuojant bendrąjį pagrindinį kapitalą;
d) panašaus lygio analogiška veikla atliekama panašiuose gamybos vienetuose.
53. Pavyzdžiui, toliau išvardytos veiklos rūšys nelaikomos pagalbinėmis veikos rūšimis:
a) prekių gamyba ir paslaugų teikimas, kai jos prisideda prie kapitalo augimo, pavyzdžiui, statybos darbai savoms reikmėms, kurie būtų atskirai klasifikuojami kaip statybos, jeigu būtų duomenų; programinės įrangos kūrimas;
b) produktų gamyba, kai didelė jų dalis parduodama rinkoje, net jeigu jų dalis sunaudojama vykdant pagrindinę veiklą;
c) produktų gamyba, kai vėliau jie tampa neatsiejama pagrindinės arba papildomų veiklos rūšių rezultato dalimi (pavyzdžiui, įmonės padalinys gamina dėžes įmonės produkcijai pakuoti);
d) energijos gamyba (integruota elektrinė arba koksinė jėgainė), net jeigu visą energiją suvartoja pagrindinė

įmonė;
e) prekių pirkimas perpardavimui, jų neperdirbant;f) moksliniai tyrimai ir taikomoji plėtra, nes ši veikla neteikia paslaugų, naudojamų gamyboje einamuoju momentu.
54. Visais šiais atvejais, kai yra prieinami duomenys, reikėtų atskirti savarankiškus gamybos vienetus ir pripažinti juos veiklos rūšies vienetais (žr. kitą skyrių) bei klasifikuoti pagal jų veiklos rūšį.

### 2.3. Statistinių vienetų apibrėžimai

55. Norint sukurti visapusišką ekonomikos statistinį vaizdą reikalingas platus informacijos spektras, o organizacinis lygis, pagal kurį ją galima rinkti, kinta pagal duomenų tipą. Pavyzdžiui, bendrovė, vykdanti savo veiklą geografiniu požiūriu keliose skirtingose vietose, duomenis apie bendrovės pelną (pajamas) gali gauti tik iš vienos pagrindinės buveinės, tuo tarpu produkcijos pardavimų duomenis galima būtų gauti ir iš visų geografiniu požiūriu skirtingų gamybos vietų. Todėl, norint pakankamu lygmeniu stebėti ir analizuoti statistinę informaciją, būtina apibrėžti statistinių vienetų sistemą. Jie sudaro tam tikrus informacinius blokus, pagal kuriuos gali būti surinkti duomenys ir klasifikuojami pagal NACE.
56. Skirtingi statistinių vienetų tipai tenkina skirtingus poreikius, bet kiekvienas vienetas yra konkretus subjektas, apibrėžiamas taip, kad jį būtų galima atpažinti ir identifikuoti bei nesupainioti su bet kokiu kitu vienetu. Tai gali būti aiškiai apibrėžtas juridinis arba fizinis asmuo arba, pavyzdžiui, vienarūšės (homogeninės) gamybos atveju – statistinis darinys.
57. Tarybos reglamente dėl statistinių vienetų⁸
aprašyti vienetai išvardyti toliau:
a) įmonių grupė (Enterprise Group);
b) įmonė (Enterprise);
c) veiklos rūšies vienetas (Kind-of Activity-Unit, ) – KAU;
d) vietos vienetas (Local Unit);
e) vietos veiklos rūšies vienetas (Local Kind-of-ActivityUnit) – vietinis KAU;
f) institucinis vienetas (Institutional Unit);
g) homogeninės gamybos vienetas (Unit of Homogenous Production) – UPH;
h) vietos homogeninės gamybos vienetas (Local Unit of Homogenous Production) – vietinis UPH.

Skirtingų statistinių vienetų tipų tarpusavio ryšiai parodyti toliau pateiktoje lentelėje:

| Viena ar daugiau išdėstymo vietų | Vienintelė išdėstymo vieta
Viena ar daugiau veiklos rūšių | Įmonė Institucinis vienetas | Vietos vienetas
Viena veiklos rūšis | KAU UPH | Vietos KAU Vietos UPH

8
1993 m. kovo 15 d Tarybos reglamentas (EEB) Nr. 696/93.dėl statistinių vienetų gamybos sistemai stebėti ir analizuoti Bendrijoje (OL L 76, 1993 3 30, p 1).

Administracinių ir statistinių vienetų sistema pavaizduota toliau pateiktoje lentelėje.

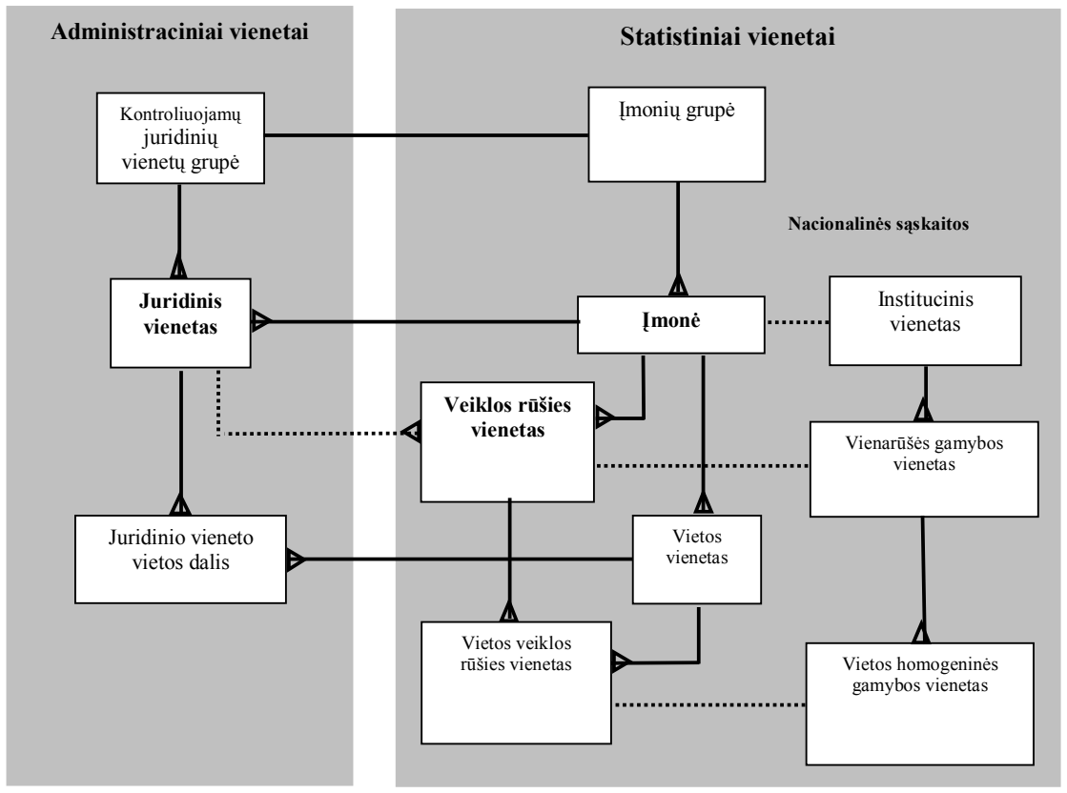
[picture p31: figure]
Statistiniai vienetai; Įmonė; Vietos vienetas; Veiklos rūšies vienetas; Įmonių grupė; Vietos veiklos rūšies vienetas; Administraciniai vienetai; Kontroliuojamų juridinių vienetų grupė; Juridinis vienetas; Juridinio vieneto vietos dalis; Vienarūšės gamybos vienetas; Nacionalinės sąskaitos; Institucinis vienetas; Vietos homogeninės gamybos vienetas

### 3 SKYRIUS. Veiklos rūšių ir statistinių vienetų klasifikavimo taisyklės

### 3.1. Pagrindinės klasifikavimo taisyklės

58. Vienas NACE kodas siejamas su kiekvienu gamybos vienetu, įrašytu statistiniame verslo registre⁹
, pagal jų
pagrindinę ekonominės veiklos rūšį. Pagrindinė veiklos rūšis yra tokia veiklos rūšis, kuri sukuria didžiausią vieneto bendrosios pridėtinės vertės dalį. NACE kodą padeda priskirti: NACE aiškinamosios pastabos, NACE valdymo komiteto priimami sprendimai, klasifikatorių ryšio lentelės ir nuorodos į kitas klasifikavimo sistemas, tokias kaip ISIC, CPA, HS, CN ir kt.
59. Paprasčiausiu atveju, kai vienetas vykdo tik vieną ekonominės veiklos rūšį, ji, kaip pagrindinė, priskiriama tą veiklos rūšį aprašančiai NACE kategorijai. Jeigu gamybos vienetas vykdo kelias ekonominės veiklos rūšis (nepagalbines veiklos rūšis, plg. 2.2 p.), pagrindinė veikla nustatoma pagal kiekvienos atskirai vieneto atliekamos veiklos rūšies sukuriamą pridėtinės vertės dalį, skaičiuojamą pagal toliau aprašytas taisykles.
60. Pridėtinė vertė yra pagrindinė priemonė nustatant vieneto klasifikavimą pagal ekonominės veiklos rūšis. Pridėtinė vertė yra išreiškiama skirtumu tarp pagamintos produkcijos ir tarpinio vartojimo. Ji yra papildomas kiekvieno ekonominio vieneto indėlio į bendrąjį vidaus produktą (BVP) matas.

Pridėtinės vertės pakaitiniai kriterijai

61. Norint nustatyti pagrindinę vieneto veiklos rūšį, reikia žinoti, kokias veiklos rūšis jis vykdo ir kokios yra jų sukuriamos pridėtinės vertės dalys. Kadangi kartais neįmanoma gauti informacijos apie įvairių veiklos rūšių sukuriamos pridėtinės vertės dalis, veiklos rūšių klasifikavimas turėtų būti atliekamas taikant pakaitinius kriterijus. Tokie kriterijai gali būti:
a) gamybos apimtimi pagrįsti pakaitalai:

– vieneto bendrosios produkcijos apimtis, nustatoma su kiekviena veiklos rūšimi susijusioms prekėms arba paslaugoms,

Tarybos reglamentas (EEB) Nr. 2186/93.

– šių produktų grupių, priskirtinų tam tikrai veiklos rūšiai, pardavimų vertė ar apyvarta;
b) sąnaudomis pagrįsti pakaitalai:
– skirtingoms veiklos rūšims priskirtini atlyginimai (ar savisamdžių pajamos),
– žmonių dirbančių pagal skirtingas gamybos vieneto veiklos rūšis, skaičius,
– dirbančių asmenų darbo laikas pagal skirtingas gamybos vieneto veiklos rūšis.
62. Tokie pakaitiniai kriterijai turėtų būti naudojami kaip praktiškai neapskaičiuojamos pridėtinės vertės pakaitalai, siekiant gauti rezultatą, kiek įmanoma artimesnį rezultatui, kuris būtų gautas remiantis duomenimis apie pridėtinę vertę. Pakaitinių kriterijų naudojimas nekeičia pagrindinei veiklai nustatyti taikomų metodų, nes jie yra tik operatyvinės apytikrės pridėtinės vertės reikšmės.
63. Vis dėlto nesudėtingas anksčiau minėtų pakaitinių kriterijų naudojimas gali būti klaidingas. Taip gali atsitikti bet kuriuo atveju, jeigu pakaitinių kriterijų struktūra nėra tiesiogiai proporcinga (neapskaičiuojamajai) pridėtinei vertei.
64. Jeigu kaip pridėtinės vertės pakaitalas naudojamas pardavimų (apyvartos) kriterijus, reikėtų atsižvelgti į tai, kad tam tikrais atvejais apyvarta ir pridėtinė vertė nėra proporcingos. Pavyzdžiui, prekybos apyvartoje pridėtinės vertės dalis paprastai yra mažesnė negu apdirbamojoje gamyboje. Netgi apdirbamojoje gamyboje pardavimų ir apskaičiuotos pridėtinės vertės santykis gali kisti skirtingose veiklos rūšyse ir jų viduje. Kai kurių veiklos rūšių atveju apyvarta apskaičiuojama specifiniu būdu, todėl jų palyginimas su kitomis veiklos rūšimis yra nenaudingas, pavyzdžiui, finansinio tarpininkavimo veikla arba draudimo veikla. Į tai būtina atsižvelgti ir kriterijų pakaitalu naudojant duomenis apie bendrąją produkciją.
65. Daugelis gamybos vienetų verčiasi prekybos ir kita veikla. Tokiais atvejais nežinomos pridėtinės vertės dalies, tenkančios prekybinei veiklai apskaičiuoti, prekybos apyvartos rodikliai yra mažiausiai tinkami pakaitalai. Daug geresnis rodiklis yra bendrasis pelnas (skirtumas tarp prekybos apyvartos ir prekių pirkimų perpardavimo tikslais, atsižvelgiant į atsargų apimties pasikeitimus). Tačiau apyvartinis pelnas gali kisti vienos didmeninės ir mažmeninės prekybos veiklos viduje ir tarp prekybos veiklos rūšių. Be to, reikia atsižvelgti į konkrečias prekybos klasifikavimo taisykles, kurios išdėstytos 3.4 skyriuje.
66. Reikia taip pat atsargiai elgtis, kai taikomi sąnaudomis pagrįsti pakaitiniai kriterijai. Atlyginimų arba užimtumo ir pridėtinės vertės santykis nėra patikimas, jeigu skiriasi darbo imlumas įvairiose veiklos rūšyse. Darbo imlumas gali gerokai kisti skirtingose ekonominės veiklos rūšyse ir veiklos rūšyse, priskirtose tai pačiai NACE klasei. Pavyzdžiui, prekės gamyba rankiniu būdu, palyginti su prekės gamyba naudojant mechanizuotą procesą.

### 3.2. Daugialypės ir integruotos veiklos rūšys

67. Pasitaiko atvejų, kai gamybos vieneto vykdomos veiklos rūšys, proporcingai sudarančios žymią jo veiklos dalį, įtraukiamos į daugiau nei vieną NACE klasę. Tokie atvejai gali susidaryti dėl vertikaliosios veiklos rūšių integracijos (pavyzdžiui, medžių kirtimas, suderintas su lentpjūvės veikla, arba veikla molio kasykloje, suderinta su plytų gamybos veikla) arba dėl horizontaliosios veiklos rūšių integracijos (pavyzdžiui, kepinių gamyba kartu su šokolado ir konditerijos gamyba), arba dėl bet kokio statistinio vieneto atliekamų veiklos rūšių derinio. Šiais atvejais gamybos vienetą reikėtų klasifikuoti remiantis šiame skyriuje pateiktomis taisyklėmis.
68. Tuo atveju, jeigu gamybos vienetas vykdo veiklos rūšis, priskiriamas dviem skirtingoms NACE klasėms, visuomet bus viena veiklos rūšis, sudaranti daugiau nei 50 proc. pridėtinės vertės, išskyrus mažai tikėtiną atvejį, kai abi skirtingos veiklos rūšys sudaro lygiai po 50 proc. pridėtinės vertės. Veikla, sukurianti daugiau nei 50 proc. pridėtinės vertės, yra pagrindinė veikla ir lemia gamybos vieneto klasifikavimą pagal NACE 2 red.
69. Sudėtingais atvejais, kai gamybos vienetas vykdo daugiau nei dvi veiklos rūšis, priskirtas daugiau nei dviem skirtingoms NACE klasėms, kurių nė viena nesukuria daugiau nei 50 proc. pridėtinės vertės, jo klasifikavimas pagal veiklos rūšis atliekamas taikant metodą „iš viršaus į apačią“, kaip aprašyta toliau.

Metodas „iš viršaus į apačią“

70. Metodas „iš viršaus į apačią“ pagrįstas hierarchijos principu: gamybos vieneto klasifikacija žemiausiu klasifikatoriaus lygmeniu turi atitikti jo klasifikaciją aukštesniais struktūros lygmenimis. Kad ši sąlyga būtų patenkinta, iš pradžių reikia nustatyti tam tikrą padėtį aukščiausiu lygmeniu, toliau nustatant žemesnius klasifikatoriaus lygmenis tokiu būdu:
a) nustatyti sekciją, kuri sudaro didžiausią pridėtinės vertės dalį;
b) šioje sekcijoje nustatyti skyrių, kuris sudaro didžiausią pridėtinės vertės dalį šioje sekcijoje;
c) šiame skyriuje nustatyti grupę, kuri sudaro didžiausią pridėtinės vertės dalį šiame skyriuje;
d) šioje grupėje nustatyti klasę, kuri sudaro didžiausią pridėtinės vertės dalį šioje grupėje.

71. Pavyzdžiui, vienetas atlieka šias veiklos rūšis (pridėtinės vertės indėlis veiklos rūšių atžvilgiu):
- Nustatyti pagrindinę sekciją tarp
C sekcijos „Gamyba“ | (52%)
G sekcijos „Didmeninė ir mažmeninė prekyba; Variklinių transporto priemonių
ir motociklų remontas“ | (35%)
M sekcijos „Profesinė, mokslinė ir techninė veikla“ | (13%).
- Nustatyti pagrindinį skyrių pagrindinėje C sekcijoje
25 skyrius | Metalo gaminių, išskyrus mašinas ir įrenginius, | gamyba | 10%
28 skyrius | Niekur kitur nepriskirtų mašinų ir įrangos gamyba | 42%
- Nustatyti pagrindinę grupę pagrindiniame 28 skyriuje
28.1 grupė | Bendrosios paskirties mašinų gamyba | 6%
28.2 grupė | Kitų bendrosios paskirties mašinų ir įrangos gamyba | 5%
28.9 grupė | Kitų specialiosios paskirties mašinų gamyba | 31%
- Nustatyti pagrindinę klasę pagrindinėje 28.9 grupėje
28.93 klasė | Maisto, gėrimų ir tabako apdorojimo mašinų gamyba | 23%
28.95 klasė | Popieriaus ir kartono gamybos mašinų gamyba | | 8%

Taigi teisinga klasė yra 28.93 „Maisto, gėrimų ir tabako apdorojimo mašinų gamyba“, nors didžiausią pridėtinę vertę sukurianti klasė yra 46.61 „Žemės ūkio mašinų, įrangos ir reikmenų didmeninė prekyba“.

Sekcija | Skyrius | Grupė | Klasė | Klasės aprašymas | Dalis
C | 25 | 25.9 | 25.91 | Plieninių statinių ir panašių talpyklų gamyba | 10%
28 | 28.1 28.2 28.9 | 28.11 28.24 28.93 28.95 | Variklių ir turbinų, išskyrus orlaivių, transporto priemonių ir motociklų variklius, gamyba Variklinių rankinių įrankių gamyba Maisto, gėrimų ir tabako apdorojimo mašinų gamyba Popieriaus ir kartono gamybos mašinų gamyba | 6% 5% 23% 8%
G | 46 | 46.1 46.6 | 46.14 46.61 | Mašinų, pramonės įrangos, laivų ir lėktuvų pardavimo agentų veikla Žemės ūkio mašinų, įrangos ir reikmenų didmeninė prekyba | 7% 28%
M | 71 | 71.1 | 71.12 | Inžinerijos veikla ir su ja susijusios techninės konsultacijos | 13%

Toliau pateiktame paveiksle pavaizduotas pavyzdyje pristatytas sprendimo būdas.

72. Dėl ISIC ir NACE neatitikties grupių ir klasių lygmenimis metodo „iš viršaus į apačią“ taikymas pagal NACE gali duoti rezultatus, skirtingus nuo tų, kurie būtų gauti taikant šį metodą pagal ISIC. Jeigu įmanoma, taikant aprašytąjį metodą pirmiausia turėtų būti atsižvelgta į ISIC struktūrą ir klasė nustatoma pagal jį, o po to – pagal NACE. Tai užtikrintų atitiktį pasaulyje naudojamiems klasifikatoriams.
73. G sekcijai „Didmeninė ir mažmeninė prekyba“ metodas „iš viršaus į apačią“ taikomas atsižvelgiant į specifinius reikalavimus. Dėl išsamesnio aprašymo žr. 93–97 punktus.

Gamybos vieneto pagrindinės veiklos rūšies pakeitimai

74. Gamybos vienetai gali keisti savo pagrindinę veiklą iš karto arba laipsniškai per tam tikrą laikotarpį dėl sezoninių veiksnių arba dėl vadovybės sprendimo išleisti kitą produkciją. Nors visais šiais atvejais reikėtų keisti gamybos vieneto klasifikaciją, tačiau pernelyg dažni pakeitimai gali lemti trumpojo (mėnesinių ir ketvirtinių) ir ilgojo laikotarpio statistinių duomenų neatitiktį, todėl gali būti itin sunku juos aiškinti.
75. Bet kokiu atveju, kai tik gamybos vienetas vykdo dvi veiklos rūšis, kurių kiekviena sukuria apie 50 procentų pridėtinės vertės, norint išvengti dažnų pakeitimų, neatspindinčių esminių ekonominės padėties pokyčių, taikoma stabilumo taisyklė. Pagal šią taisyklę pagrindinės veiklos pakeitimas turėtų būti atliekamas, kai šiai veiklos rūšiai priskiriama mažesnė nei 50 procentų pridėtinės vertės dalis mažiausiai dvejus metus.

Vertikaliai integruotų veiklos rūšių klasifikavimas

76. Vertikalioji veiklos rūšių integracija atsiranda tada, kai to paties gamybos vieneto skirtingi gamybos etapai atliekami vienas paskui kitą ir kai vieno proceso išleidžiama produkcija tampa kito proceso gamybos sąnaudomis. Įprastas vertikaliosios integracijos pavyzdys yra medžių kirtimas, tiesiogiai susijęs su lentpjūvės veikla, molio kasimas, suderintas su plytų gamyba, arba gatavų drabužių gamyba tekstilės įmonėje.
77. Taikant NACE 2 red., vertikaliąją integraciją reikėtų traktuoti kaip bet kokią kitą daugialypės veiklos formą, t. y. gamybos vienetas su vertikaliai integruota veiklos rūšių grandine turėtų būti priskirtas šios grandinės pagrindinę veiklos rūšį atitinkančiai klasei, t. y. tokiai klasei, kuriai priskiriama didžiausią pridėtinės vertės dalį sukurianti veikla, kaip nustatyta metode „iš viršaus į apačią“. Šis vertikalios integracijos taikymo būdas pasikeitė, palyginti su ankstesnėmis NACE versijomis. Dėl specifinio vertikaliosios integracijos taikymo būdo žemės ūkyje žr. 92 punktą.
78. Jeigu tam tikriems vertikaliai integruoto proceso etapams pridėtinės vertės arba pakaitinių rodiklių neįmanoma nustatyti tiesiogiai iš gamybos vieneto sudarytų apskaitos dokumentų, galima atlikti palyginimus su

Visos veiklos rūšys

C | G | M
25 | 46 | 71 28
25.9 | 28.9 28.1 | 28.2 | 46.1 | 46.6 | 71.1
25.91 | 28.11 | 28.24 | 28.93 | 28.95 | 46.14 | 46.61 | 71.12
52% | 35% | 13%
10% | 42%
6% | 5% | 31%
23% | 8%

panašiais gamybos vienetais. Antra vertus, tarpinių ir galutinių produktų vertinimas gali būti grindžiamas rinkos kainomis.

Horizontaliai integruotų veiklos rūšių klasifikavimas

79. Horizontalioji veiklos rūšių integracija atsiranda tada, kai kelios veiklos rūšys vykdomos vienu metu naudojant tuos pačius gamybos veiksnius. Šiuo atveju taip pat turi būti taikomas pridėtinės vertės principas, metodas „iš viršaus į apačią“ ir gali kilti anksčiau išvardytos grėsmės naudojant pridėtinės vertės pakaitalus.

### 3.3. Specifinių veiklos rūšių klasifikavimo taisyklės

Veikla, vykdoma už atlygį ar pagal sutartį, ir užsakomoji veikla (outsourcing)

80. Šioje dalyje pateiktos užsakomosios veiklos priskyrimo tam tikroms sritims taisyklės. Išsamus užsakomosios veiklos taisyklių rinkinys, apimantis visus galimus šios veiklos priskyrimo atvejus, pateiktas atskirai. Šiame skyriuje vartojami tokie terminai:
a) Užsakovas – vienetas, sudarantis sutartį su kitu vienetu (rangovu) tam tikroms užduotims vykdyti, pvz., atlikti tam tikras gamybos proceso operacijas arba netgi visą gamybos procesą, teikti įdarbinimo ar kitas verslui būdingas paslaugas.
b) Rangovas – vienetas, sutarties su užsakovu pagrindu vykdantis tam tikras užduotis, pvz., atliekantis tam tikras gamybos proceso operacijas arba netgi visą gamybos procesą, teikiantis įdarbinimo ar kitas verslui būdingas paslaugas. Taip pat vartojama sąvoka subrangovas. NACE klasifikatoriuje rangovo atliekamos veiklos rūšys yra vadinamos „veiklos rūšimis už atlygį ar pagal sutartį“.
c) Užsakomoji veikla – sutartinis susitarimas, pagal kurį rangovas turi atlikti užsakovui tam tikras užduotis, pvz., atlikti tam tikras gamybos proceso operacijas arba netgi visą gamybos procesą, teikti įdarbinimo ar kitas verslui būdingas paslaugas. Užsakomosios veiklos sąvoka taip pat taikoma, kai rangovas yra nesavarankiškas vienetas, o užduotys vykdomos rinkos arba ne rinkos sąlygomis.
Gamybos sričių, kurioms gali būti taikoma užsakomoji veikla, pavyzdžiai yra: apdirbamosios gamybos veiklos rūšys, įdarbinimo paslaugos, pagalbinės funkcijos ir kt.
Užsakovas ir rangovas gali būti išsidėstę toje pačioje arba skirtingose ekonominėse teritorijose. Tikroji buveinės vieta neturi įtakos nei vieno, nei kito gamybos vieneto klasifikavimui.
81. Rangovai, t. y. gamybos vienetai, atliekantys veiklą už atlygį ar pagal sutartį, paprastai klasifikuojami kaip gamybos vienetai, gaminantys tokias pačias prekes arba teikiantys tokias pačias paslaugas savo sąskaita, išskyrus prekybą (žr. toliau pateiktus 93–99 punktus ir G sekcijos aiškinamąsias pastabas) ir statybą (statybos užsakomosios veiklos atveju užsakovas gali būti klasifikuojamas 41.10, o rangovas – 41.20 klasėje).
82. Apdirbamojoje gamyboje užsakovas pateikia rangovui gamybos veiklos rūšių, kurios turi būti atliekamos su žaliavinėmis medžiagomis, technines specifikacijas. Žaliavines medžiagas (pirmines žaliavas ar tarpinius produktus) gali pateikti užsakovas kaip savo nuosavybę arba ne. Tokių veiklos rūšių pavyzdžiai yra: metalo apdirbimas (kalimo, liejimo, presavimo ir liejimo darbai), metalo apdorojimas (pavyzdžiui, chromavimas), drabužių gamyba, drabužių apdailos darbai ir panašios gamybos proceso elementarios operacijos.
83. Užsakovas užsakomosios veiklos atveju visam apdirbamosios gamybos procesui gali būti klasifikuojamas sekcijoje „Apdirbamoji gamyba“ tik tuo atveju, jeigu gamyboje naudojamos žaliavinės medžiagos yra jo nuosavybė (todėl jo nuosavybė yra ir galutinis produktas).
Užsakovas, kuris užsako tik dalį perdirbimo proceso, klasifikuojamas sekcijoje „Apdirbamoji gamyba“. Visais kitais atvejais užsakovas turėtų būti klasifikuojamas pagal pridėtinės vertės principą: G sekcijoje „Didmeninė ir mažmeninė prekyba“ (pagal veiklą ir specifinių prekių pardavimą, žr. toliau pateiktus 93–99 punktus) arba kitose sekcijose, pavyzdžiui, M sekcijoje „Profesinė, mokslinė ir techninė veikla“ ar N sekcijoje „Administracinė ir aptarnavimo veikla“.
84. Įdarbinimo paslaugų užsakomosios veiklos atveju reikia atskirti laikinai, ilgą laiką ir nuolat teikiamas užsakomąsias paslaugas.
a) Laikinai teikiamų užsakomųjų paslaugų atveju užsakovas klasifikuojamas atsižvelgiant į faktiškai vykdomą veiklą (pvz., apdirbamoji gamyba). Rangovas priskiriamas 78.20 klasei (Laikinojo įdarbinimo agentūrų veikla).
b) Ilgą laiką ar nuolat teikiamų užsakomųjų paslaugų atveju užsakovas klasifikuojamas atsižvelgiant į faktiškai vykdomą veiklą (pvz., apdirbamoji gamyba). Rangovas priskiriamas 78.30 klasei (Kitas darbo jėgos teikimas).

Užsakomosios veiklos produkcijos klasifikavimas pagal CPA

85. Ankstesniame skyriuje buvo pažymėta, kad bendruoju atveju veiklos rūšių klasifikavimas nepriklauso nuo to, ar veikla vykdoma savo sąskaita, už atlygį ar pagal sutartį. Tuo tarpu kai pagal NACE veiklos rūšys neatskiriamos, pagaminta produkcija skirstoma priklausomai nuo to, ar žaliavinės medžiagos yra apdirbamosios gamybos vieneto nuosavybė, ar ne. Antruoju atveju šios veiklos rezultatas yra suteiktos perdirbimo paslaugos, įtrauktos į medžiagų sąnaudas, ir už tai yra mokama rangovui.

86. Todėl bendruoju atveju CPA klasifikatoriuje yra skirtumas tarp savo sąskaita pagamintos produkcijos ir už atlygį ar pagal sutartį suteiktų perdirbimo paslaugų. Tam tikros kategorijos ir pakategorės, paprastai atitinkamai koduojamos zx.xx.9 ir zx.xx.99, yra pavadintos „operacijos pagal subrangos sutartį kaip ... gamybos dalis“. Šios pakategorės apima minėtos produkcijos gamybos proceso dalį ar visas operacijas, kurias rangovas atlieka su užsakovo žaliavinėmis medžiagomis. Rangovams mokama už atliktą darbą, jie papildomai gali pateikti nedidelį kiekį pagalbinių medžiagų, reikalingų šiam darbui atlikti. Į šias pakategores neįeina tos pačios kategorijos gaminiai, jeigu juos gamina rangovas iš nuosavų pagrindinių žaliavų.
87. CPA 2002 ir CPC 2 versijoje šios paslaugos yra vadinamos atitinkamai „pramoninėmis paslaugomis“ ir „apdirbamosios gamybos paslaugomis“.

Įrengimo darbai paskirties vietoje

88. Gamybos vienetai, daugiausia užsiimantys gaminių ar įrangos surinkimu ar įrengimu pastatuose jų funkcionavimui užtikrinti, klasifikuojami statybos sekcijoje (43 skyrius).
89. Mašinų ir kitos įrangos įrengimas, kitoks nei susijęs su pastatų (ar inžinerinių statinių) funkcionavimo užtikrinimu, klasifikuojamas 33.2 grupėje „Pramoninių mašinų ir įrangos įrengimas“.

Remontas ir techninė priežiūra

90. Gamybos vienetai, užsiimantys įrangos remontu ir technine priežiūra, klasifikuojami vienoje iš šių kategorijų, priklausomai nuo gaminių tipo:
a) 33.1 grupė „Metalo gaminių, mašinų ir įrangos remontas“;
b) 43 skyrius „Specializuota statybos veikla“;
c) 45.2 grupė „Variklinių transporto priemonių techninė priežiūra ir remontas“;
d) 95 skyrius „Kompiuterių ir asmeninių bei namų ūkio reikmenų taisymas“.
91. Gamybos vienetai, atliekantys kapitalinį orlaivių, lokomotyvų ir laivų remontą, klasifikuojami toje pačioje klasėje kaip ir jas gaminantys vienetai.

### 3.4 Specifinės sekcijų taisyklės ir apibrėžimai

Šiame skyriuje pateiktos taisyklės ir apibrėžimai, į kuriuos būtina atsižvelgti klasifikuojant vienetus tam tikrose sekcijose. Bendrieji aprašymai, apibrėžimai ir sekcijų charakteristikos pateikti atitinkamose aiškinamosiose pastabose.

A sekcija „Žemės ūkis, miškininkystė ir žuvininkystė“

92. Žemės ūkio srityje dažnai sudėtinga suskaidyti pridėtinę vertę, kai gamybos vienetas augina vynuoges ir gamina vyną iš savo išaugintų vynuogių arba kai jis augina alyvuoges ir gamina aliejų iš jų. Šiuo atveju tinkamiausias yra pakaitinis kintamasis „darbo valandų skaičius“ ir jo taikymas bendru atveju šias vertikaliai integruotas veiklos rūšis leis klasifikuoti žemės ūkio sekcijoje. Tokiais pat atvejais, norint užtikrinti suderintą veikimo būdą, ir kitų žemės ūkio produktų gamybos vienetai pagal konvenciją bus klasifikuojami žemės ūkio sekcijoje.

G sekcija „Didmeninė ir mažmeninė prekyba; variklinių transporto priemonių ir motociklų remontas“

93. G sekcijoje prekyba, išskyrus prekybą variklinėmis transporto priemonėmis, yra suskirstyta į didmeninę ir mažmeninę prekybą. Gali būti atvejų, kai vienetas vykdo horizontaliai integruotas prekybos rūšis įvairiomis galimomis formomis: didmeninę ir mažmeninę prekybą kartu arba prekybą parduotuvėse ir ne parduotuvėse, arba prekybą daugeliu prekių. Jeigu vieneto parduodamos prekės nesudaro vienintelės vienos prekių rūšies klasės, sukuriančios bent 50 proc. pridėtinės vertės, taikyti metodą „iš viršaus į apačią“ reikia itin atsargiai, atsižvelgiant į papildomus lygmenis.
94. 46 skyriuje „Didmeninė prekyba“ pirmiausia reikia pasirinkti papildomą suskirstymo lygmenį: 46.1 grupę „Didmeninė prekyba už atlygį ar pagal sutartį“ atskirti nuo 46.2–46.9 grupių junginio. Taigi sprendimas, kurį pirmiausia reikia priimti, yra priskirti vienetą vienai iš šių dviejų dalių remiantis pridėtinės vertės principu. Jeigu pasirenkamas 46.2–46.9 grupių junginys, antrasis etapas būtų pasirinkti kategoriją „Specializuota“ arba „Nespecializuota“ (žr. toliau). Galiausiai grupes ir klases reikia pasirinkti visuomet taikant metodą „iš viršaus į apačią“.
95. Toliau esančioje diagramoje parodytas sprendimų medis, kurį reikia naudoti priskiriant vienetą konkrečiai 46 skyriaus „Didmeninė prekyba“ klasei

Toliau skirstoma pagal parduodamų prekių asortimentą.

96. 47 skyriuje „Mažmeninė prekyba“ pirmiausia reikia pasirinkti papildomą suskirstymo lygmenį: 47.1–47.7 grupių junginys „Mažmeninė prekyba parduotuvėse“ ir 47.8–47.9 grupių junginys „Mažmeninė prekyba ne parduotuvėse“. Taigi sprendimas, kurį pirmiausia reikia priimti, yra priskirti prekybos vienetą vienam iš šių dviejų junginių remiantis pridėtinės vertės principu. Jeigu pasirenkamas grupių junginys „Mažmeninė prekyba parduotuvėse“, antrasis etapas būtų pasirinkti kategoriją „Specializuota“ arba „Nespecializuota“ (žr. toliau). Galiausiai reikia pasirinkti grupes ir klases visuomet taikant metodą „iš viršaus į apačią“.
97. Toliau esančioje diagramoje parodytas sprendimų medis, kurį reikia naudoti priskiriant vienetą konkrečiai 47 skyriaus „Mažmeninė prekyba“ klasei.

Toliau skirstoma pagal parduodamų prekių asortimentą.

98. Ir didmeninės, ir mažmeninės prekybos atveju skirstymas į „specializuota“ ir „nespecializuota“ atliekamas remiantis klasių, kurioms priskiriama parduodamų prekių prekyba, skaičiumi, kai pasirinktose klasėse sukuriama bent po 5 procentus (ir mažiau nei 50% ) pridėtinės vertės:

### 47 skyrius

Parduotuvėse
47.1–47.7

Ne parduotuvėse
47.8–47.9

Nespecializuota
47.1

Specializuota
47.2– 47.7
46.2 | 46.3 | 46.4 | 46.5 | 46.7 46.6

Kitur
47.9

Kioskuose ir
prekyvietėse
47.8

Vyrauja maisto
produktai
47.11

Kitos
47.19

### 46 skyrius

Specializuota ir
nespecializuota didmeninė
prekyba
46.2–46.9

Didmeninė prekyba už
atlygį ar pagal sutartį
46.1

Specializuota
46.2–46.7

Nespecializuota
46.9
46.2 | 46.3 | 46.4 | 46.5 | 46.6 | 46.7

a) jeigu parduodami produktai aprėpia iki keturių bet kuriai iš 46.2–46.7 (didmeninės prekybos atveju) arba 47.2–47.7 (mažmeninės prekybos atveju) grupėms priklausančių klasių, prekybos vienetas laikomas užsiimančiu specializuota prekyba. Tokiu atveju būtina, remiantis pridėtine verte, taikant metodą „iš viršaus į apačią“ nustatyti pagrindinę veiklos rūšį, pirmiausia nustatant pagrindinę grupę, o po to – klasę toje grupėje:
b) jeigu parduodami produktai aprėpia penkias ar daugiau bet kuriai iš 46.2–46.7 (didmeninės prekybos atveju) arba 47.2–47.7 (mažmeninės prekybos atveju) grupėms priklausančių klasių, prekybos vienetas laikomas nespecializuotu. Todėl mažmeninės prekybos atveju jis priskiriamas 47.1 grupei. Jeigu maisto, gėrimų ir tabako prekių pardavimas sudaro bent 35 procentus pridėtinės vertės, pagrindinė veikla priskiriama NACE 2 red. 47.11 klasei. Visais kitais atvejais – 47.19 klasei.
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
