JuliusJanusonis/MB/Mokymasis apie popierius/38-VAS-MRpagal-5-redakcijanuo-20160101.pdf

Audito ir apskaitos tarnyba

38 VAS MR / 1

38-OJO VERSLO APSKAITOS STANDARTO „NERIBOTOS CIVILINĖS ATSAKOMYBĖS JURIDINIŲ ASMENŲ IR MAŽŲJŲ

BENDRIJŲ BUHALTERINĖ APSKAITA IR FINANSINĖS ATASKAITOS“

METODINĖS REKOMENDACIJOS

NUORODŲ TURINYS

I skyrius. BENDROSIOS NUOSTATOS 1–5 punktai. Standarto tikslas ir taikymas
6–8 punktai. Standarte vartojamos sąvokos

II skyrius. PAGRINDINIAI FINANSINIŲ ATASKAITŲ REIKALAVIMAI
9 punktas. Neribotos civilinės atsakomybės juridinių asmenų metinių finansinių ataskaitų rinkinys

### 10 punktas. Mažosios bendrijos metinių finansinių ataskaitų rinkinys

11–13 punktai. Finansinių ataskaitų elementai

### 14 punktas. Finansinių ataskaitų laikotarpiai 15 punktas. Tarpinių finansinių ataskaitų rinkinys

17–25 punktai. Pagrindiniai informacijos pateikimo reikalavimai

III skyrius. BALANSAS

### 26 punktas. Balanso straipsniai 27 punktas. Balanso A dalis Ilgalaikis turtas

28–36 punktai. Nematerialusis turtas
37–56 punktai. Ilgalaikis materialusis turtas 57–66 punktai. Finansinis turtas

### 67 punktas. Kitas ilgalaikis turtas 68 punktas. Balanso B dalis Trumpalaikis turtas

69–76 punktai. Atsargos
77–78 punktai. Balanso atsargų, išankstinių mokėjimų ir nebaigtų vykdyti sutarčių straipsnis

### 79 punktas. Per vienus metus gautinos sumos 80 punktas. Kitas trumpalaikis turtas 81 punktas. Pinigai 82 punktas. Mainai 83 punktas. Neatlygintinai gautas (dovanotas) turtas 84 punktas. Balanso D dalis Dotacijos

85–88 punktai. Dotacija

### 89 punktas. Balanso E dalis Įsipareigojimai

90–97 punktai. Įsipareigojimai

### 98 punktas. Balanso C dalis Nuosavas kapitalas

IV skyrius. PELNO (NUOSTOLIŲ) ATASKAITA
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
