JuliusJanusonis/MB/Banko saskaitos atidarymas/swedbank/juridinio_asmens_deklaracija_LIT.pdf

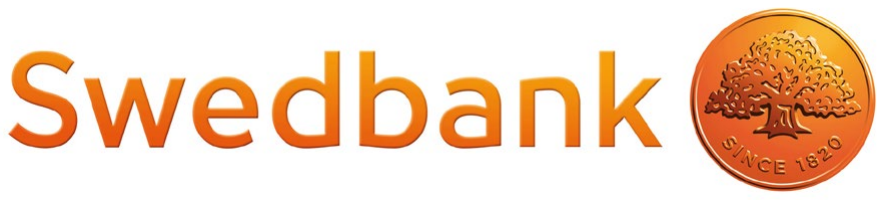
[picture p32: figure]

Puslapis 1 iš 13 | v13 nuo 2022-08-01

## Kliento klausimynas juridiniams asmenims

Gerbiamas Kliente,

Siekdami įvykdyti teisės aktų, susijusių su pinigų plovimo ir teroristų finansavimo prevencija, bei kitų teisės aktų, taikomų „Swedbank“, AB ir kitoms Lietuvoje registruotoms „Swedbank“ grupės įmonėms (toliau – Bankas), reikalavimus, prašome užpildyti šį klausimyną. Išsamus klausimyno užpildymas yra privaloma sąlyga norint naudotis Banko paslaugomis. Prašoma informacija apima asmens duomenis, ir mes tvarkysime tokius asmens duomenis pagal Banko
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
