JuliusJanusonis/MB/Inostartas/Dokumentai projekto padavimui/Atnaujinti/top picture.png

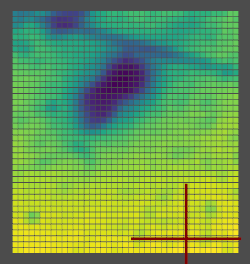
Inostartas/Dokumentai projekto padavimui/Atnaujinti/top picture.png
