JuliusJanusonis/MB/Inostartas/Metalines detales ir projektavimas/Nuotraukos (Surinkto)/1 colio bandinys.png

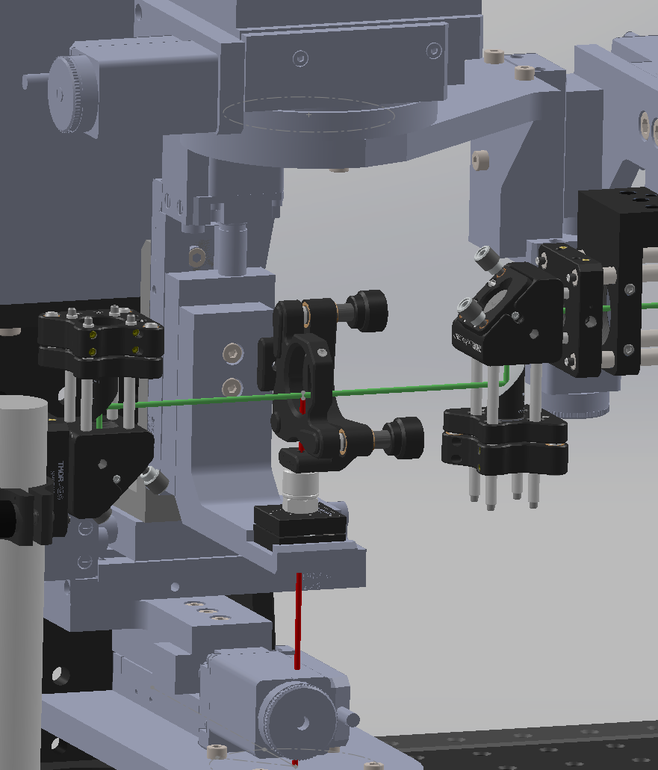
Inostartas/Metalines detales ir projektavimas/Nuotraukos (Surinkto)/1 colio bandinys.png
