JuliusJanusonis/MB/Inostartas/Metalines detales ir projektavimas/Nuotraukos (Surinkto)/45 kampu visas CAD.png

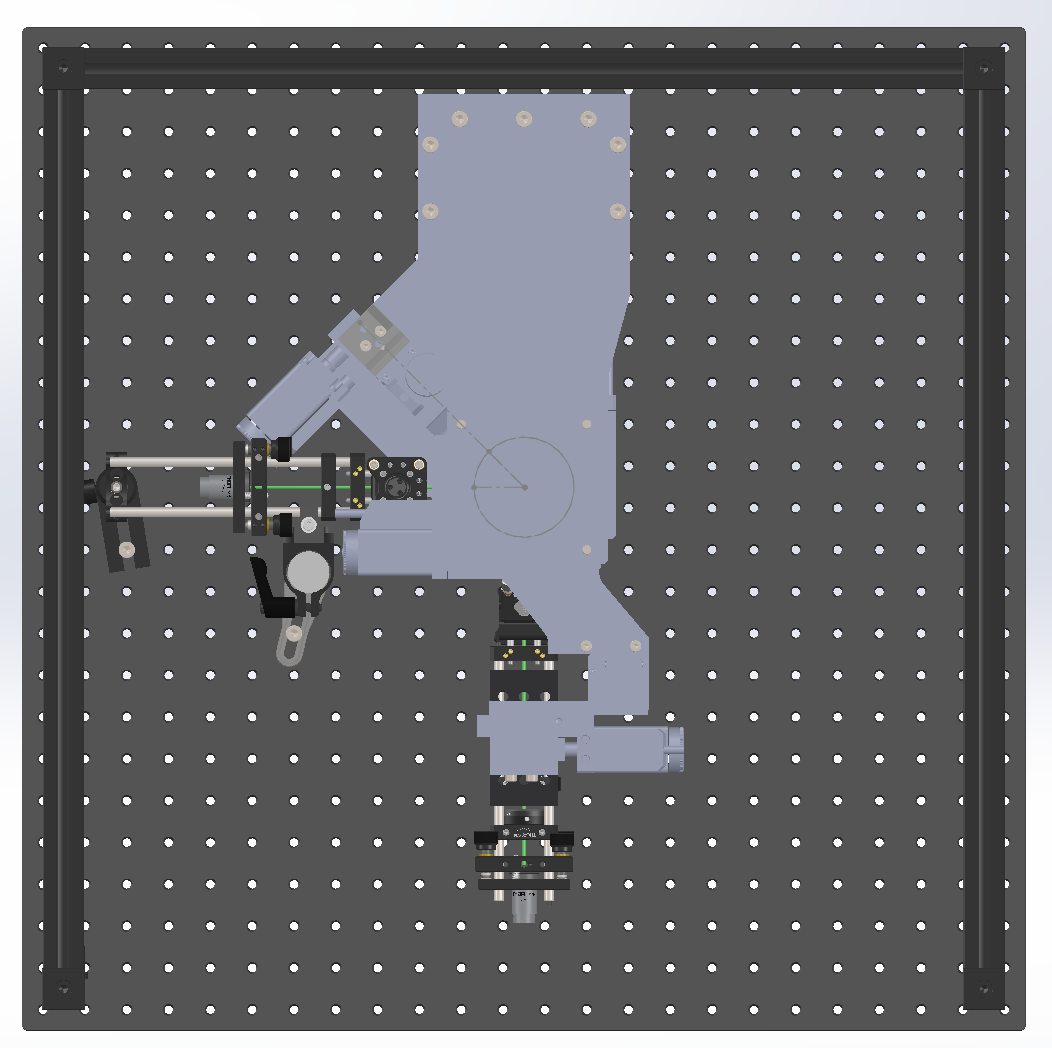
Inostartas/Metalines detales ir projektavimas/Nuotraukos (Surinkto)/45 kampu visas CAD.png
