JuliusJanusonis/MB/Inostartas/Metalines detales ir projektavimas/Nuotraukos (Surinkto)/IMG_20220218_154714.jpg

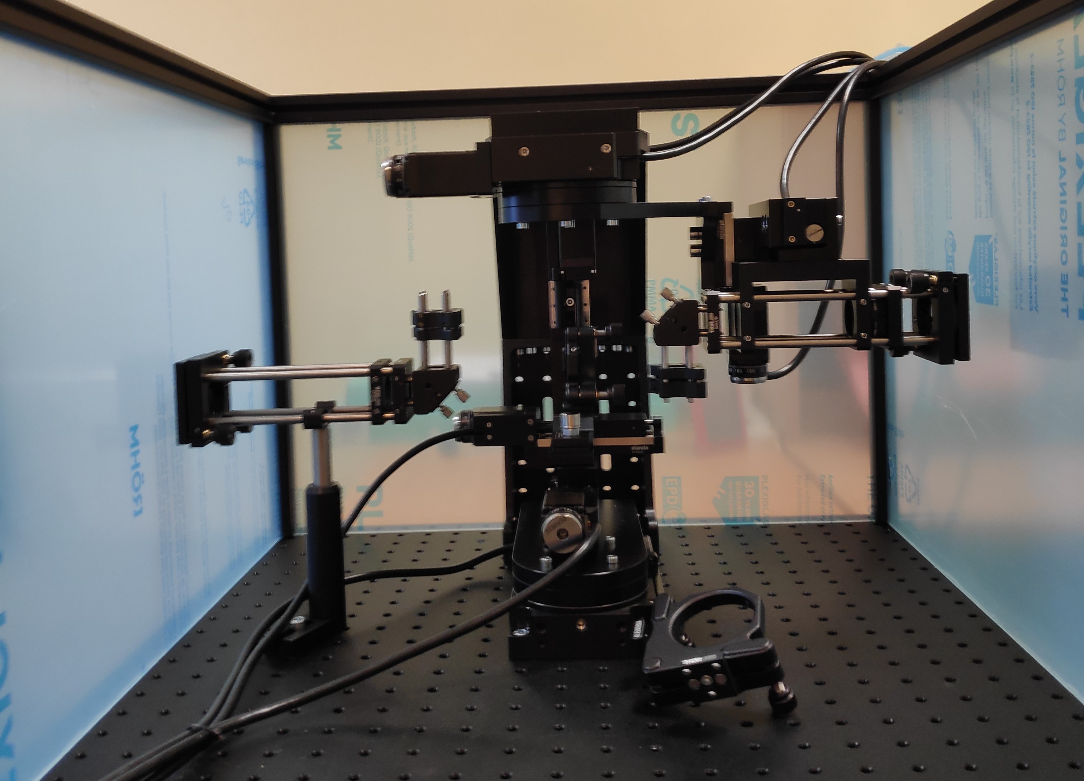
Inostartas/Metalines detales ir projektavimas/Nuotraukos (Surinkto)/IMG_20220218_154714.jpg
