JuliusJanusonis/MB/Inostartas/Metalines detales ir projektavimas/Nuotraukos (Surinkto)/IMG_20220218_154716.jpg

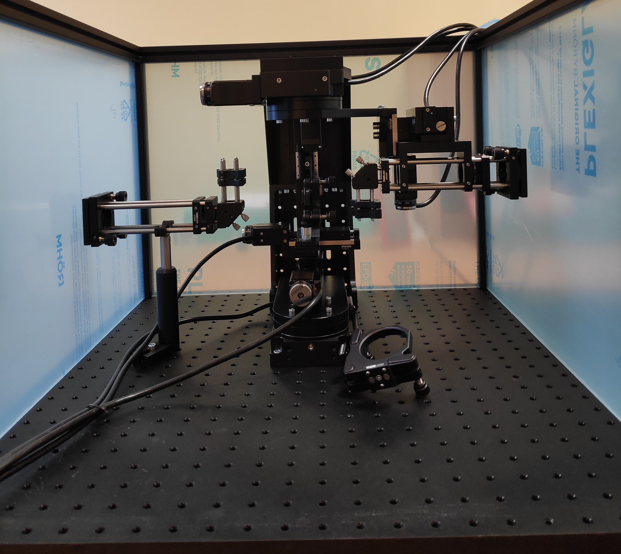
Inostartas/Metalines detales ir projektavimas/Nuotraukos (Surinkto)/IMG_20220218_154716.jpg
