JuliusJanusonis/MB/Inostartas/Metalines detales ir projektavimas/Nuotraukos (Surinkto)/IMG_20220218_154751(1).jpg

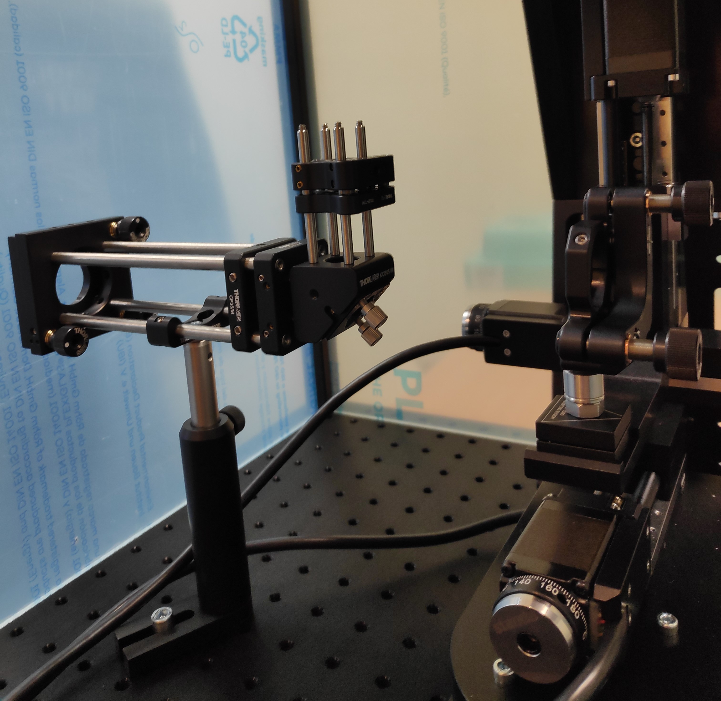
Inostartas/Metalines detales ir projektavimas/Nuotraukos (Surinkto)/IMG_20220218_154751(1).jpg
