JuliusJanusonis/MB/Inostartas/Metalines detales ir projektavimas/Nuotraukos (Surinkto)/Surinkimo ranka.png

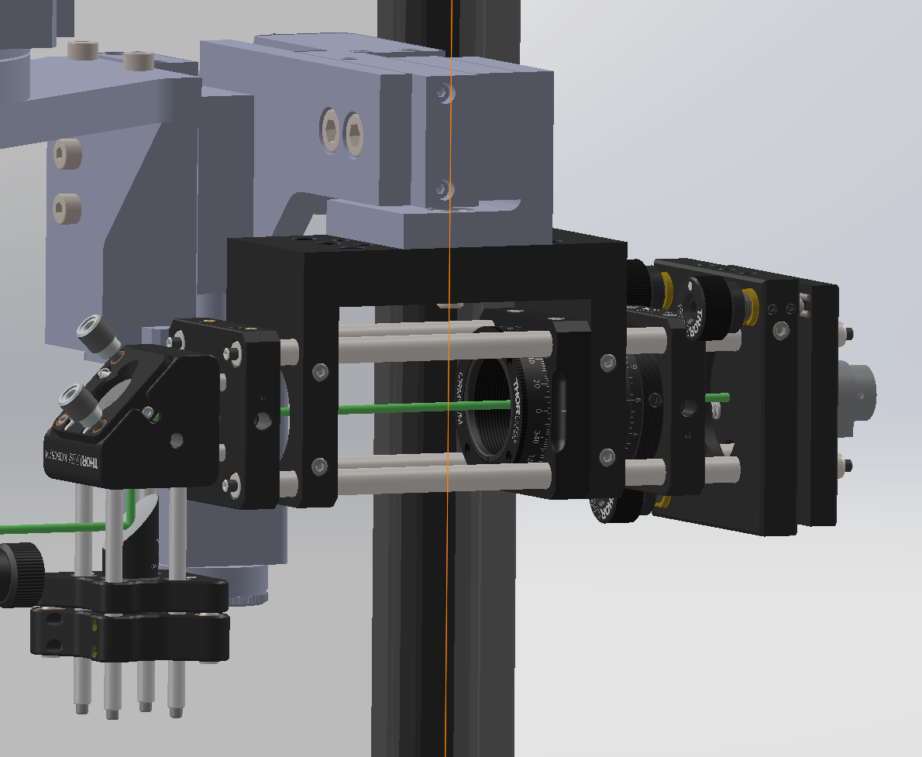
Inostartas/Metalines detales ir projektavimas/Nuotraukos (Surinkto)/Surinkimo ranka.png
