JuliusJanusonis/MB/Inostartas/Metalines detales ir projektavimas/Nuotraukos (Surinkto)/Uzvedimo ranka.png

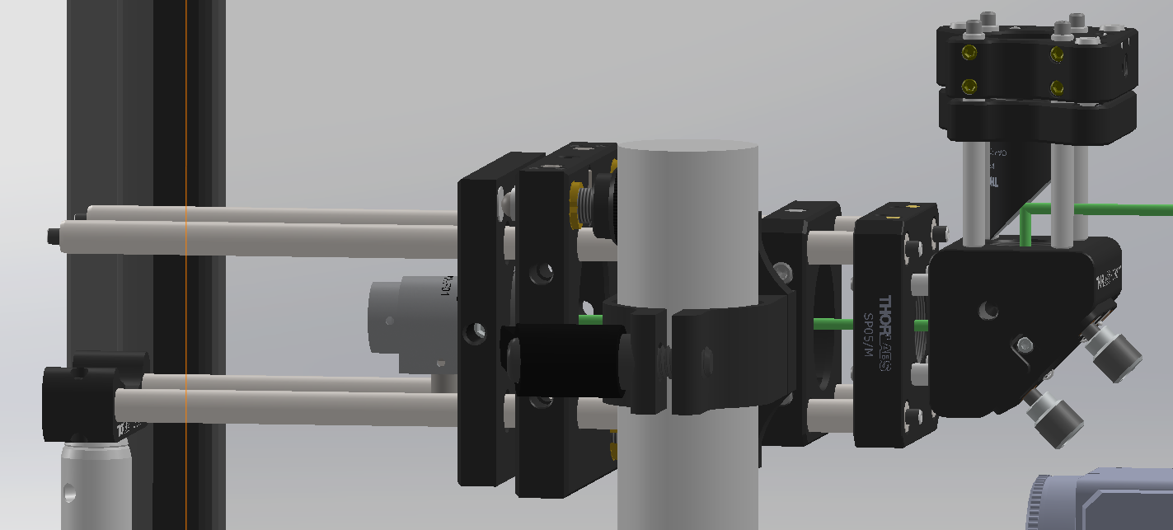
Inostartas/Metalines detales ir projektavimas/Nuotraukos (Surinkto)/Uzvedimo ranka.png
