JuliusJanusonis/MB/Inostartas/Metalines detales ir projektavimas/Nuotraukos (Surinkto)/Visas CAD.png

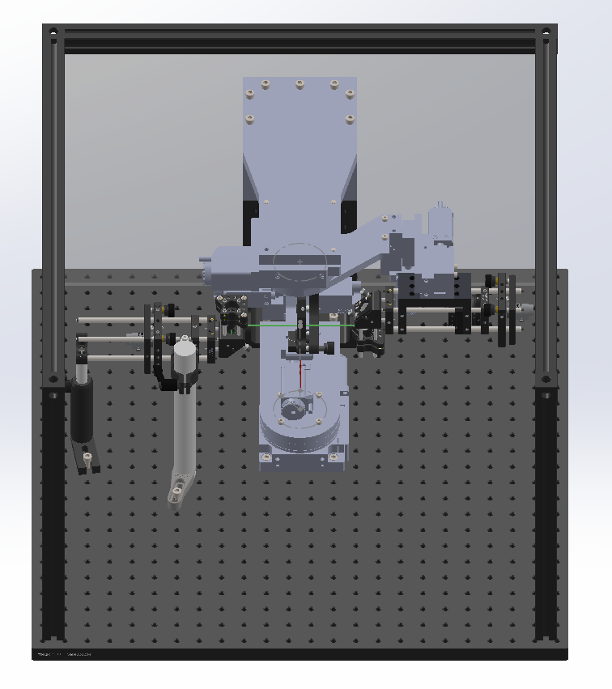
Inostartas/Metalines detales ir projektavimas/Nuotraukos (Surinkto)/Visas CAD.png
