JuliusJanusonis/MB/Inostartas/Metalines detales ir projektavimas/Nuotraukos (Surinkto)/Visas enclosure.png

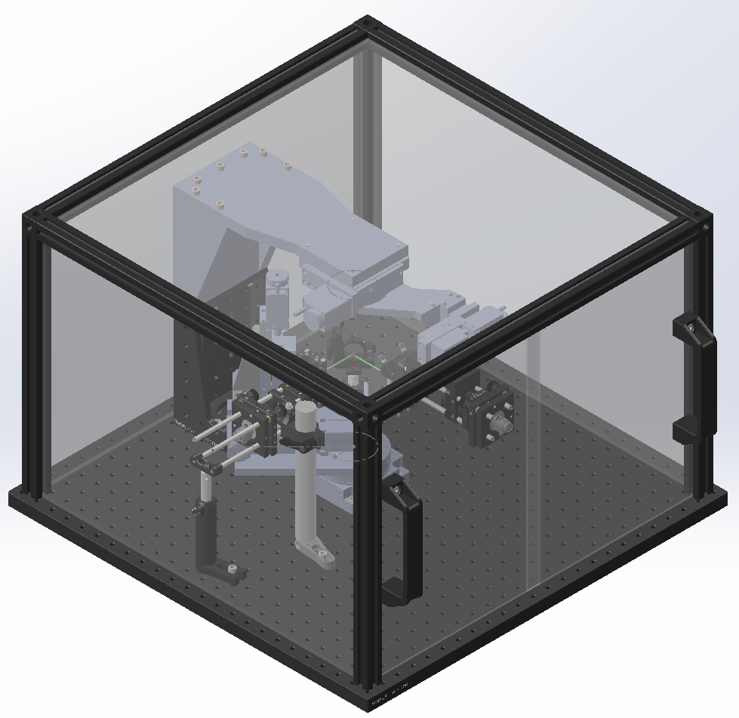
Inostartas/Metalines detales ir projektavimas/Nuotraukos (Surinkto)/Visas enclosure.png
