JuliusJanusonis/MB/Inostartas/Metalines detales ir projektavimas/Nuotraukos (Surinkto)/Visas sonu CAD.png

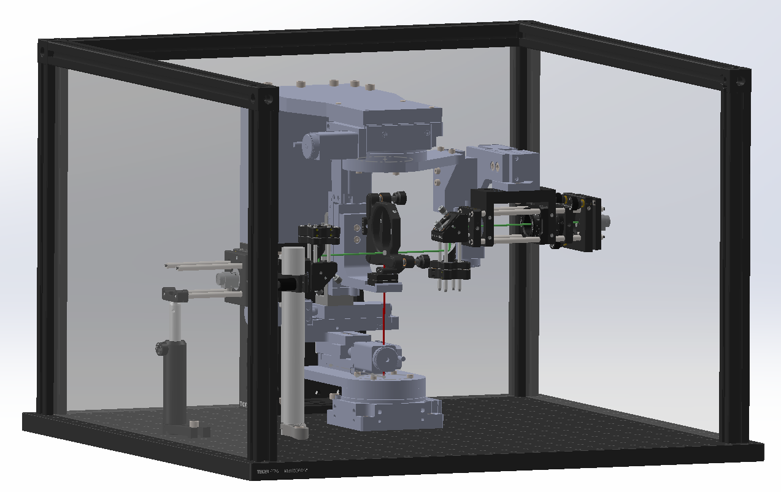
Inostartas/Metalines detales ir projektavimas/Nuotraukos (Surinkto)/Visas sonu CAD.png
