JuliusJanusonis/MB/Inostartas/Metalines detales ir projektavimas/Optikos dezute/optikos dezute 2inch.bmp

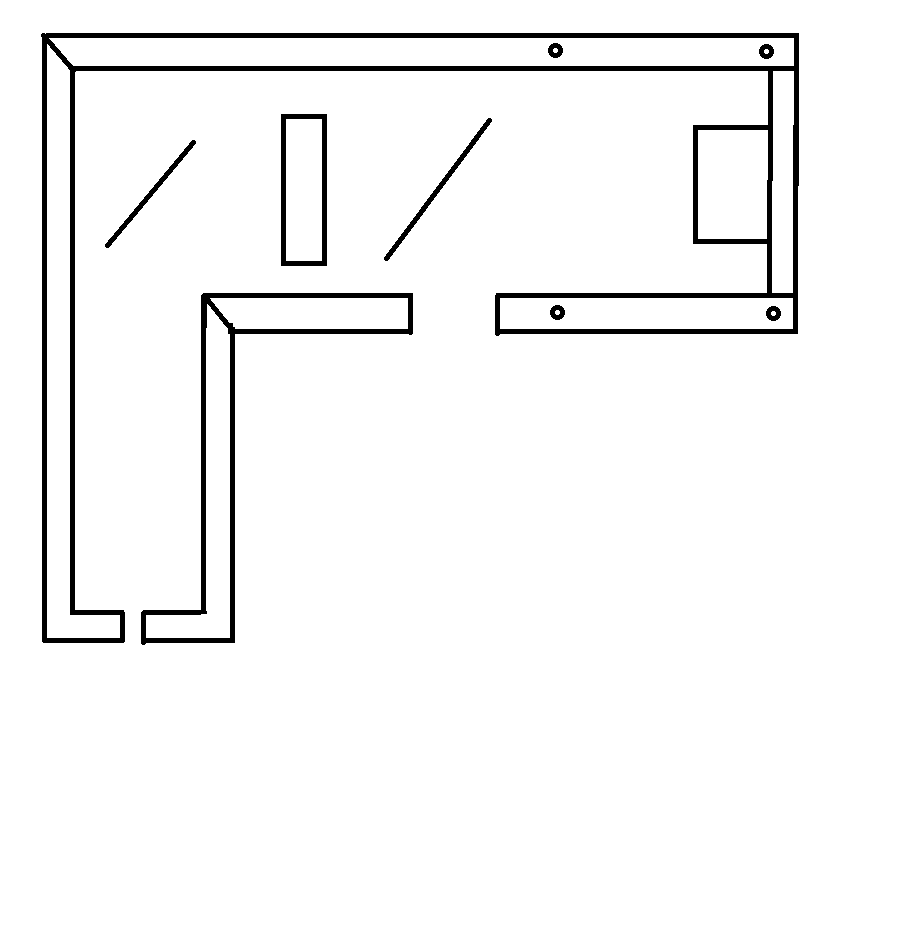
Inostartas/Metalines detales ir projektavimas/Optikos dezute/optikos dezute 2inch.bmp
