JuliusJanusonis/MB/Inostartas/Metalines detales ir projektavimas/Optikos dezute/optikos dezute minimali.bmp

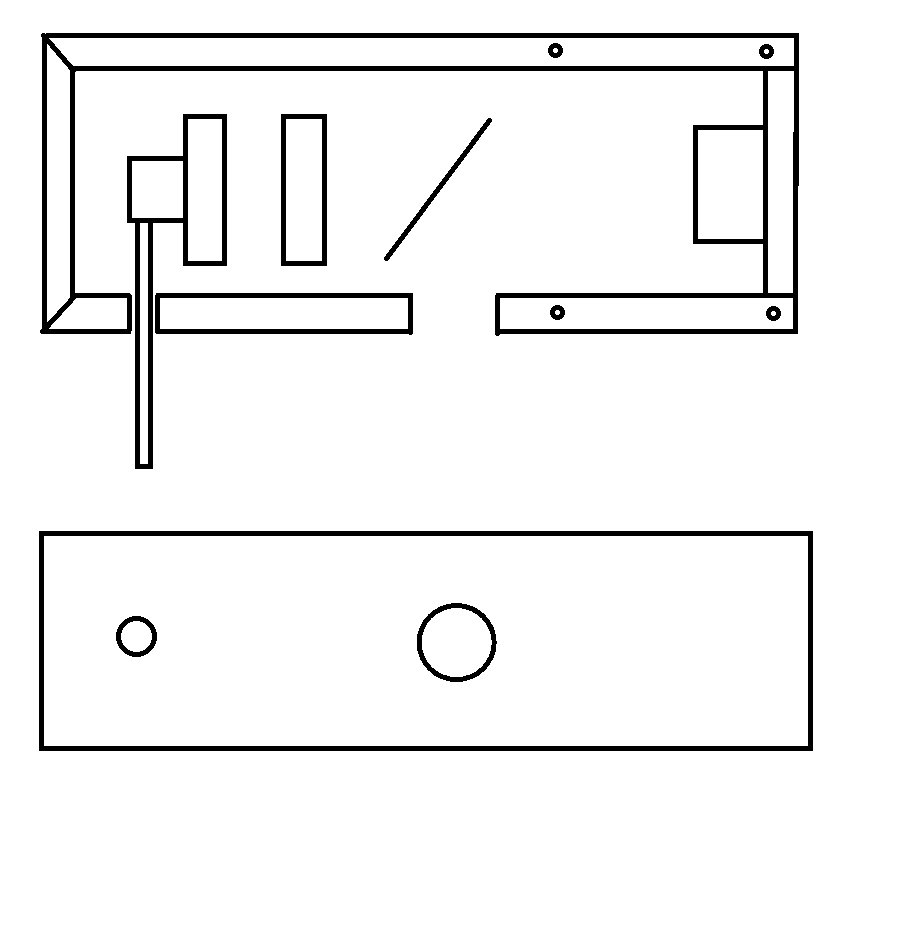
Inostartas/Metalines detales ir projektavimas/Optikos dezute/optikos dezute minimali.bmp
