JuliusJanusonis/MB/Inostartas/nuotraukos prezentacijai/20230321_184638.jpg

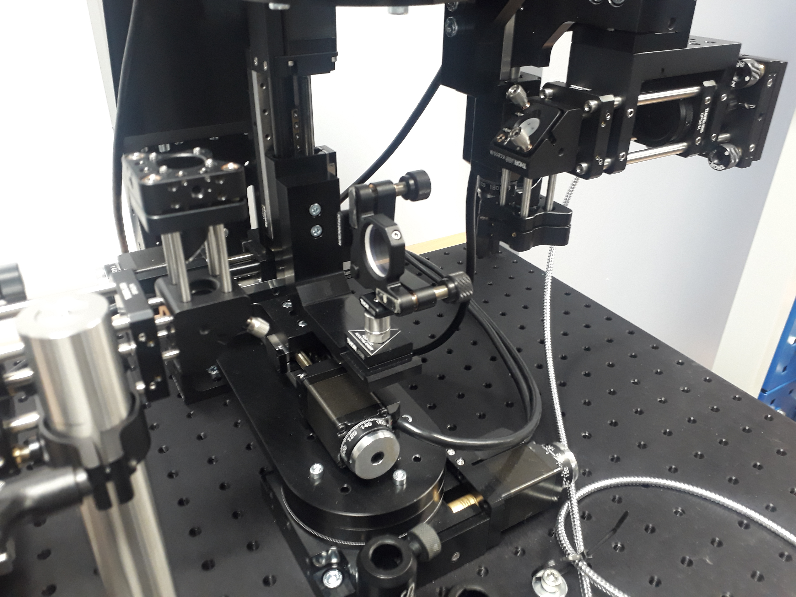
Inostartas/nuotraukos prezentacijai/20230321_184638.jpg
