JuliusJanusonis/MB/Inostartas/nuotraukos prezentacijai/20230321_184706.jpg

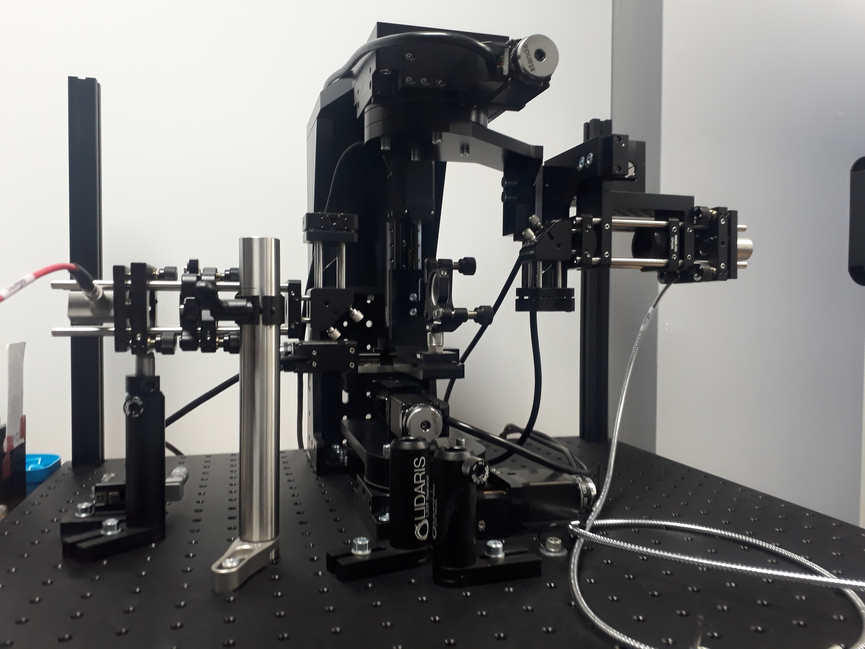
Inostartas/nuotraukos prezentacijai/20230321_184706.jpg
