JuliusJanusonis/MB/Inostartas/nuotraukos prezentacijai/20230321_184801.jpg

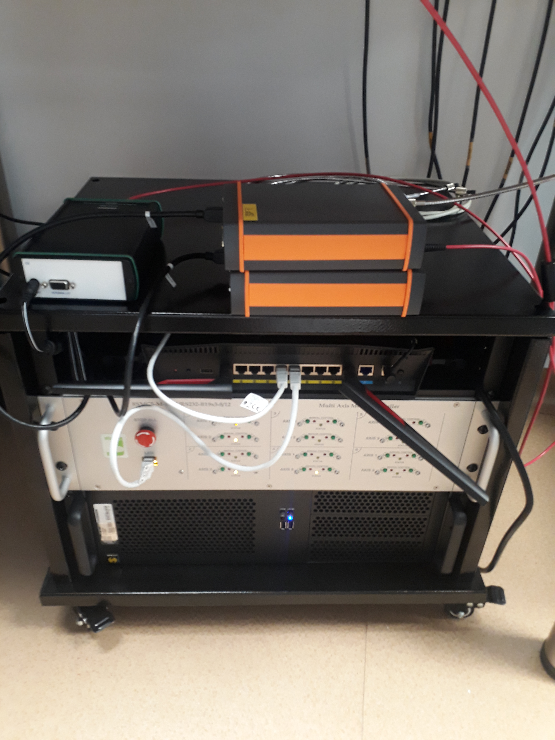
Inostartas/nuotraukos prezentacijai/20230321_184801.jpg
