JuliusJanusonis/MB/Inostartas/Screenshot 2023-03-31 165729.png

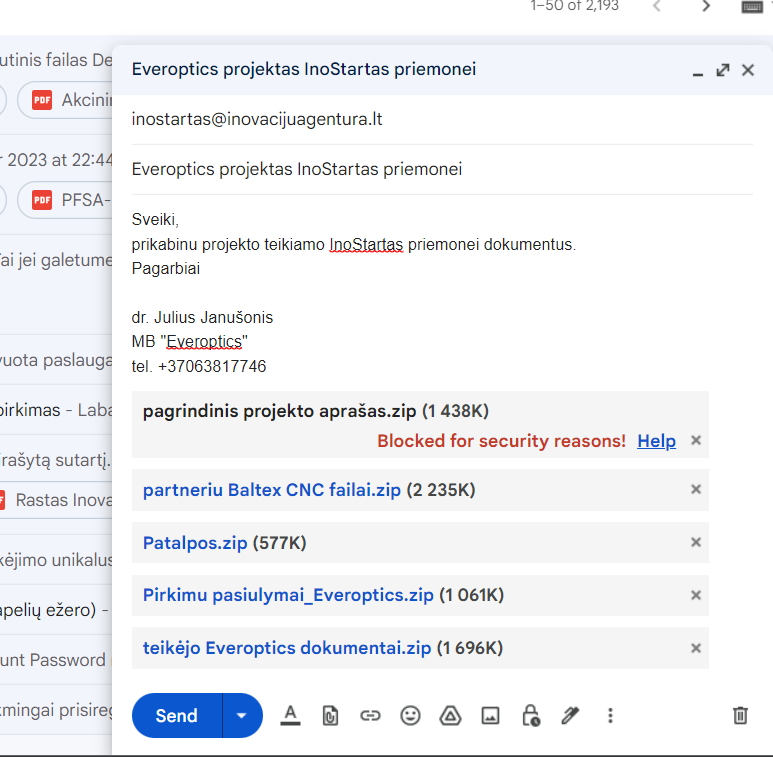
Inostartas/Screenshot 2023-03-31 165729.png
