JuliusJanusonis/MB/Inostartas/Metalines detales ir projektavimas/Spectral mapper prices.xlsx

 | Spektroskopo dalis
 |  |  | Nuolaida
AvaSpec-ULS2048CL-EVO-UA-50 | Ultra-low stray light fiber optic UV/VIS/NIR spectrometer, 2048 pixel CMOS detector, grating UA (200-1100 nm), slit 50, OSC-UA, DCL-UV/VIS-200, USB3 powered, high speed USB3 and ETH interface. Includes Avasoft-Full. | 2679.00 | 5% | 2545.05
AvaSpec-ULS2048CL-EVO-UA-50 | Ultra-low stray light fiber optic UV/VIS/NIR spectrometer, 2048 pixel CMOS detector, grating UA (200-1100 nm), slit 50, OSC-UA, DCL-UV/VIS-200, USB3 powered, high speed USB3 and ETH interface. Includes Avasoft-Full. | 2679.00 | 5% | 2545.05 |  |  | VISKO BENDRA SUMA | 24144.30
AvaSoft-Thinfilm | Thinfilm software module for the AvaThinfilm system, to be ordered with AvaSoft-Full | 110.90 | 10% | 99.81
FCR-7UVIR200-2-ME | Reflection probe, 6 illumination, 1 read fiber, 200 µm fibers with flexible metal sheathing, broadband UV/VIS/NIR (200-2500 nm) | 530.60 | 5% | 504.07 |  |  | Kas dar neįvertinta: | Optika: Lešiai, poliarizatoriai, veidrodžiai
FC-UVIR400-2-ME | Fiber cable, 400 µm fiber, broadband UV/VIS/NIR (200-2500 nm), 2 m, SMA terminated | 179.50 | 5% | 170.53 |  |  |  | Mechanika: Poliarizatoriaus holderis, pora spaceriu, plexi glass ir visur nėra varžtų
 |  |  |  | 0.00 |  |  | Spaceriai | https://www.baselabtools.com/127mm-Post-Metric_c_185.html
Thinfilm-Standard | 3 Thinfilm Si-SiO2 wafer parts in housing, one reference and 2 samples, including calibration sheet | 325.30 | 5% | 309.03
AvaLight-DHc | Compact Deuterium-Halogen light source 200-2500 nm with TTL-shutter, needs PS-12V/1.0A (not included) | 1737.10 | 0% | 1737.10
PS-12V/1.0A | Power supply 100-240VAC/12VDC, minimal 1.0A, necessary for AvaLight-XE, AvaLight-DHc, AvaLight-LED, AvaLight-CAL, AvaSpec-EVO (ETH mode) europlug standard, otherwise please specify -UK, -US, -AUS | 43.50 | 0% | 43.50
 |  | 8284.90 | Bendra suma | 7954.14
Standa
Device | Description | Link | Quantity | Price | Discount | Final price
8MT30-50 - Narrow Motorized Translation Stages | 50 mm travel range. Designed to operate in Z plane with motor facing up or down. | https://www.standa.lt/products/catalog/motorised_positioners?item=348&prod=narrow_motorized_translation_stages | 3 |  |  | 1654.95
8MT173 - Motorized Translation Stages | 10, 20, 25, 30 mm travel range. Compact design with narrow profile. Resolution of 1.25 µm | https://www.standa.lt/products/catalog/motorised_positioners?item=59&prod=motorized_translation_stages | 2 |  |  | 746.3
8MR190-2-28 - Motorized Rotation Stage | 360°rotation. 50.8mm aperture in the middle. Zero backlash. 4.5arcsec resolution (1/8 step) | https://www.standa.lt/products/catalog/motorised_positioners?item=244&prod=motorized_rotation_stage | 2 |  |  | 1951.6
2AB173-20-50 - Angle Bracket | Rigid, 90° angled mounting plates. Is used to transform "horizontal" 8MT30-50 translators into vertical ones. | https://www.standa.lt/products/catalog/brackets_rails?item=412 | 1 |  |  | 41.65
8SMC4-ETHERNET / RS232-B19 - Multi-Axis Motion Controller / Driver |  |  | 1 |  |  | 5742
 |  |  |  |  | Bendra suma | 10136.5
 | Custom detalės
Ekstremalė
Poz. Art. Nr. | Pavadinimas | Kiekis, vnt. | Kaina, vnt. |  | Suma |  | PAKEISTA ROTACINIO JUNGTIS VIRSUJE 2/3
1 LID2021012 |  | 1.00 | 219.29 |  | 219.29
2 LID2021013 |  | 1.00 | 87.48 |  | 87.48 |  | REIKES PAKEIST LAIKIKLIU L FORMA
3 LID2021014 |  | 1.00 | 145.40 |  | 145.40
4 LID2021015 |  | 1.00 | 106.46 |  | 106.46 |  | PAKEISTO ALKUNĖS SKYLUTĖS (prideta dar 1 skylute PADARYTA KAD ROTACINI GALETU PRISIJUNGTI IS VISU PUSIU)
5 LID2021016 |  | 2.00 | 30.06 |  | 60.12
6 LID2021017 |  | 1.00 | 61.18 |  | 61.18
7 LID2021018 |  | 1.00 | 58.64 |  | 58.64
8 LID2021019 |  | 1.00 | 50.66 |  | 50.66
9 LID2021020 |  | 1.00 | 41.65 |  | 41.65
10 LID2021021 |  | 1.00 | 167.25 |  | 167.25
11 LID2021022 |  | 1.00 | 58.96 |  | 58.96
 |  |  |  | Bendra suma | 1057.09
Užvedimo ranka
 | Naudojant parabolinius veidrodžius | Kiekis |  | Vnt. Kaina | Galutinė kaina
TR100/M - Ø12.7 mm Optical Post, SS, M4 Setscrew, M6 Tap, L = 100 mm |  | 1 |  | 5.5 | 5.5
UPH100/M - Ø12.7 mm Universal Post Holder, Spring-Loaded Locking Thumbscrew, L = 100 mm |  | 1 |  | 32.96 | 32.96
CP02B - 30 mm Cage Mounting Bracket |  | 1 |  | 13.58 | 13.58
3UTC-1 - Universal Fork Clamp | Standa | 1 |  | 15 | 15
3MP25 - Fixed Pedestal | Standa | 1 |  | 28 | 28
CH1030/M - 30 mm Cage Clamp for Ø25.0 mm Posts |  | 1 |  | 79.61 | 79.61
RC02SMA-F01 - UV-Enhanced Aluminum Reflective Collimator, 250 - 450 nm, Ø2 mm Beam, SMA905 |  | 1 |  | 878.4 | 878.4
KC1/M - Kinematic 30 mm-Cage-Compatible Mount for Ø1" Optic, Metric |  | 1 |  | 90.25 | 90.25
SP05/M - 30 mm to 16 mm Cage Adapter Plate, Metric |  | 1 |  | 31.53 | 31.53
ER6-P4 - Cage Assembly Rod, 6" Long, Ø6 mm, 4 Pack |  | 1 |  | 30.78 | 30.78
SR05-P4 - Compact Cage Assembly Rod, 1/2" Long, Ø4 mm, 4 Pack |  | 1 |  | 21.68 | 21.68
KCB05/M - Right-Angle Kinematic Mirror Mount, 16 mm Cage System and SM05 Compatible, M3 and M4 Mounting Holes |  | 1 |  | 149.48 | 149.48
1/2" Mirror | PF05-03-F01 - Ø1/2" UV-Enhanced Aluminum Mirror | 1 |  | 30.75 | 30.75
SR1.5-P4 - Compact Cage Assembly Rod, 1.5" Long, Ø4 mm, 4 Pack |  | 1 |  | 25.61 | 25.61
MPD029-F01 - Ø1/2" 90° Off-Axis Parabolic Mirror, UV-Enhanced Aluminum, RFL = 2" |  | 1 |  | 135.74 | 135.74
KC05-T/M - SM05 Threaded Kinematic Cage Mount, Ø1/2" Optics, Metric |  | 1 |  | 86.55 | 86.55
 |  |  |  | Bendra suma | 1655.42
Surinkimo ranka
 | Surenkant su lešiu | Kiekis |  | Vnt. Kaina | Galutinė kaina
1'' Lens | LA4725 - f = 75.3 mm, Ø1" UV Fused Silica Plano-Convex Lens, Uncoated | 1 |  | 89.76 | 89.76
KC1/M - Kinematic 30 mm-Cage-Compatible Mount for Ø1" Optic, Metric |  | 2 |  | 90.25 | 180.5
SM1D12CZ - SM1 Graduated Ring-Actuated Zero Aperture Iris Diaphragm, Ø12 mm Max Aperture |  | 1 |  | 113.12 | 113.12
CP33/M - SM1-Threaded 30 mm Cage Plate, 0.35" Thick, 2 Retaining Rings, M4 Tap |  | 1 |  | 15.35 | 15.35
The CBB1(/M) Cage System U-Bench provides a tapped mounting surface within a standard 30 mm cage assembly or a Ø1" lens tube setup |  | 1 |  | 74.27 | 74.27
Poliarizatorius |  |  |  |  | 0
Poliarizatoriaus holderis |  |  |  |  | 0
CRM1T/M - Cage Rotation Mount for Ø1" Optics, SM1 Threaded, M4 Tap |  | 1 |  | 79.44 | 79.44
RC02SMA-F01 - UV-Enhanced Aluminum Reflective Collimator, 250 - 450 nm, Ø2 mm Beam, SMA905 |  | 1 |  | 878.4 | 878.4
ER6-P4 - Cage Assembly Rod, 6" Long, Ø6 mm, 4 Pack |  | 1 |  | 30.78 | 30.78
ER2-P4 - Cage Assembly Rod, 2" Long, Ø6 mm, 4 Pack |  | 1 |  | 21.71 | 21.71
 |  |  |  | Bendra suma | 1483.33
 | Surenkant su paraboliu veidrodžiu PAPILDOMAI: | Kiekis |  | Vnt. Kaina | Galutinė kaina
SP05/M - 30 mm to 16 mm Cage Adapter Plate, Metric |  | 1 |  | 31.53 | 31.53
SR1.5-P4 - Compact Cage Assembly Rod, 1.5" Long, Ø4 mm, 4 Pack |  | 1 |  | 25.61 | 25.61
KCB05/M - Right-Angle Kinematic Mirror Mount, 16 mm Cage System and SM05 Compatible, M3 and M4 Mounting Holes |  | 1 |  | 149.48 | 149.48
1/2" Mirror | PF05-03-F01 - Ø1/2" UV-Enhanced Aluminum Mirror | 1 |  | 30.75 | 30.75
SR3-P4 - Compact Cage Assembly Rod, 3" Long, Ø4 mm, 4 Pack |  | 1 |  | 29.53 | 29.53
MPD029-F01 - Ø1/2" 90° Off-Axis Parabolic Mirror, UV-Enhanced Aluminum, RFL = 2" |  | 1 |  | 135.74 | 135.74
KC05-T/M - SM05 Threaded Kinematic Cage Mount, Ø1/2" Optics, Metric |  | 1 |  | 86.55 | 86.55
 |  |  |  | Bendra suma | 489.19
 | Bandinių laikikliai | Kiekis |  | Vnt. Kaina | Galutinė kaina
KB25/M - Complete 25 mm x 25 mm Kinematic Base, Top and Bottom Plates, M4 Counterbores |  | 1 |  | 70.22 | 70.22
KBT25/M - Top Plate Only of the KB25/M Kinematic Base, M4 Counterbore |  | 2 |  | 35.58 | 71.16
KM200CP/M - Kinematic Mirror Mount for Ø2" Optics with Post-Centered Front Plate, M4 Taps |  | 1 |  | 99.34 | 99.34
KM100CP/M - Kinematic Mirror Mount for Ø1" Optics with Post-Centered Front Plate, M4 Taps |  | 1 |  | 69.35 | 69.35
KM05CP/M - Kinematic Mirror Mount for Ø1/2" Optics with Post-Centered Front Plate, M4 Taps |  | 1 |  | 73.77 | 73.77
Spaceriai 1" ir 1/2" | Nedaug, apie max 10-15 euru | 1 |  | 15 | 15
 |  |  |  | Bendra suma | 398.84
 | Breadbord'as ir enclosure | Kiekis |  | Vnt. Kaina | Galutinė kaina
MBH6060/M - Aluminum Breadboard, 600 mm x 600 mm x 19.05 mm, M6 Taps |  | 1 |  | 641.83 | 641.83
XE25L525/M - 25 mm Square Construction Rail, 525 mm Long, M6 Taps |  | 4 |  | 25.33 | 101.32
XE25L375/M - 25 mm Square Construction Rail, 375 mm Long, M6 Taps |  | 4 |  | 18.99 | 75.96
RM1S - 1" Construction Cube with Slotted Corners, Three 1/4" (M6) Counterbored Holes |  | 4 |  | 19.08 | 76.32
BBH1 - Breadboard Lifting Handles, Reinforced Polymer (Set of 2) |  | 1 |  | 14.36 | 14.36
Plexi glass | Pasiūlymo dar nesiunčiau. Spėčiau, kad apie 60euru būtų | 1 |  | 60 | 60
 |  |  |  | Bendra suma | 969.79
https://www.skytech.lt/np5104-netrack-np5104-server-case-microatxatxeatx-482-177-530mm-rack-p-277378.html | Kompo rack
https://www.thomann.de/gb/millenium_ir_2012.htm | Rack case
