JuliusJanusonis/MB/Inostartas/Metalines detales ir projektavimas/Custom detaliu failai ir sarasas 2021-12-13/LID2021017.STEP

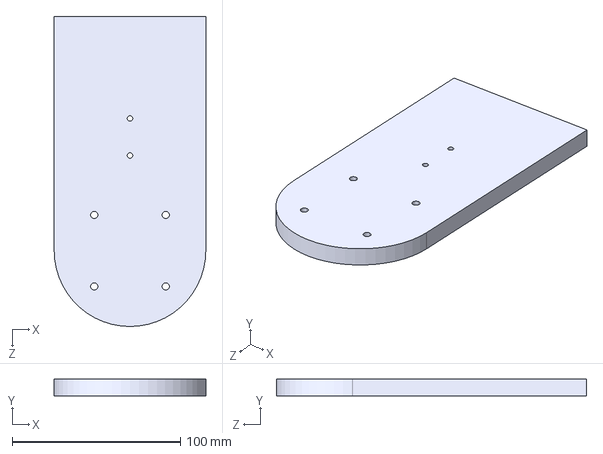
[picture p57: CAD file, 2023-04-04]
Inostartas/Metalines detales ir projektavimas/Custom detaliu failai ir sarasas 2021-12-13/LID2021017.STEP
90.0 x 10.0 x 184.0 mm
