JuliusJanusonis/MB/Inostartas/Metalines detales ir projektavimas/Custom detaliu failai ir sarasas 2021-12-13/LID2021019.STEP

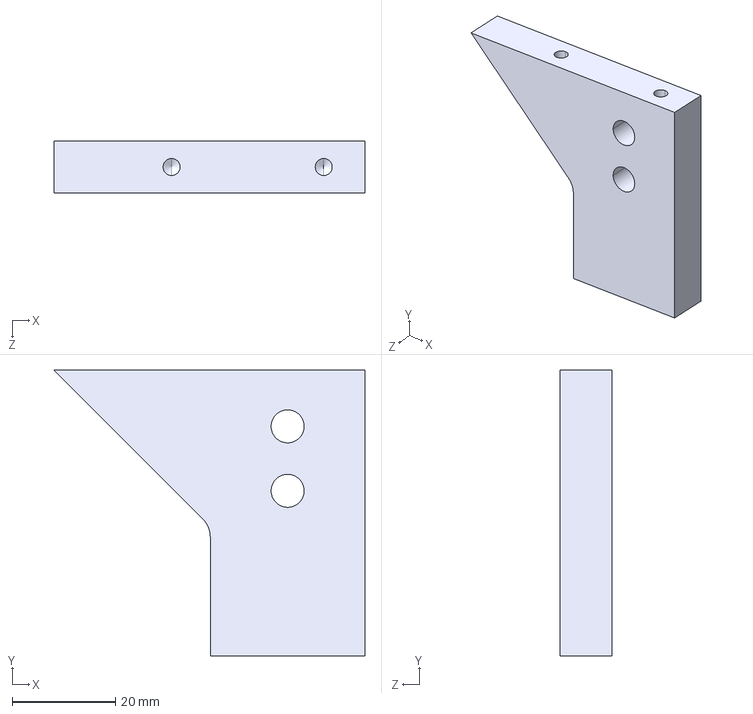
[picture p58: CAD file, 2023-04-04]
Inostartas/Metalines detales ir projektavimas/Custom detaliu failai ir sarasas 2021-12-13/LID2021019.STEP
60.3 x 55.4 x 10.0 mm
