JuliusJanusonis/MB/Inostartas/Metalines detales ir projektavimas/Custom detaliu failai ir sarasas 2021-12-13/LID2021014.STEP

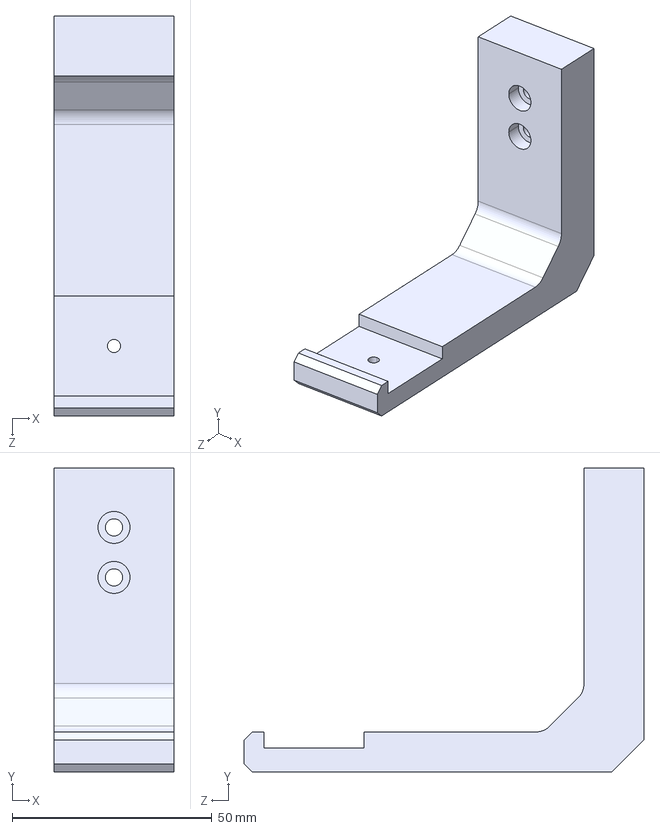
[picture p59: CAD file, 2023-04-04]
Inostartas/Metalines detales ir projektavimas/Custom detaliu failai ir sarasas 2021-12-13/LID2021014.STEP
30.0 x 76.0 x 100.0 mm
