JuliusJanusonis/MB/Inostartas/Metalines detales ir projektavimas/Custom detaliu failai ir sarasas 2021-12-13/LID2021015.STEP

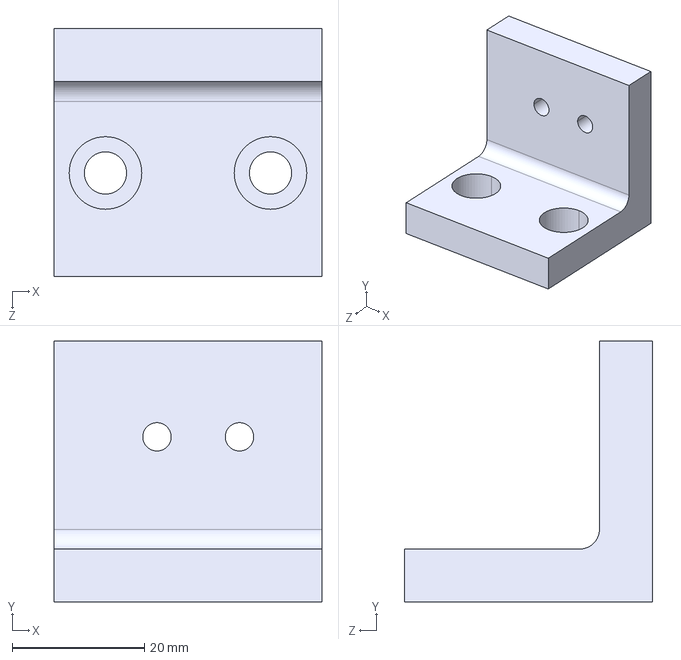
[picture p60: CAD file, 2023-04-04]
Inostartas/Metalines detales ir projektavimas/Custom detaliu failai ir sarasas 2021-12-13/LID2021015.STEP
40.6 x 39.5 x 37.5 mm
