JuliusJanusonis/MB/Inostartas/Metalines detales ir projektavimas/Custom detaliu failai ir sarasas 2021-12-13/LID2021020.STEP

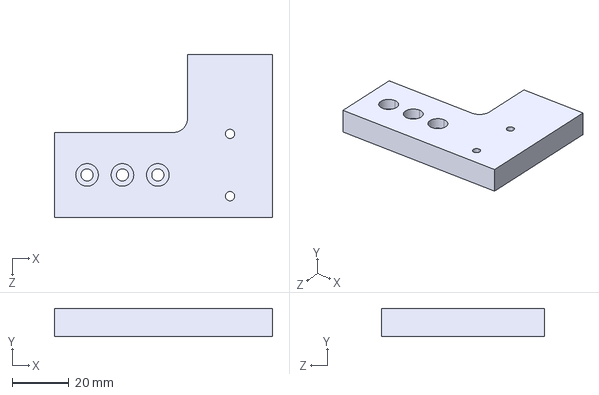
[picture p61: CAD file, 2023-04-04]
Inostartas/Metalines detales ir projektavimas/Custom detaliu failai ir sarasas 2021-12-13/LID2021020.STEP
77.0 x 10.0 x 57.5 mm
