JuliusJanusonis/MB/(list of files, cad)

Other CAD files:
Inostartas/Metalines detales ir projektavimas/Custom detaliu PDF ir DWG failai/LID2021014.DWG
Inostartas/Metalines detales ir projektavimas/Custom detaliu PDF ir DWG failai/LID2021016.DWG
Inostartas/Metalines detales ir projektavimas/Custom detaliu PDF ir DWG failai/LID2021019.DWG
Inostartas/Metalines detales ir projektavimas/Custom detaliu PDF ir DWG failai/LID2021022.DWG
Inostartas/Metalines detales ir projektavimas/Custom detaliu PDF ir DWG failai/LID2021015.DWG
Inostartas/Metalines detales ir projektavimas/Custom detaliu PDF ir DWG failai/LID2021020.DWG
Inostartas/Metalines detales ir projektavimas/Custom detaliu PDF ir DWG failai/LID2021017.DWG
Inostartas/Metalines detales ir projektavimas/Custom detaliu PDF ir DWG failai/LID2021021.DWG
Inostartas/Metalines detales ir projektavimas/Custom detaliu PDF ir DWG failai/LID2021018.DWG
Inostartas/Metalines detales ir projektavimas/Custom detaliu PDF ir DWG failai/LID2021013.DWG
Inostartas/Metalines detales ir projektavimas/Custom detaliu failai ir sarasas 2021-12-13/LID2021012.DWG
Inostartas/Metalines detales ir projektavimas/Custom detaliu failai ir sarasas 2021-12-13/LID2021013.DWG
Inostartas/Metalines detales ir projektavimas/Custom detaliu failai ir sarasas 2021-12-13/LID2021014.DWG
Inostartas/Metalines detales ir projektavimas/Custom detaliu failai ir sarasas 2021-12-13/LID2021015.DWG
Inostartas/Metalines detales ir projektavimas/Custom detaliu failai ir sarasas 2021-12-13/LID2021016.DWG
Inostartas/Metalines detales ir projektavimas/Custom detaliu failai ir sarasas 2021-12-13/LID2021017.DWG
Inostartas/Metalines detales ir projektavimas/Custom detaliu failai ir sarasas 2021-12-13/LID2021018.DWG
Inostartas/Metalines detales ir projektavimas/Custom detaliu failai ir sarasas 2021-12-13/LID2021018.STEP
Inostartas/Metalines detales ir projektavimas/Custom detaliu failai ir sarasas 2021-12-13/LID2021019.DWG
Inostartas/Metalines detales ir projektavimas/Custom detaliu failai ir sarasas 2021-12-13/LID2021020.DWG
Inostartas/Metalines detales ir projektavimas/Custom detaliu failai ir sarasas 2021-12-13/LID2021021.DWG
Inostartas/Metalines detales ir projektavimas/Custom detaliu failai ir sarasas 2021-12-13/LID2021021.STEP
Inostartas/Metalines detales ir projektavimas/Custom detaliu failai ir sarasas 2021-12-13/LID2021022.DWG
