JuliusJanusonis/MB/Inostartas/Dokumentai projekto padavimui/Projekto dokumentai (partneriai)/Platforma su objektyvu LMM15X-UVV.pdf

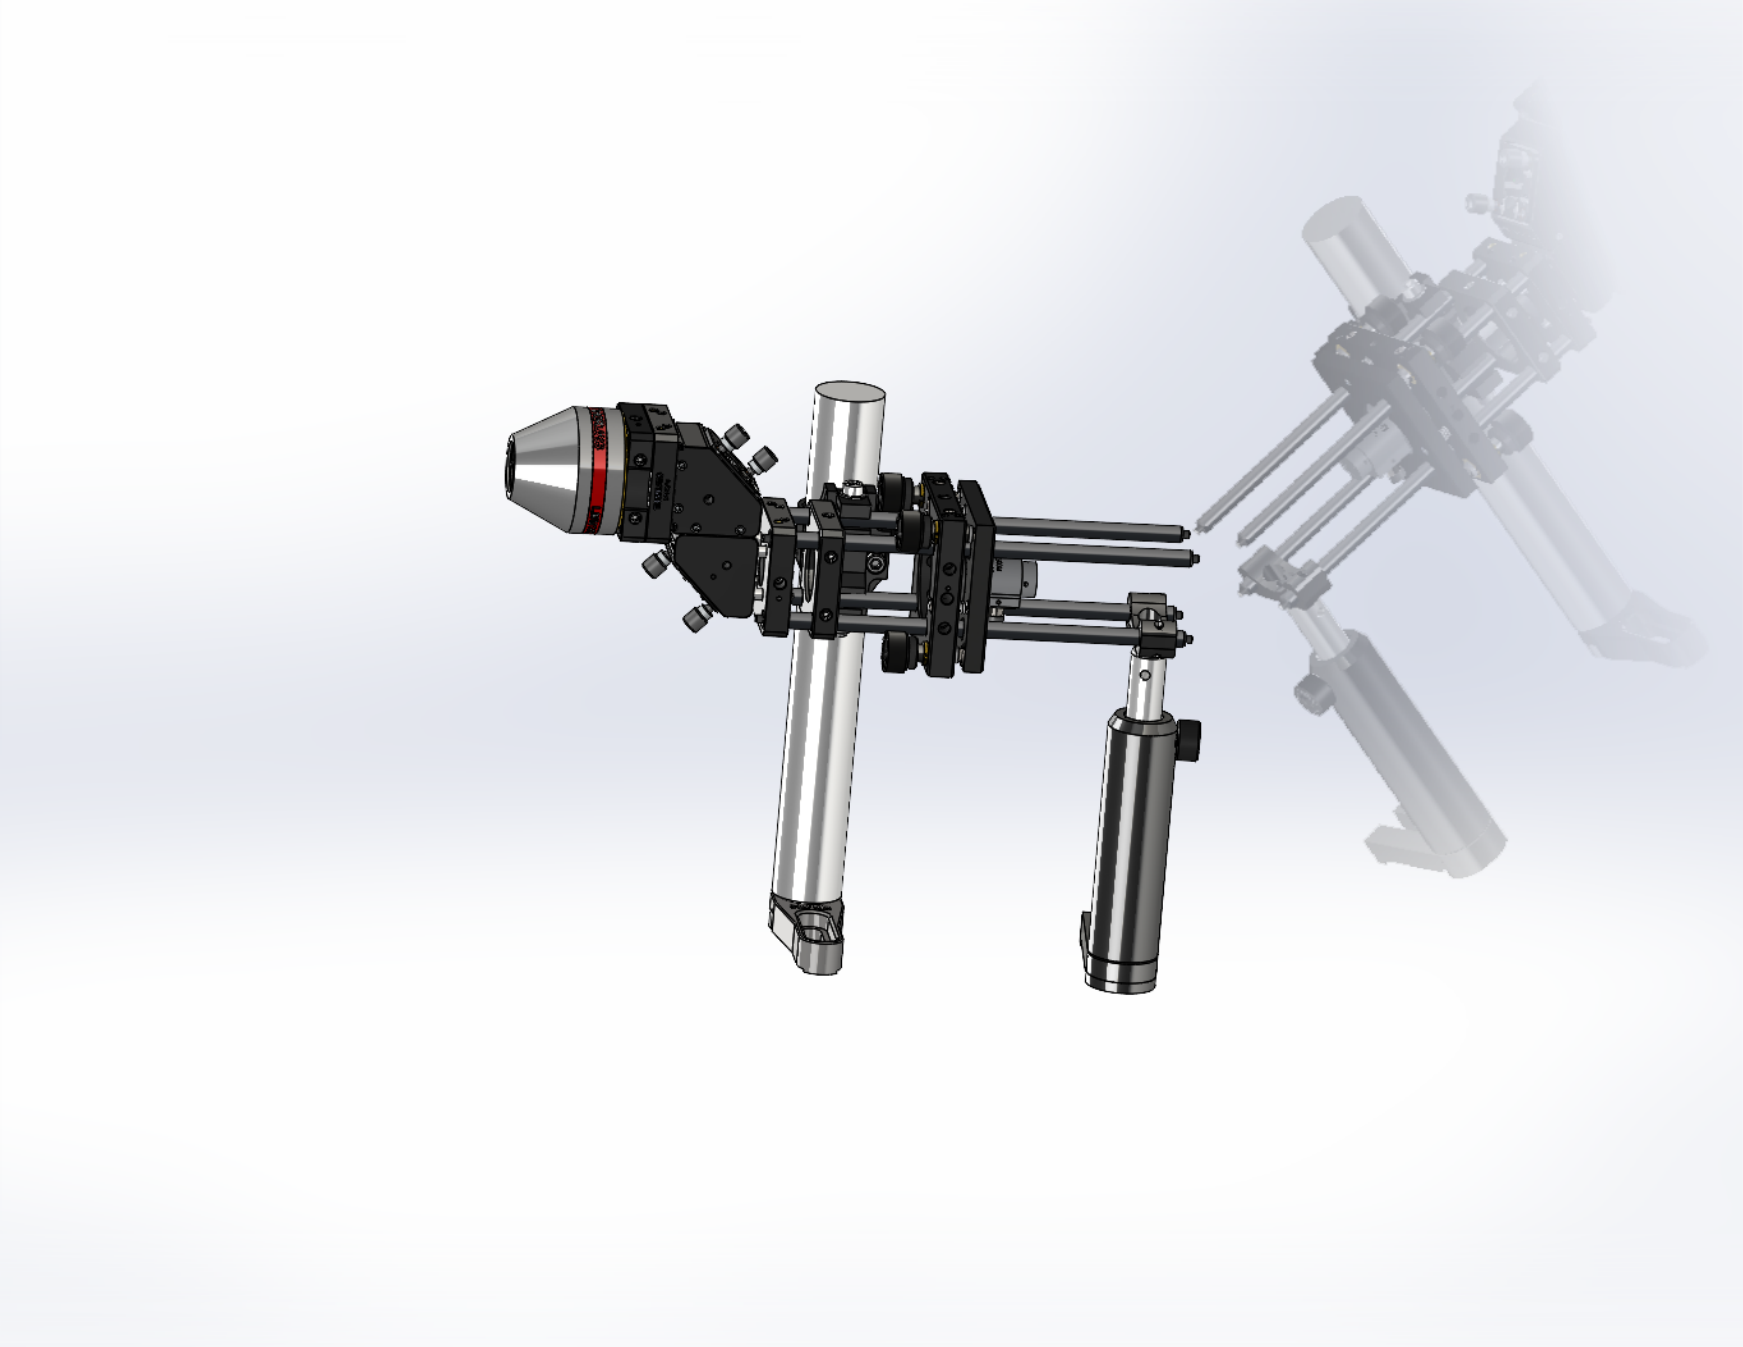
[picture p101: page 1]
