JuliusJanusonis/MB/Inostartas/Dokumentai projekto padavimui/Projekto dokumentai (partneriai)/Platforma su parabolic mirrors.pdf

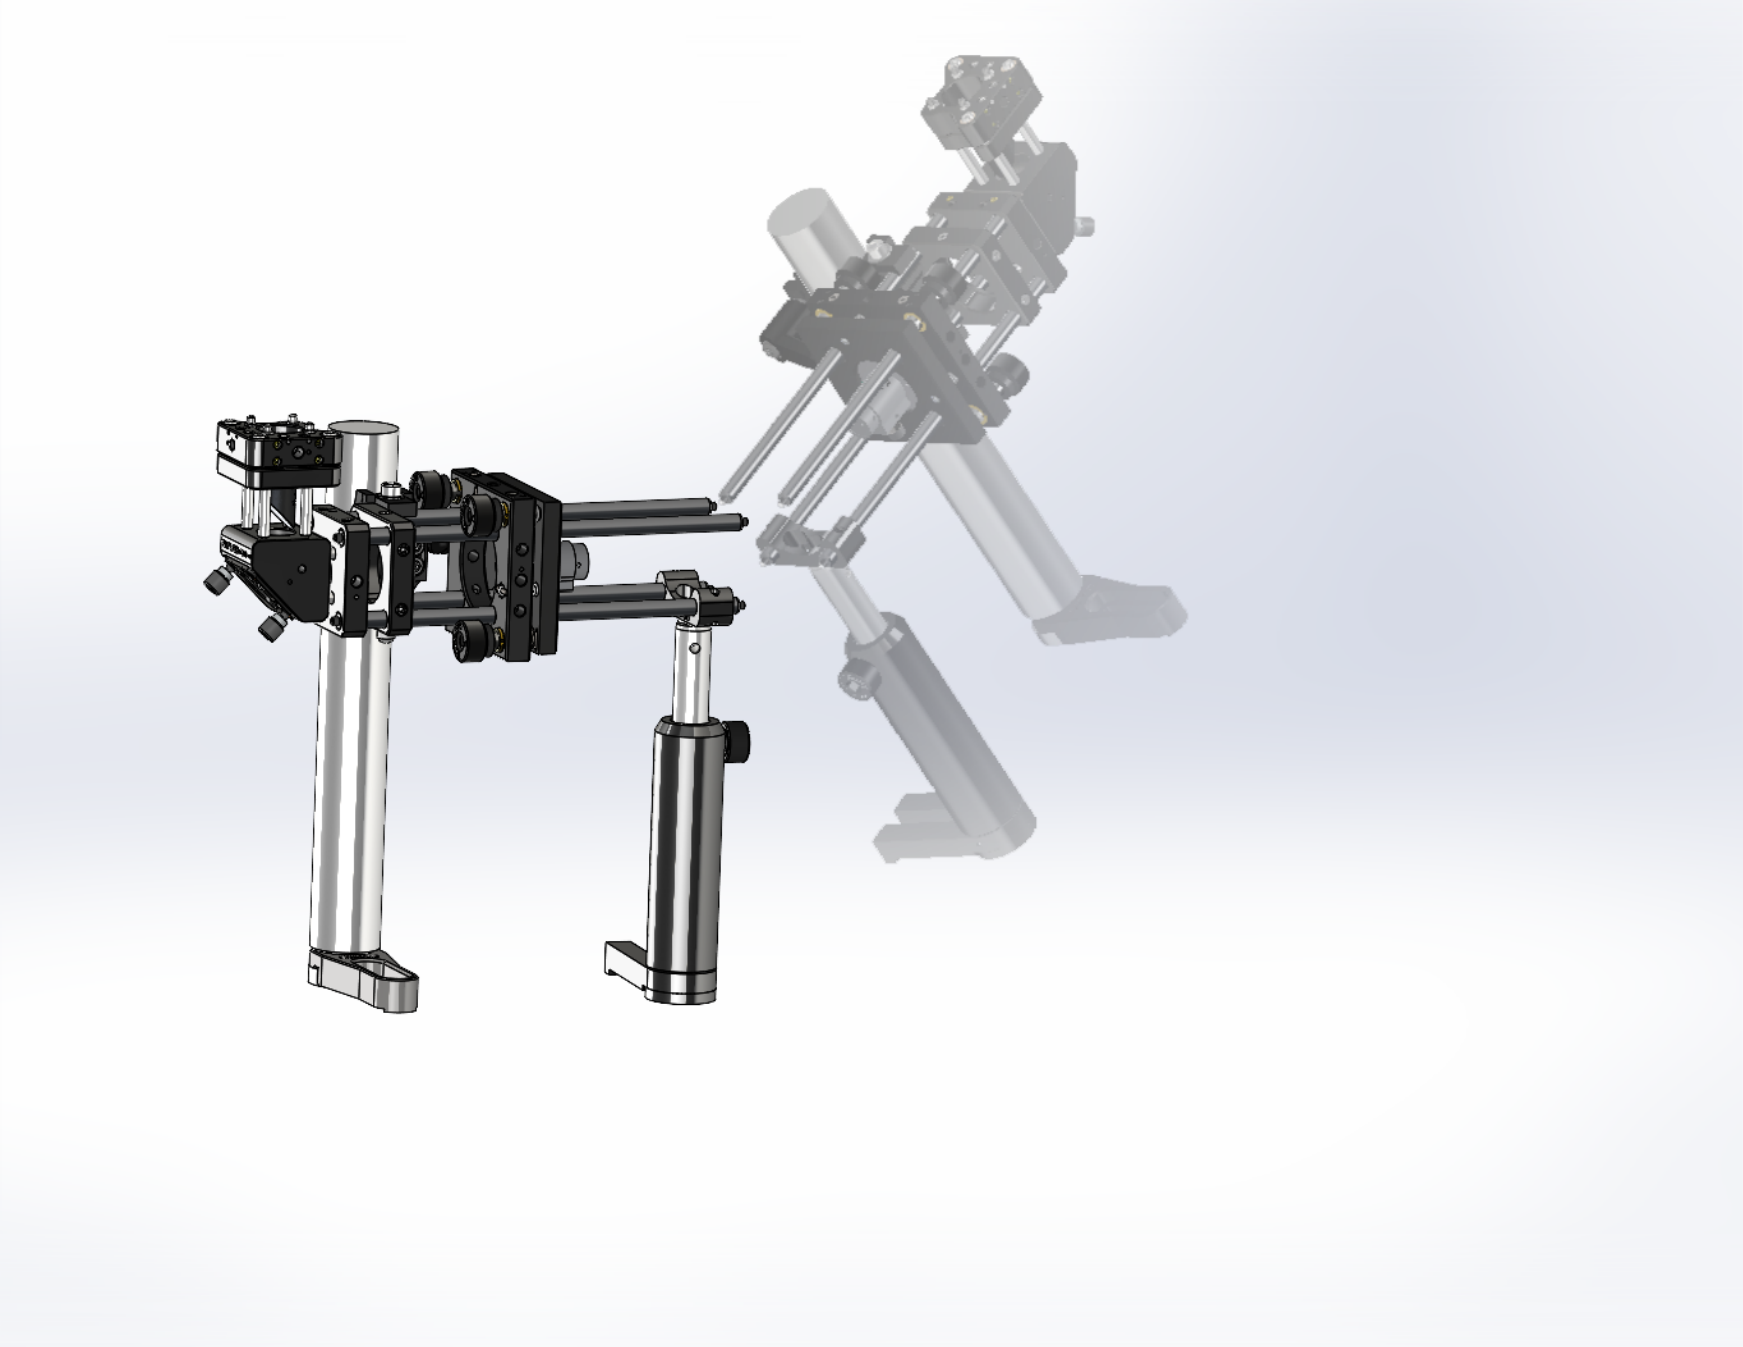
[picture p102: page 1]
