JuliusJanusonis/MB/Inostartas/Metalines detales ir projektavimas/Custom detaliu failai ir sarasas 2021-12-13/LID2021013.pdf

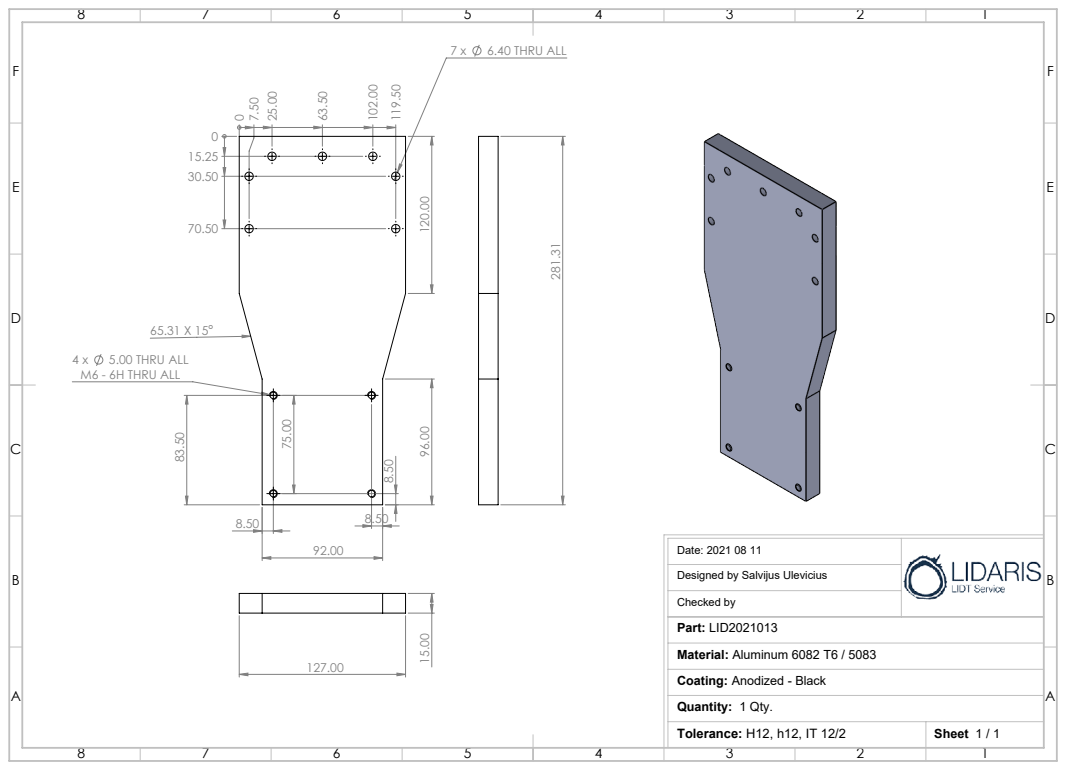
[picture p67: page 1]
6.40 THRU ALL; 5.00 THRU ALL; M6 - 6H THRU ALL; Tolerance: H12, h12, IT 12/2; Sheet 1 / 1

Date: 2021 08 11
Designed by Salvijus Ulevicius
Checked by
Part: LID2021013
Material: Aluminum 6082 T6 / 5083
Coating: Anodized - Black
Quantity: 1 Qty.
