JuliusJanusonis/MB/Inostartas/Metalines detales ir projektavimas/Custom detaliu failai ir sarasas 2021-12-13/LID2021015.pdf

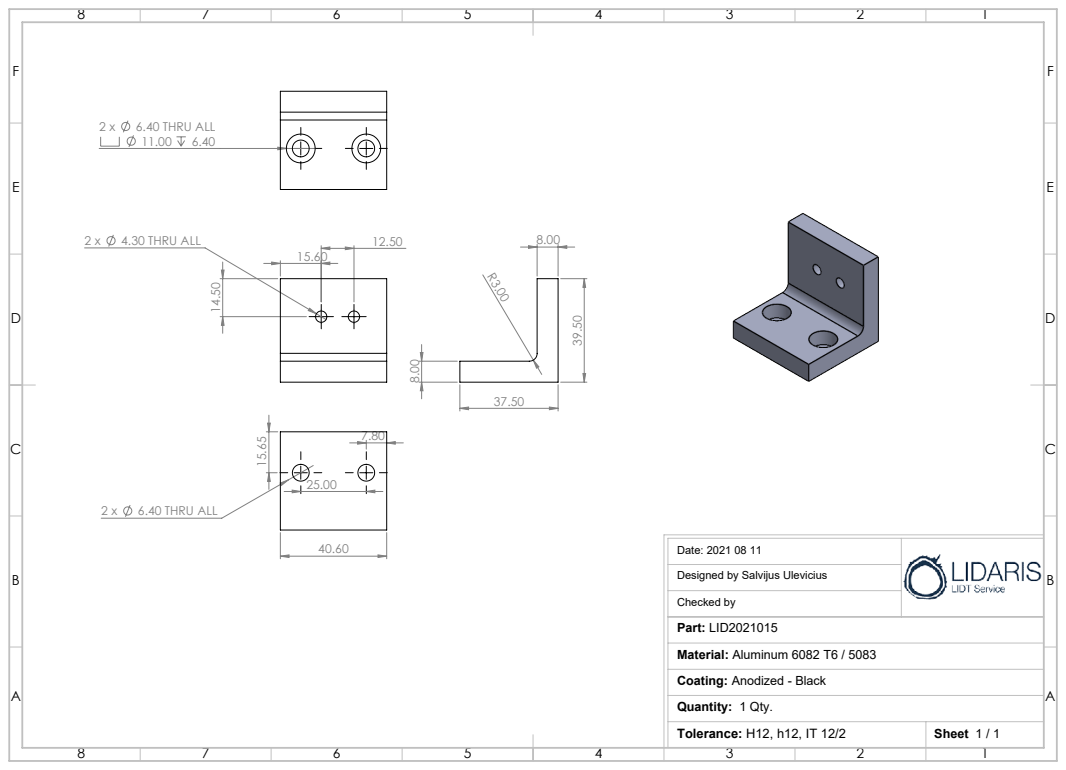
[picture p69: page 1]
4.30 THRU ALL; 6.40 THRU ALL; Tolerance: H12, h12, IT 12/2; Sheet 1 / 1

Date: 2021 08 11
Designed by Salvijus Ulevicius
Checked by
Part: LID2021015
Material: Aluminum 6082 T6 / 5083
Coating: Anodized - Black
Quantity: 1 Qty.
