JuliusJanusonis/MB/Inostartas/Metalines detales ir projektavimas/Custom detaliu failai ir sarasas 2021-12-13/LID2021016.pdf

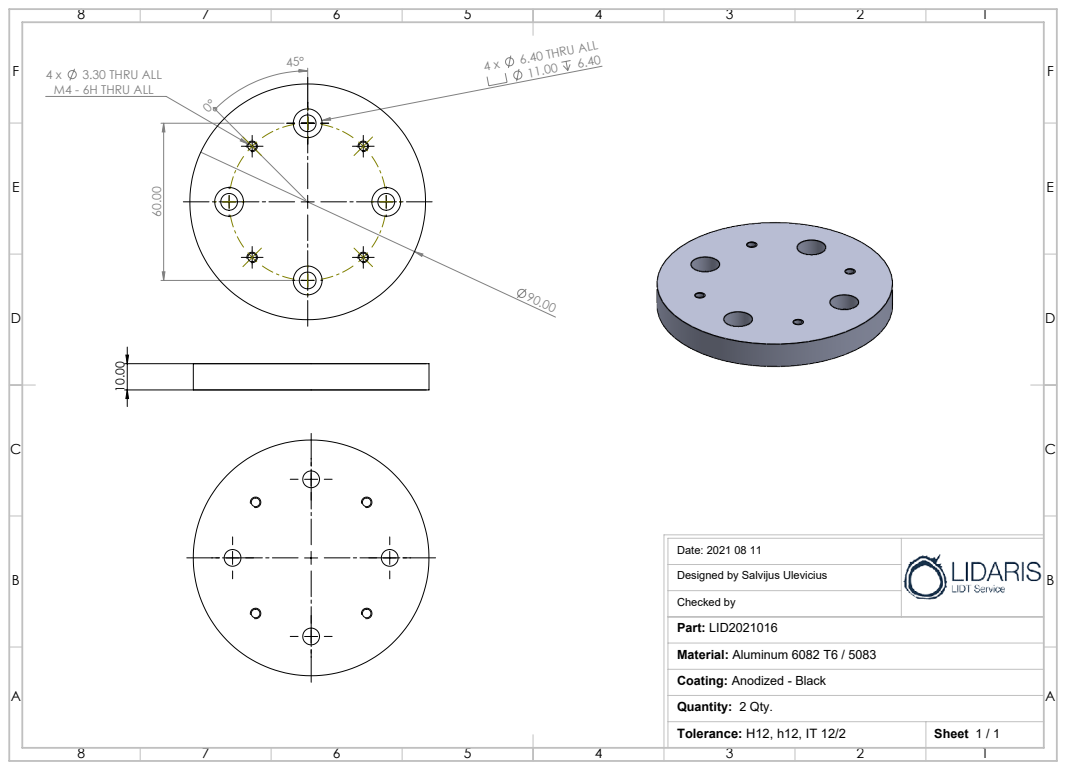
[picture p70: page 1]
4 x 6.40 THRU ALL 11.00 6.40; 3.30 THRU ALL; M4 - 6H THRU ALL; Tolerance: H12, h12, IT 12/2; Sheet 1 / 1

Date: 2021 08 11
Designed by Salvijus Ulevicius
Checked by
Part: LID2021016
Material: Aluminum 6082 T6 / 5083
Coating: Anodized - Black
Quantity: 2 Qty.
