JuliusJanusonis/MB/Patalpos/MB everoptics aprasymas ir verslo planas tech parkui.pdf

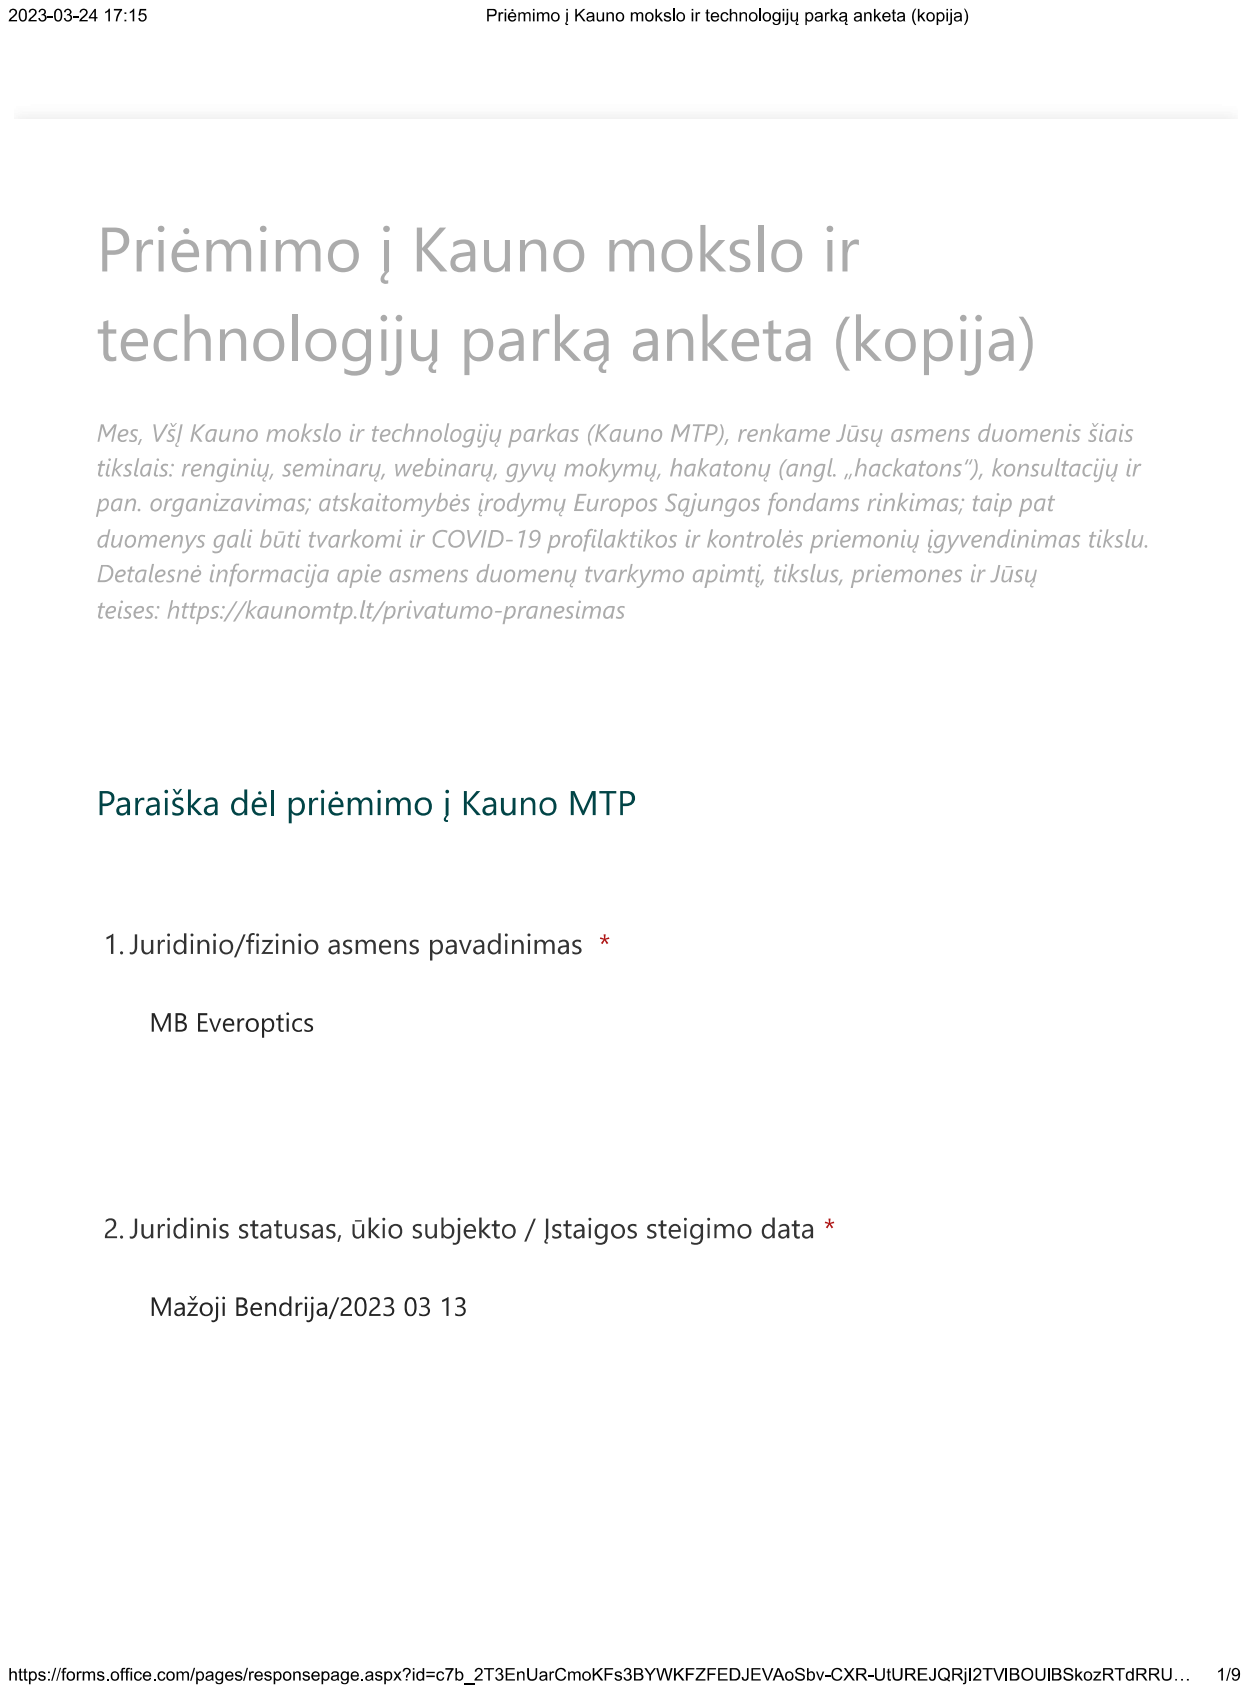
[picture p74: page 1]

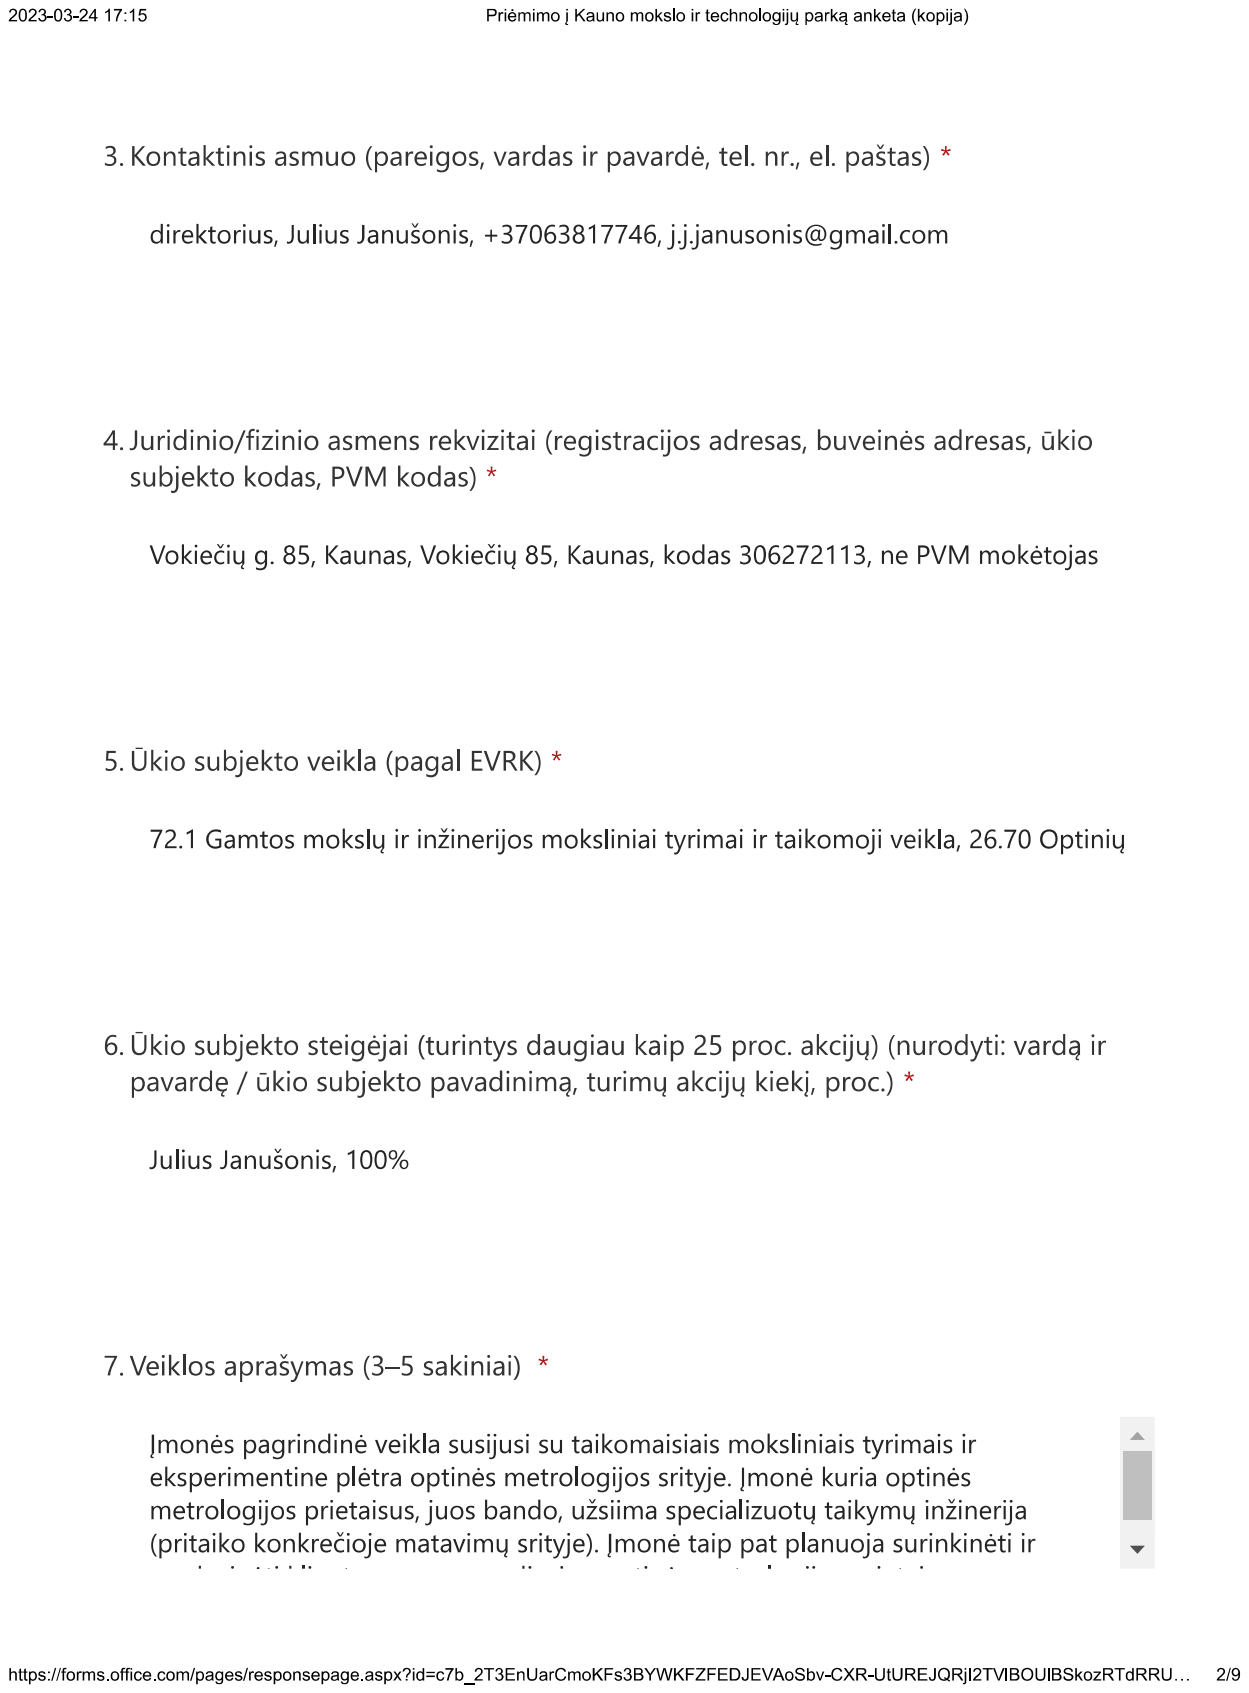
[picture p75: page 2]

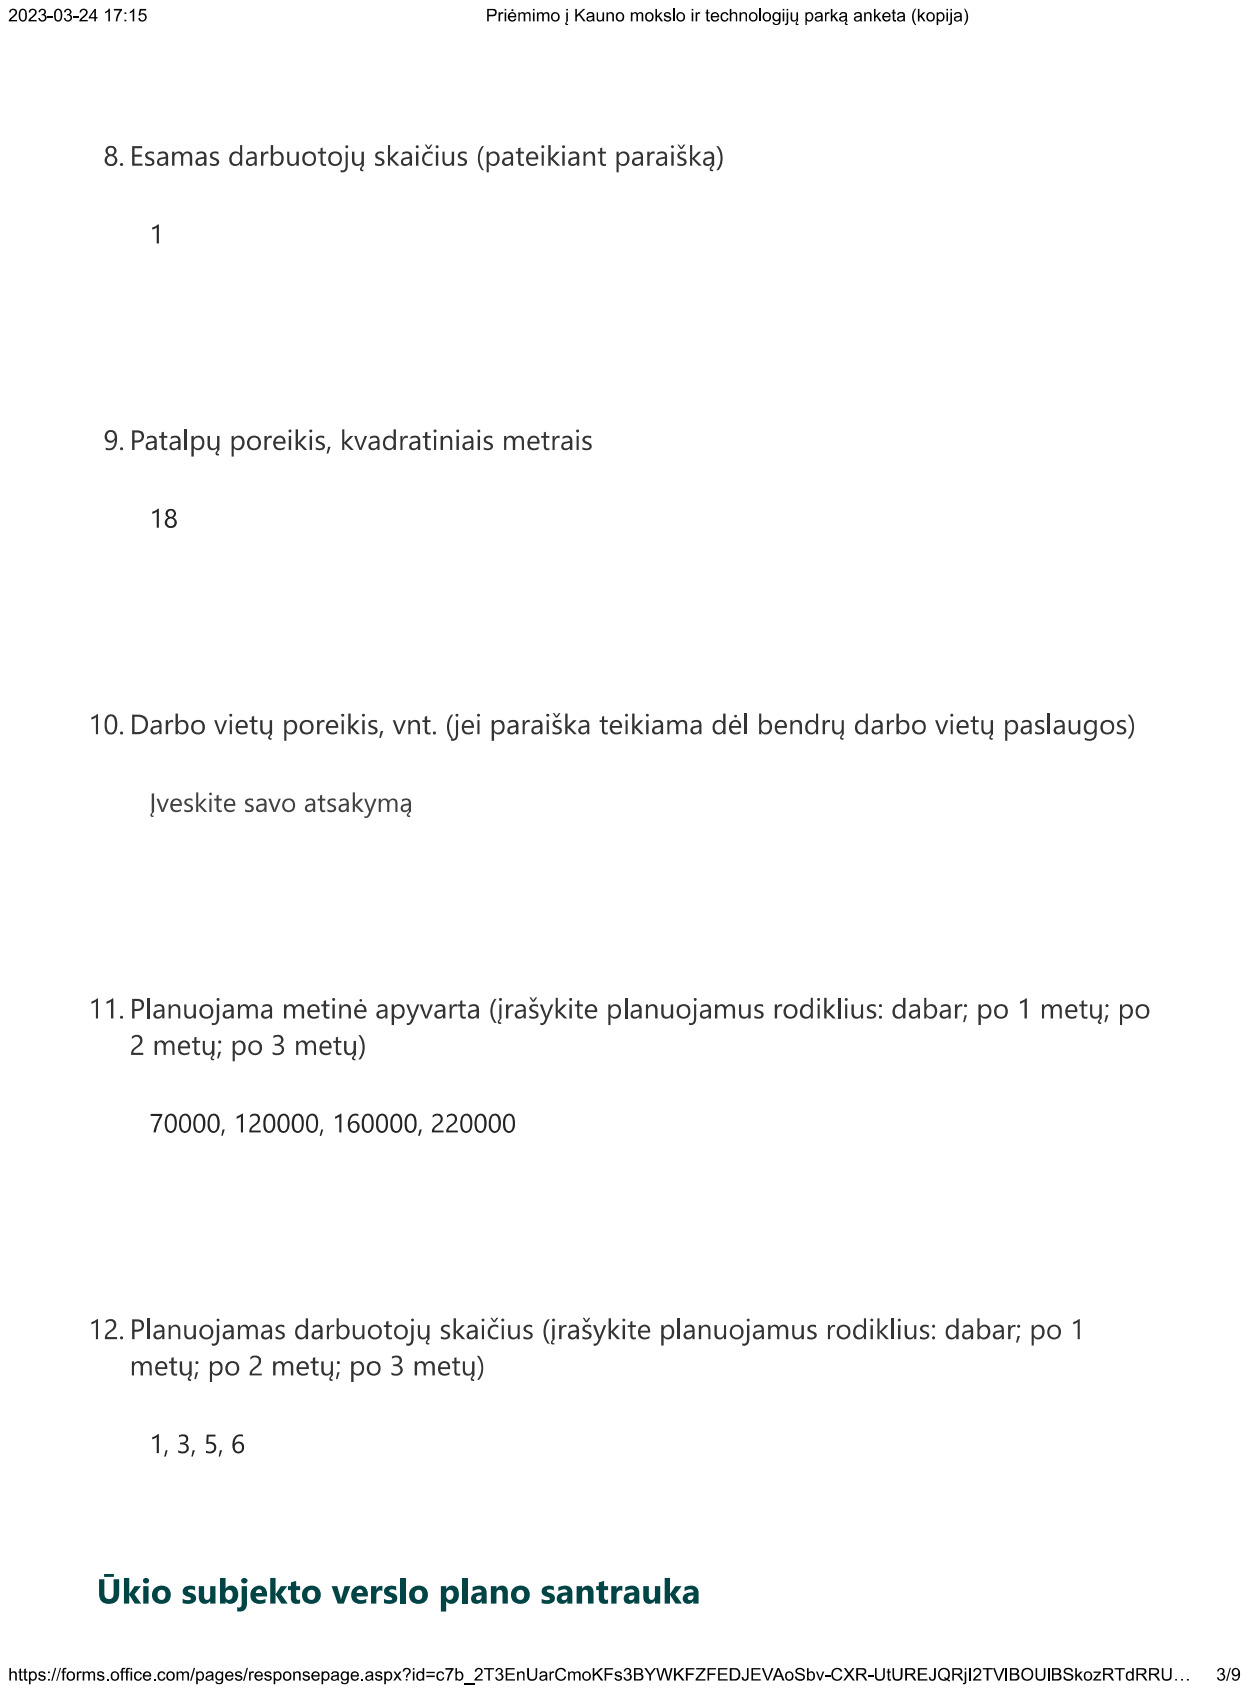
[picture p76: page 3]

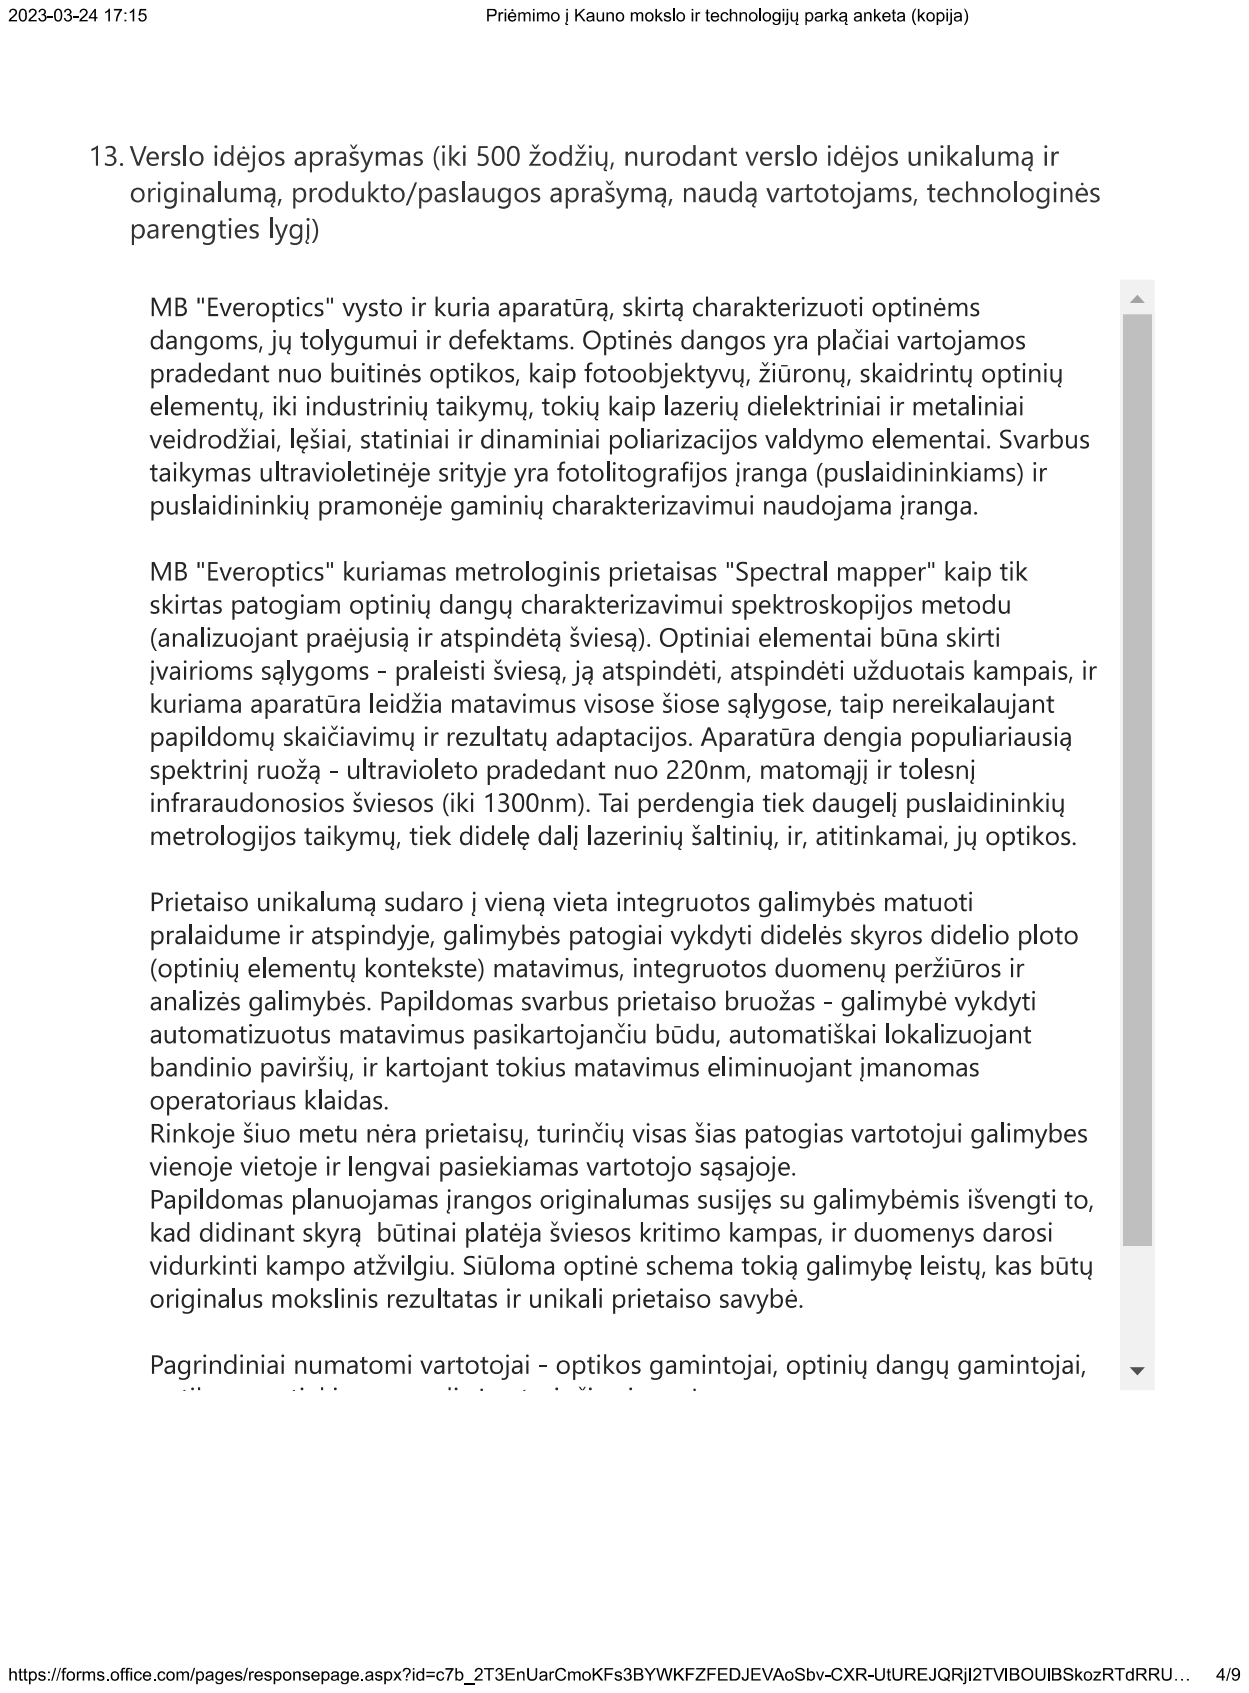
[picture p77: page 4]

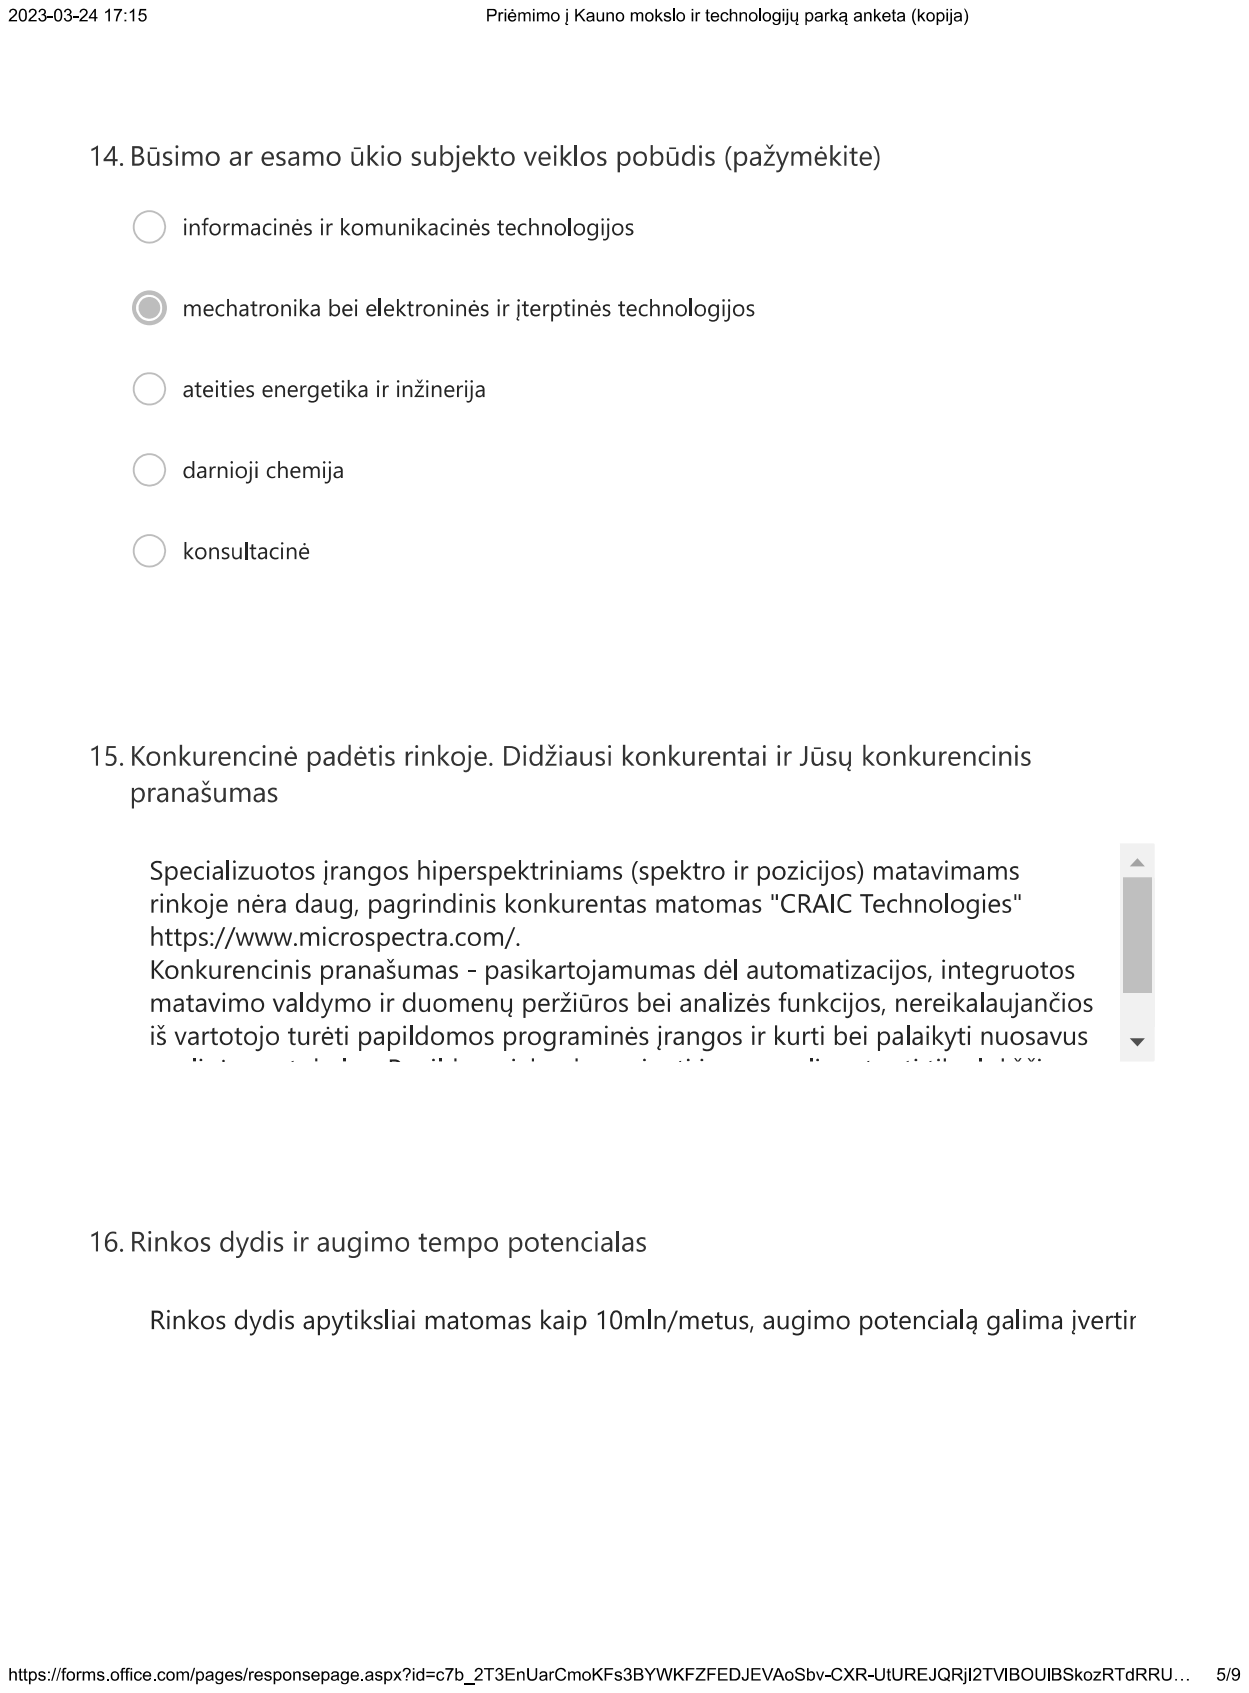
[picture p78: page 5]

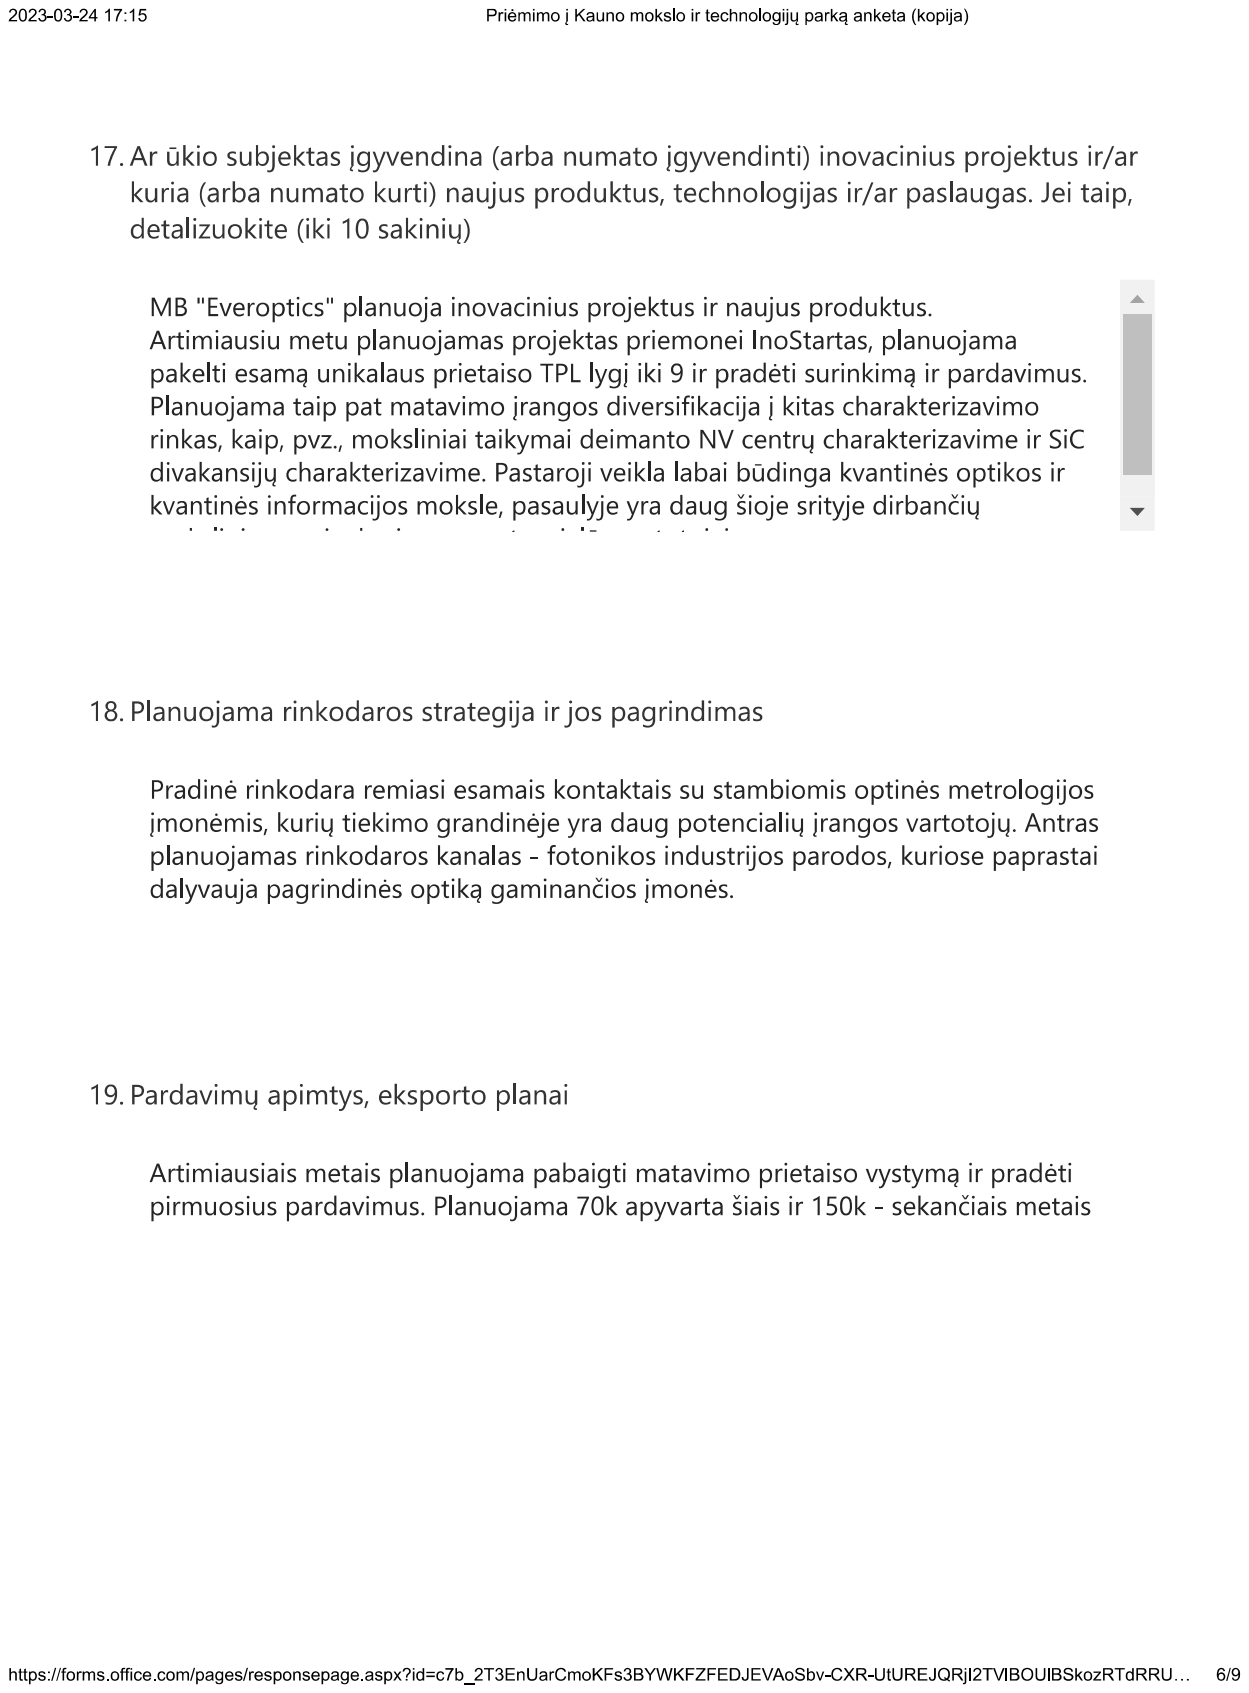
[picture p79: page 6]

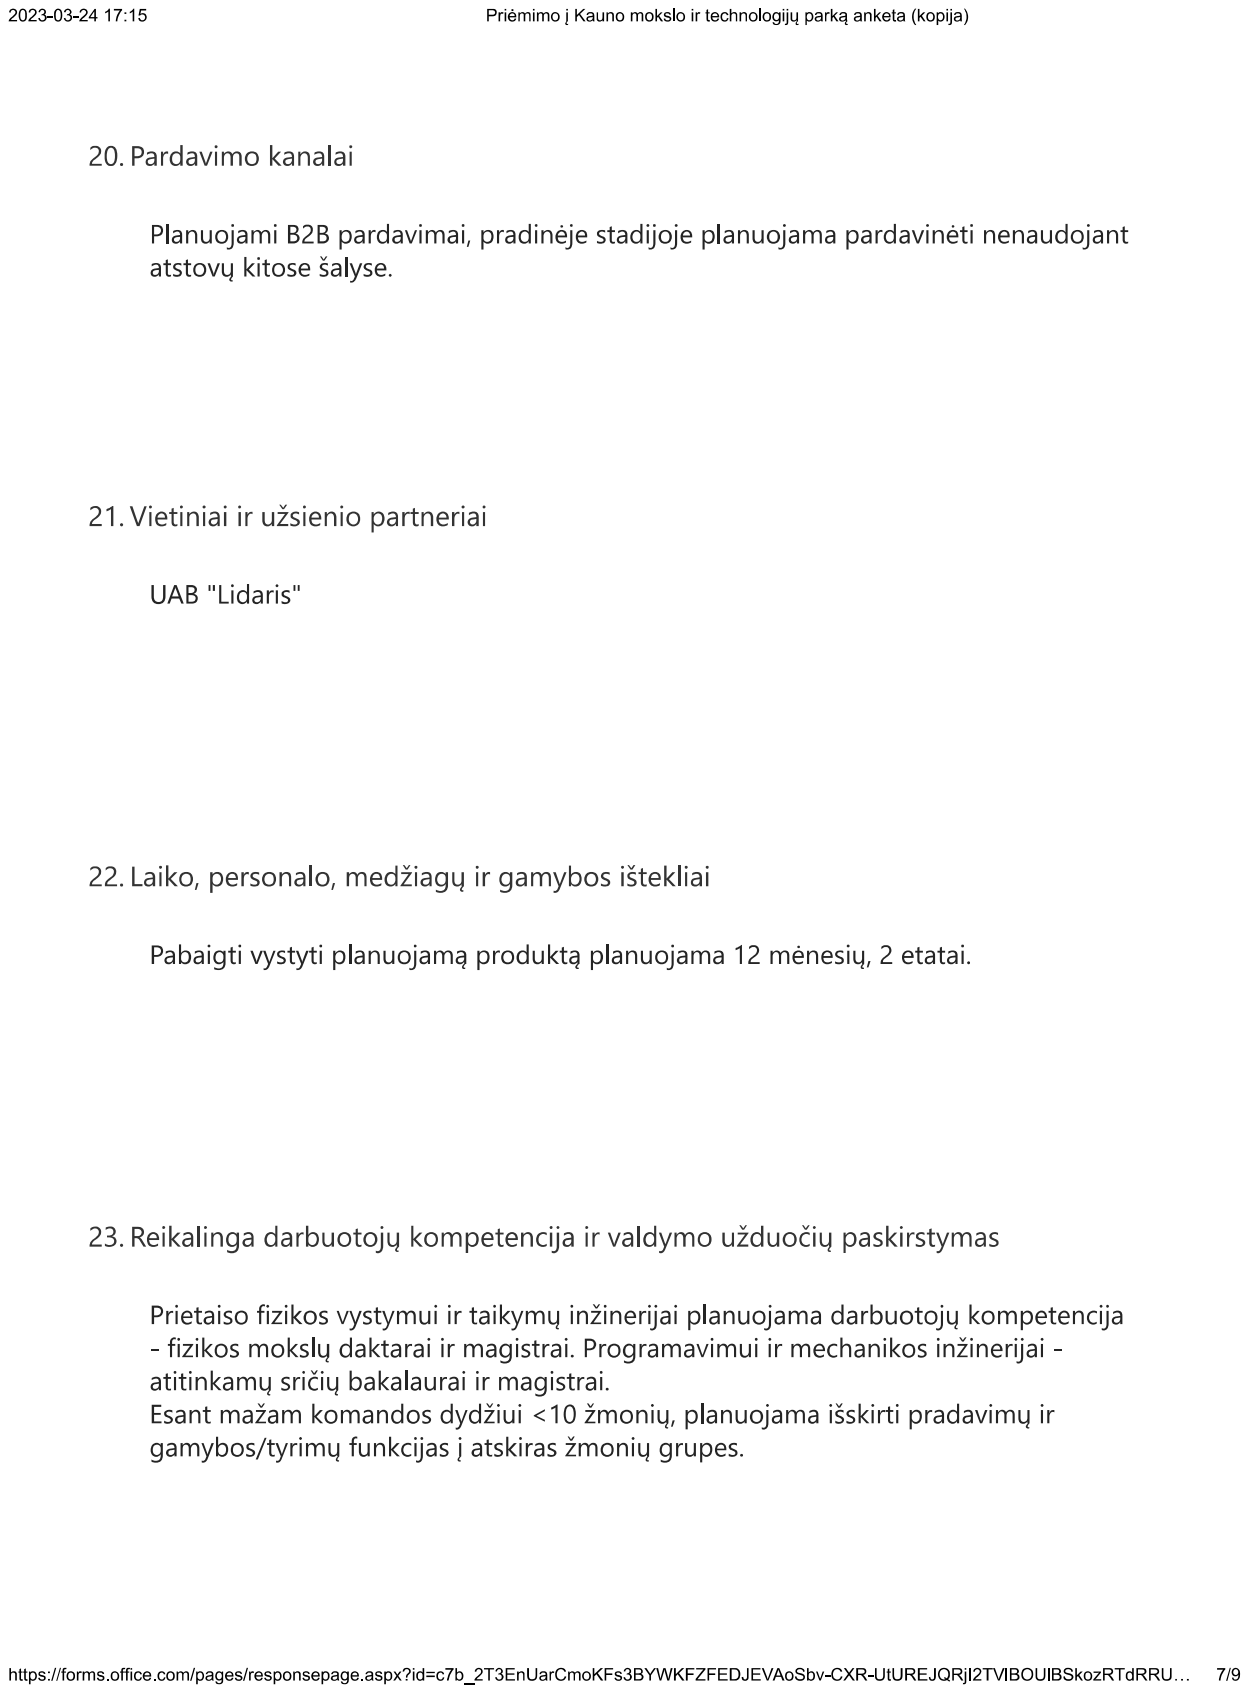
[picture p80: page 7]

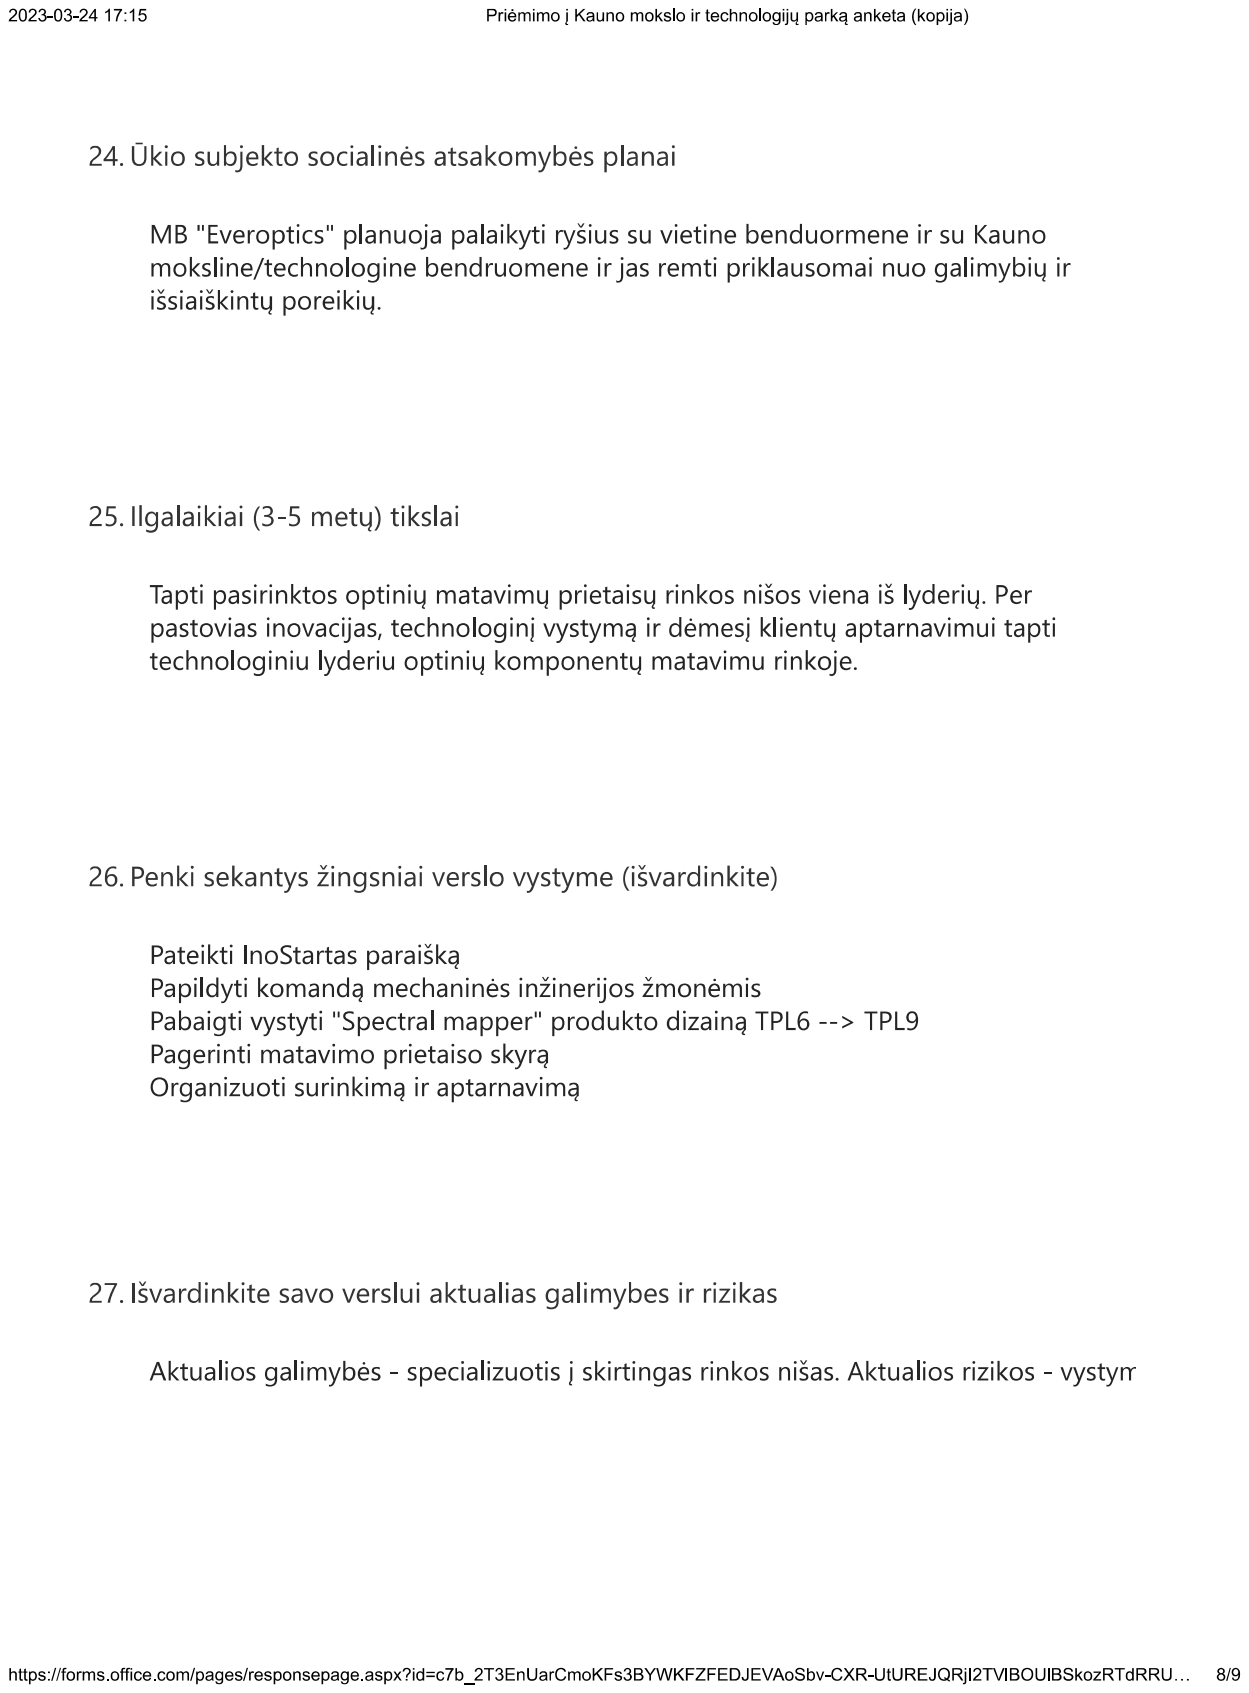
[picture p81: page 8]

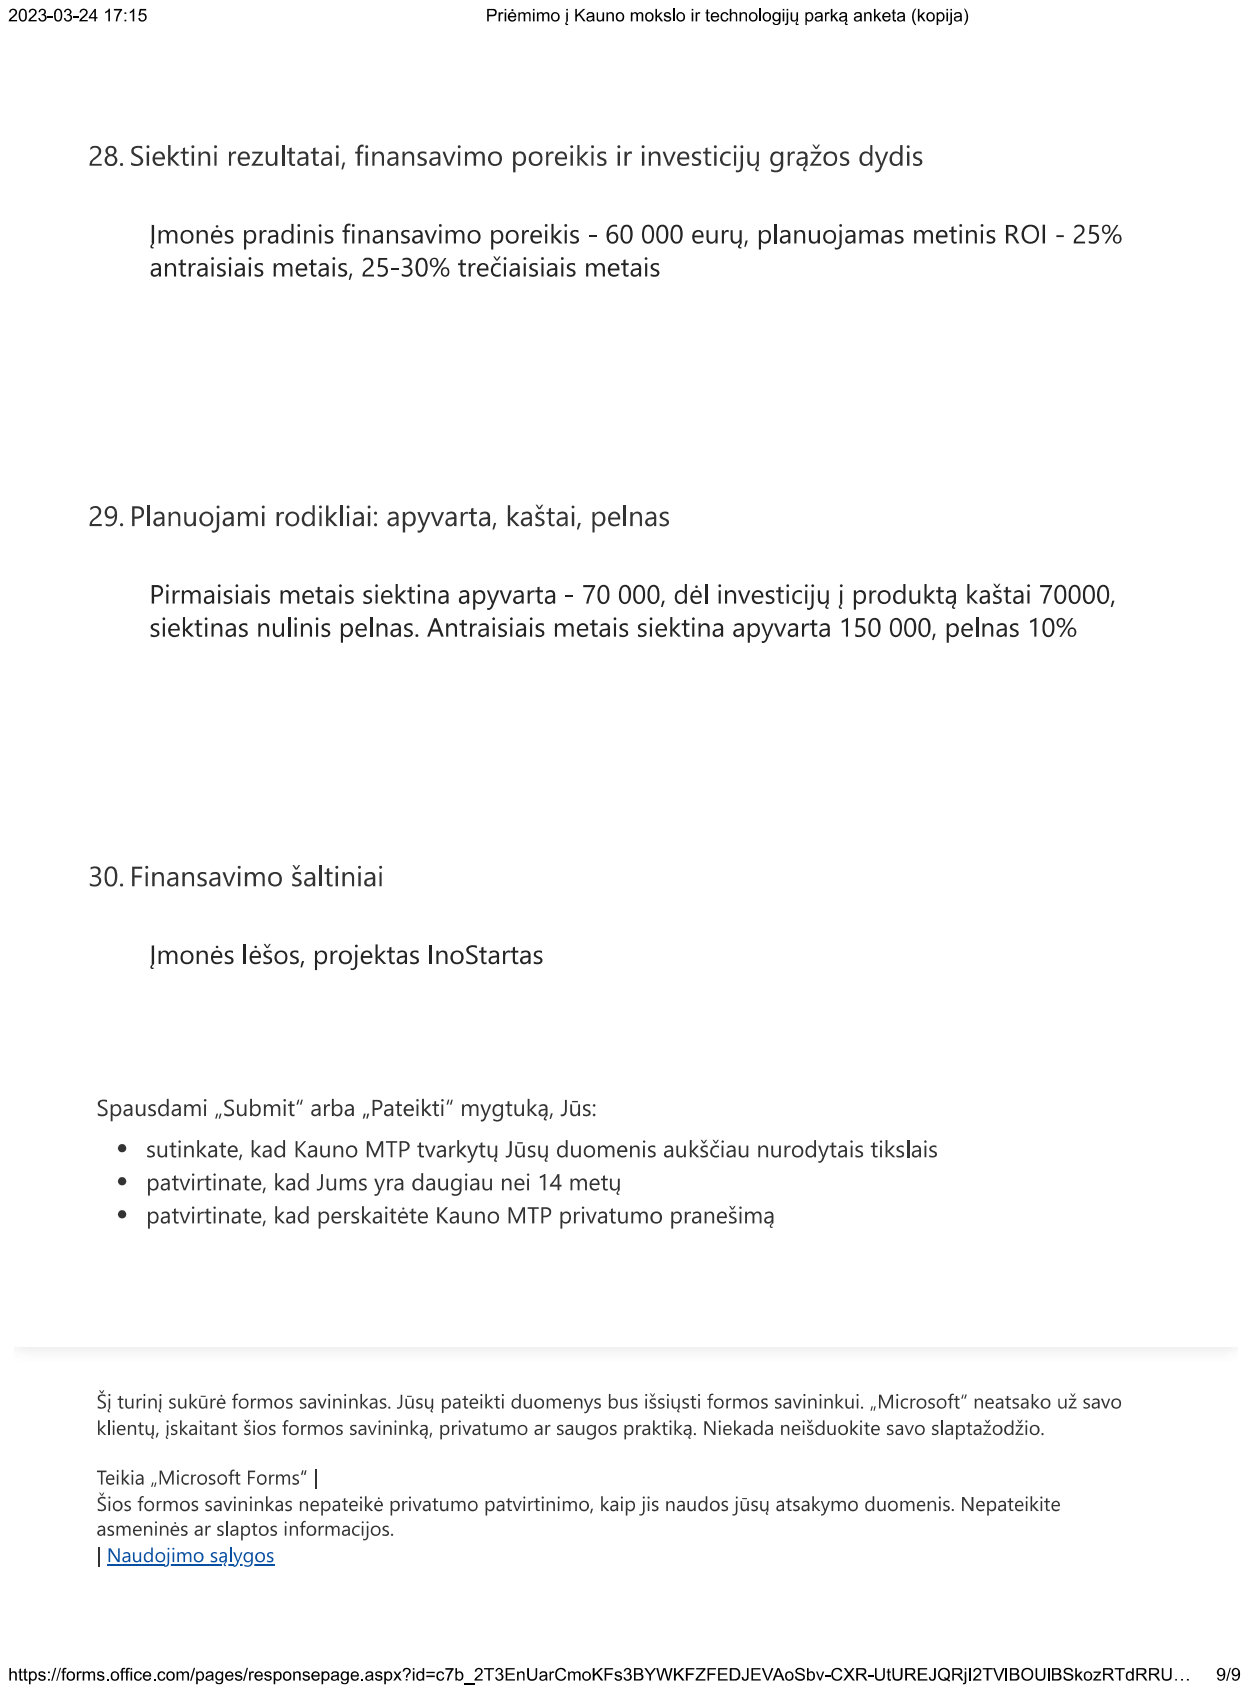
[picture p82: page 9]
