JuliusJanusonis/MB/Banko saskaitos atidarymas/anketa.pdf

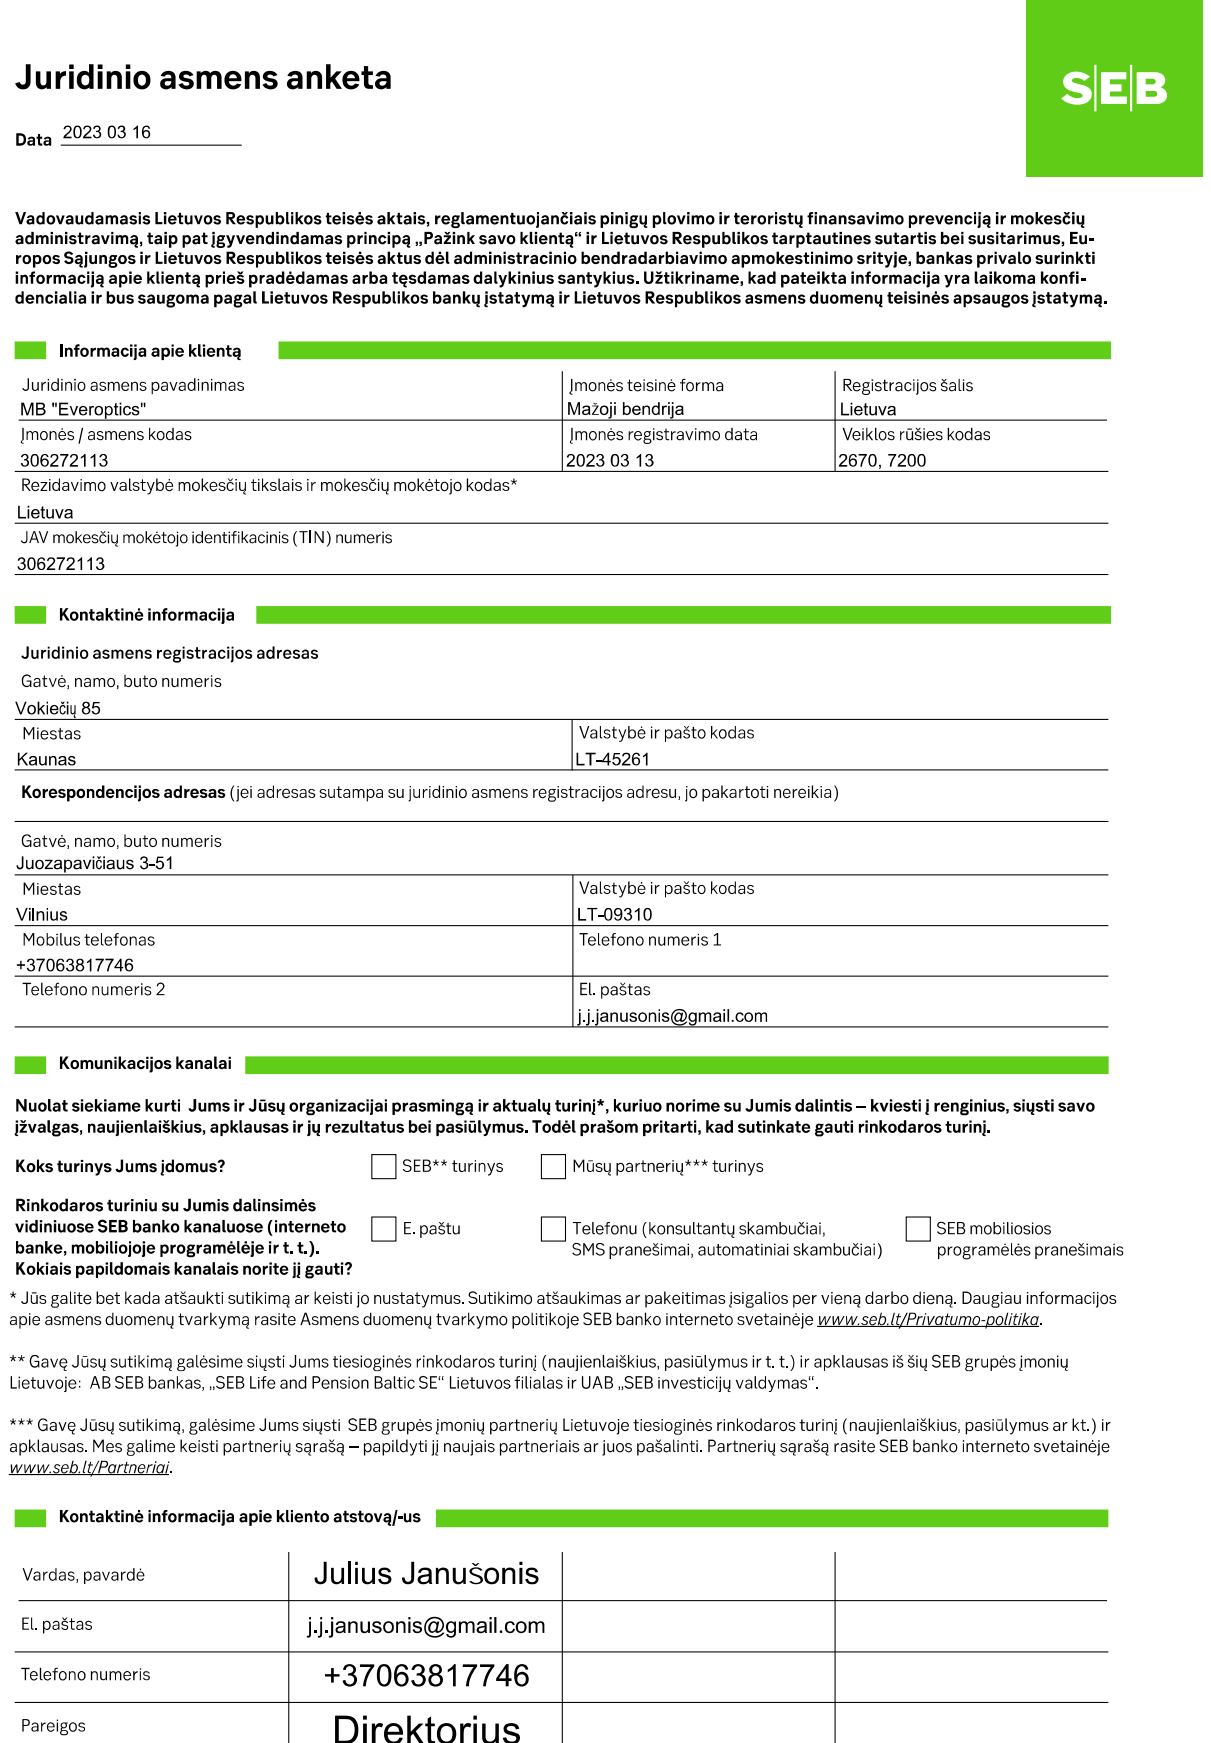
[picture p92: page 1]

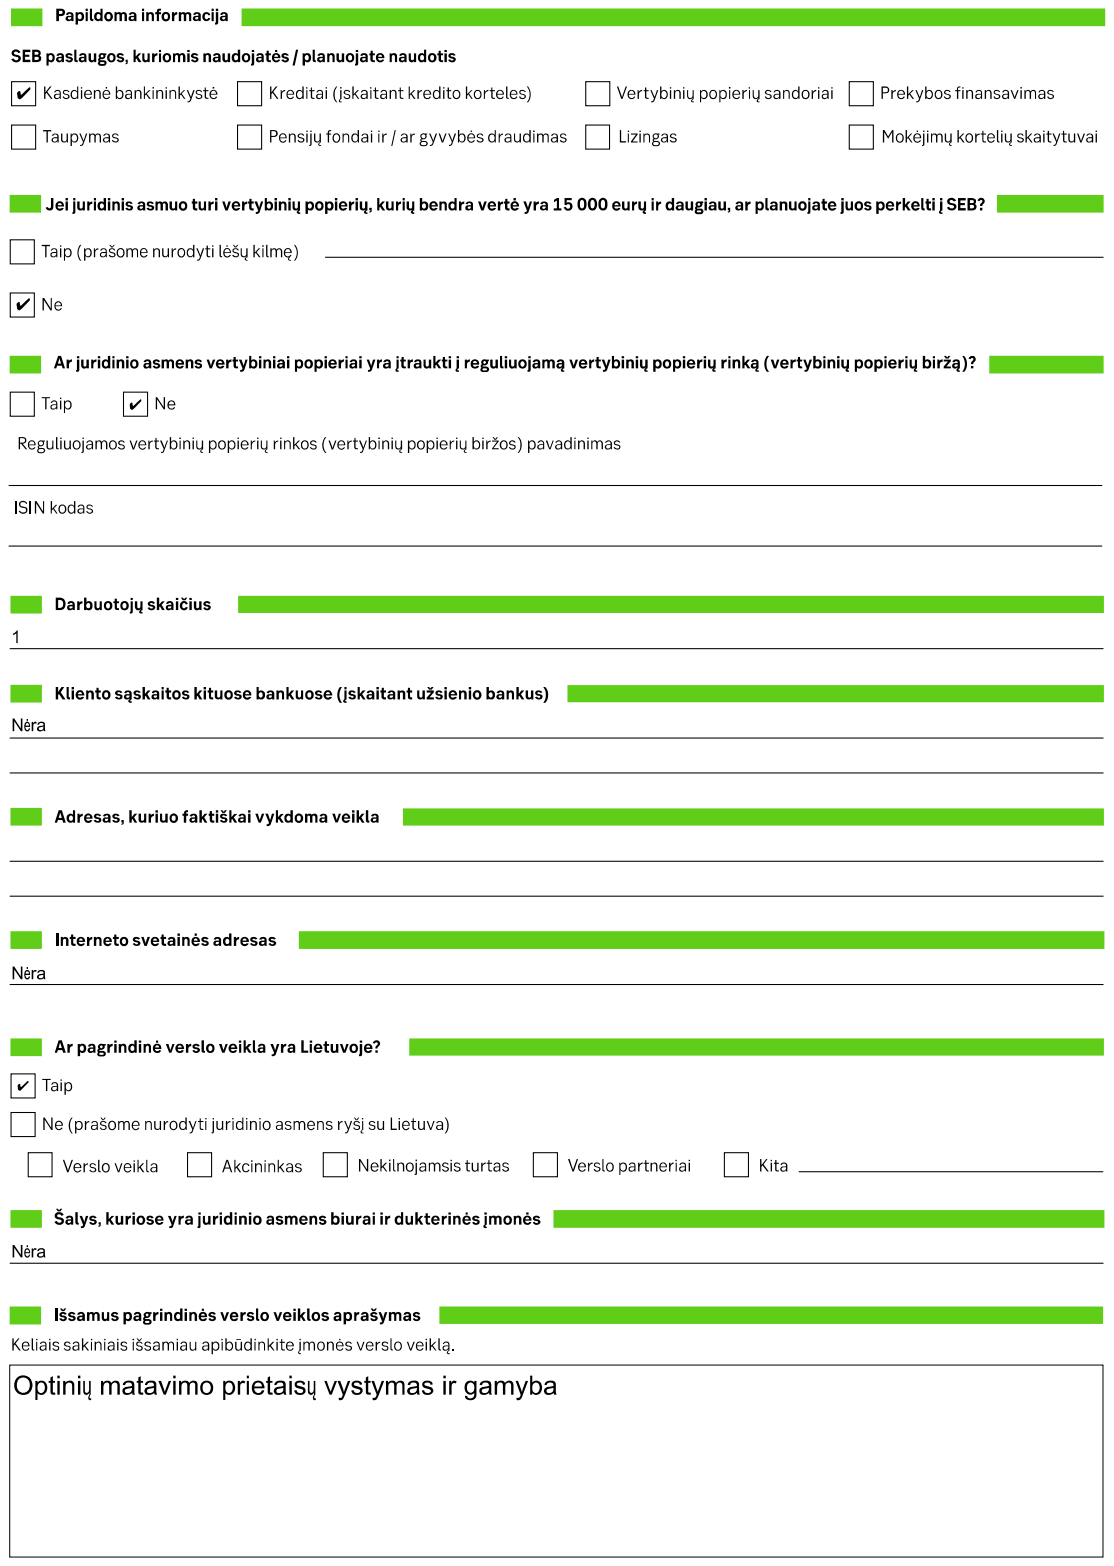
[picture p93: page 2]

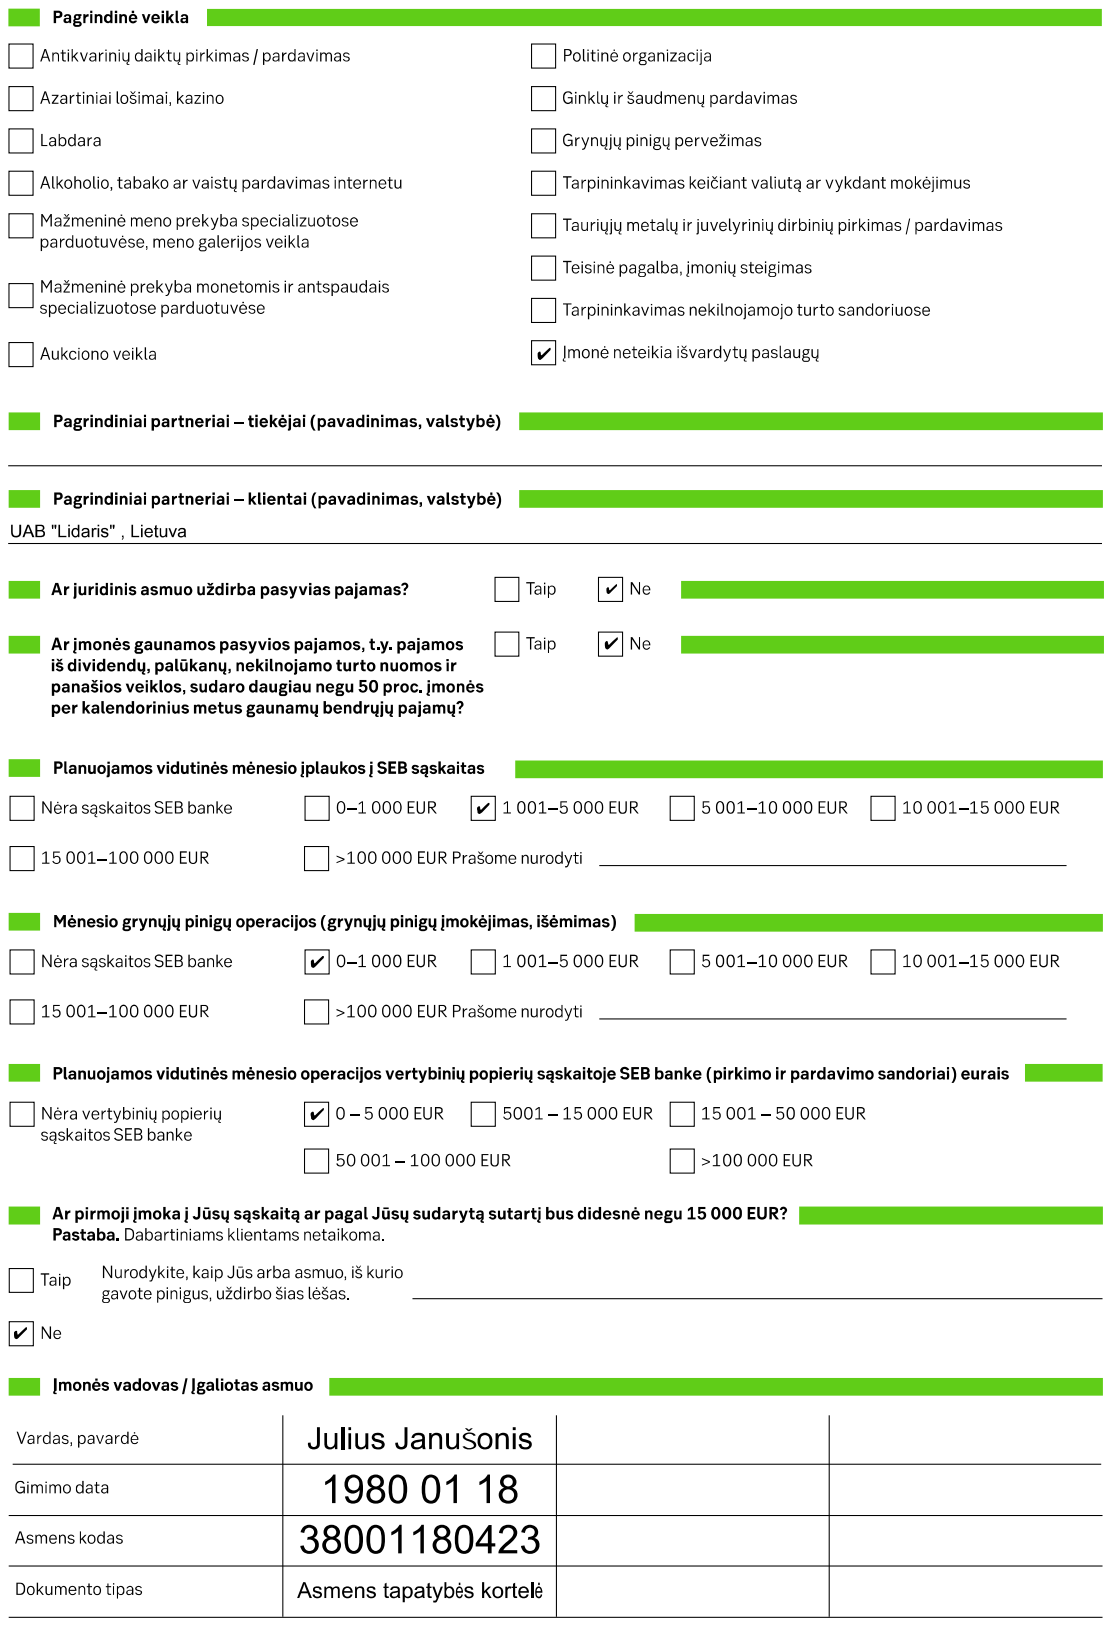
[picture p94: page 3]

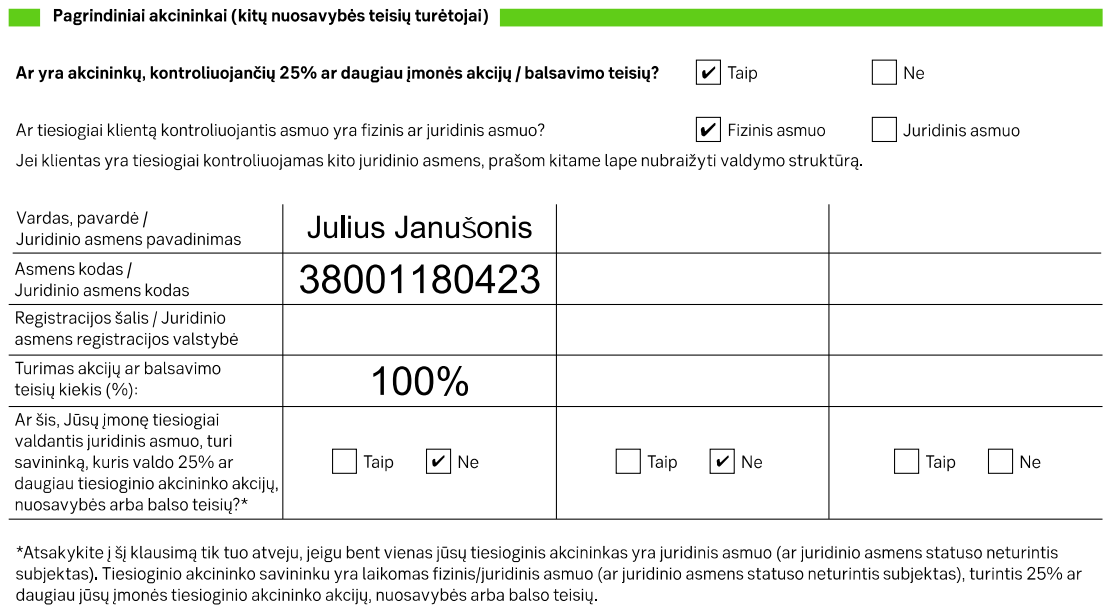
[picture p95: page 4]

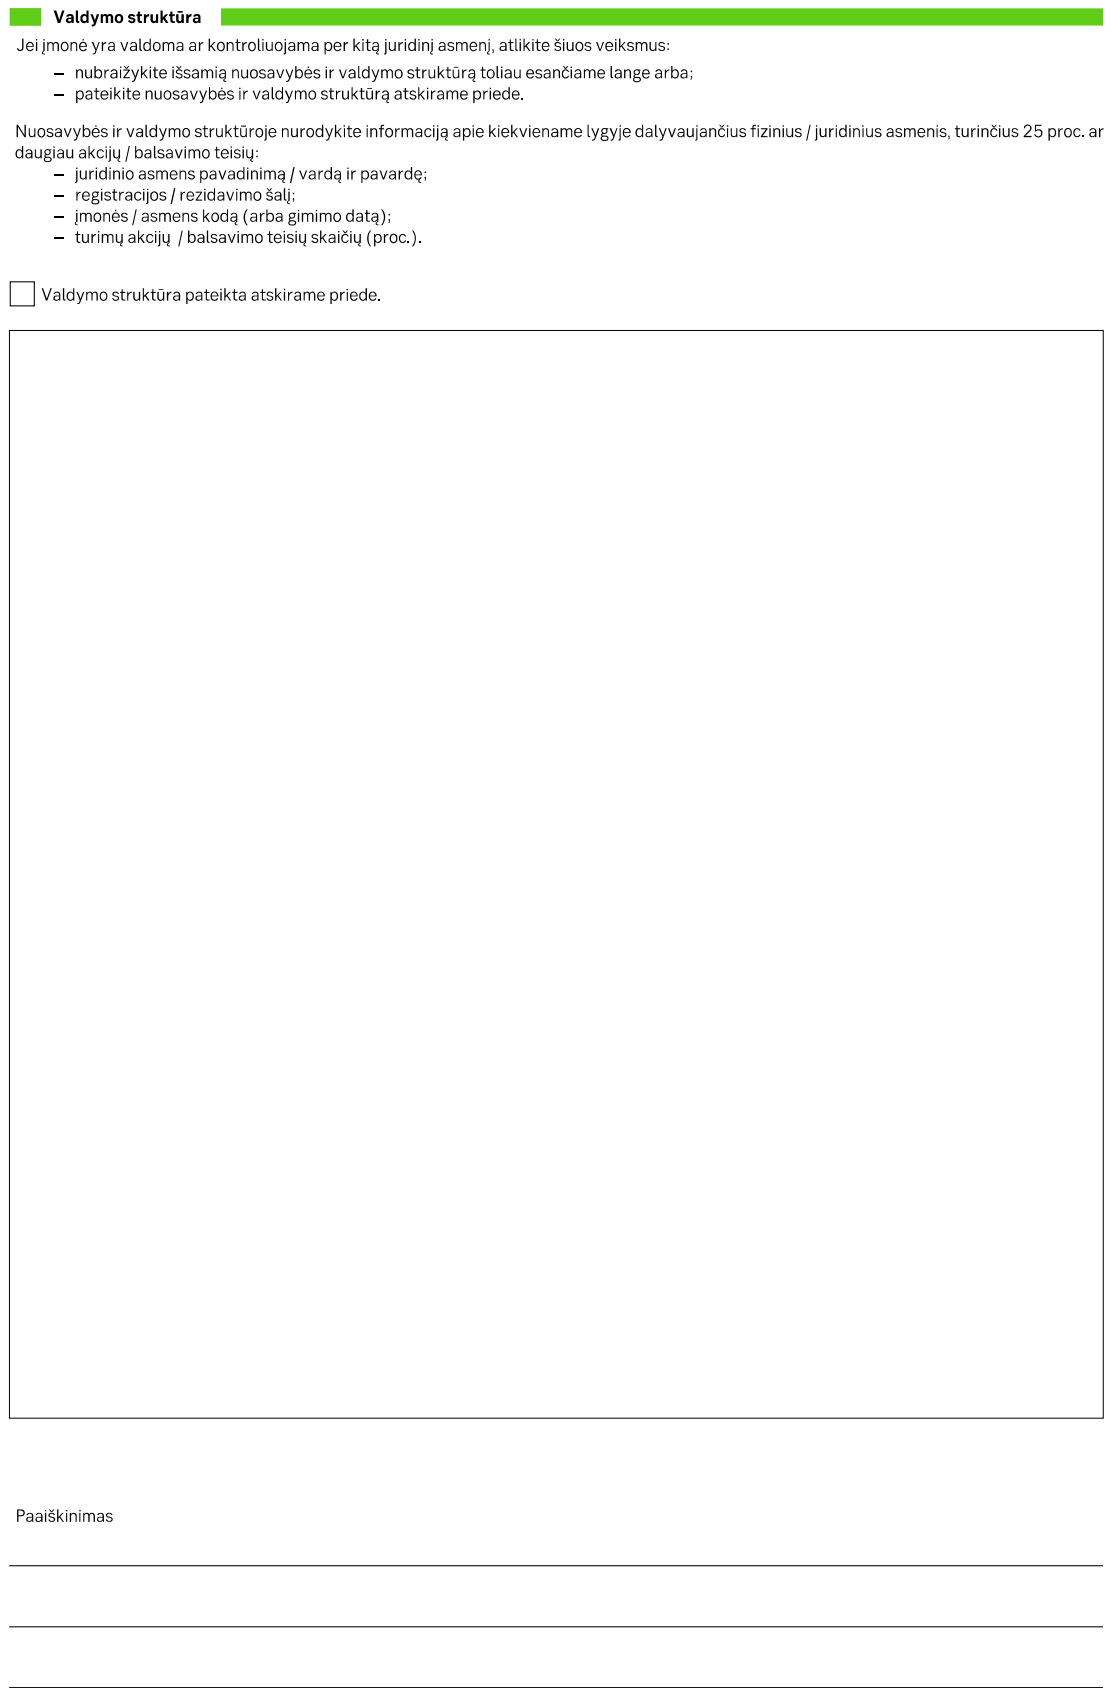
[picture p96: page 5]

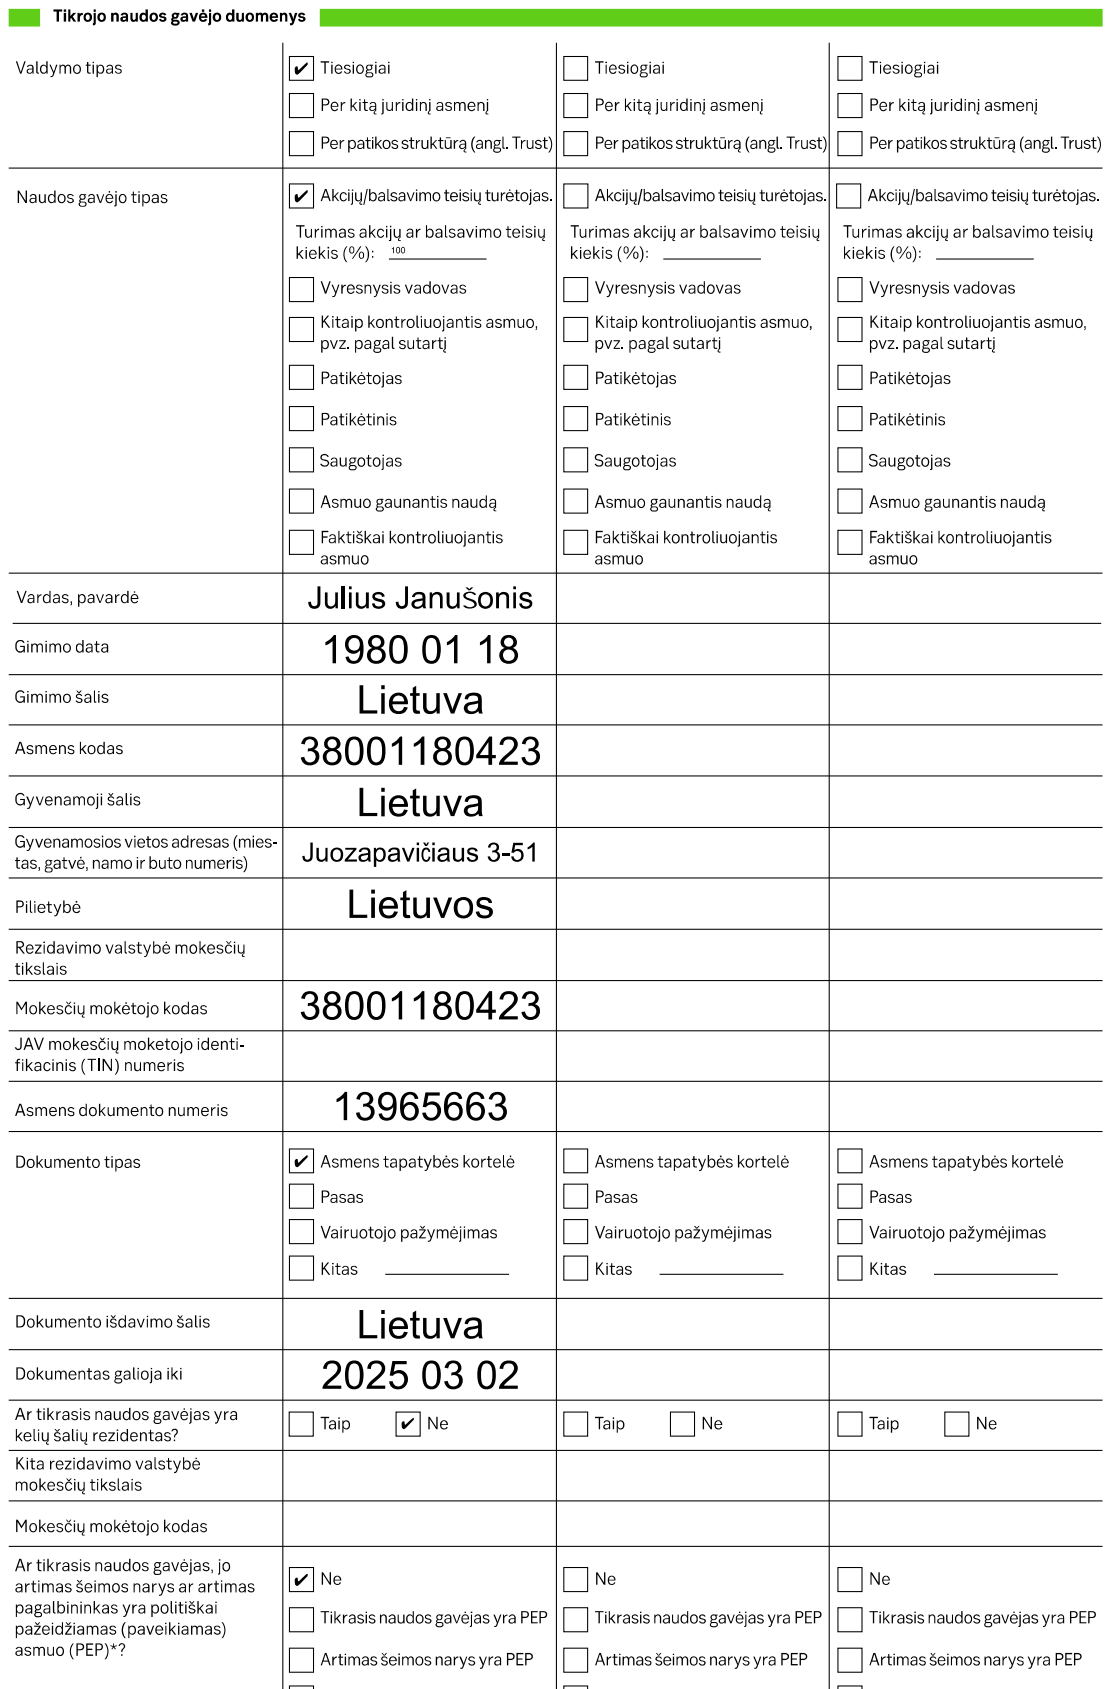
[picture p97: page 6]

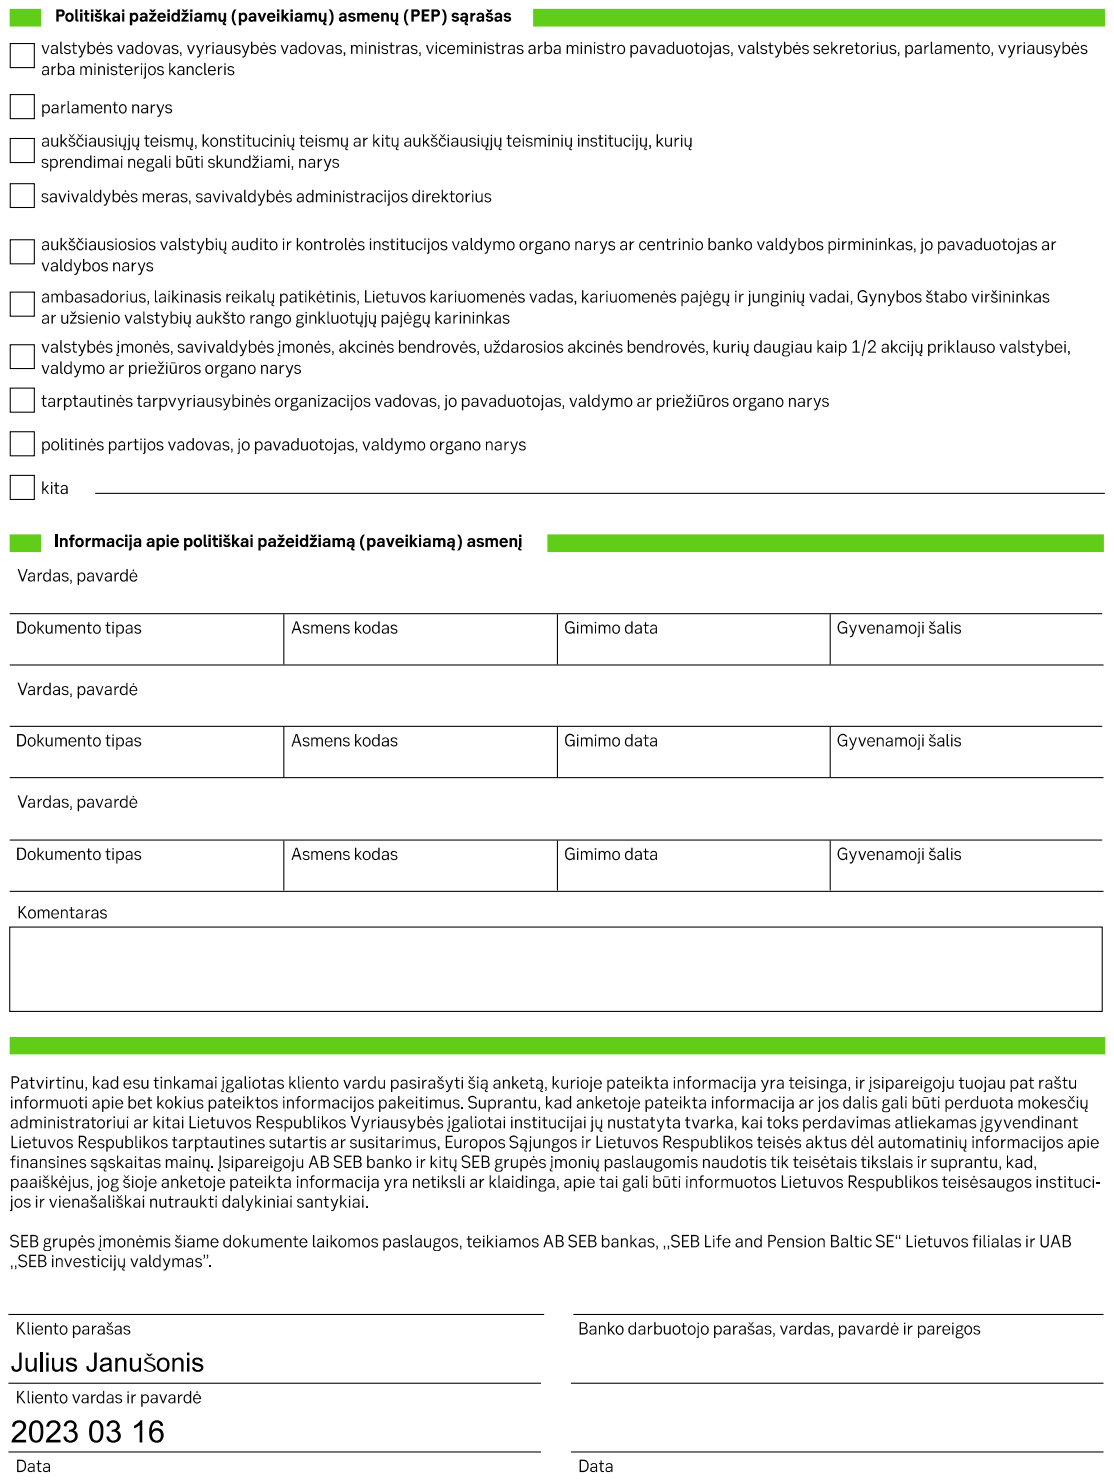
[picture p98: page 7]

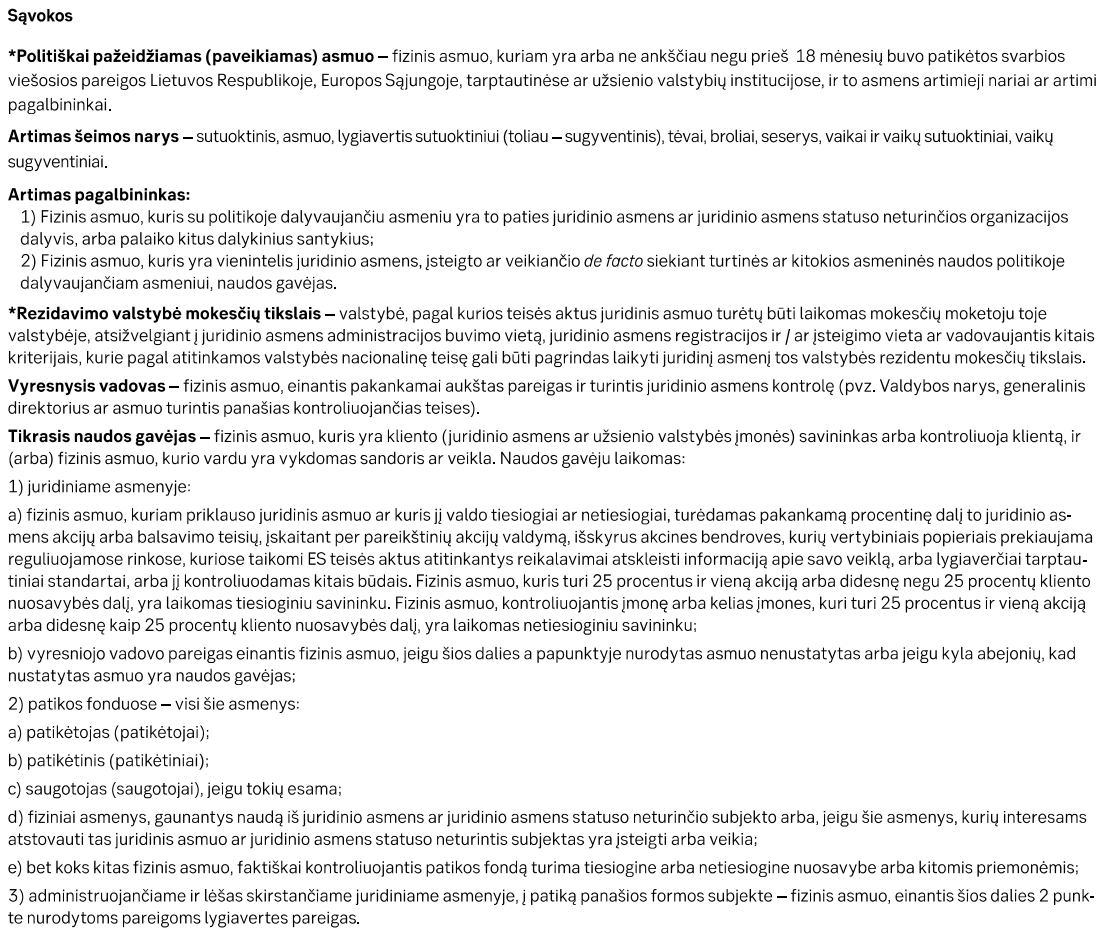
[picture p99: page 8]
