JuliusJanusonis/MB/Inostartas/Dokumentai projekto padavimui/Atnaujinti seni failai/2023 03 30 Pasiulymas UAB rm7 Nr. 202330_1.pdf

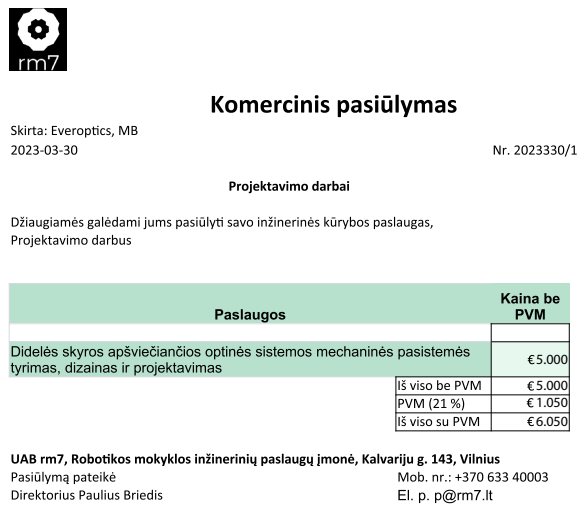
[picture p100: page 1]

5.000
1.050
6.050
